kehanzuishuai/fpga/release/latest/README.md

# 当前完整发布：V21 / 2026-11-03

请使用 [release/v21_20261103](../v21_20261103/README.md) 的三端配套文件。

- [FPGA 烧录压缩包，解压后使用 FS](../v21_20261103/FPGA_expression.fs.zip)
- [ESP32-S3 合并固件，地址 0x0](../v21_20261103/ESP32_autoplay_0x0.bin)
- [特雷门琴 UNO 源码](../../firmware/theremin/Open_Theremin_FPGA/)
