kehanzuishuai/fpga/README_HANDOFF.md

# 当前工程入口：V21 / 2026-11-03

完整说明见 [README.md](README.md)。

- FPGA：[yinyue_fashengqi.gprj](yinyue_fashengqi.gprj)
- ESP32：[完整 Arduino 草图](firmware/remote_music_ble/esp32/ESP32_FPGA_Music_Controller/)
- 特雷门琴：[UNO 工程与校准说明](firmware/theremin/README.md)
- 烧录文件和验证报告：[release/v21_20261103/](release/v21_20261103/)
- 构建与烧录：[BUILD_AND_PROGRAM.md](docs/BUILD_AND_PROGRAM.md)

此前交接记录保存在 [历史副本](docs/README_HANDOFF_BEFORE_V21_20261103.md)。
