kehanzuishuai/fpga/docs/REMOTE_MUSIC_20261019.md

# ESP32手机音乐与五音色集成

当前工程：`D:\gaoyun\piano_v2_audio_fix\yinyue_fashengqi.gprj`。
原始提供资料保存在 `ref/lanya_20261019`，工作副本在 `firmware/remote_music`；未修改 E 盘原文件。

## 已实现的功能

- 实体32键固定使用原来的32 Voice钢琴，不叠加其他乐器。手机连接ESP32 Wi-Fi热点，可为MIDI/JSON曲谱选择钢琴、长笛、吉他、管风琴、钟琴，修改音量，导入曲谱或播放WAV。网页界面保持此前版本不变。
- WAV原始文件经手机HTTP分块上传、ESP32 SPI转发，在FPGA中解析RIFF、解码PCM并输出双声道；支持PCM格式码1、16/24位、单/双声道、44.1/48kHz。44.1kHz在FPGA中线性转换至48kHz。支持未知块和奇数字节填充；格式、边界、CRC或断流错误会反馈并静音。MP3、浮点WAV、WAVE_EXTENSIBLE不在此次支持范围。
- WAV按原速度播放，保留录音原声；手机五音色选择仅用于MIDI/JSON音符重合成，BPM只影响MIDI/JSON曲谱。更改手机音色不会使按住的实体键变音色、淡出或重新触发。
- MIDI保留原网页解析方式：格式0/1、PPQN计时，选择单旋律音轨及分段；不支持把复调和弦当作单旋律谱直接导入。JSON保留原音符事件兼容，单段最多32事件。MIDI/JSON解析位置仍为手机；FPGA负责事件计时和合成。此次新增的WAV文件解码在FPGA完成。
- 默认32个不同音高：第一块MIDI60～75，第二块76～91。屏幕继续保留原第一块16键对应。32 Voice、FFT、HDMI、PT8211与PCM5102均保留。
- 
- 音色协议ID为0钢琴、1管风琴、2长笛、3吉他、4钟琴。钢琴保留原音源；新增模型分别为加法管风琴、简化长笛、Karplus–Strong吉他及FM钟琴。每种音色支持32个逻辑Voice。曲谱启停会淡出并清理音源/效果后交接；停止或自然结束后恢复钢琴，再触发仍按住的实体键。曲谱播放中更改音色会停止当前曲谱，新选择用于下次播放。手机状态中的音色ID表示曲谱选择，实体键始终为钢琴。
- UART负责控制与原有曲谱事件，SPI负责WAV。CRC验证后才写入音频FIFO；序号及重复包缓存避免重传导致重复播放。FIFO反压与HTTP队列支持边传边播，无需把整首音乐存入FPGA。
- 曲谱开始需松开琴键且音源空闲；松键尾音尚未结束时请稍候。播放期间暂时由曲谱独占音符事件，停止后恢复实体键。WAV为独立立体声音源，可与琴键合成声混合；主音量同时作用于两者。多音/混音可能触发最终饱和保护，不代表恒定响度或无削波。

## 接线

使用Pro Dock排针编号，信号电平3.3V，两端共地。以下接口避开两块琴键及双DAC、HDMI现有占用。

| ESP32-S3 GPIO | 方向 | FPGA信号/管脚 | Dock位置 |
|---|---|---|---|
| 17 TX | ESP→FPGA | esp_uart_rx / B21 | J26第12脚 |
| 18 RX | FPGA→ESP | esp_uart_tx / A20 | J26第10脚 |
| 12 SCK | ESP→FPGA | esp_spi_sck / L17 | J24第7脚 |
| 11 MOSI | ESP→FPGA | esp_spi_mosi / E25 | J24第9脚 |
| 10 CS | ESP→FPGA | esp_spi_cs_n / H14 | J24第5脚 |
| 13 MISO | FPGA→ESP | esp_spi_miso / D25 | J24第10脚 |
| GND | 共地 | GND | J24/J26第3或4脚 |

原琴键接线保持：第一块SCL=C21/J26第11脚，SDO=B20/J26第9脚；第二块SCL=B19/J26第7脚，SDO=A17/J26第5脚。提供资料中原UART所用B19/A17已被第二块琴键占用，此次已避开。

Dock Bank4/5供电默认3.3V，来源为 `ref/hardware/Pro_Dock_4071f_official.pdf` 第16页PMOD引脚及第19页供电图。ESP32可由其USB供电，必须共地；不要将5V接入FPGA信号脚。SPI使用Mode0、4MHz，建议短线。

## 打开、编译与使用

1. Gowin Designer打开根目录 `yinyue_fashengqi.gprj`，新增RTL已列入有效FileList。顶层仍是`tang_mega_138k_pro_top`。
2. ESP32源文件为 `firmware/remote_music/esp32/ESP32_FPGA_Music_Controller/ESP32_FPGA_Music_Controller.ino`。本工程隔离安装的Arduino CLI与Espressif core在 `tools/toolchains/arduino`，使用官方core 3.3.10-cn。
3. `firmware/remote_music/esp32/compile.py`只编译，目标为通用`esp32:esp32:esp32s3`。本轮默认4MB分区构建，PSRAM选项未启用；手动烧录前按实际ESP32-S3板的Flash/PSRAM型号选择参数与串口。没有绑定原资料的COM9。
4. 手机连接热点`FPGA_MUSIC`，密码`fpga2026`，浏览器访问`http://192.168.4.1`。网页已嵌入固件，无需外部网页服务器。
5. “曲谱”页选择WAV后点击“传输并播放”，保持页面前台及Wi-Fi连接。完成状态来自FPGA已输出帧数，而非仅以HTTP上传完成判断。先用16位/48kHz文件做上板通路验收，再测试24位立体声和较长文件的持续传输。
6. 手机“键位”页可读取并原子提交32个唯一音高。物理触摸模块位序仍应按实际从左到右逐键确认；默认逻辑键顺序不等同于已经验证实体布局。

手动通路测试文件：`tests/remote_music_20261019/hardware_test/stereo_channel_check_16bit_48k.wav`。复制到手机后选择播放：第1秒仅左声道440Hz，第2秒仅右声道660Hz，第3秒两声道同时发声，第4秒静音；峰值约满量程20%。它是传输/接线测试音，不是五音色音质证明。

WAV本身不占用合成Voice，所以仅播放WAV时VOICE为0正常。音频Peak取左右声道较大的绝对值；FFT/李萨如的单声道音频源使用左右平均值，完全反相的立体声可能相消。

FPGA输出仍在 `impl/pnr/ao_0.fs`。最终可用版本必须以 `audit/remote_music_20261019/BUILD.json` 的PASS、当前源文件哈希和产物新鲜度为准；失败运行不会使旧FS自动变成新版本。

## 验证范围与资源处理

功能仿真包含真实SPI字节、CRC/序号重试、异常WAV/断流/停止、44.1kHz转换、实际固件C++发包重放、跨时钟立体声邮箱及双DAC数据核对。控制仿真覆盖真实UART、五种曲谱音色、全部手机选择下实体32键仅触发钢琴、曲谱最后NoteOff及交接、音量、效果、MIDI/JSON曲谱启停及重复键位拒绝。

WAV已逐样本覆盖16/24位、单/双声道、44.1/48kHz的全部八种组合，包括24位单声道的3字节帧整数校验及小文件结束处理。

ESP32上传端使用WebServer的定长RAW回调接收二进制，避免该core中`arg("plain")`按C字符串截断零字节。RAW路径不解析URL参数，因此会话/偏移使用`X-WAV-Session`与`X-WAV-Offset`请求头。对实际`WavService`代码的本机回归覆盖8KB含零字节/全部字节值的完整接收、队列反压重试、改变数据的重复请求、截断、取消、超长块和错误会话；HTTP回调及FreeRTOS队列边界在测试中模拟，真实射频/Wi-Fi仍需上板验证。

此前完成的32键整机回归覆盖12种场景、44个Note On/40个Note Off、最大32 Voice同时活动、9458个PCM5102帧、PT8211数据核对、4次FFT及12,338,132个HDMI像素。这些是此前完整运行的证据；本轮按用户要求停止重复整帧显示回归，不将中途停止的日志标记为新的整机通过。未改动显示部分按源码哈希复用此前结果，XY峰值流水改动单独核对10张位图和消隐预算。

新增四音色独立32 Voice回归已检查每个Voice的活动/释放和调度无超时。实际Gowin原语网表测试选取一个完整8路Voice共享运算通道，每种音色核对512帧，并逐周期比较控制、PCM和状态，覆盖DSP符号与吉他RAM行为；四通道组成的32 Voice整合由针对性RTL回归及主工程综合检查覆盖。最终通过状态以结果报告为准。已完成且依赖未变化的验证不再重复；SPI状态CRC流水改动仅补做相关传输验证。

为容纳吉他延迟RAM及WAV缓冲，GAO保留、采样深度由4096降为1024；没有删除FFT、HDMI、DAC或减少Voice。固定倍频改为精确移位加法，避免高云为常数倍频分配大量宽DSP后溢出到逻辑。

音符频率/吉他调谐/钟琴倍频参数显式在32个Voice之前计算一次，各Voice仅在Note On捕获。新增音色使用四个共享运算器，每个轮询8路独立Voice状态；32路相位、包络和吉他延迟RAM仍保留。每路最坏96个时钟完成一帧运算，低于256时钟采样周期，帧输出延迟不变。吉他样本在帧开始时锁存，保持原滤波/直流抑制的采样顺序。运算内部周期不再与原架构逐周期相同，已完成的帧级逐样本等价检查保留原始日志及哈希。

Icarus仿真会把共享总线上不重叠的切片改写为独立的等宽连线，避免超宽多驱动总线的解析开销；算术、寄存器、状态和时钟均不改动。`tests/remote_music_20261019/out/BANK_SIM_VIEW.json`记录原文件、仿真视图哈希及四处字面替换，最终归档前会重新逐项核对。GPRJ及Gowin使用原始生产RTL，门级测试使用真实Gowin综合原语。

新增音色的正弦ROM使用四分之一波表及精确符号/镜像还原，与原256个样本逐值相同，没有改变舍入或增加延迟。支持范围MIDI36～96的最大相位增量乘8仍低于Nyquist，因此移除该范围内永不触发的重复混叠判断；公共独立音色配置模块仍保留通用保护。Voice轮换选择采用静态优先扫描，保持原分配顺序。

32键映射在提交时扫描32个时钟并使用音高集合检查重复，替代496组并行比较；期间不接收下一请求，活动映射一次性更新。重复请求返回缓存结果；校验或演奏忙碌时保留原映射。

WAV块长度不再用单周期32位除法校验，改为32个50MHz周期的精确整数商/余数计算，期间对字节FIFO反压，音频采样运算不增加流水延迟。独立实际布局布线中，该修复将原Setup裕量−6.069ns改善为+4.038ns；这组数字仅属于独立解码模块，整机必须以最终报告为准。

SPI流模块亦做过独立50MHz布局布线检查，其状态CRC路径最差Setup为+4.230ns、Hold为+0.236ns，报告位于`tests/remote_music_20261019/resource/spi_timing/impl/pnr/probe.tr`。该探针自动分配IO，仅用于内部路径检查，不能作为整机镜像或板级SPI时序验收。

SDC保留原视频时钟、复位相位和0.150ns像素Hold要求；新增50MHz与音频时钟的异步分组，对应显式同步器和稳定数据请求/确认邮箱。像素与串行视频时钟仍按同步关系检查。最终综合资源、五类时序裕量、管脚比对与FS哈希见同目录最终验证结果文档及`audit/remote_music_20261019/FINAL_ACCEPTANCE.json`。

这些结果证明数字功能与工具实现的相应检查通过，不构成真实Wi-Fi连续性、实体接线和主观乐器音质验收。尚未连接设备做录音比较或实际烧录；新增模型也没有被宣称为高保真原声乐器。
