kehanzuishuai/fpga/scores/卡农_最新ESP32_20261103/使用说明.txt

《卡农》多音轨 ESP32 适配版（2026年11月3日）

直接导入的文件：卡农_多音轨_20261103.mid
适用固件：v21-autoplay-confirm-20261103，配套已有 V21 FPGA。

曲谱内容
7个有声部的音轨，另有1个速度/节拍信息轨。
包含低音、主副旋律、中音对位和分解和弦；保留全部3618个原始音符。
速度87 BPM，时长约5分14秒；音域MIDI 38～88。
最新页面合并后为4286个起音/松音事件，最多11个不同音高同时发声。
文件30,489字节，满足手机导入64KB及设备整曲事件数量限制。

手机操作
1. 连接ESP32，打开手机控制页面。
2. 选择“琴键”或“合奏”声源，选择“自动演奏”；建议先用“钢琴”音色。
3. 在“曲谱”页导入本文件夹的 .mid 文件。
4. 音轨选择“全部旋律音轨（不含打击乐）”，使用“整曲连续播放”。
5. 点击“传入设备”，看到“整曲已缓存，点击播放”后再点击“播放”。
6. 导入会设置87 BPM；可通过速度滑条调整。设备重启后需要重新导入并传入。

多音轨说明
这是用于传谱演奏的MIDI文件。ESP32缓存整曲，再持续向FPGA发送起音/松音事件。
各轨由FPGA用当前选择的同一种音色合成；当前系统不按MIDI通道分配不同乐器音色。
全曲播放请使用“自动演奏”；“指导模式”采用单旋律分段，不用于本版全曲复调演奏。
建议先将滑音、颤音归零，确认原曲后再调效果。

兼容性核验
最新手机页面：导入、全部音轨选择、整曲传输及播放/停止确认通过。
ESP32实际StreamScore.h：4286事件校验通过，2143次起音/2143次松音。
FPGA实际播放模块整曲仿真：FIFO供谱、回绕、下游等待通过，无断谱或遗留按音。
本次交付完成软件及RTL仿真检查，未进行实板试听。
无需因导入本曲重新修改或编译ESP32、FPGA工程。

来源
基于工程中已有的《卡农_多旋律_音域适配.mid》重新整理标准MIDI格式。
保留7个有声部的音轨、各音符时间和力度及统一速度；未使用预录音频。
原文件记录的下载地址：
https://www.pachelbelcanon.com/pachelbel-canon-files/category/1-pachelbel-canon.html?download=4%3Acanonstr.mid
