kehanzuishuai/fpga/ref/lanya_20261019/ziliao/RESEARCH.md

# 当前方案

ESP32热点提供离线控制页面，STA用于下载公开HTTPS MIDI/JSON直链。手机预览、选择单旋律音轨与32项分段后，再经16字节CRC串口事务提交FPGA。FPGA提供总音量平滑PCM缩放、BPM时基播放器、曲谱版本与实际状态读回；保持原音源和切换控制器。

软件闭环已经有自动回归，但主工程仍未合并，实物通信/声音/下载尚未验证。在线下载不是网站搜索引擎，不支持图片/PDF识谱、登录站点或多轨和弦整曲自动播放；音频仍由FPGA合成。
