kehanzuishuai/fpga/docs/DISPLAY_INTEGRATION_20261021.md

# 新屏幕与指导模式集成

> 本文件保留2026-10-21至10-22早间的集成和综合历史。10-22 13:28用户手动实现实际报420条未布通网络；最新存储实现修复、资源比较和下一次手动验证入口见 [ROUTING_REPAIR_20261022.md](ROUTING_REPAIR_20261022.md)。不能将本文早间候选网表作为后续修复版。

主工程仍为 `D:\gaoyun\piano_v2_audio_fix\yinyue_fashengqi.gprj`。来源为 `E:\xianshi(shengjiban)`。

## 当前状态

新版显示核心与512位真实状态接口已接入；指导模式经用户确认纳入本轮。生产RTL已通过实际高云原语接口展开、状态适配与CDC检查，真实UART指导专项通过。ESP32新后端已编译通过。

首次原样集成因逻辑215433超过138240而综合失败。经过无损存储和有界运算优化，已有一次完整综合通过（逻辑132986/138240，RAM325/340，收据 `audit/display_integration_20261021/SYN_OPTIMIZED_SUCCESS.json`），但其像素时钟综合预估仅6.312MHz，不能作为可用上板版本。

40级流水线第一次主工程综合资源通过（RAM331/340），整机像素预估36.998MHz；第二次完整综合 `SYN_PIPELINE_FINAL.json` 资源仍通过（RAM334/340），像素预估提高到51.706MHz，仍低于74.25MHz。这两次网表及报告分别保存在 `timing_repair/first_pipeline_synthesis/` 和 `second_pipeline_synthesis/`。独立渲染器79.108MHz未覆盖完整路径，不能用它宣告整机达标。

2026-10-22继续修复：限制TMDS字节表为组合逻辑，避免额外推断3块BSRAM；保留最终RGB寄存器。加入实际PLL、DCS和OSER10的显示核心预估72.271MHz，报告将瓶颈定位到文字抗锯齿混色。随后把加权和提前到现有底图寄存器，将精确除3留在输出拍；未增加像素延迟，0～766全部整数商及2048组完整RGB/DE/HS/VS对照通过。对应物理显示核心综合完成，像素预估提高到**80.988MHz**，收据为 `tests/display_integration_20261021/out/DISPLAY_CORE_TIMING_ESTIMATE.json`，其中记录报告、网表、快照源码及素材的哈希。上一轮 `SYN_RGB_BOUNDARY.json` 在推断阶段中断，未产生新网表，已明确标记。

**本轮主工程综合已于2026-10-22 08:21完成，耗时约15分23秒；资源通过，但整机像素预估55.340MHz，仍未达74.25MHz目标。** 构建收据为 `audit/display_integration_20261021/SYN_TEXT_SUM_FINAL.json`，当前状态 `CURRENT.json` 为 `SYNTHESIS_PASSED_TIMING_REPAIR_REQUIRED`。源码、ESP32编译产物及当前综合网表的哈希均已核对。没有源文件漂移或综合错误。完整网表、资源/时序预估报告、构建收据和本轮生成器另存 `timing_repair/text_sum_final_synthesis/`。

| 本轮整机项目 | 结果 |
| --- | --- |
| 逻辑 | 113711/138240（83%） |
| 寄存器 | 62585/139140（45%） |
| BSRAM | 331/340（98%），比第二版少3块 |
| 50MHz主时钟综合预估 | 52.257MHz |
| 74.25MHz像素时钟综合预估 | **55.340MHz，低于目标** |
| 12.288MHz音频时钟综合预估 | 23.789MHz |
| 27MHz视频参考综合预估 | 207.307MHz |
| 当前布局布线、最终STA、新FS | 未执行、未签核、未生成 |

显示核心80.988MHz不能覆盖整机结果。整机综合报告只列5条最差路径，本轮均为50MHz到音频域的跨域路径；综合没有应用实现阶段的完整SDC时钟关系，因此这些路径不能直接当作最终STA违例。继续判断整机像素路径需使用本轮网表的实现/STA报告，再针对实际端点修复；不通过放宽时钟约束宣告通过。按此前用户选择，自动布局布线尚未启动。

`audit/display_integration_20261021/CURRENT.json` 是最近一次完成的候选记录，须检查其构建收据与源码哈希；不能把历史记录的状态套用到正在构建的版本。`out/DISPLAY_CORE_TIMING_ESTIMATE.json` 只记录显示核心的综合估算，整机结果单独核对。综合预估不等于布线后STA：原已验证基线的像素预估也曾只有67.843MHz，最终布线后满足时序；本轮仍须新报告才能确认。

**现有 `release/latest` 与原FS属于2026-10-20基线，不能当作本次显示升级的产物。没有烧录。** 本次最终产物和检查结论完成后在本文更新。

两份集成前FS分别记录，不能混用哈希：已验证归档 `release/latest/ao_0.fs` 为 `e483552f…`；本轮开始时的工作文件 `impl/pnr/ao_0.fs` 为 `8fa45e67…`，与 `BEFORE.json` 及备份逐字节相同。本轮只综合，未改写任何FS。

按此前用户选择，未启动自动布线。原配置 `Convert_SDP32_36_to_SDP16_18=true` 会拆分宽RAM，原基线综合261块、布线后296块。新版增加背景与字库后需保留宽RAM以控制存储预算；准备的手动实现脚本 `tools/build_display_integration_pnr_manual.tcl` 显式关闭此转换，保留其余时序驱动配置。该选项不改变RTL行为或功能，但最终时序必须使用新网表重新检查。

## 后续手动实现入口

仍打开本目录 `yinyue_fashengqi.gprj`，不是另建工程。本轮最新构建收据为 `SYN_TEXT_SUM_FINAL.json`。综合成功且源码/网表哈希一致后，可从 `impl/gwsynthesis/yinyue_fashengqi.vg` 接手手动布局布线。`CURRENT.json` 同时检查主要时钟的综合预估；若标记 `SYNTHESIS_PASSED_TIMING_REPAIR_REQUIRED`，表示预估存在不足，只能进入实现诊断，不能按时序完成版本验收。标记 `SYNTHESIS_PASSED_PNR_PENDING` 也仅表示待实现，不代表STA已经通过。

用户手动进行布局布线时，可在Gowin中使用当前综合网表，保持宽RAM转换关闭、时序驱动与Hold修复开启；也可自行执行 `tools/build_display_integration_pnr_manual.tcl`，脚本只进行实现，不烧录。最终须检查新生成的实现/时序报告和引脚报告，再决定是否生成、下载配置。旧 `impl/pnr/ao_0.fs`、旧时序报告及 `release/latest` 在手动实现完成前一律仍按旧基线理解。

## 保持不变

- 手机HTML、CSS及其余网页资源保持不变；仅在 `APP_JS` 启用已有隐藏指导容器，沿用原 `segments` 按钮样式。该功能已由用户明确同意；只在FPGA能力查询成功后显示，旧FPGA不显示无效入口。ESP32后端与共用通信库同步接通。
- 队友显示包的场景、字体、颜色、布局、背景素材保持不变；本轮不重新设计画面。
- 保留当前PLL、视频时钟/复位修复、HDMI端口/CST/SDC、32钢琴Voice、FFT、双DAC。
- 物理32键固定钢琴；手机五种音色仍仅用于自动曲谱。

## 显示接口

`visual_audio_core`复用主工程音频与像素时钟，输出TMDS码给原物理输出。PCM来自最终DAC捕获边界。默认X/Y使用PCM的Hilbert解析相图，不声明为真实左右声道相图。

`display_status_adapter`在12.288MHz音频域组装512位快照，通过ready/update整包握手交给显示CDC，在视频帧边界发布。输入包括真实32键、已应用映射、真实活跃声部及音符、最终L/R电平和曲谱状态。显示握手不参与音频运行。

当前钢琴为多个分音各自衰减的模型，原`env_level`输出固定0，没有单一可直接使用的ADSR包络。包络有效位清0，显示中性；未用混音幅值冒充声部包络。其余音色包络本轮也未单独导出。没有删除队友包络显示模块。

## 指导模式

手机曲谱页原有隐藏容器在能力确认后显示自由/自动/指导三选入口，样式直接复用原CSS，不重新设计页面。后端新增UART能力查询0x06和设置0x16，仍由DeviceJob异步工作任务处理，ACK后查询真实模式，旧FPGA不支持时返回501，不假报成功。页面周期查询真实方式，自动播放切换、刷新页面和设置失败后均可恢复真实状态。

- 模式0自由：实体键正常钢琴。沿用原“播放”按钮兼容行为，点击播放会进入自动模式1。
- 模式1自动：原播放器、五音色及停止/返回钢琴流程保留。
- 模式2指导：先传曲谱、选择指导、按播放。FPGA启动前逐项检查所有非休止音符都能映射到当前32键；不满足时拒绝启动。只提示目标，不自动演奏目标音，实体按键仍发钢琴。
- 错键、多按不推进；按齐目标后计数一次，全部松开再取下一项；重复音需重按。休止随当前BPM计时，中途按键会重新计时。
- 自然完成后显示完成，可重新播放或停止；停止清除目标。指导进行中禁止提交键位或曲谱替换。
- 切换三种方式须先停止当前曲谱/指导并松键，在安全边界应用；忙时拒绝，原方式保持。

当前曲谱输入仍为单旋律、每段最多32事件；未新增复调MIDI解析、自动连续长曲、节奏评分或实体LED控制。指导模块能力不等于手机格式已经支持和弦。

## 备份与证据

`audit/display_integration_20261021/backup`保留修改前源码、GPRJ、综合网表、FS和实现报告；`BEFORE.json`与`IMPORT.json`记录哈希和来源。队友包原件不修改。

资源优化前显示原件另存 `audit/display_integration_20261021/optimization`。缩小有范围证明的文字坐标、数值显示和颜色运算；圆角使用精确整数圆边界查表，保留DSP给音频与FFT；背景无损打包到48个原生DPX9B；原始233个字形的106996个覆盖像素存入ROM。字体字模、色值、布局和功能保持原样。优化后的RTL以数值/像素等价检查代替逐字节一致证明。

时序修复资料位于 `audit/display_integration_20261021/timing_repair/`。场景最终采用40级流水线，并共享当前像素覆盖的琴键着色；文字采用21级流水线，二进制转十进制逐位精确转换。文字从原始像素进入，场景、叠加层和RGB/DE/HS/VS统一对齐。相对队友原始渲染器增加41个像素时钟延迟，约0.552us；每拍仍输出一个像素，没有降低分辨率或抽样率。光照缓动为原整数函数的精确ROM，在垂直消隐内提前稳定。

后续还拆分了波形插值、FFT显示地址/柱高/渐变及XY幅度统计的运算。背景最终改为6级精确采样，增加的4级由场景颜色首次使用前的空档吸收（生产实例 `BACKGROUND_LATENCY=4`），包含压缩ROM线性地址及精确除3的寄存器。面板圆角先算距离再查边界；声部指示、装饰和电平表先算互不重叠的覆盖掩码，再选择原有颜色，避免32层优先级链。网格在原有可见范围内改成相同坐标的比较。除7/55/108/586/587的有限输入域均逐值证明整数商一致，再使用精确倒数乘法，并未近似颜色或波形。

TMDS保留集成前6位有符号差分累积算法，字节变换用精确256项组合查表，符号输出节拍不变；已对照导入的32位整数版本检查全部9种可达累积状态×256数据及65536个连续数据/控制字，67840组符号和累积值完全一致。参考组合块用 `always_comb` 保证初始零字节也求值，编码公式未改。FFT柱高编码改为并行最高有效位项的OR树，并在原生RAM解码与峰值池化间加寄存器；最后一条延迟柱在SCAN原本未primed的首拍处理，发布/释放握手节拍不变。

独立综合预估：修复后的背景含寄存器驱动输入82.073MHz（`resource/background_address_candidate`）、XY引擎107.657MHz。旧的单独渲染器79.108MHz仅为中间参考；最终以包含光栅、真实原生帧缓存与FFT的显示核心及新一轮主工程结果核对。背景16000次采样和整条渲染器2048次RGB/同步对照通过，采用实际高云DPX9B模型。FFT显示扫描对照原始控制逻辑检查12帧、6144条柱数据，覆盖最后频点最大值、显著阈值±1、静音/DC、全部37种最高有效位及随机低位、37位大幅值和四帧缩小量程，确认准备寄存器和并行最高有效位编码保持统计一致。

验证已覆盖：真实UART指导流程；全部65536个16位显示数值的5位十进制；MIDI36～96文字；393216个XY坐标/增益组合及10000个随机移位；8个背景库的所有原始像素与跨块读取；16000个双线性背景采样。时序修改后的专项包括：65536种BCD输入、90个文字区域共2912次动态字符/像素比较、9570个缓动相位及整条渲染链RGB/同步信号对齐。最终有效源码哈希以同目录`out/*EQUIVALENCE.json`与构建收据一致为准，不把中间版本的通过结果挪给后续改动。

参考文字RTL的仿真过程只将字符选择块的`always @*`改为`always_comb`，以包含函数隐式读取的状态信号；这避免参考模型在键位映射有效位改变时漏更新，组合硬件表达式和原始字模均未改变。

手机入口经真实 `APP_JS` 的DOM专项检查：能力确认才显示、202需等待最终查询、失败不假报应用、旧设备/离线处理通过。新ESP32-S3固件编译通过：程序1223689字节（93%），静态RAM54956字节（16%）；仅编译未烧录。当前固件及编译源哈希在 `tests/display_integration_20261021/esp32/`。

专项入口：`tests/display_integration_20261021/check.py`、`guidance.py`；输出在同目录`out/`。本轮不重复运行无关的完整音频/HDMI回归。

用户后续要求优先加快键盘读取，暂不处理屏幕显示延迟。双模块读取参数及实际主工程至双DAC的专项结果见 [KEYBOARD_LATENCY_20261021.md](KEYBOARD_LATENCY_20261021.md)：本次单键数字链路低于5ms，32键同时起音的共享参数装载仍有约10.97ms的末声部延迟，不能宣布整机或全部32音都满足5ms。屏幕逻辑时序收敛属于可运行性检查，与屏幕帧刷新延迟分别记录。
