kehanzuishuai/fpga/docs/E_DRIVE_UPGRADE_REVIEW_20261021.md

# E盘资料与本地主工程升级检查（2026-10-21）

当前主工程仍为 `D:\gaoyun\piano_v2_audio_fix\yinyue_fashengqi.gprj`。

## 检查范围与证据

本次枚举E盘2113个可见文件路径，清单在 `audit/e_drive_inventory_20261021.txt`。系统回收站、系统卷信息和Office锁文件不属于工程资料；没有逐字阅读全部文件或重新运行各包测试。重点阅读所有工程包的入口/集成文档、已有验证报告、关键接口RTL，并对相关生产源码按文件名匹配和SHA256比较。PDF、图片、历史仿真二进制本轮只盘点，不声称已完成逐页审阅。E盘原件不修改。

## 目录结论

| 来源 | 与当前工程的关系 | 升级建议 |
|---|---|---|
| `E:\xianshi(shengjiban)`，305文件 | 新版1080p30显示，32键、512位遥测、动态频谱范围、可选指导判定 | 最高优先级；适配后替换显示逻辑 |
| `E:\lanya`，369文件 | 现有手机通信的来源包；UART、曲谱、键位控制已在本地集成；此包没有本地新增的SPI WAV路径 | 借鉴尚未接通的曲谱演奏方式接口，禁止整包回覆盖 |
| `E:\yinse`，818文件 | 五音色原始独立包，生产同名源码7份字节相同、10份不同，未发现缺失的同名生产模块 | 保留本地共享计算与集成改造，复用其算法说明和试听测试方法 |
| `E:\teleimenqin`，231文件 | 尚未接入主工程的独立特雷门子系统；本地src/firmware中未找到其23份生产代码的同名文件 | 后续独立扩展，不与当前屏幕升级同时强行合入 |
| `E:\特雷门资料`，27文件 | 原始Arduino固件、原理图、BOM、接线图片 | 特雷门硬件与原件对照资料，不能当已集成代码 |
| `E:\xiugai`，61文件 | 旧640×480显示迁移包；同名生产文件3同、9异 | 历史参考；不替换新版显示或本地时序修复 |
| `E:\xianshi`，10文件 | 历史vvp/FFT数据/报告，没有完整生产RTL | 不合入GPRJ |
| `E:\yinyuedianziqin`，280文件 | 旧钢琴基线和备份；其piano_v2/src同名生产文件36同、9异 | 作为音频差异对照，不覆盖当前32键/通信/衰减修复 |
| E盘根文档与scripts | 早期可视化记录；scripts未发现普通文件 | 按历史记录使用；旧“当前主工程”路径不作为本次入口 |

上述同名比较仅帮助定位差异，不表示不同者一定更新，也不表示功能等价。目录文件数量包含测试、输出和资料。

## 第一优先：新版屏幕与真实遥测

采用 `visual_audio_core` 适配现有板级视频封装，或按需要改造 `visual_display_status_top`；不要使用独立demo顶层替换整机顶层。现有主工程显示状态为58位，新包为512位并带ready/update整包握手，需增加真实遥测适配器。

接入内容：32键真实触摸、已提交224位音高映射、当前实际音色、有效音符、32位活跃声部、选定声部真实包络历史、最终左右声道相对电平、播放器模式/目标/进度。当前已有部分音源内部观测量，但尚未完整导出到新版状态接口。未取得的数据清除对应valid，不用按键数量冒充声部数量，也不用PCM幅值冒充ADSR。

保留当前视频PLL/时钟路由、serial_reset_clk及复位同步修复；新包对应封装接口较早，直接覆盖会丢失这些修复。PCM继续从实际DAC捕获边界观察；状态握手不能反压声音。

必须携带8份背景HEX并核对初始化路径。背景原始存储803712bit，约98.1KiB；当前已验证整机BSRAM296/340，仅余44块。原始位数不能直接当作Gowin映射块数，需把旧显示被替换释放的资源也计入后综合评估。资源不足时优先评估背景量化/尺寸及缓存布局，不削减32钢琴Voice、FFT或双DAC。

显示交付清单100项中98项哈希一致，`README.md`、`INTEGRATION.md`与MANIFEST不符；本次未定位修改者或原因，不能据此认定RTL损坏。应在本地导入时建立实际文件哈希，不能把原清单当作全部一致。

## 第二优先：曲谱自由/自动/指导方式

手机现有 `/api/performance` 为501占位，显示包提供 `visual_guide_controller`。两边缺少的是中间的整机连接：

1. 为方式设置、实际查询增加UART协议和能力检测；来源文档建议0x16/0x06，最终需核对现有指令后确定，不视为已实现。
2. 延用ESP32现有DeviceJob队列/异步任务与实际回读，保持网页布局、资源原样。
3. 模式切换停止旧播放器并处理NoteOff、待办和安全提交，避免悬挂音。
4. 从当前曲谱RAM提供指导事件，将MIDI按已应用映射转换为32位物理目标；找不到映射要明确拒绝或暂停。
5. 指导时真实琴键仍为钢琴，按对并全部松开才推进；当前指导模块不考核长音时值，不是严格节奏评分器。
6. 自动播放目标来自真实播放器状态，不能拿实体触摸或屏幕动画冒充播放状态。

现有曲谱仍是单旋律、每段32事件、手动分段。显示判定器支持和弦不代表当前手机解析器和FPGA曲谱存储已经支持复调；复调和自动连续长曲属于额外功能。

特别注意有两种不同的三态枚举：手机旧mode是琴键/特雷门/合奏，performance是自由/自动/指导。不得复用同一字段或混淆屏幕编码。当前主工程只接受琴键来源模式，特雷门尚未接入。

## 第三优先：特雷门独立扩展

现有包包含UNO固件、115200UART/CRC、失联保护、频率音量平滑、连续DDS、同帧混音和清理握手。报告只证明独立仿真和UNO编译；未做当前整机Gowin映射或硬件验证。

接入前必须确定实际UNO/天线板与电平转换、空闲FPGA管脚、真实clear请求/应答、最终PCM帧标签和DAC捕获预算。源码默认32clk帧截止不能未经测量套到当前音源。合奏时特雷门失联只能静音特雷门支路，不能清空32键钢琴。实体琴键固定钢琴的用户要求优先于旧包允许琴键切五音色的设计。

原始OpenTheremin代码含GPL版权声明；若以后复制发布应保留随附声明与对应许可证资料。

## 不建议回退覆盖的部分

- lanya旧UART分配B19/A17与当前第二块键盘冲突；当前使用B21/A20。
- lanya旧默认映射60..75与72..87重叠；本地32个不同音高默认60..91，不能回退。
- yinse原始辅助组不能覆盖本地32上下文/共享算术引擎的资源优化。
- yinyuedianziqin旧top、Loader、Voice、Event Bridge不能覆盖本地衰减、映射和通信修改。
- xiugai旧640×480的PLL/renderer不能与新版1080p30素材和扫描参数混用。
- ESP32 UI保持现状，本次未修改；E盘网页与本地web_page.h有差异，其中本地含WAV功能，不直接同步整个头文件。

## 实施顺序与本次变更

建议顺序：保存当前可回退版本 → 新显示+真实遥测 → 手机performance后端+指导事件 → 必要专项检查/综合资源 → 布局布线和时序 → 真实32键/手机/屏幕/双DAC联调。特雷门独立安排下一阶段。

本次仅新增本检查报告和E盘路径清单。没有修改生产RTL、GPRJ、ESP32 UI或E盘文件，没有重新综合/仿真、烧录或推送。
