kehanzuishuai/fpga/docs/KEYBOARD_LATENCY_20261021.md

# 32键读取加速与5ms延迟检查（2026-10-21）

用户决定本轮不处理屏幕显示延迟，优先缩短键盘读取等待。没有修改页面UI、删除确认/异常保护、启动布线或烧录。

## 实际改动

主工程已引用的 `src/keyboard/ttp229_keyboard_pair.sv` 默认参数由123/36864/246改为25/25805/123（HALF_TICKS/GAP_TICKS/IDLE_TICKS）。音频时钟12.288MHz不变，两块模块并行读取。

| 项目 | 原参数 | 新参数 |
| --- | --- | --- |
| SCL频率 | 49.95kHz | 245.76kHz |
| 帧间等待 | 3.000ms | 2.100ms |
| 帧前空闲检测 | 20.02us | 10.01us |
| 16bit读取时间 | 320.31us | 65.10us |
| 正常单帧周期 | 约3.340ms | 约2.175ms |

仍启用连续两帧逐bit一致确认、严格空闲检测、独立坏帧拒绝、32键映射检查。兼容用途的单独 `ttp229_reader.v` 默认值保持原样；生产顶层使用上述双模块封装的新参数。无需增加GPRJ文件条目。

依据本地原厂手册 `ref/ttp229/TTP229-BSF_spec_v1.1.txt` 第8页：F_SCL为1～512kHz，Tw最小10us，Tout典型2ms。2.10ms比典型超时多100us余量；手册未给Tout最大值，因此最终仍需两块实物模块检查，不能把数字模型当作器件容差认证。

## 必要专项仿真

`tests/display_integration_20261021/keyboard_latency.py` 连接真实主工程顶层，关闭显示运算，仅替代PLL为同频功能模型、ROM为相同内容数组、触摸模块为串行模型。保留实际键盘读取、手机控制仲裁、FIFO、32路钢琴、FX、主音量及双DAC发送器，从输出引脚独立解码非零完整字/帧。

起点为触摸模块已经形成新的数字键状态；包含93us DV模型和两帧确认，不包含触摸电容检测、真实PLL启动、DAC模拟滤波、功放/扬声器。测试等待音频复位完成，测量正常运行的按键响应。非零样本只用于起音延迟检查，不代表可闻响度、音色质量或整机听感验收。

| 输入/相位 | 接受键状态 | 首个最终PCM | PT8211完整非零字 | PCM5102完整非零帧 | 最后目标声部首次非零 |
| --- | --- | --- | --- | --- | --- |
| K1，空闲期变化 | 4.340ms | 4.660ms | 4.691ms | 4.681ms | 4.629ms |
| K32，刚错过帧锁存 | 4.414ms | 4.726ms | 4.736ms | 4.747ms | 4.695ms |
| K1+K32，刚错过帧锁存 | 4.414ms | 4.726ms | 4.757ms | 4.747ms | 4.903ms |
| 全32键，刚错过帧锁存 | 4.414ms | 4.726ms | 4.757ms | 4.747ms | **10.965ms** |

两种单键案例均通过双DAC数字输出5ms断言。两键及32键的“首个音”也低于5ms，但不等于全部声部都在5ms内起音。最后声部一列取实际声部样本端口，位于混音/FX/DAC之前，不能称为最后声部已从DAC发出。

32键同时起音瓶颈为共享 `piano_note_loader` 逐音装载（单音约0.2ms，32音累计约6.4ms），而非32 Voice数不足。未减少Voice、删去分音或关闭FX来制造低延迟。若要求所有32音同时在5ms内输出，仍需独立优化装载架构及验证其资源/时序，目前**未达成**。

另运行已有双模块串行专项（`tests/keyboard32_20261019/run.py serial`），更新SCL脉宽断言为实际新参数。所有物理bit、独立原始位排列、重复MIDI拒绝及一块SDO故障不阻塞另一块等检查通过；没有重复44音音质或完整视频回归。

结果：`tests/display_integration_20261021/out/KEYBOARD_LATENCY.json`、`keyboard_latency.log`，双模块串行结果在 `tests/keyboard32_20261019/SERIAL.json`。结果收据记录测试源哈希，后续改动不能自动继承本轮通过结论。

## 5ms结论及上板边界

原厂第8页还标注16键模式T_resp典型32ms，第5/10页列出休眠扫描和唤醒延迟。因此本轮优化的是“模块数字状态形成后→FPGA→DAC数字引脚”；不能承诺“手指触碰→可闻声音”小于5ms。用户已决定暂不处理屏幕刷新延迟，本轮没有为达到5ms而改变显示刷新策略。

当前没有本次升级已通过的布线后时序报告或新FS。10-22手动实现报420条网络未布通，后续显示存储修复见 [ROUTING_REPAIR_20261022.md](ROUTING_REPAIR_20261022.md)。`impl/pnr/ao_0.fs` 仍为2026-10-20基线，尚不包含本轮键盘加速及新显示；不得用旧时序报告认定本轮通过。实际模块高速串行兼容性、Tout余量及模拟声学延迟留待手动实现后上板测量。
