kehanzuishuai/fpga/docs/HIGH_NOTE_DECAY_ANALYSIS.md

# HIGH_NOTE_DECAY_ANALYSIS

工程：`D:\gaoyun\piano_v2_audio_fix`

入口：`D:\gaoyun\piano_v2_audio_fix\yinyue_fashengqi.gprj`

更新时间：2026-10-17T21:32:51.567579+08:00。数字验证：**PASS**；真实上板：**PENDING**。禁止自动烧录。

结论：MIDI60～75全部产生非零PCM；72～75在相同两秒按住期间没有提前归零。没有证实高音因位宽不足而整段静音，本轮不修改AMY参数、包络、增益或FX。

证据分层：本轮向真实32Voice synth_top直接注入每个MIDI，velocity100，每次复位清空其他Voice，512个held采样+512个release采样，观察FIFO/分配/Loader/active/非零PCM/松键；这是起音和事件链测试，不是完整长衰减测试。三秒音频为此前真实RTL流（相同velocity100、NoteOff=96000、144000个24位48k采样）；本轮重新核对算法及ROM哈希，逐音重新比较当前定点模型，并从RTL日志重建PCM数组、核对144000个FX样本。完整的长时间回归另行本轮重跑。长按自然归零扩展使用这些逐样本验证过的定点模型，明确不是板上测量。

| MIDI | 测得f0 Hz | 起音Peak整数（0～100ms） | 起音RMS dBFS | 按住最后100ms RMS | 干声归零ms（松键2000ms） |
|---|---|---|---|---|---|
| 72 | 524.161335 | 2326575 | -16.633 | 49040.502 | 2093.958 |
| 73 | 555.650969 | 2208628 | -16.884 | 50098.999 | 2093.625 |
| 74 | 589.032263 | 2075827 | -17.132 | 51164.725 | 2093.146 |
| 75 | 624.418706 | 2046729 | -17.329 | 52242.121 | 2092.646 |

FX前后32份WAV、精确首次非零样本和值、2秒松键后最终零点、基频、起音/持续/释放RMS、泛音相对功率均位于 `D:\gaoyun\piano_v2_audio_fix\tests\scale_decay_20261017\notes`、NOTE_METRICS.csv、HARMONIC_PEAKS.json、DECAY_CURVES.csv。自然长按模型的72/73/74/75零点分别11.510042、11.048229、10.717146、10.315896秒（自加载完成起）；60为9.255833秒、64为7.875896秒。支持正常频谱/包络差异，不支持高音一开始即归零。图：`D:\gaoyun\piano_v2_audio_fix\tests\scale_decay_20261017\decay_and_pitch.png`。

ROM检查：每4半音一组，vel40/80/120三层；Loader对相邻音高和力度进行两级有符号插值，缺失Partial保留FFF标记。16个键全部有15个非零有调性Partial，另有hammer槽。段长度192×2^n样本对所有音高相同；音高改变的是各槽21个电平断点和释放斜率。实际数据在LOADED_PARAMETERS.csv，覆盖60～64、64～68、68～72、72～75。MIDI64在0.1～0.5秒干声RMS约-36.373dBFS，68约-23.189dBFS，相差13.184dB；这一差异已存在于源AMY数据，不是插值突然越界，也没有证据应强行拉平。若实体位序等于raw序，旧表第四→第五键72→61可导致明显跳音；真实物理关系尚未确认，不能据此确定实物第五键的全部音色问题。

定点路径（AMY采用对数电平曲线，并没有独立普通ADSR幅度乘法）：

| 级 | 真实格式和运算 |
|---|---|
| ROM/插值 | level无符号12位Q4.8；音高差13位signed，乘积17位，算术右移2；力度差15位，乘积25位，算术右移8；末端限幅0～4094，FFF表示缺失 |
| 包络状态 | level无符号26位Q4.22，slope signed22位，更新signed28位饱和；边界差signed27×K3 signed18→signed45，算术右移24+n |
| 指数到幅度 | exp unsigned18位，拼6零得24位后按整数level右移；减1049在signed25位完成；结果≤1153门控为0，其他保留24位 |
| Partial乘法 | 幅度零扩展到signed27位×波形signed18位（Q17）→signed45位；16槽符号扩展累加到signed48位 |
| Voice | signed48累加算术右移18，随后饱和到signed24位 |
| Mixer/Gain | 32×signed24→signed29；正Q15增益32767扩展signed17，signed46乘积算术右移15；当前不按Voice数自动衰减 |
| FX | 输入signed29保留4小数位转signed32；各反馈乘法signed64并向零截断，状态饱和signed32；Limiter扩展signed36，增益×2、曲线、去4小数位，输出signed24 |
| DAC | PCM5102传signed24；PT8211取[23:8]，低8位量化与声音总线静音分开统计 |

真实RTL 32738条Partial记录逐条验证指数/门控/符号乘积，零不匹配；逐音Voice=Mixer，Gain公式精确，FX在实际DAC捕获相位具有明确1采样延迟，所有样本与模型相等。证据DIRECT_CHAIN_AUDIT.json、PARTIAL_FIXED_TRACE.csv、DIRECT_STAGES.csv、direct_midi.vcd。初始level=54525952，exp=262143，raw=2047，减1049得998，小于门限，因此起音最初为零是设计。MIDI64 tick55槽10 raw2203→1154，乘波形22175得25589950，证明门限刚上方未丢失；MIDI75 tick430槽8同样1154×90667=104629718。

量化确实存在：模型中MIDI75累加35887经过>>18得0；-237042经过算术>>18为-1，符号正确。这是个别零交叉/低幅采样，不等于整段静音。QUANTIZATION_COUNTS/EXAMPLES记录小于1LSB的乘积、正数归零、负数floor、最大乘积与累加；全部幅度/累加在位宽内，Voice无rail样本，最终自然门控关闭，未出现持续底噪。MIDI64某RTL样本Voice=-673265→Gain乘积-22060874255→>>15=-673245；相应样本索引FX=-1544793，见STAGE_EXAMPLES（FX按离线已验证流的样本索引对齐，实时延迟另列）。

新直接注入的首次DAC PCM时间也从VCD恢复的真实FIFO握手计算：MIDI72～75均为接受后3958个音频时钟，约0.322103ms，首次值依次309、326、343、362；详见ONSET_EVENT_TIMING.csv。不要与旧三秒流自仿真起始的第17采样混用时间原点。

特别区分显式门限与位宽丢失：amp_raw=2202时，减1049得到1153，按源代码门限直接置0；amp_raw=2203得到1154则保留。因此最终干声可能从数百PCM LSB变成0，例如MIDI64末尾574→0；这是原有AMY门控结束Voice，不能归咎于最终>>18只剩不足1LSB。NOTE_METRICS中的first_nonzero_ms是精确非零采样时间；旧特征字段onset_ms是10ms包络阈值所在窗口，不能混用。

全部24～104范围的1215个有调性频率在28位切片前检查，最高17694.0097Hz，小于24kHz；不把最大FFT峰当基音，基频估计同时使用Partial1频率、谐波支持与自相关。源表测量/插值造成的微小调音偏差和响度起伏保留；模拟输出及主观音色仍待板上试听。
