kehanzuishuai/fpga/docs/KEYBOARD32_20261019.md

# 双16键键盘扩展（2026-10-19）

工程入口：`D:\gaoyun\piano_v2_audio_fix\yinyue_fashengqi.gprj`。

本轮将同一个主工程扩展为两块TTP229式16键模块，共32个不同的MIDI音高。综合、仿真和时序最终结果在本页末尾与 `audit/keyboard32_20261019/FINAL_ACCEPTANCE.json` 中记录；未记录最终PASS前，不以历史FS或旧时序报告作为本轮通过证明。不自动烧录。

## 音域及显示

默认保留原模块音高：模块1逻辑键0～15 → MIDI60～75（C4～D♯5），模块2逻辑键0～15 → MIDI76～91（E5～G6）。全局键号0～31，不截断成四位，不重复音高。

`KEY_BASE_NOTE`、`KEY_NOTE_TABLE` 继续配置原模块；新增 `KEY2_BASE_NOTE` 默认等于 `KEY_BASE_NOTE+16`，也可单独用 `KEY2_NOTE_TABLE` 配置。两模块的原始位序可分别用 `KEY_RAW_*`、`KEY2_RAW_*` 调整。跨两块模块的重复MIDI表被拒绝。实体从左到右的位序必须用实际模块确认，不根据模块外观猜测排列。

此前音源测量相对推荐48～79，本次按“原来基础上增加”保留60～75；这不改变此前对80～91响度与音质的保留意见。若以后选择48～79，只需将 `KEY_BASE_NOTE` 设为48，再重新仿真/实现；当前构建具体默认值以最终验收记录为准。本轮是实体输入及复音功能验证，不宣称完成32个优质音色的听评。

按此前要求，屏幕的16个琴键位置及音名仍对应第一块模块，未把两个模块折叠到同一组灯位。Voice计数、波形、FFT和李萨如来自实际总音频，包含第二块模块。

## 新模块接线

基于项目内 `ref/hardware/Pro_Dock_4071f_official.pdf`，Pro Dock4071f rev1.2第16页。请按J26实际丝印/针脚编号接线，不按连接器观看方向猜左右。

| 模块 | 模块信号 | FPGA球位 | Dock接口 | 工程信号 |
|---|---|---|---|---|
| 原模块 | SCL | C21 / Bank5 | J26第11脚，PMOD2_IO0 | ttp229_scl |
| 原模块 | SDO | B20 / Bank5 | J26第9脚，PMOD2_IO1 | ttp229_sdo |
| 新模块 | SCL | B19 / Bank5 | J26第7脚，PMOD2_IO2 | ttp229_2_scl |
| 新模块 | SDO | A17 / Bank5 | J26第5脚，PMOD2_IO3 | ttp229_2_sdo |
| 两模块 | VCC | — | J26第1或2脚，3.3V | — |
| 两模块 | GND | — | J26第3或4脚 | — |

两模块共地，各自使用独立SCL/SDO；不连接两个SDO输出。新增SDO启用上拉，未插模块且输入保持高电平时报告全松开。原16键、DAC、HDMI、时钟与复位的外部引脚位置不变。

两模块均需硬件设置为16键、多键同时触发、低有效串行模式；具体跳线以模块型号说明为准。默认两个PROFILE均为1，关闭旧的8键镜像猜测屏蔽，避免第一次按住FFFF和弦时丢弃上8键。保留PROFILE0作为诊断选择；它不能证明实际模块具有16键多键能力。

## 实现及验证边界

- `src/keyboard/ttp229_keyboard_pair.sv`：两个独立Reader、两帧确认、各自完整帧接纳与位序映射；单模块错误不阻塞另一模块。
- `src/ttp229_event_bridge.v`：默认16键兼容，主工程显式选择32键、5位全局键号；共用原FIFO，保持Note Off优先、背压期间字段稳定。
- 板级顶层：拼接32位状态送入同一个事件桥与原32 Voice音源；实际FIFO接纳状态扩展到32位。GAO同步覆盖两模块。
- 当前GPRJ启用新增RTL，CST显式分配新增两根管脚，禁止工具自行选择新IO。
- 保留钢琴参数/Loader/Voice/增益/FX、FFT、HDMI、双DAC及已验证视频时钟/SDC。没有加入其他乐器音源。

仿真包括：32键逐位串行模型、首次全32键和弦、跨模块独立释放、16深度FIFO满背压、快速变化/复位、无效映射及模块故障隔离；真实32个钢琴Voice同时运行、逐路有非零样本、双DAC解码比对及真实FFT/TMDS/状态链路；原16键PCM及双DAC管脚与修改前RTL对照。

串行模型按TTP229-BSF式协议，功能仿真的PLL/物理视频串行器使用边界替身；实际器件映射与时序由Gowin实现验证。上述不等于实物协议/线序/模拟音质验证。旧8键/单键模块配置不会被软件扩展成32键复音。

修改前备份：`audit/keyboard32_20261019/backup`。
本轮测试与日志：`tests/keyboard32_20261019`。

## 最终结果

本轮仿真、Gowin综合、布局布线及五类时序全部通过。未自动烧录，上板接线/协议/真实32键演奏与音质仍待确认。

- FS：`impl/pnr/ao_0.fs`，同哈希归档 `tests/keyboard32_20261019/final_build/ao_0.fs`。
- SHA256：`18427350a26750067ee9cb54e1ea1e6ceff67adb1a347475a0f79c1b88ae6bfa`。
- 实际综合网表包含32个钢琴Voice；68个有效工程输入；没有把测试平台参与综合。
- 全部378行管脚表核对：仅原先空闲的B19、A17两行变为新增键盘接口；其余管脚字段全部不变。
- 71个受保护源文件哈希不变，包含钢琴/FX/FFT/HDMI/双DAC及完整SDC。

| 时序检查 | 最差裕量/ns |
|---|---:|
|setup|0.253|
|hold|0.005|
|recovery|0.848|
|removal|0.293|
|min_pulse_width|3.207|

Setup/Hold违规端点均为0；Recovery、Removal和最小脉宽的最差裕量均非负。

工具仍报告既有TA1132（GAO的tck_pad_i未显式建钟）及PR1014（clk_50m_d使用常规布线）警告，完整保留在日志中。本轮没有通过移除约束或放宽SDC消除警告，不能把“时序通过”理解为“没有任何工具警告”。

| 资源 | 使用/总量 |
|---|---:|
|Logic|48881/138240|
|Register|19218/139140|
|BSRAM|291/340|
|DSP|131/298|
|PLL|3/12|

- 实际本轮综合网表Loader与ROM的GW5A原语仿真：MIDI60～91共32音、12800个参数字，数学模型核对0处差异。只强制已捕获的请求音高/基准增量，不强制插值计算信号；该局部门级检查不覆盖键盘/Allocator，完整键盘通路由SYSTEM验证。
- 两块串行键盘经过真实FIFO、Loader后，对32个实际Voice RAM端口的12800次写入逐次读回，全部成功；每一路RAM参数与该路MIDI音符的数学模型一致，0处差异。
- PASS events32: 202 convergence cases, 2893 stalled cycles, all32 unique notes, 16-deep FIFO, rapid changes, reset
- PASS serial pair: 76 cases, production timing, 32 physical bits, independent frame admission/faults/raw permutations, duplicate table rejected
- PASS keyboard events: 106 convergence/map checks; 100 stalled cycles; 16-key permutation, chords 2/3/5/8/16, release, invalid frames, full FIFO, reset, 32-bit map
- PASS preserve16: 518527 clocks, 2025 PCM samples and both DAC pins bit-exact to backed-up old RTL; 4 Note events; unconnected bank2 silent
- PASS physical32 system: 12 scenarios, 44 On/40 Off, 44 allocations, max_active32, nonzero_voice_maskffffffff; PCM5102 9458 frames/PT8211 9458 words exact; FFT4, TMDS12338132 pixels, limiter-flag frames0

首次综合因GAO引用已移除的旧 `key_reader_frame_valid` 名称而停止，未产生新实现，日志/失败门禁保存在 `gowin_attempt1.log` 和 `BUILD_attempt1.json`。移除该单个旧探针后重新完整实现；两模块的完整帧接纳脉冲由 `key_bank_frame_valid[1:0]` 捕获。时序门禁没有采用首次失败时仍在磁盘上的旧报告。初次系统仿真因缺少中途进度输出被主动终止，加入仅观测用时间输出后完整重跑，最终SYSTEM.json源哈希与当前工程一致。

UNIT及原16键对照在GAO单个XML探针移除前完成，所有RTL及GPRJ哈希与最终构建一致；独立SERIAL及完整SYSTEM在最终配置下通过。此配置差异不参与Icarus编译，最终审计逐文件检查，未忽略任何RTL差异。
