kehanzuishuai/fpga/docs/images/project-poster.png

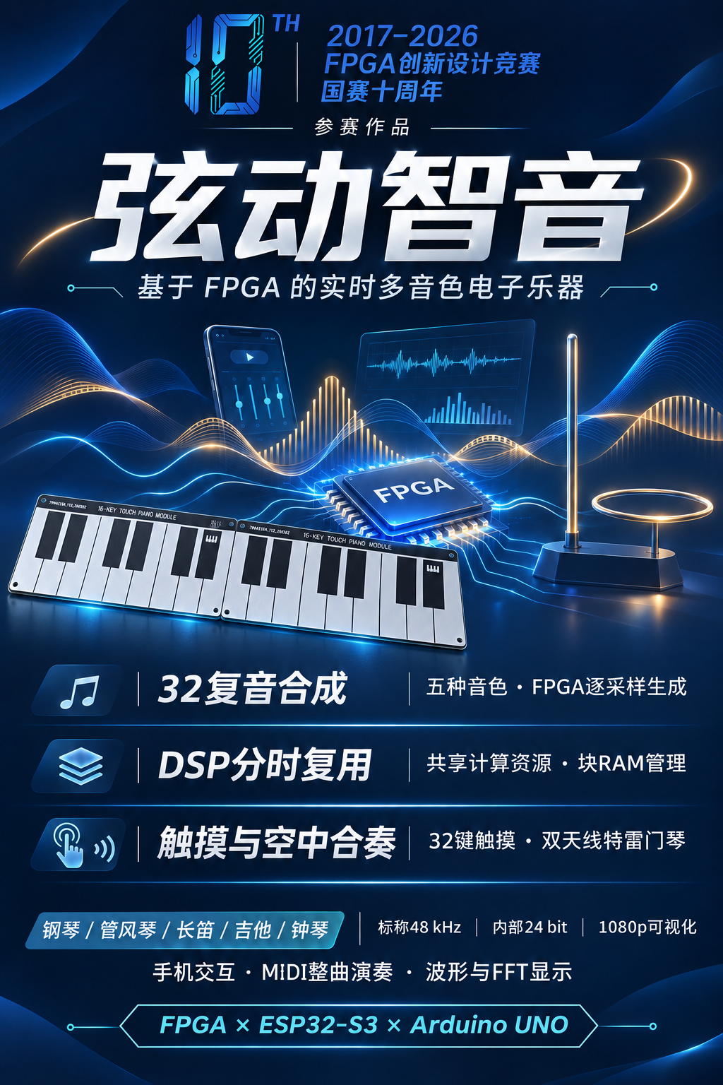
docs/images/project-poster.png
