kehanzuishuai/fpga/audit/labels_line_engine_20261024/RESULT_SUMMARY.md

2026-10-24 10:45: generator now emits spaces around ?: in ln_line_list; GowinSynthesis read "12'd73?" as a decimal literal with a z digit (EX3132). after/ regenerated; it equals the simulated text token for token (only the spaces differ), so the full-frame PASS above stands. New sha256 prefix 93eceb4a74dc3977.
