kehanzuishuai/fpga/docs/AUDIO_TEST_RESULTS.md

# AUDIO_TEST_RESULTS

工程：`D:\gaoyun\piano_v2_audio_fix`

入口：`D:\gaoyun\piano_v2_audio_fix\yinyue_fashengqi.gprj`

更新时间：2026-10-17T21:32:51.567579+08:00。数字验证：**PASS**；真实上板：**PENDING**。禁止自动烧录。

工作目录全部为 `D:\gaoyun\piano_v2_audio_fix`；当前汇总 `D:\gaoyun\piano_v2_audio_fix\audit\scale_decay_20261017\VALIDATION.json`。命令的真实参数、起止时间、返回码和输入SHA256在每个同名JSON中。下列状态来自实际运行，不把历史PASS替代本轮要求的回归。

| 测试 | 状态 | 实际日志 |
|---|---|---|
| mapping_default | PASS | D:\gaoyun\piano_v2_audio_fix\tests\scale_decay_20261017\mapping_default.log |
| mapping_permuted | PASS | D:\gaoyun\piano_v2_audio_fix\tests\scale_decay_20261017\mapping_permuted.log |
| mapping_transposed | PASS | D:\gaoyun\piano_v2_audio_fix\tests\scale_decay_20261017\mapping_transposed.log |
| direct_midi | PASS | D:\gaoyun\piano_v2_audio_fix\tests\scale_decay_20261017\direct_midi.log |
| voice_peak | PASS | D:\gaoyun\piano_v2_audio_fix\tests\scale_decay_20261017\voice_peak.log |
| keyboard_unit | PASS | D:\gaoyun\piano_v2_audio_fix\tests\scale_decay_20261017\keyboard_unit.log |
| keyboard_status | PASS | D:\gaoyun\piano_v2_audio_fix\tests\scale_decay_20261017\keyboard_status.log |
| display | PASS | D:\gaoyun\piano_v2_audio_fix\tests\scale_decay_20261017\display.log |
| stress | PASS | D:\gaoyun\piano_v2_audio_fix\tests\scale_decay_20261017\stress.log |
| hardware_syntax | PASS | D:\gaoyun\piano_v2_audio_fix\tests\scale_decay_20261017\hardware_syntax.log |
| full_regression | PASS | D:\gaoyun\piano_v2_audio_fix\tests\scale_decay_20261017\full_regression.log |
| loader | PASS | D:\gaoyun\piano_v2_audio_fix\tests\scale_decay_20261017\loader.log |
| audio_static_audit | PASS | D:\gaoyun\piano_v2_audio_fix\tests\scale_decay_20261017\audio_static_audit.log |
| audio_source_audit | PASS | D:\gaoyun\piano_v2_audio_fix\tests\scale_decay_20261017\audio_source_audit.log |
| nyquist_audit | PASS | D:\gaoyun\piano_v2_audio_fix\tests\scale_decay_20261017\nyquist_audit.log |
| direct_equivalence_60 | PASS | D:\gaoyun\piano_v2_audio_fix\tests\scale_decay_20261017\direct_equivalence_60.log |
| direct_equivalence_61 | PASS | D:\gaoyun\piano_v2_audio_fix\tests\scale_decay_20261017\direct_equivalence_61.log |
| direct_equivalence_62 | PASS | D:\gaoyun\piano_v2_audio_fix\tests\scale_decay_20261017\direct_equivalence_62.log |
| direct_equivalence_63 | PASS | D:\gaoyun\piano_v2_audio_fix\tests\scale_decay_20261017\direct_equivalence_63.log |
| direct_equivalence_64 | PASS | D:\gaoyun\piano_v2_audio_fix\tests\scale_decay_20261017\direct_equivalence_64.log |
| direct_equivalence_65 | PASS | D:\gaoyun\piano_v2_audio_fix\tests\scale_decay_20261017\direct_equivalence_65.log |
| direct_equivalence_66 | PASS | D:\gaoyun\piano_v2_audio_fix\tests\scale_decay_20261017\direct_equivalence_66.log |
| direct_equivalence_67 | PASS | D:\gaoyun\piano_v2_audio_fix\tests\scale_decay_20261017\direct_equivalence_67.log |
| direct_equivalence_68 | PASS | D:\gaoyun\piano_v2_audio_fix\tests\scale_decay_20261017\direct_equivalence_68.log |
| direct_equivalence_69 | PASS | D:\gaoyun\piano_v2_audio_fix\tests\scale_decay_20261017\direct_equivalence_69.log |
| direct_equivalence_70 | PASS | D:\gaoyun\piano_v2_audio_fix\tests\scale_decay_20261017\direct_equivalence_70.log |
| direct_equivalence_71 | PASS | D:\gaoyun\piano_v2_audio_fix\tests\scale_decay_20261017\direct_equivalence_71.log |
| direct_equivalence_72 | PASS | D:\gaoyun\piano_v2_audio_fix\tests\scale_decay_20261017\direct_equivalence_72.log |
| direct_equivalence_73 | PASS | D:\gaoyun\piano_v2_audio_fix\tests\scale_decay_20261017\direct_equivalence_73.log |
| direct_equivalence_74 | PASS | D:\gaoyun\piano_v2_audio_fix\tests\scale_decay_20261017\direct_equivalence_74.log |
| direct_equivalence_75 | PASS | D:\gaoyun\piano_v2_audio_fix\tests\scale_decay_20261017\direct_equivalence_75.log |
| recheck_voice_60 | PASS | D:\gaoyun\piano_v2_audio_fix\tests\scale_decay_20261017\recheck_voice_60.log |
| recheck_voice_61 | PASS | D:\gaoyun\piano_v2_audio_fix\tests\scale_decay_20261017\recheck_voice_61.log |
| recheck_voice_62 | PASS | D:\gaoyun\piano_v2_audio_fix\tests\scale_decay_20261017\recheck_voice_62.log |
| recheck_voice_63 | PASS | D:\gaoyun\piano_v2_audio_fix\tests\scale_decay_20261017\recheck_voice_63.log |
| recheck_voice_64 | PASS | D:\gaoyun\piano_v2_audio_fix\tests\scale_decay_20261017\recheck_voice_64.log |
| recheck_voice_65 | PASS | D:\gaoyun\piano_v2_audio_fix\tests\scale_decay_20261017\recheck_voice_65.log |
| recheck_voice_66 | PASS | D:\gaoyun\piano_v2_audio_fix\tests\scale_decay_20261017\recheck_voice_66.log |
| recheck_voice_67 | PASS | D:\gaoyun\piano_v2_audio_fix\tests\scale_decay_20261017\recheck_voice_67.log |
| recheck_voice_68 | PASS | D:\gaoyun\piano_v2_audio_fix\tests\scale_decay_20261017\recheck_voice_68.log |
| recheck_voice_69 | PASS | D:\gaoyun\piano_v2_audio_fix\tests\scale_decay_20261017\recheck_voice_69.log |
| recheck_voice_70 | PASS | D:\gaoyun\piano_v2_audio_fix\tests\scale_decay_20261017\recheck_voice_70.log |
| recheck_voice_71 | PASS | D:\gaoyun\piano_v2_audio_fix\tests\scale_decay_20261017\recheck_voice_71.log |
| recheck_voice_72 | PASS | D:\gaoyun\piano_v2_audio_fix\tests\scale_decay_20261017\recheck_voice_72.log |
| recheck_voice_73 | PASS | D:\gaoyun\piano_v2_audio_fix\tests\scale_decay_20261017\recheck_voice_73.log |
| recheck_voice_74 | PASS | D:\gaoyun\piano_v2_audio_fix\tests\scale_decay_20261017\recheck_voice_74.log |
| recheck_voice_75 | PASS | D:\gaoyun\piano_v2_audio_fix\tests\scale_decay_20261017\recheck_voice_75.log |

- `mapping_default`：`D:\gaoyun\piano_v2\codex_test\tools\iverilog\bin\vvp.exe D:\gaoyun\piano_v2_audio_fix\tests\scale_decay_20261017\mapping_default.vvp`；日志 `D:\gaoyun\piano_v2_audio_fix\tests\scale_decay_20261017\mapping_default.log`。
- `mapping_permuted`：`D:\gaoyun\piano_v2\codex_test\tools\iverilog\bin\vvp.exe D:\gaoyun\piano_v2_audio_fix\tests\scale_decay_20261017\mapping_permuted.vvp`；日志 `D:\gaoyun\piano_v2_audio_fix\tests\scale_decay_20261017\mapping_permuted.log`。
- `mapping_transposed`：`D:\gaoyun\piano_v2\codex_test\tools\iverilog\bin\vvp.exe D:\gaoyun\piano_v2_audio_fix\tests\scale_decay_20261017\mapping_transposed.vvp`；日志 `D:\gaoyun\piano_v2_audio_fix\tests\scale_decay_20261017\mapping_transposed.log`。
- `direct_midi`：`D:\gaoyun\piano_v2\codex_test\tools\iverilog\bin\vvp.exe D:\gaoyun\piano_v2_audio_fix\tests\scale_decay_20261017\direct_midi.vvp`；日志 `D:\gaoyun\piano_v2_audio_fix\tests\scale_decay_20261017\direct_midi.log`。
- `voice_peak`：`D:\gaoyun\piano_v2\codex_test\tools\iverilog\bin\vvp.exe D:\gaoyun\piano_v2_audio_fix\tests\scale_decay_20261017\voice_peak.vvp`；日志 `D:\gaoyun\piano_v2_audio_fix\tests\scale_decay_20261017\voice_peak.log`。
- `keyboard_unit`：`C:\Users\Yan Guyao\.cache\codex-runtimes\codex-primary-runtime\dependencies\python\python.exe -X utf8 -B -u tools/run_keyboard_unit.py`；日志 `D:\gaoyun\piano_v2_audio_fix\tests\scale_decay_20261017\keyboard_unit.log`。
- `keyboard_status`：`C:\Users\Yan Guyao\.cache\codex-runtimes\codex-primary-runtime\dependencies\python\python.exe -X utf8 -B -u tools/run_keyboard_status.py`；日志 `D:\gaoyun\piano_v2_audio_fix\tests\scale_decay_20261017\keyboard_status.log`。
- `display`：`C:\Users\Yan Guyao\.cache\codex-runtimes\codex-primary-runtime\dependencies\python\python.exe -X utf8 -B -u tests/display/scripts/verify_display.py`；日志 `D:\gaoyun\piano_v2_audio_fix\tests\scale_decay_20261017\display.log`。
- `stress`：`D:\gaoyun\piano_v2\codex_test\tools\iverilog\bin\vvp.exe D:\gaoyun\piano_v2_audio_fix\tests\scale_decay_20261017\stress.vvp`；日志 `D:\gaoyun\piano_v2_audio_fix\tests\scale_decay_20261017\stress.log`。
- `hardware_syntax`：`D:\gaoyun\piano_v2\codex_test\tools\iverilog\bin\iverilog.exe -g2012 -tnull -s tb_hardware_elaboration tests/integration/tb_hardware_elaboration.sv D:\gaoyun\piano_v2_audio_fix\src\adsr_env.v D:\gaoyun\piano_v2_audio_fix\src\audio_telemetry.v D:\gaoyun\piano_v2_audio_fix\src\gowin_pll\audio_pll.v D:\gaoyun\piano_v2_audio_fix\src\gowin_pll\audio_pll_mod.v D:\gaoyun\piano_v2_audio_fix\src\i2s_tx.v D:\gaoyun\piano_v2_audio_fix\src\latency_monit.v D:\gaoyun\piano_v2_audio_fix\src\led_guide.v D:\gaoyun\piano_v2_audio_fix\src\morph_control.v D:\gaoyun\piano_v2_audio_fix\src\note_event_fifo.v D:\gaoyun\piano_v2_audio_fix\src\note_freq_table.v D:\gaoyun\piano_v2_audio_fix\src\pcm5102_i2s_tx.v D:\gaoyun\piano_v2_audio_fix\src\performance_mode_controller.v D:\gaoyun\piano_v2_audio_fix\src\piano_exp_rom.v D:\gaoyun\piano_v2_audio_fix\src\piano_fx_compat.v D:\gaoyun\piano_v2_audio_fix\src\piano_level_rom.v D:\gaoyun\piano_v2_audio_fix\src\piano_note_loader.v D:\gaoyun\piano_v2_audio_fix\src\piano_note_rom.v D:\gaoyun\piano_v2_audio_fix\src\piano_partial_voice.v D:\gaoyun\piano_v2_audio_fix\src\piano_ratio_rom.v D:\gaoyun\piano_v2_audio_fix\src\piano_sine_rom.v D:\gaoyun\piano_v2_audio_fix\src\pll_init.v D:\gaoyun\piano_v2_audio_fix\src\polyphony_gain.v D:\gaoyun\piano_v2_audio_fix\src\saturator.v D:\gaoyun\piano_v2_audio_fix\src\score_rom.v D:\gaoyun\piano_v2_audio_fix\src\synth_core.v D:\gaoyun\piano_v2_audio_fix\src\synth_event_frontend.v D:\gaoyun\piano_v2_audio_fix\src\synth_pkg.v D:\gaoyun\piano_v2_audio_fix\src\synth_top.v D:\gaoyun\piano_v2_audio_fix\src\tang_mega_138k_pro_top.v.v D:\gaoyun\piano_v2_audio_fix\src\telemetry_uart.v D:\gaoyun\piano_v2_audio_fix\src\test_mode.v D:\gaoyun\piano_v2_audio_fix\src\tree_mixer.v D:\gaoyun\piano_v2_audio_fix\src\ttp229_event_bridge.v D:\gaoyun\piano_v2_audio_fix\src\ttp229_reader.v D:\gaoyun\piano_v2_audio_fix\src\uart_tx.v D:\gaoyun\piano_v2_audio_fix\src\voice_allocator.v D:\gaoyun\piano_v2_audio_fix\src\voice_bank.v D:\gaoyun\piano_v2_audio_fix\src\dds_phase_accum.v D:\gaoyun\piano_v2_audio_fix\src\piano_dual_wavetable.v D:\gaoyun\piano_v2_audio_fix\src\piano_envelope.v D:\gaoyun\piano_v2_audio_fix\src\piano_string_model.v D:\gaoyun\piano_v2_audio_fix\src\timbre_morph.v D:\gaoyun\piano_v2_audio_fix\src\voice.v D:\gaoyun\piano_v2_audio_fix\src\waveform_gen.v D:\gaoyun\piano_v2_audio_fix\src\waveform_set.v D:\gaoyun\piano_v2_audio_fix\src\display\audio_visualizer.sv D:\gaoyun\piano_v2_audio_fix\src\display\gowin_pll\visual_pll_mod.v D:\gaoyun\piano_v2_audio_fix\src\display\piano_status_cdc.v D:\gaoyun\piano_v2_audio_fix\src\display\piano_status_overlay.sv D:\gaoyun\piano_v2_audio_fix\src\display\visual_dvi_io.v D:\gaoyun\piano_v2_audio_fix\src\display\visual_fft.sv D:\gaoyun\piano_v2_audio_fix\src\display\visual_frame_store.v D:\gaoyun\piano_v2_audio_fix\src\display\visual_labels.sv D:\gaoyun\piano_v2_audio_fix\src\display\visual_raster.v D:\gaoyun\piano_v2_audio_fix\src\display\visual_renderer.sv D:\gaoyun\piano_v2_audio_fix\src\display\visual_tmds.sv D:\gaoyun\piano_v2_audio_fix\src\display\visual_twiddle_rom.v D:\gaoyun\piano_v2_audio_fix\src\display\visual_video_clock.v D:\gaoyun\piano_v2_audio_fix\src\display\yinse_display_info.sv D:\gaoyun\piano_v2_audio_fix\src\keyboard\keyboard_state_mapper.sv C:\Gowin2\Gowin_V1.9.12_x64\IDE\simlib\gw5a\prim_sim.v`；日志 `D:\gaoyun\piano_v2_audio_fix\tests\scale_decay_20261017\hardware_syntax.log`。
- `full_regression`：`C:\Users\Yan Guyao\.cache\codex-runtimes\codex-primary-runtime\dependencies\python\python.exe -X utf8 -B -u -c import os,runpy,sys;os.cpu_count=lambda:6;sys.argv=['sim/run_tests.py','all'];runpy.run_path('sim/run_tests.py',run_name='__main__')`；日志 `D:\gaoyun\piano_v2_audio_fix\tests\scale_decay_20261017\full_regression.log`。
- `loader`：`D:\gaoyun\piano_v2\codex_test\tools\iverilog\bin\vvp.exe D:\gaoyun\piano_v2_audio_fix\tests\scale_decay_20261017\loader.vvp`；日志 `D:\gaoyun\piano_v2_audio_fix\tests\scale_decay_20261017\loader.log`。
- `audio_static_audit`：`C:\Users\Yan Guyao\.cache\codex-runtimes\codex-primary-runtime\dependencies\python\python.exe -X utf8 -B -c from pathlib import Path;p=Path('tools/audio_static_audit.py');s=p.read_text().replace("O=R/'tests/audio_diagnosis'","O=R/'tests/scale_decay_20261017'");exec(compile(s,str(p),'exec'),{'__file__':str(p.resolve()),'__name__':'__main__'})`；日志 `D:\gaoyun\piano_v2_audio_fix\tests\scale_decay_20261017\audio_static_audit.log`。
- `audio_source_audit`：`C:\Users\Yan Guyao\.cache\codex-runtimes\codex-primary-runtime\dependencies\python\python.exe -X utf8 -B -c from pathlib import Path;p=Path('tools/audio_source_audit.py');s=p.read_text().replace("O=R/'tests/audio_diagnosis'","O=R/'tests/scale_decay_20261017'");exec(compile(s,str(p),'exec'),{'__file__':str(p.resolve()),'__name__':'__main__'})`；日志 `D:\gaoyun\piano_v2_audio_fix\tests\scale_decay_20261017\audio_source_audit.log`。
- `nyquist_audit`：`C:\Users\Yan Guyao\.cache\codex-runtimes\codex-primary-runtime\dependencies\python\python.exe -X utf8 -B -c import sys,runpy;sys.path.insert(0,'tools');import continue_audio_audit as m;from pathlib import Path;m.O=Path('tests/scale_decay_20261017').resolve();runpy.run_path('tools/continuation_nyquist_audit.py',run_name='__main__')`；日志 `D:\gaoyun\piano_v2_audio_fix\tests\scale_decay_20261017\nyquist_audit.log`。
- `direct_equivalence_60`：`C:\Users\Yan Guyao\.cache\codex-runtimes\codex-primary-runtime\dependencies\python\python.exe -X utf8 -B tools/compare_pcm.py D:\gaoyun\piano_v2_audio_fix\tests\scale_decay_20261017\direct_voice_60.txt --hammer 1`；日志 `D:\gaoyun\piano_v2_audio_fix\tests\scale_decay_20261017\direct_equivalence_60.log`。
- `direct_equivalence_61`：`C:\Users\Yan Guyao\.cache\codex-runtimes\codex-primary-runtime\dependencies\python\python.exe -X utf8 -B tools/compare_pcm.py D:\gaoyun\piano_v2_audio_fix\tests\scale_decay_20261017\direct_voice_61.txt --hammer 1`；日志 `D:\gaoyun\piano_v2_audio_fix\tests\scale_decay_20261017\direct_equivalence_61.log`。
- `direct_equivalence_62`：`C:\Users\Yan Guyao\.cache\codex-runtimes\codex-primary-runtime\dependencies\python\python.exe -X utf8 -B tools/compare_pcm.py D:\gaoyun\piano_v2_audio_fix\tests\scale_decay_20261017\direct_voice_62.txt --hammer 1`；日志 `D:\gaoyun\piano_v2_audio_fix\tests\scale_decay_20261017\direct_equivalence_62.log`。
- `direct_equivalence_63`：`C:\Users\Yan Guyao\.cache\codex-runtimes\codex-primary-runtime\dependencies\python\python.exe -X utf8 -B tools/compare_pcm.py D:\gaoyun\piano_v2_audio_fix\tests\scale_decay_20261017\direct_voice_63.txt --hammer 1`；日志 `D:\gaoyun\piano_v2_audio_fix\tests\scale_decay_20261017\direct_equivalence_63.log`。
- `direct_equivalence_64`：`C:\Users\Yan Guyao\.cache\codex-runtimes\codex-primary-runtime\dependencies\python\python.exe -X utf8 -B tools/compare_pcm.py D:\gaoyun\piano_v2_audio_fix\tests\scale_decay_20261017\direct_voice_64.txt --hammer 1`；日志 `D:\gaoyun\piano_v2_audio_fix\tests\scale_decay_20261017\direct_equivalence_64.log`。
- `direct_equivalence_65`：`C:\Users\Yan Guyao\.cache\codex-runtimes\codex-primary-runtime\dependencies\python\python.exe -X utf8 -B tools/compare_pcm.py D:\gaoyun\piano_v2_audio_fix\tests\scale_decay_20261017\direct_voice_65.txt --hammer 1`；日志 `D:\gaoyun\piano_v2_audio_fix\tests\scale_decay_20261017\direct_equivalence_65.log`。
- `direct_equivalence_66`：`C:\Users\Yan Guyao\.cache\codex-runtimes\codex-primary-runtime\dependencies\python\python.exe -X utf8 -B tools/compare_pcm.py D:\gaoyun\piano_v2_audio_fix\tests\scale_decay_20261017\direct_voice_66.txt --hammer 1`；日志 `D:\gaoyun\piano_v2_audio_fix\tests\scale_decay_20261017\direct_equivalence_66.log`。
- `direct_equivalence_67`：`C:\Users\Yan Guyao\.cache\codex-runtimes\codex-primary-runtime\dependencies\python\python.exe -X utf8 -B tools/compare_pcm.py D:\gaoyun\piano_v2_audio_fix\tests\scale_decay_20261017\direct_voice_67.txt --hammer 1`；日志 `D:\gaoyun\piano_v2_audio_fix\tests\scale_decay_20261017\direct_equivalence_67.log`。
- `direct_equivalence_68`：`C:\Users\Yan Guyao\.cache\codex-runtimes\codex-primary-runtime\dependencies\python\python.exe -X utf8 -B tools/compare_pcm.py D:\gaoyun\piano_v2_audio_fix\tests\scale_decay_20261017\direct_voice_68.txt --hammer 1`；日志 `D:\gaoyun\piano_v2_audio_fix\tests\scale_decay_20261017\direct_equivalence_68.log`。
- `direct_equivalence_69`：`C:\Users\Yan Guyao\.cache\codex-runtimes\codex-primary-runtime\dependencies\python\python.exe -X utf8 -B tools/compare_pcm.py D:\gaoyun\piano_v2_audio_fix\tests\scale_decay_20261017\direct_voice_69.txt --hammer 1`；日志 `D:\gaoyun\piano_v2_audio_fix\tests\scale_decay_20261017\direct_equivalence_69.log`。
- `direct_equivalence_70`：`C:\Users\Yan Guyao\.cache\codex-runtimes\codex-primary-runtime\dependencies\python\python.exe -X utf8 -B tools/compare_pcm.py D:\gaoyun\piano_v2_audio_fix\tests\scale_decay_20261017\direct_voice_70.txt --hammer 1`；日志 `D:\gaoyun\piano_v2_audio_fix\tests\scale_decay_20261017\direct_equivalence_70.log`。
- `direct_equivalence_71`：`C:\Users\Yan Guyao\.cache\codex-runtimes\codex-primary-runtime\dependencies\python\python.exe -X utf8 -B tools/compare_pcm.py D:\gaoyun\piano_v2_audio_fix\tests\scale_decay_20261017\direct_voice_71.txt --hammer 1`；日志 `D:\gaoyun\piano_v2_audio_fix\tests\scale_decay_20261017\direct_equivalence_71.log`。
- `direct_equivalence_72`：`C:\Users\Yan Guyao\.cache\codex-runtimes\codex-primary-runtime\dependencies\python\python.exe -X utf8 -B tools/compare_pcm.py D:\gaoyun\piano_v2_audio_fix\tests\scale_decay_20261017\direct_voice_72.txt --hammer 1`；日志 `D:\gaoyun\piano_v2_audio_fix\tests\scale_decay_20261017\direct_equivalence_72.log`。
- `direct_equivalence_73`：`C:\Users\Yan Guyao\.cache\codex-runtimes\codex-primary-runtime\dependencies\python\python.exe -X utf8 -B tools/compare_pcm.py D:\gaoyun\piano_v2_audio_fix\tests\scale_decay_20261017\direct_voice_73.txt --hammer 1`；日志 `D:\gaoyun\piano_v2_audio_fix\tests\scale_decay_20261017\direct_equivalence_73.log`。
- `direct_equivalence_74`：`C:\Users\Yan Guyao\.cache\codex-runtimes\codex-primary-runtime\dependencies\python\python.exe -X utf8 -B tools/compare_pcm.py D:\gaoyun\piano_v2_audio_fix\tests\scale_decay_20261017\direct_voice_74.txt --hammer 1`；日志 `D:\gaoyun\piano_v2_audio_fix\tests\scale_decay_20261017\direct_equivalence_74.log`。
- `direct_equivalence_75`：`C:\Users\Yan Guyao\.cache\codex-runtimes\codex-primary-runtime\dependencies\python\python.exe -X utf8 -B tools/compare_pcm.py D:\gaoyun\piano_v2_audio_fix\tests\scale_decay_20261017\direct_voice_75.txt --hammer 1`；日志 `D:\gaoyun\piano_v2_audio_fix\tests\scale_decay_20261017\direct_equivalence_75.log`。
- `recheck_voice_60`：`C:\Users\Yan Guyao\.cache\codex-runtimes\codex-primary-runtime\dependencies\python\python.exe -X utf8 -B tools/compare_pcm.py D:\gaoyun\piano_v2_audio_fix\tests\scale_decay_20261017\notes\midi_060\rtl_voice.txt --hammer 1`；日志 `D:\gaoyun\piano_v2_audio_fix\tests\scale_decay_20261017\recheck_voice_60.log`。
- `recheck_voice_61`：`C:\Users\Yan Guyao\.cache\codex-runtimes\codex-primary-runtime\dependencies\python\python.exe -X utf8 -B tools/compare_pcm.py D:\gaoyun\piano_v2_audio_fix\tests\scale_decay_20261017\notes\midi_061\rtl_voice.txt --hammer 1`；日志 `D:\gaoyun\piano_v2_audio_fix\tests\scale_decay_20261017\recheck_voice_61.log`。
- `recheck_voice_62`：`C:\Users\Yan Guyao\.cache\codex-runtimes\codex-primary-runtime\dependencies\python\python.exe -X utf8 -B tools/compare_pcm.py D:\gaoyun\piano_v2_audio_fix\tests\scale_decay_20261017\notes\midi_062\rtl_voice.txt --hammer 1`；日志 `D:\gaoyun\piano_v2_audio_fix\tests\scale_decay_20261017\recheck_voice_62.log`。
- `recheck_voice_63`：`C:\Users\Yan Guyao\.cache\codex-runtimes\codex-primary-runtime\dependencies\python\python.exe -X utf8 -B tools/compare_pcm.py D:\gaoyun\piano_v2_audio_fix\tests\scale_decay_20261017\notes\midi_063\rtl_voice.txt --hammer 1`；日志 `D:\gaoyun\piano_v2_audio_fix\tests\scale_decay_20261017\recheck_voice_63.log`。
- `recheck_voice_64`：`C:\Users\Yan Guyao\.cache\codex-runtimes\codex-primary-runtime\dependencies\python\python.exe -X utf8 -B tools/compare_pcm.py D:\gaoyun\piano_v2_audio_fix\tests\scale_decay_20261017\notes\midi_064\rtl_voice.txt --hammer 1`；日志 `D:\gaoyun\piano_v2_audio_fix\tests\scale_decay_20261017\recheck_voice_64.log`。
- `recheck_voice_65`：`C:\Users\Yan Guyao\.cache\codex-runtimes\codex-primary-runtime\dependencies\python\python.exe -X utf8 -B tools/compare_pcm.py D:\gaoyun\piano_v2_audio_fix\tests\scale_decay_20261017\notes\midi_065\rtl_voice.txt --hammer 1`；日志 `D:\gaoyun\piano_v2_audio_fix\tests\scale_decay_20261017\recheck_voice_65.log`。
- `recheck_voice_66`：`C:\Users\Yan Guyao\.cache\codex-runtimes\codex-primary-runtime\dependencies\python\python.exe -X utf8 -B tools/compare_pcm.py D:\gaoyun\piano_v2_audio_fix\tests\scale_decay_20261017\notes\midi_066\rtl_voice.txt --hammer 1`；日志 `D:\gaoyun\piano_v2_audio_fix\tests\scale_decay_20261017\recheck_voice_66.log`。
- `recheck_voice_67`：`C:\Users\Yan Guyao\.cache\codex-runtimes\codex-primary-runtime\dependencies\python\python.exe -X utf8 -B tools/compare_pcm.py D:\gaoyun\piano_v2_audio_fix\tests\scale_decay_20261017\notes\midi_067\rtl_voice.txt --hammer 1`；日志 `D:\gaoyun\piano_v2_audio_fix\tests\scale_decay_20261017\recheck_voice_67.log`。
- `recheck_voice_68`：`C:\Users\Yan Guyao\.cache\codex-runtimes\codex-primary-runtime\dependencies\python\python.exe -X utf8 -B tools/compare_pcm.py D:\gaoyun\piano_v2_audio_fix\tests\scale_decay_20261017\notes\midi_068\rtl_voice.txt --hammer 1`；日志 `D:\gaoyun\piano_v2_audio_fix\tests\scale_decay_20261017\recheck_voice_68.log`。
- `recheck_voice_69`：`C:\Users\Yan Guyao\.cache\codex-runtimes\codex-primary-runtime\dependencies\python\python.exe -X utf8 -B tools/compare_pcm.py D:\gaoyun\piano_v2_audio_fix\tests\scale_decay_20261017\notes\midi_069\rtl_voice.txt --hammer 1`；日志 `D:\gaoyun\piano_v2_audio_fix\tests\scale_decay_20261017\recheck_voice_69.log`。
- `recheck_voice_70`：`C:\Users\Yan Guyao\.cache\codex-runtimes\codex-primary-runtime\dependencies\python\python.exe -X utf8 -B tools/compare_pcm.py D:\gaoyun\piano_v2_audio_fix\tests\scale_decay_20261017\notes\midi_070\rtl_voice.txt --hammer 1`；日志 `D:\gaoyun\piano_v2_audio_fix\tests\scale_decay_20261017\recheck_voice_70.log`。
- `recheck_voice_71`：`C:\Users\Yan Guyao\.cache\codex-runtimes\codex-primary-runtime\dependencies\python\python.exe -X utf8 -B tools/compare_pcm.py D:\gaoyun\piano_v2_audio_fix\tests\scale_decay_20261017\notes\midi_071\rtl_voice.txt --hammer 1`；日志 `D:\gaoyun\piano_v2_audio_fix\tests\scale_decay_20261017\recheck_voice_71.log`。
- `recheck_voice_72`：`C:\Users\Yan Guyao\.cache\codex-runtimes\codex-primary-runtime\dependencies\python\python.exe -X utf8 -B tools/compare_pcm.py D:\gaoyun\piano_v2_audio_fix\tests\scale_decay_20261017\notes\midi_072\rtl_voice.txt --hammer 1`；日志 `D:\gaoyun\piano_v2_audio_fix\tests\scale_decay_20261017\recheck_voice_72.log`。
- `recheck_voice_73`：`C:\Users\Yan Guyao\.cache\codex-runtimes\codex-primary-runtime\dependencies\python\python.exe -X utf8 -B tools/compare_pcm.py D:\gaoyun\piano_v2_audio_fix\tests\scale_decay_20261017\notes\midi_073\rtl_voice.txt --hammer 1`；日志 `D:\gaoyun\piano_v2_audio_fix\tests\scale_decay_20261017\recheck_voice_73.log`。
- `recheck_voice_74`：`C:\Users\Yan Guyao\.cache\codex-runtimes\codex-primary-runtime\dependencies\python\python.exe -X utf8 -B tools/compare_pcm.py D:\gaoyun\piano_v2_audio_fix\tests\scale_decay_20261017\notes\midi_074\rtl_voice.txt --hammer 1`；日志 `D:\gaoyun\piano_v2_audio_fix\tests\scale_decay_20261017\recheck_voice_74.log`。
- `recheck_voice_75`：`C:\Users\Yan Guyao\.cache\codex-runtimes\codex-primary-runtime\dependencies\python\python.exe -X utf8 -B tools/compare_pcm.py D:\gaoyun\piano_v2_audio_fix\tests\scale_decay_20261017\notes\midi_075\rtl_voice.txt --hammer 1`；日志 `D:\gaoyun\piano_v2_audio_fix\tests\scale_decay_20261017\recheck_voice_75.log`。

新增分析入口：`C:\Users\Yan Guyao\.cache\codex-runtimes\codex-primary-runtime\dependencies\python\python.exe -X utf8 -B tools/scale_decay_analyze.py provenance|audio|long_decay|direct_chain|data_integrity|onset`（每次选择一个动作）。audio_analysis.log、long_decay.log、direct_chain_analysis.log保留分析输出；逐音模型复核命令在recheck_voice_*及direct_equivalence_*的JSON。调度入口 `C:\Users\Yan Guyao\.cache\codex-runtimes\codex-primary-runtime\dependencies\python\python.exe -X utf8 -B -u tools/scale_decay_run.py snapshot|mapping|direct|telemetry|keyboard|display|stress|parameters|syntax|regression|build`，每次选择一个动作，最终报告命令为 `C:\Users\Yan Guyao\.cache\codex-runtimes\codex-primary-runtime\dependencies\python\python.exe -X utf8 -B tools/scale_decay_report.py --require-complete`。新直接注入16音都是当前真实32Voice RTL；3秒逐音文件按源哈希复用此前真实RTL，并本轮重新比较模型、重建PCM和检查FX，不冒充本轮重新跑满3秒。

量化数值、逐音频率/Peak/RMS/首次非零/最终零点：NOTE_METRICS.csv、STAGE_EXAMPLES.csv、QUANTIZATION_COUNTS.csv、PARTIAL_FIXED_TRACE.csv。短直接注入PCM5102共16832帧，零错误；联合压力21场景69On/53Off、69次分配、用到全部32Voice，12618 PCM5102帧和12618 PT8211字精确，6帧FFT、4826162 TMDS像素和15次源发布对齐状态快照通过。独立显示验证N1024/2048/4096；原有68项全回归的实际最终总数以full_regression.log末尾为准。

并发范围：稳定按住的16键和独立释放在映射/键盘/联合测试中验证完整接收。原有13ms快速重复触发压力场景保留桥的状态合并策略：若按下又松开均发生在未发出的NoteOn等待期间，可以不生成该短按事件；其测试期望加载64～132次，不是保证所有128次手势都各产生NoteOn。本轮没有重写事件系统；不要把该压力PASS解释成任意短按/任意背压下无条件保存全部历史手势。

显示边界：便携联合/显示仿真使用硬件PLL和物理OSER输出边界的stub，验证到真实TMDS编码数据；不能把这些日志称为板上HDMI电气验证。本轮hardware_syntax另用真实Gowin原语展开整个工程，新的P&R/STA检查物理实现。DVI局部复位RTL未变，上一轮真实Gowin行为原语对照记录保留在audit/continuation_20261017和tests/continuation_20261017，本轮不冒称重新运行该旧对照测试。

失败与补测：首次版本追溯分析因为快照字典混用正/反斜杠键而断言失败，FS与源码内容并未变化；修正路径规范化后逐项匹配，记录provenance_attempt1.json。映射三用例补跑一次，使默认用例连未启用的raw索引表也与正式默认参数完全一致，早期PASS保留在mapping_before_exact_default_parameter；生产RTL输出未变。其余本轮失败若有在对应JSON如实列出；硬件、实物位序、BIT-TREE芯片协议、模拟音频未执行。长按至最终零点为已验证模型扩展，不伪称16音都跑满60秒RTL。原有长音TB的fork/join会等待较晚的NoteOff，实际日志长度可超过名义ticks；本轮未缩短/修改这个既有测试。

Gowin状态：PASS；FS `D:\gaoyun\piano_v2_audio_fix\impl\pnr\ao_0.fs`；SHA256 `d5558ec0ec34cd610896238ddf9f3d9283f8dbb3b5c497520071bb017e66b5db`。前后资源 `{'Logic': 44061.0, 'Register': 16877.0, 'BSRAM': 258.0, 'DSP': 98.5, 'PLL': 2.0}` → `{'Logic': 44061.0, 'Register': 16877.0, 'BSRAM': 258.0, 'DSP': 98.5, 'PLL': 2.0}`；Fmax MHz `{'clk_50m': 239.235, 'audio_clk': 33.235, 'video_pixel': 33.479, 'tck_pad_i': 87.296}`；时序 `{'3.1.1 Setup Paths Table': 10.131, '3.1.2 Hold Paths Table': 0.143, '3.1.3 Recovery Paths Table': 2.716, '3.1.4 Removal Paths Table': 0.023, '3.2 Minimum Pulse Width Table': 7.128}`；引脚/IO/Bank对照 PASS。video_serial没有常规内部Fmax路径，不能据此声称125MHz逻辑Fmax。关键既有Warning与完整日志保留在gowin.log，本轮没有修改SDC来隐藏违规。
