kehanzuishuai/fpga/docs/SOUND_SOURCE_44_NOTE_RESULTS.md

# 44 音音源验收与 32 键候选音域比较

完成时间：2026-10-18T10:09:58.227537+08:00。工程：`D:\gaoyun\piano_v2_audio_fix`。本轮新增测试与分析，不修改任何生产 RTL、约束、项目配置和 FS。

**功能验证 PASS；32 个优质音高的音质验收：NOT_ACCEPTED；真人听评与上板验收 PENDING。相对优先推荐方案 A，仍需处理响度低谷并进行听评，不能称为已经具备 32 个优质音色。**

方案 A（48～79）的早期 RMS 跨度为 13.18 dB；方案 B（60～91）为 23.71 dB。方案 B 新增 80～91 后出现明显偏弱的高音区，MIDI84/C6 是重要检查点。

试听入口：[LISTENING_ROOM.html](D:/gaoyun/piano_v2_audio_fix/tests/range44_20261018/LISTENING_ROOM.html)。完整表：[NOTE_METRICS_44.csv](D:/gaoyun/piano_v2_audio_fix/tests/range44_20261018/NOTE_METRICS_44.csv)；FX 比较：[FX_AMPLITUDE_COMPARISON.csv](D:/gaoyun/piano_v2_audio_fix/tests/range44_20261018/FX_AMPLITUDE_COMPARISON.csv)；相邻音：[ADJACENT_COMPARISON.csv](D:/gaoyun/piano_v2_audio_fix/tests/range44_20261018/ADJACENT_COMPARISON.csv)；四半音变化和局部低谷：[FOUR_SEMITONE_COMPARISON.csv](D:/gaoyun/piano_v2_audio_fix/tests/range44_20261018/FOUR_SEMITONE_COMPARISON.csv)、[LOCAL_LOUDNESS_VALLEYS.csv](D:/gaoyun/piano_v2_audio_fix/tests/range44_20261018/LOCAL_LOUDNESS_VALLEYS.csv)。

## 验证条件与证据边界

- 主验收力度 100，hammer 开启，48kHz/24bit；每音 2 秒 Note On 后释放，记录总计 3 秒。各音均独立复位，避免残留混响；Q15 主增益 32767，FX 参数与当前 Stage3 相同。FX 前指主增益后、FX 模块前。
- 44 音全部重新运行真实 Voice+Loader RTL，逐计算样本与整数模型比较；44 音 FX 各 144000 样本重新跑 RTL 并逐样本一致。可试听单音 WAV 的每个值都来自这些流，没有逐音归一化、均衡补偿或试听淡出。
- 另外，44 音均通过实际 32 Voice synth_top 的直接 FIFO 注入，检查 On/Off、分配、Loader、Voice、混音、增益、FX、释放及 PCM5102 数字帧。每音仅 512 held+512 release ticks，用于通路验证；长音质分析来自独立 3 秒流。
- 长按无 NoteOff 的自然衰减最多 30 秒、直到 Voice 自然退出，使用当前整数模型；时间从 Loader 完成算起。不是 44 次长时 RTL 或板上测量。模型另筛查力度40/80/100/120的起音和响度，见 VELOCITY_SCREEN_MODEL.csv。
- 44 个不同音高单独验证，不代表两块16键输入已接入，也不代表同时32音的硬件/复音验收完成。生产工程仍保留32 Voice、FFT、HDMI和双DAC；原实体最后四键零VOICE/PEAK根因仍待GAO。
- 未执行真人听评，不能把客观指标等同于“好听”。这里给出有证据的相对风险、推荐顺序和可复核 WAV。

## A/B 定量比较

|音域/链路|起音RMS跨度 dB|早期RMS跨度 dB|早期RMS标准差 dB|最大相邻早期RMS差 dB|最大调音误差 cent|自然归零范围 s（模型）|音质筛查|
|---|---:|---:|---:|---:|---:|---|---|
|A 48～79 / fx_off|13.94|13.18|3.55|3.65|10.01|5.869～11.620|不通过|
|B 60～91 / fx_off|20.20|23.71|7.01|3.65|14.47|2.523～11.510|不通过|
|A 48～79 / fx_on|14.41|12.35|3.47|3.64|10.04|5.869～11.620|不通过|
|B 60～91 / fx_on|21.58|24.23|7.16|3.64|14.33|2.523～11.510|不通过|

本轮使用的工程筛查阈值见分析脚本：相邻 RMS >6dB、四半音内早期 RMS >9dB、中心音相对±4半音平均值偏差>6dB、32音早期 RMS 跨度>12dB；基音/泛音比相邻差>10dB、归一化频谱重心比>1.5、自然衰减时长相邻比>2、调音偏差>15cent。这些是本轮排查建议，用户尚未指定产品音质合格线，不冒充通用听觉标准。任何单项通过都不意味着音色优秀；本轮未通过筛查及尚无听评，不能据此宣布产品音质验收完成。

## 关键问题与解释

- MIDI60/C4：基频 262.232Hz，起音RMS -22.67dBFS，早期RMS -27.45dBFS，FX后 -20.51dBFS，基音/泛音 4.02dB，自然归零 9.256s（模型）。
- MIDI64/E4：基频 331.539Hz，起音RMS -30.58dBFS，早期RMS -36.37dBFS，FX后 -28.65dBFS，基音/泛音 2.25dB，自然归零 7.876s（模型）。
- MIDI68/Gs4：基频 417.231Hz，起音RMS -18.14dBFS，早期RMS -23.19dBFS，FX后 -16.74dBFS，基音/泛音 16.19dB，自然归零 9.997s（模型）。
- MIDI79/G5：基频 787.508Hz，起音RMS -23.96dBFS，早期RMS -33.90dBFS，FX后 -27.35dBFS，基音/泛音 25.27dB，自然归零 5.869s（模型）。
- MIDI80/Gs5：基频 834.462Hz，起音RMS -26.08dBFS，早期RMS -35.27dBFS，FX后 -28.92dBFS，基音/泛音 28.55dB，自然归零 5.273s（模型）。
- MIDI84/C6：基频 1046.502Hz，起音RMS -36.84dBFS，早期RMS -46.90dBFS，FX后 -40.53dBFS，基音/泛音 21.47dB，自然归零 4.199s（模型）。
- MIDI88/E6：基频 1326.156Hz，起音RMS -25.00dBFS，早期RMS -36.25dBFS，FX后 -29.61dBFS，基音/泛音 28.26dB，自然归零 2.996s（模型）。
- MIDI91/G6：基频 1581.141Hz，起音RMS -30.13dBFS，早期RMS -41.89dBFS，FX后 -35.19dBFS，基音/泛音 31.33dB，自然归零 2.523s（模型）。

MIDI64→68 早期 RMS 相差 13.18dB；MIDI68→84 相差 23.71dB。这些差异在 FX 前已存在，不能归结为双 DAC 或 FX 的单独故障。FX 的增加/减小也已逐音列出，不能用统一加大总增益修复相对差异。

基频测量没有把最大谱峰当成基音：按 Loader 实际 partial1 DDS 在频谱中定位，以多个谐波/实际 partial 和自相关交叉检查。未可靠测定的项：[]。当前44音测得频率严格递增，分别为44个不同音高；保留AMY原始partial频率的小偏差，表中同时列十二平均律目标、DDS与实测值。

**A / fx_off**：无声音 []；未可靠验证基频 []；单键标志 {}；全音域标志 ['32_note_early_RMS_span_gt_12dB', 'four_semitone_RMS_change_gt_9dB', 'local_RMS_valley_or_peak_gt_6dB']。
相邻音色/响度筛查：没有超过单相邻键阈值的突变；较宽的响度低谷仍存在，不能据此判为均匀。
**B / fx_off**：无声音 []；未可靠验证基频 []；单键标志 {'87': ['early_idle_suppresses_later_very_weak_tail_diagnostic_model'], '88': ['early_idle_suppresses_later_very_weak_tail_diagnostic_model'], '89': ['early_idle_suppresses_later_very_weak_tail_diagnostic_model']}；全音域标志 ['32_note_early_RMS_span_gt_12dB', 'four_semitone_RMS_change_gt_9dB', 'local_RMS_valley_or_peak_gt_6dB']。
相邻音色/响度筛查：没有超过单相邻键阈值的突变；较宽的响度低谷仍存在，不能据此判为均匀。
**A / fx_on**：无声音 []；未可靠验证基频 []；单键标志 {}；全音域标志 ['32_note_early_RMS_span_gt_12dB', 'four_semitone_RMS_change_gt_9dB', 'local_RMS_valley_or_peak_gt_6dB']。
相邻音色/响度筛查：没有超过单相邻键阈值的突变；较宽的响度低谷仍存在，不能据此判为均匀。
**B / fx_on**：无声音 []；未可靠验证基频 []；单键标志 {'87': ['early_idle_suppresses_later_very_weak_tail_diagnostic_model'], '88': ['early_idle_suppresses_later_very_weak_tail_diagnostic_model'], '89': ['early_idle_suppresses_later_very_weak_tail_diagnostic_model']}；全音域标志 ['32_note_early_RMS_span_gt_12dB', 'four_semitone_RMS_change_gt_9dB', 'local_RMS_valley_or_peak_gt_6dB']。
相邻音色/响度筛查：没有超过单相邻键阈值的突变；较宽的响度低谷仍存在，不能据此判为均匀。

音色方面，两方案未触发相邻基音/泛音比或归一化频谱重心的突变阈值，但跨音区谱形差别很大：低音48/56的基音弱于所测泛音带总能量约16dB；方案B的84～91基音/泛音比约21～31dB、频谱重心/f0接近1，主要由基音主导，存在高音偏薄/偏纯的听感风险。这些指标不能代替真人音色评价，也不意味着基音强就是好听。该比例只统计实际partial频带，测量窗100～500ms，不包含全部非谐波噪声。

响度跨度是原幅度PCM能量指标，不是感知响度单位；没有用频率加权或逐音归一化掩盖差异。这里据其筛查明显不平衡风险，最终是否可接受仍须保持统一播放音量的实物/真人A/B听评。

## 衰减和定点归零

44音自然归零范围 2.523～11.620s（模型）。没有不能起音或2秒内整音突然归零的证据，但高音包络/门限的退出行为仍需区分正常衰减与尾段被舍弃。T20/T40为10ms RMS相对峰值最后越过阈值的时刻，QUANTIZATION.csv给出；NOTE_METRICS_44.csv同时给出从RMS峰值算起的衰减时长，不冒称室内声学混响时间。

实际算术为 unsigned18 exp → shift/offset1049 → gate≤1153 → unsigned24 amplitude × signed18 wave → signed45 product → signed48累加 >>>18 → 24bit饱和；Q15主增益32767 >>>15；FX保留其定点状态和限幅。所有44音新的Voice RTL与模型一致。选取48/64/79/84/91的实际内部操作数逐记录核对exp、门限、符号乘法；长按模型记录所有44音的亚LSB乘积、正小和归零、负小和算术右移到−1、最大乘积/累加值及门限样本。

QUANTIZATION.csv 的 sub-LSB 计数不是音符丢失数。单个零交叉、小于1LSB和自然包络结束都可能给零；未发现溢出或错误位宽造成整音立即消失。长期归零主要由现有partial门限和Voice退出条件决定。PT8211丢低8位与PCM5102保留24位的差别也单列；这种量化不解释C6在FX前已出现的20多dB响度落差。

**尾段风险（87～89）**：额外各6秒、NoteOff在6秒才到来的实际Voice RTL，确认这三个音在长按期间自然退出，并与未修改模型逐样本一致。另做诊断模型，只关闭“所有partial暂时门控为0即退出”的动作，其他算术保持相同；直到原退出点的全部输出完全一致，随后出现极弱的后续包络能量：

|MIDI|实际RTL自然归零s|诊断模型首次恢复s|恢复段最大10ms RMS dBFS|
|---:|---:|---:|---:|
|87|3.059167|3.133062|-79.80|
|88|2.995542|3.345458|-78.23|
|89|2.890938|3.929312|-84.94|

这是当前门限/退出策略舍弃后续极弱尾音的证据，不是溢出，也不是实际RTL重新发出了这些尾音。诊断模型不是修复版本，不能用其假想输出替代当前WAV；该风险增加方案B的尾段一致性疑问。恢复能量约−78～−85dBFS，是否听得到需实物/放大对照听评，不能仅凭模型认定明显可闻缺陷。生产RTL未改，见TAIL_REVIVAL_COUNTERFACTUAL.csv、NATURAL_TAIL_RTL.csv。

## 推荐与未完成的验收目标

在两个候选中优先选择 **方案A** 作为下一轮音源调整与实物试听的候选。方案A覆盖较低音区，避免方案B的80～91高音弱区及87～89尾段门限退出风险，当前统一力度响度离散较小。但所有48～91内部的连续32音窗口都包含MIDI64，因此简单平移音域不能绕过其响度低谷；ALL_32_NOTE_WINDOWS.csv也比较了全部13个窗口。

本轮对“当前音源已能生成32个优质不同音高”的结论是**尚未达到验收条件**，不是通过。下一步应针对声源层的跨音区响度/谱包络校准，并复核ROM端点及插值所得音色，保留当前原始WAV作对照，再进行A/B真人听评。此次没有盲目改ROM、按音自动归一化、总增益或包络来掩盖测量结果。硬件接入和同时32Voice触发仍是独立项目。

## 44 音逐音主表

起音为0～100ms、早期为100～500ms；FX后列同一早期窗口；自然归零为模型长按结果。完整88行、两链路的所有字段在CSV。

|MIDI|音名|基频Hz|调音cent|起音RMS dBFS|早期RMS dBFS|Peak dBFS|基音/泛音dB|FX后早期dBFS|自然归零s|
|---:|---|---:|---:|---:|---:|---:|---:|---:|---:|
|48|C3|130.889|1.01|-27.88|-28.87|-18.23|-15.85|-22.14|11.620|
|49|Cs3|138.811|2.74|-28.09|-29.58|-18.63|-12.92|-22.91|10.111|
|50|D3|147.213|4.48|-27.95|-30.13|-18.81|-10.10|-23.29|9.445|
|51|Ds3|156.124|6.22|-27.62|-30.40|-18.68|-7.38|-22.07|9.477|
|52|E3|165.578|8.01|-27.12|-30.35|-18.15|-4.90|-22.59|9.503|
|53|F3|175.195|5.75|-28.10|-31.40|-19.25|-7.51|-23.87|8.600|
|54|Fs3|185.370|3.48|-28.83|-32.14|-20.01|-10.28|-25.25|7.691|
|55|G3|196.135|1.21|-29.41|-32.68|-20.63|-13.16|-25.80|8.221|
|56|Gs3|207.532|-1.01|-29.89|-33.10|-21.19|-16.12|-26.59|10.244|
|57|A3|220.027|0.21|-29.76|-32.98|-20.58|-11.09|-26.34|9.995|
|58|As3|233.281|1.48|-29.06|-32.41|-19.55|-6.07|-25.71|9.747|
|59|B3|247.334|2.75|-26.91|-30.77|-18.09|-1.03|-23.74|9.509|
|60|C4|262.232|4.01|-22.67|-27.45|-15.96|4.02|-20.51|9.256|
|61|Cs4|278.062|5.49|-25.12|-30.04|-18.42|5.19|-23.36|8.835|
|62|D4|294.857|7.01|-27.31|-32.51|-20.85|5.61|-25.62|8.439|
|63|Ds4|312.656|8.48|-29.24|-34.65|-21.87|4.69|-26.18|8.033|
|64|E4|331.539|10.01|-30.58|-36.37|-21.91|2.25|-28.65|7.876|
|65|F4|351.147|9.48|-28.15|-33.65|-20.67|6.33|-26.10|8.212|
|66|Fs4|371.925|9.01|-25.11|-30.38|-19.04|10.09|-23.70|8.812|
|67|G4|393.921|8.48|-21.70|-26.84|-16.71|13.39|-20.06|9.411|
|68|Gs4|417.231|8.01|-18.14|-23.19|-13.01|16.19|-16.74|9.997|
|69|A4|441.719|6.75|-17.81|-23.56|-12.49|18.14|-16.92|10.378|
|70|As4|467.643|5.49|-17.45|-23.86|-12.10|19.80|-17.08|10.748|
|71|B4|495.089|4.22|-17.03|-24.13|-11.70|21.32|-16.46|11.119|
|72|C5|524.161|3.01|-16.63|-24.34|-11.14|22.76|-16.29|11.510|
|73|Cs5|555.651|4.01|-16.88|-25.20|-11.59|21.47|-18.25|11.048|
|74|D5|589.032|5.01|-17.13|-25.98|-12.13|19.97|-19.36|10.717|
|75|Ds5|624.419|6.01|-17.33|-26.72|-12.25|18.32|-20.06|10.316|
|76|E5|661.931|7.01|-17.51|-27.39|-12.19|16.59|-20.87|9.923|
|77|F5|701.377|7.22|-19.68|-29.94|-14.62|19.25|-23.53|7.954|
|78|Fs5|743.196|7.49|-21.84|-32.12|-16.97|22.18|-24.57|6.685|
|79|G5|787.508|7.75|-23.96|-33.90|-18.73|25.27|-27.35|5.869|
|80|Gs5|834.462|8.01|-26.08|-35.27|-20.19|28.55|-28.92|5.273|
|81|A5|883.061|6.01|-29.38|-38.24|-22.16|27.38|-31.27|5.118|
|82|As5|934.490|4.01|-32.28|-41.18|-24.19|25.85|-34.67|4.905|
|83|B5|988.912|2.01|-34.73|-44.06|-24.87|23.91|-37.21|4.621|
|84|C6|1046.502|-0.00|-36.84|-46.90|-25.50|21.47|-40.53|4.199|
|85|Cs6|1110.321|2.48|-34.51|-44.91|-24.10|23.95|-38.59|4.435|
|86|D6|1178.064|5.01|-31.78|-42.48|-22.72|25.81|-36.11|4.695|
|87|Ds6|1249.901|7.49|-28.61|-39.56|-21.33|27.15|-33.09|3.059|
|88|E6|1326.156|10.01|-25.00|-36.25|-19.85|28.26|-29.61|2.996|
|89|F6|1406.206|11.48|-26.79|-38.35|-21.14|28.96|-31.96|2.891|
|90|Fs6|1491.133|13.00|-28.52|-40.21|-22.49|30.03|-33.48|2.744|
|91|G6|1581.141|14.47|-30.13|-41.89|-23.81|31.33|-35.19|2.523|

## 文件与可复现性

- 当前验证：[VALIDATION.json](D:/gaoyun/piano_v2_audio_fix/audit/range44_20261018/VALIDATION.json)；备份：[BEFORE.json](D:/gaoyun/piano_v2_audio_fix/audit/range44_20261018/BEFORE.json)；44音运行结果：[AUDIO_RUN.json](D:/gaoyun/piano_v2_audio_fix/audit/range44_20261018/AUDIO_RUN.json)；实际32Voice直接通路：[DIRECT_CHAIN.json](D:/gaoyun/piano_v2_audio_fix/audit/range44_20261018/DIRECT_CHAIN.json)。
- 图表：[range44_quality.png](D:/gaoyun/piano_v2_audio_fix/tests/range44_20261018/range44_quality.png)、[range44_decay.png](D:/gaoyun/piano_v2_audio_fix/tests/range44_20261018/range44_decay.png)。
- 全部输出：[range44_20261018](D:/gaoyun/piano_v2_audio_fix/tests/range44_20261018)；便携试听包：[range44_listening_pack.zip](D:/gaoyun/piano_v2_audio_fix/tests/range44_20261018/range44_listening_pack.zip)，解压后打开LISTENING_ROOM.html。88个单音WAV，加A/B/全44音以及重点相邻音序列，全部24bit、48kHz、相同满刻度。
- 源码、FFT/HDMI、两路DAC及约束均未改；本轮未重新执行Gowin、原68项回归，不伪称新通过。当前FS哈希 `dfeac5b9684c1c48ac345856b4a2d52fec908b7fd0c751ea8941f35c11fc6392` 与本轮开始快照一致，但开始前就已不同于上一轮BUILD账本。当前process_config也已扩展，生产RTL/约束仍匹配上一轮；不可把上一轮BUILD的PASS转移到现有FS。详见BITSTREAM_PROVENANCE.json；本轮未重验FS或自动烧录。
- 首次沙箱Icarus编译0xC0000005失败及首次FX错误使用SystemVerilog模式的失败日志已保留；沙箱外执行、FX恢复现有Verilog2005模式后通过，无生产RTL修补。
- 复现：`python -X utf8 -B tools/range44_run.py audio`；独立执行`direct`；`range44_analyze.py model`后执行`range44_tail_probe.py`、`range44_tail_rtl.py`；再`range44_analyze.py analyze`，最后`range44_report.py chain`、`report`。历史run目录只用于记录，此次所有44音主WAV均新跑RTL。
