kehanzuishuai/fpga/boards/tang_mega_138k_pro/verification/hall_keys_20261009.md

# Hall校准/滤波与按键力度解释：本轮验证

状态：**PASS**。2026-10-09北京时间15:19:30～15:48:09，统一六suite实际退出码0，耗时1719.141秒；88个src/sim/scripts文件运行前后SHA256一致。完整数据、工作区与规范LF哈希见[机器报告](hall_keys_20261009.json)。旧五suite报告原样保留，不替代本轮结果。

## 已完成的代码

- `src/hall_position_filter.sv`：默认16键各自保存松开/到底校准值与Q4滤波历史，支持读数正向/反向；输出0～4095行程。共享一套24步恢复除法，乘4095用移位减法，无运行时通用除法或乘法器。未校准、span不足64或数据无效时标记无效；重校准释放旧按键状态。
- `src/hall_key_events.sv`：每键独立滞回、连续确认、按下/松开和9档按压速度力度。复位/无效/校准后先松开再允许触发；反压保持待发动作，32bit采集时间模减与慢速锁定避免回绕误判。
- `sim/tb_hall_keys.sv`：串接两模块、随机反压、数据保持断言、配置优先、运算中复位、阻塞待发事件时复位、换算时钟数直接计量。
- `scripts/verify_hall_keys.py`：独立整数黄金模型、边界/随机向量、逐记录行程与动作比对、严格lint、Yosys和非法参数自检。
- `scripts/run_checks.ps1`与`run_regression.py`：新增`-Suite keys`和完整回归第六suite；`.gitignore`排除`sim_out_keys/`，不上传生成向量/日志/仿真中间文件。
- README及[接口说明](../HALL_KEYS_README.md)：说明配置、时间、反压、未来桥接和实物边界。

未修改现有ADC采集、音频、视频RTL或GPRJ/PLL/约束；对上一轮84文件逐一核对，已有文件仅两个回归入口脚本改变。新两模块仍是独立层，尚未接采集存储器、音符FIFO或GPIO，不自动commit/push。

## 新增专项实测结果

| 配置：键数/滤波shift/确认次数 | 行程输出 | 动作事件 | 结果 |
|---|---:|---:|---|
| 1 / 0 / 1 | 8140 | 1780 | PASS |
| 3 / 0 / 2 | 8990 | 593 | PASS |
| 16 / 0 / 1 | 14200 | 1961 | PASS |
| 16 / 1 / 2 | 14242 | 339 | PASS |
| 16 / 2 / 2 | 14242 | 189 | PASS |
| 16 / 4 / 3 | 14284 | 85 | PASS |
| 32 / 2 / 2 | 20706 | 207 | PASS |

共94815条命令、94804条行程输出、5154个动作，与Python黄金模型逐条一致；最终按住位图一致。命令与输出差异来自7条复位和4条非法键号命令，并非丢样本。覆盖全键独立按下/松开、上电按住、快速反复、阈值抖动、velocity九档边界、最小span、正反方向、原始值0/4095、错误记录释放、重校准、时间回绕和随机数据。

输入接受到行程valid被观察到的无反压处理延迟直接测得1～25时钟，即名义50MHz下0.02～0.5µs。**仅是行程计算延迟**，不包含ADC扫描、滤波、确认、事件FIFO、合成或DAC模拟输出，不能证明端到端≤5ms。

14组严格Verilator `--Wall`检查零warning，未使用Wno-fatal或lint_off；Yosys两模块`check -assert`均零问题，无runtime div/mod/mul或锁存器。另4项非法滤波/跨度/阈值/确认参数在time0拒绝。默认通用优化统计分别168和193个cell，不是实际Gowin LUT/DSP数量；共享换算结构减少重复算术，但未做整板厂商资源/时序验收。

## 本次统一六suite结果

工具迁移、ADC、Hall解释、音频质量、完整显示/FFT/TMDS、双DAC均PASS。实际32 Voice仍检出32/32峰，2048个复数/功率bin逐位一致，5644个捕获PCM样本削顶率0%；53,888个音频专项样本零满幅削顶。独立1024/2048/4096点FFT共14,336个bin一致，两幅640×480 TMDS还原图各307,200像素一致，32Voice还原图已检查。双DAC逐bit/频率/对齐、指定模块严格lint和Yosys均通过。

## 下一步与实物事项

下一步才编写采集更新排队适配、键号到音符映射和事件FIFO桥接。ADC错误/过期需显式送入无效记录；不能只看updated脉冲或把stale当可靠断线检测。上游必须遵守ready/valid，模块没有无限缓存。复位将丢弃待发动作，未来需协调合成器复位或全部音符关闭。

硬件回来后配置真实端点，测噪声、滤波/触发位置、速度力度手感与更新率，再测传感器到DAC模拟输出延迟。当前力度是9档速度近似，不是压力测量，24bit格式不代表24bit有效音质。物理HDMI/OSER10、PLL、双DAC模拟输出、ADC供电电平和Gowin布局布线仍未验收；本轮完整指当前板级入口，不含旧根目录RTL全套基线重跑。
