kehanzuishuai/fpga/boards/tang_mega_138k_pro/verification/mcp3208_20261009.md

# 双MCP3208采集与16键数据管理验证

状态：**PASS，离线专项验证**。北京时间2026-10-09 13:03:17～13:05:35，实际执行`scripts/run_checks.ps1 -Suite adc`，exit0。8个新增RTL/测试/检查脚本文件运行前后SHA256一致，见[机器报告](mcp3208_20261009.json)。

## 本轮实现范围

- `src/mcp3208_dual_reader.sv`：双ADC共享SPI模式0时钟/指令/片选，两路DOUT独立接收；24时钟指令/读数帧，结果ready/valid握手、反压保持，两级输入同步和时序余量检查。
- `src/hall_scan_store.sv`：保存每键最新原始12bit值、读到过的标志、更新脉冲、时间戳及饱和年龄计数；数据过期提示；单路null位错误时该路不覆盖旧值。
- `src/hall_adc_scan.sv`：定时循环扫描、默认16键、暂停时完成当前读取、恢复继续、复位清空；完整一轮读取尝试计数。
- 新增模拟ADC和reader/scan/store三套自检TB、`scripts/verify_adc.py`，增加`run_checks.ps1 -Suite adc`和统一完整回归里的ADC suite，忽略生成的`sim_out_adc/`。

详细接口和数据排列见[MCP3208说明](../MCP3208_README.md)。没有校准、滤波、按键判断、力度或声音事件连接；没有修改板级top/GPRJ、PLL、管脚或既有音频/显示RTL。

## 测试结果

| 项目 | 结果 |
|---|---|
| 双ADC逐位读取 | 四配置各165帧，共660帧；两路不同值、12位逐位图案、0/4095及延迟200ns输出PASS |
| SPI时钟直接测量 | 半周期分别25/7/18/50个系统时钟，与向上取整分频一致PASS |
| 循环扫描与每键管理 | 16键两配置各128对、6键48对、2键17对，共321对PASS |
| 顺序/节拍/元数据 | 通道编号、值、更新mask、seen、时间戳、年龄逐拍核对PASS |
| 存储器专项 | stale阈值1/17/257，各10000周期，共30000周期；非法通道、连续更新、单路错误保留、计数饱和、复位PASS |
| 控制与异常 | 接收反压、忙期间请求、读取中途复位、暂停完成当前对/恢复、异常null PASS |
| 参数保护 | 超速扫描、SPI2MHz及不足同步余量三项在Time0明确报错PASS |
| Verilator | 四配置严格`--Wall`，0 warning，无屏蔽 |
| Yosys | 三模块通用check0问题，无运行时div/mod或锁存器 |
| 工具链自检 | 带空格目录迁移、显式工具选择、缺失工具报错PASS |

| 输入时钟 | 目标SPI | 测得SPI分频 | 通道/片 | 每键完整一轮周期 |
|---|---|---|---|---|
| 50MHz | 1MHz | 50周期/bit=1MHz | 8 | 500μs |
| 12.288MHz | 1MHz | 14周期/bit≈877.714kHz | 8 | 500μs |
| 27MHz | 750kHz | 36周期/bit=750kHz | 3 | ≈555.556μs |
| 50MHz | 500kHz | 100周期/bit=500kHz | 1 | 500μs |

默认16键由两块各8通道构成，同编号两个通道并行采集，但不同编号依次采集。500μs是一轮扫描周期，**不是传感器到DAC的总延迟**。如果实际clk是12.288MHz，必须配置CLK_HZ=12288000，不可沿用50MHz默认值。

## 证据边界与注意事项

模拟ADC仅在引脚边沿解析协议，下降沿延迟后输出数据，不取发送器内部状态；不模拟真实模拟电压精度、输入阻抗、磁场和参考电压。当前保守SPI配置仅允许10k～1MHz，并检查舍入后实际时钟下限、同步路径和片选间隔。参数拒绝测试以明确的Time0 FATAL内容验证：本机旧版vvp对`$fatal`也可能返回0，正常测试仍拒绝任何FATAL，不能只凭退出码判通过。

MCP3208没有应答引脚，stale表示数据多久没更新，不是可靠的断线判断。恒定0可能是合法输入，也可能是断线；0/4095不能直接当作错误。32bit时间戳自然回绕，过期判断使用独立饱和计数。

已有音视频RTL和原有仿真逐文件与上轮76文件归档哈希核对一致；仅旧`run_checks.ps1`和`run_regression.py`为增加入口而变更。本轮**未重新执行耗时的音视频完整回归**，也不将上轮四suite PASS当成新增ADC后的五suite PASS。统一入口已包含ADC，下次执行会同时运行所有五suite。

待实物：确认霍尔型号与供电、ADC参考和FPGA Bank电平；选GPIO、布线和去耦；检查磁轴范围/相邻干扰/模拟稳定时间；实际测量数字边沿及各键读数。本轮未commit或push。
