kehanzuishuai/fpga/boards/tang_mega_138k_pro/verification/pcm5102a.md

# PCM5102A focused verification

- tb_pcm5102a: PASS
- tb_dual_dac: PASS
- tb_pcm5102a_synth: PASS
- PT8211 sequential logic unchanged against backup: PASS
- New sender Verilator --Wall, no suppressed warnings: PASS
- New sender Yosys synth -noabc/check -assert (generic, not device mapping): PASS
- Approved three GPIO active constraints: PASS

Nominal input 12.288 MHz; measured BCLK period 4 input cycles (3.072 MHz), LRCLK period 256 input cycles (48 kHz).

Scope: new serial output plus integration with actual E: synth; not a new full-core freeze, PLL lock, Gowin P&R or physical DAC validation.
