kehanzuishuai/fpga/tests/calibration_20261018/LISTENING_ROOM.html

# 44音实测校准 · 48～91

力度100，48kHz/24bit；每音持键2秒、松键1秒。包含真实生产补偿，不再逐WAV归一化。FX前后保持统一数字满刻度。对照序列按每音「修改前→修改后」排列，请固定播放器和系统音量。

推荐优先试听方案A（48～79）。方案B仍有高音偏薄、弱力度偏弱与尾段间隙；客观筛查通过不代表已完成人工音质验收。无自动烧录。

主音频来自真实Voice RTL、补偿RTL和FX RTL的分段组合。实际32Voice连接另有直接MIDI逐样本验证；并非44次完整板级长时仿真或模拟DAC录音。

sequence_all44_fx_off.wav

sequence_A_48_79_fx_off.wav

sequence_B_60_91_fx_off.wav

sequence_all44_fx_on.wav

sequence_A_48_79_fx_on.wav

sequence_B_60_91_fx_on.wav

before_after_pairs_A_48_79_fx_on.wav

before_after_pairs_B_60_91_fx_on.wav

MIDI | 基频Hz | FX后RMS dBFS | FX前 | FX后
48 / C3 | 130.90 | -23.27
49 / Cs3 | 138.79 | -23.33
50 / D3 | 147.21 | -23.16
51 / Ds3 | 156.12 | -21.67
52 / E3 | 165.58 | -22.24
53 / F3 | 175.20 | -22.47
54 / Fs3 | 185.37 | -23.10
55 / G3 | 196.13 | -23.12
56 / Gs3 | 207.54 | -23.50
57 / A3 | 220.03 | -23.36
58 / As3 | 233.28 | -23.30
59 / B3 | 247.35 | -22.97
60 / C4 | 262.23 | -23.06
61 / Cs4 | 278.08 | -23.32
62 / D4 | 294.85 | -23.11
63 / Ds4 | 312.64 | -21.53
64 / E4 | 331.54 | -22.27
65 / F4 | 351.19 | -22.45
66 / Fs4 | 371.93 | -23.33
67 / G4 | 393.92 | -23.22
68 / Gs4 | 417.24 | -23.55
69 / A4 | 441.70 | -23.36
70 / As4 | 467.63 | -23.22
71 / B4 | 495.02 | -22.33
72 / C5 | 524.16 | -21.96
73 / Cs5 | 555.65 | -23.06
74 / D5 | 589.04 | -23.37
75 / Ds5 | 624.38 | -23.34
76 / E5 | 661.92 | -23.48
77 / F5 | 701.36 | -23.59
78 / Fs5 | 743.19 | -22.44
79 / G5 | 787.48 | -23.59
80 / Gs5 | 834.48 | -24.59
81 / A5 | 882.98 | -23.66
82 / As5 | 934.49 | -23.85
83 / B5 | 989.00 | -25.39
84 / C6 | 1046.52 | -28.49
85 / Cs6 | 1110.32 | -27.78
86 / D6 | 1178.05 | -27.33
87 / Ds6 | 1249.90 | -26.42
88 / E6 | 1326.17 | -25.05
89 / F6 | 1406.27 | -25.70
90 / Fs6 | 1491.13 | -25.60
91 / G6 | 1581.01 | -25.72
