kehanzuishuai/fpga/tests/audio_diagnosis/default_stress_events.csv

time | stage | on_or_voice | midi | fifo_level
6684187000 | FIFO | 1 | 60 | 0
6684268000 | ALLOC | 0
13364834000 | FIFO | 0 | 60 | 0
20045481000 | FIFO | 1 | 60 | 0
20045562000 | FIFO | 1 | 61 | 1
20045562000 | ALLOC | 1
20045644000 | FIFO | 1 | 62 | 1
20045725000 | FIFO | 1 | 63 | 2
20045806000 | FIFO | 1 | 64 | 3
20045888000 | FIFO | 1 | 65 | 4
20045969000 | FIFO | 1 | 66 | 5
20046051000 | FIFO | 1 | 67 | 6
20046132000 | FIFO | 1 | 68 | 7
20046213000 | FIFO | 1 | 69 | 8
20046295000 | FIFO | 1 | 70 | 9
20046376000 | FIFO | 1 | 71 | 10
20046457000 | FIFO | 1 | 72 | 11
20046539000 | FIFO | 1 | 73 | 12
20046620000 | FIFO | 1 | 74 | 13
20046702000 | FIFO | 1 | 75 | 14
20247710000 | ALLOC | 2
20449858000 | ALLOC | 3
20652006000 | ALLOC | 4
20854154000 | ALLOC | 5
21056302000 | ALLOC | 6
21258450000 | ALLOC | 7
21460598000 | ALLOC | 8
21662746000 | ALLOC | 9
21864894000 | ALLOC | 10
22067041000 | ALLOC | 11
22269189000 | ALLOC | 12
22471337000 | ALLOC | 13
22673485000 | ALLOC | 14
22875633000 | ALLOC | 15
23077781000 | ALLOC | 16
30066451000 | FIFO | 0 | 60 | 0
30066533000 | FIFO | 0 | 61 | 1
30066614000 | FIFO | 0 | 62 | 1
30066695000 | FIFO | 0 | 63 | 1
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
