kehanzuishuai/fpga/tests/audio_diagnosis/NOTE_METRICS.csv

note | chain | target_hz | dds_partial1_hz | estimated_f0_hz | cent_from_equal_temperament | spectral_minus_dds_cent | f0_reliable | harmonic_support | autocorrelation_hz_integer_lag | autocorrelation_confidence | rms_dbfs_0p1_0p5 | rms_dbfs_attack_0_0p1 | rms_dbfs_held_0p5_1p5 | rms_dbfs_release_2_2p5 | peak_dbfs | peak_integer | onset_ms | attack_10_90_ms | centroid_hz_0p1_0p5 | harmonic_to_fundamental_db | decay_db_per_s_0p2_1p8 | dc_fraction_full_scale | rail_samples | pt8211_nonzero_0p1_0p5 | pt8211_quantization_rms_delta_db
60 | fx_off | 261.6255653005986 | 262.23224401474 | 262.23228343924717 | 4.0101396666504545 | 0.0002602770848161644 | True | 10 | 262.2950819672131 | 0.9935862656762958 | -27.4481060950006 | -22.66533161303174 | -41.3455348400105 | -62.46483087698431 | -15.956882207120247 | 1336121 | 0.0 | 30.0 | 371.280646345655 | -4.020203947169277 | -12.098339293768067 | 4.364738033877479e-06 | 0 | 19189 | 8.03781725267072e-06
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
