kehanzuishuai/fpga/tests/keyboard32_20261019/system_events.csv

time | stage | on | midi | key_index
6684187000 | EVENT | 1 | 60 | 0
6684268000 | EVENT | 1 | 61 | 1
6684350000 | EVENT | 1 | 62 | 2
6684431000 | EVENT | 1 | 63 | 3
6684513000 | EVENT | 1 | 64 | 4
6684594000 | EVENT | 1 | 65 | 5
6684675000 | EVENT | 1 | 66 | 6
6684757000 | EVENT | 1 | 67 | 7
6684838000 | EVENT | 1 | 68 | 8
6684919000 | EVENT | 1 | 69 | 9
6685001000 | EVENT | 1 | 70 | 10
6685082000 | EVENT | 1 | 71 | 11
6685164000 | EVENT | 1 | 72 | 12
6685245000 | EVENT | 1 | 73 | 13
6685326000 | EVENT | 1 | 74 | 14
6685408000 | EVENT | 1 | 75 | 15
6685489000 | EVENT | 1 | 76 | 16
6886498000 | EVENT | 1 | 77 | 17
7088646000 | EVENT | 1 | 78 | 18
7290794000 | EVENT | 1 | 79 | 19
7492941000 | EVENT | 1 | 80 | 20
7695089000 | EVENT | 1 | 81 | 21
7897237000 | EVENT | 1 | 82 | 22
8099385000 | EVENT | 1 | 83 | 23
8301533000 | EVENT | 1 | 84 | 24
8503681000 | EVENT | 1 | 85 | 25
8705829000 | EVENT | 1 | 86 | 26
8907977000 | EVENT | 1 | 87 | 27
9110125000 | EVENT | 1 | 88 | 28
9312273000 | EVENT | 1 | 89 | 29
9514421000 | EVENT | 1 | 90 | 30
9716569000 | EVENT | 1 | 91 | 31
40087422000 | EVENT | 0 | 75 | 15
40087503000 | EVENT | 0 | 76 | 16
40087585000 | EVENT | 0 | 91 | 31
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
