kehanzuishuai/fpga/tests/lissajous_video_20261018/response_44.csv

MIDI | Hz | Y_over_X | Y_gain_dB | phase_deg
48 | 130.8127826502993 | 1.001709214046528 | 0.014833371480643995 | -90.00000000000001
49 | 138.59131548843604 | 1.0019217374336644 | 0.016675980960931324 | -89.99999999999996
50 | 146.8323839587038 | 1.0017578182229157 | 0.015254811419844435 | -89.99999999999993
51 | 155.56349186104046 | 1.0009633099828363 | 0.008363176678788695 | -90.00000000000006
52 | 164.81377845643496 | 0.9995906204791662 | -0.0035565533777856028 | -90.0000000000001
53 | 174.61411571650194 | 0.9980854137844152 | -0.01664582459396181 | -89.99999999999999
54 | 184.9972113558172 | 0.9971660133399969 | -0.024650641681227162 | -90.0
55 | 195.99771799087463 | 0.9974607986425466 | -0.022083271576573978 | -90.00000000000006
56 | 207.65234878997256 | 0.9990284735202636 | -0.008442673588307628 | -90.00000000000006
57 | 220.0 | 1.0010746670223218 | 0.009329427037173106 | -89.99999999999994
58 | 233.08188075904496 | 1.0022341634858636 | 0.01938405195500465 | -90.00000000000009
59 | 246.94165062806206 | 1.0015104984649654 | 0.013110124044830652 | -89.99999999999991
60 | 261.6255653005986 | 0.9993319037036468 | -0.0058049500465308206 | -89.99999999999999
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
