kehanzuishuai/fpga/tests/continuation_20261017/mapping_final/key_chain.csv

raw_bit | midi | scan_frames | mapper_frames | fifo_on | fifo_off | allocations | loader_done | play_edges | active_cycles | pcm_frames | pcm_nonzero | pt_words | hdmi_voices | hdmi_peak | diag_alloc | diag_load | diag_play
0 | 60 | 27 | 27 | 1 | 1 | 1 | 1 | 1 | 1111240 | 4660 | 4325 | 9320 | 1 | 2675935 | 1 | 1 | 1
1 | 61 | 27 | 27 | 1 | 1 | 1 | 1 | 1 | 1111240 | 4660 | 4325 | 9320 | 1 | 1949303 | 1 | 1 | 1
2 | 62 | 27 | 27 | 1 | 1 | 1 | 1 | 1 | 1111240 | 4660 | 4325 | 9320 | 1 | 1567155 | 1 | 1 | 1
3 | 63 | 27 | 27 | 1 | 1 | 1 | 1 | 1 | 1111240 | 4660 | 4325 | 9320 | 1 | 1541202 | 1 | 1 | 1
4 | 64 | 27 | 27 | 1 | 1 | 1 | 1 | 1 | 1111240 | 4660 | 4325 | 9320 | 1 | 1542347 | 1 | 1 | 1
5 | 65 | 27 | 27 | 1 | 1 | 1 | 1 | 1 | 1111240 | 4660 | 4325 | 9320 | 1 | 1811301 | 1 | 1 | 1
6 | 66 | 27 | 27 | 1 | 1 | 1 | 1 | 1 | 1111240 | 4660 | 4325 | 9320 | 1 | 2132346 | 1 | 1 | 1
7 | 67 | 27 | 27 | 1 | 1 | 1 | 1 | 1 | 1111240 | 4660 | 4325 | 9320 | 1 | 2729793 | 1 | 1 | 1
8 | 68 | 27 | 27 | 1 | 1 | 1 | 1 | 1 | 1111240 | 4660 | 4325 | 9320 | 1 | 3965721 | 1 | 1 | 1
9 | 69 | 27 | 27 | 1 | 1 | 1 | 1 | 1 | 1111240 | 4660 | 4325 | 9320 | 1 | 3945580 | 1 | 1 | 1
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
