kehanzuishuai/fpga/tests/calibration_20261018/velocity_raw/midi_048/scan.csv

midi | velocity | raw_peak | raw_peak_time_s | raw_attack_rms_dbfs | raw_early_rms_dbfs | raw_nonzero_samples_1s | raw_rail_samples
48 | 1 | 4214 | 0.022145833333333333 | -72.12497562113656 | -73.20920247125143 | 47951 | 0
48 | 2 | 4643 | 0.022145833333333333 | -71.40107290304017 | -72.46001067639017 | 47955 | 0
48 | 3 | 5104 | 0.022145833333333333 | -70.49314445677338 | -71.72691226066047 | 47964 | 0
48 | 4 | 5597 | 0.022145833333333333 | -69.81162116221856 | -70.98902575165083 | 47968 | 0
48 | 5 | 6150 | 0.016041666666666666 | -69.0709269583289 | -70.27104280261105 | 47976 | 0
48 | 6 | 6713 | 0.016041666666666666 | -68.30000498297096 | -69.54046680957146 | 47977 | 0
48 | 7 | 7317 | 0.016020833333333335 | -67.58901122108982 | -68.80672850921228 | 47977 | 0
48 | 8 | 7967 | 0.016020833333333335 | -66.88146750376629 | -68.1028019063392 | 47980 | 0
48 | 9 | 8697 | 0.016020833333333335 | -66.17372976353255 | -67.37510597696988 | 47981 | 0
48 | 10 | 9449 | 0.016020833333333335 | -65.47252356466575 | -66.68214222218387 | 47981 | 0
48 | 11 | 10259 | 0.022145833333333333 | -64.78514500636923 | -65.99122768717245 | 47983 | 0
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
