kehanzuishuai/fpga/tests/calibration_20261018/velocity_raw/midi_049/scan.csv

midi | velocity | raw_peak | raw_peak_time_s | raw_attack_rms_dbfs | raw_early_rms_dbfs | raw_nonzero_samples_1s | raw_rail_samples
49 | 1 | 4779 | 0.09445833333333334 | -71.29607284898823 | -73.25912866908017 | 38149 | 0
49 | 2 | 5225 | 0.09445833333333334 | -70.5719559898215 | -72.49282569726803 | 41945 | 0
49 | 3 | 5703 | 0.09445833333333334 | -69.80513506164614 | -71.7013260744232 | 45731 | 0
49 | 4 | 6216 | 0.09445833333333334 | -69.07126159865885 | -70.92207451411956 | 47953 | 0
49 | 5 | 6766 | 0.09445833333333334 | -68.35262567289432 | -70.16076258915726 | 47958 | 0
49 | 6 | 7357 | 0.09445833333333334 | -67.63316626774562 | -69.41756665804702 | 47964 | 0
49 | 7 | 7991 | 0.09445833333333334 | -66.91669072157084 | -68.68888484262315 | 47968 | 0
49 | 8 | 8670 | 0.09445833333333334 | -66.22247742575622 | -67.97547040396809 | 47968 | 0
49 | 9 | 9400 | 0.09445833333333334 | -65.52765481819863 | -67.27487197435087 | 47968 | 0
49 | 10 | 10182 | 0.09445833333333334 | -64.84235050966976 | -66.5820383247827 | 47976 | 0
49 | 11 | 11133 | 0.09283333333333334 | -64.15696917934356 | -65.88912910751904 | 47977 | 0
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
