kehanzuishuai/fpga/tests/calibration_20261018/velocity_raw/midi_050/scan.csv

midi | velocity | raw_peak | raw_peak_time_s | raw_attack_rms_dbfs | raw_early_rms_dbfs | raw_nonzero_samples_1s | raw_rail_samples
50 | 1 | 5556 | 0.095875 | -70.37164404547744 | -72.8969300128662 | 29611 | 0
50 | 2 | 6060 | 0.095875 | -69.64130032022182 | -72.09549517886329 | 30636 | 0
50 | 3 | 6600 | 0.095875 | -68.92223467359824 | -71.31575641971043 | 31660 | 0
50 | 4 | 7179 | 0.09585416666666667 | -68.19823604665251 | -70.56132415902623 | 32757 | 0
50 | 5 | 7801 | 0.09585416666666667 | -67.49052775918881 | -69.81541575041301 | 33795 | 0
50 | 6 | 8468 | 0.09585416666666667 | -66.76238744281792 | -69.08357300001495 | 34824 | 0
50 | 7 | 9184 | 0.09585416666666667 | -66.06506483626922 | -68.36817760307088 | 35838 | 0
50 | 8 | 9952 | 0.09585416666666667 | -65.37597884443649 | -67.65806904539326 | 37000 | 0
50 | 9 | 10776 | 0.09585416666666667 | -64.69604679190815 | -66.95653607294317 | 44477 | 0
50 | 10 | 11661 | 0.09585416666666667 | -64.00793124656064 | -66.26333065792626 | 47962 | 0
50 | 11 | 12609 | 0.09585416666666667 | -63.3300804997566 | -65.56735966352782 | 47968 | 0
50 | 12 | 13555 | 0.0958125 | -62.66145480783378 | -64.8757516866292 | 47971 | 0
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
