kehanzuishuai/fpga/tests/calibration_20261018/velocity_raw/midi_051/scan.csv

midi | velocity | raw_peak | raw_peak_time_s | raw_attack_rms_dbfs | raw_early_rms_dbfs | raw_nonzero_samples_1s | raw_rail_samples
51 | 1 | 6491 | 0.1224375 | -69.25879680066943 | -72.2214174005806 | 28052 | 0
51 | 2 | 7065 | 0.1224375 | -68.52246085543936 | -71.4431490780093 | 29949 | 0
51 | 3 | 7681 | 0.1224375 | -67.81456986305784 | -70.68152575567308 | 31850 | 0
51 | 4 | 8341 | 0.1224375 | -67.11035742466402 | -69.92969573288165 | 33762 | 0
51 | 5 | 9050 | 0.1224375 | -66.41022122630773 | -69.19900434195097 | 35733 | 0
51 | 6 | 9810 | 0.1224375 | -65.72072359929982 | -68.47732558877588 | 37598 | 0
51 | 7 | 10626 | 0.1224375 | -65.02613746477108 | -67.76270215051257 | 39389 | 0
51 | 8 | 11500 | 0.1224375 | -64.3486939140534 | -67.05822049376638 | 41171 | 0
51 | 9 | 12439 | 0.1224375 | -63.666184440471596 | -66.35939124313174 | 42952 | 0
51 | 10 | 13447 | 0.1224375 | -62.99691172193076 | -65.66589066444593 | 44730 | 0
51 | 11 | 14459 | 0.109625 | -62.32024904138309 | -64.97201941217948 | 46508 | 0
51 | 12 | 15575 | 0.12239583333333333 | -61.658089086902244 | -64.28632370988184 | 47972 | 0
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
