kehanzuishuai/fpga/tests/calibration_20261018/velocity_raw/midi_052/scan.csv

midi | velocity | raw_peak | raw_peak_time_s | raw_attack_rms_dbfs | raw_early_rms_dbfs | raw_nonzero_samples_1s | raw_rail_samples
52 | 1 | 7816 | 0.1275625 | -68.05627354982535 | -71.20461377543545 | 35766 | 0
52 | 2 | 8488 | 0.1275625 | -67.34851057797611 | -70.441918280392 | 37460 | 0
52 | 3 | 9209 | 0.1275625 | -66.64524720754676 | -69.69315584762148 | 38974 | 0
52 | 4 | 9982 | 0.1275625 | -65.93536955673544 | -68.96299459774869 | 40568 | 0
52 | 5 | 10406 | 0.1275 | -65.24952826928973 | -68.22227530896006 | 42110 | 0
52 | 6 | 11245 | 0.1275 | -64.55183957888006 | -67.50139001671312 | 43637 | 0
52 | 7 | 12143 | 0.1275 | -63.8652993473326 | -66.78463313742446 | 45150 | 0
52 | 8 | 13108 | 0.1275 | -63.17592447705848 | -66.07447036204212 | 46666 | 0
52 | 9 | 14143 | 0.1275 | -62.495533569843815 | -65.37580359483303 | 47963 | 0
52 | 10 | 14765 | 0.12745833333333334 | -61.817282386265475 | -64.66728954032257 | 47965 | 0
52 | 11 | 15941 | 0.12627083333333333 | -61.14936814087642 | -63.97495345875954 | 47963 | 0
52 | 12 | 17263 | 0.12627083333333333 | -60.48996132081647 | -63.2836045080369 | 47961 | 0
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
