kehanzuishuai/fpga/tests/calibration_20261018/velocity_raw/midi_053/scan.csv

midi | velocity | raw_peak | raw_peak_time_s | raw_attack_rms_dbfs | raw_early_rms_dbfs | raw_nonzero_samples_1s | raw_rail_samples
53 | 1 | 5145 | 0.0975625 | -70.71984087151986 | -74.40241643038243 | 29360 | 0
53 | 2 | 5616 | 0.0975625 | -69.96382034278878 | -73.60043899283704 | 31974 | 0
53 | 3 | 6121 | 0.0975625 | -69.23520687554895 | -72.81423172328887 | 34535 | 0
53 | 4 | 6663 | 0.0975625 | -68.51782792473168 | -72.02832350131953 | 37005 | 0
53 | 5 | 7244 | 0.091875 | -67.80853186663887 | -71.26992316642234 | 38892 | 0
53 | 6 | 7869 | 0.0975625 | -67.10832135502474 | -70.52301649159702 | 40777 | 0
53 | 7 | 8538 | 0.0975625 | -66.40181152956464 | -69.7894998741114 | 42657 | 0
53 | 8 | 9257 | 0.0975625 | -65.70297611149483 | -69.06661864369593 | 44534 | 0
53 | 9 | 10027 | 0.0975625 | -65.01896404291696 | -68.34846807544015 | 46412 | 0
53 | 10 | 10854 | 0.0975625 | -64.3396129181765 | -67.6386348151762 | 47971 | 0
53 | 11 | 11742 | 0.0975625 | -63.664077889458994 | -66.93473334100717 | 47973 | 0
53 | 12 | 12693 | 0.0975625 | -62.99595962443868 | -66.23286474138968 | 47974 | 0
53 | 13 | 13715 | 0.0975625 | -62.33218767514981 | -65.53903957968305 | 47976 | 0
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
