kehanzuishuai/fpga/tests/calibration_20261018/velocity_raw/midi_054/scan.csv

midi | velocity | raw_peak | raw_peak_time_s | raw_attack_rms_dbfs | raw_early_rms_dbfs | raw_nonzero_samples_1s | raw_rail_samples
54 | 1 | 3609 | 0.06383333333333334 | -73.28206358309843 | -77.75953255354192 | 19340 | 0
54 | 2 | 3943 | 0.06383333333333334 | -72.53859256668899 | -76.79388794370195 | 20433 | 0
54 | 3 | 4582 | 0.06929166666666667 | -71.73248563515854 | -75.87915212138597 | 24183 | 0
54 | 4 | 5062 | 0.06391666666666666 | -70.93085919859993 | -75.04597632718155 | 27955 | 0
54 | 5 | 5526 | 0.06391666666666666 | -70.20357698486669 | -74.23482219921483 | 31725 | 0
54 | 6 | 6024 | 0.06391666666666666 | -69.46109904182399 | -73.43675819176416 | 35499 | 0
54 | 7 | 6559 | 0.06391666666666666 | -68.74239377591937 | -72.65688581533541 | 38454 | 0
54 | 8 | 7132 | 0.06391666666666666 | -68.03748616650923 | -71.89766456223634 | 40957 | 0
54 | 9 | 7748 | 0.0639375 | -67.33897590917044 | -71.14970290362182 | 43469 | 0
54 | 10 | 8410 | 0.0639375 | -66.63366579930381 | -70.41637436281702 | 45974 | 0
54 | 11 | 9119 | 0.0639375 | -65.93788531423141 | -69.68249753833094 | 47974 | 0
54 | 12 | 9880 | 0.0639375 | -65.2562711567233 | -68.96159857370674 | 47979 | 0
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
