kehanzuishuai/fpga/tests/calibration_20261018/velocity_raw/midi_055/scan.csv

midi | velocity | raw_peak | raw_peak_time_s | raw_attack_rms_dbfs | raw_early_rms_dbfs | raw_nonzero_samples_1s | raw_rail_samples
55 | 1 | 2309 | 0.06410416666666667 | -75.58534076070829 | -81.18732519005692 | 16417 | 0
55 | 2 | 2512 | 0.06283333333333334 | -74.82064143381447 | -80.29660337663222 | 17364 | 0
55 | 3 | 3320 | 0.06535416666666667 | -74.0024406950255 | -79.43266040824176 | 18308 | 0
55 | 4 | 3635 | 0.06535416666666667 | -73.27211173251209 | -78.59276754212114 | 19204 | 0
55 | 5 | 3973 | 0.06535416666666667 | -72.46250432767822 | -77.6719256323391 | 20094 | 0
55 | 6 | 4336 | 0.06535416666666667 | -71.72662116728097 | -76.50832832632292 | 20985 | 0
55 | 7 | 4726 | 0.06535416666666667 | -70.96919650109028 | -75.59934463585653 | 23877 | 0
55 | 8 | 5143 | 0.06535416666666667 | -70.21120059969104 | -74.79439488026001 | 30659 | 0
55 | 9 | 5971 | 0.06539583333333333 | -69.47987407513894 | -73.98298391711096 | 37498 | 0
55 | 10 | 6506 | 0.06541666666666666 | -68.74779946128845 | -73.19941792002332 | 41302 | 0
55 | 11 | 7081 | 0.06541666666666666 | -68.04897936589511 | -72.44677585497645 | 45107 | 0
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
