kehanzuishuai/fpga/tests/calibration_20261018/velocity_raw/midi_056/scan.csv

midi | velocity | raw_peak | raw_peak_time_s | raw_attack_rms_dbfs | raw_early_rms_dbfs | raw_nonzero_samples_1s | raw_rail_samples
56 | 1 | 1860 | 0.049729166666666665 | -77.70297319293834 | -84.46826887571333 | 13355 | 0
56 | 2 | 2034 | 0.049729166666666665 | -76.909815495999 | -83.45170261847039 | 14295 | 0
56 | 3 | 2221 | 0.049729166666666665 | -76.12043976333213 | -82.47880924401274 | 15238 | 0
56 | 4 | 2421 | 0.049729166666666665 | -75.32388545151845 | -81.54325782746476 | 16184 | 0
56 | 5 | 2636 | 0.049729166666666665 | -74.57724967253846 | -80.64126214077308 | 17121 | 0
56 | 6 | 2867 | 0.049729166666666665 | -73.82815607894786 | -79.76519803016465 | 18065 | 0
56 | 7 | 3647 | 0.0665 | -73.05654446673947 | -78.91396324819067 | 19007 | 0
56 | 8 | 3985 | 0.0665 | -72.29718884968149 | -78.08442802519261 | 19946 | 0
56 | 9 | 4350 | 0.0665 | -71.58205408034402 | -77.27199479142291 | 20888 | 0
56 | 10 | 4745 | 0.0665 | -70.83431207237355 | -76.26375089129414 | 21827 | 0
56 | 11 | 5162 | 0.0665 | -70.11477572602436 | -75.35250750300219 | 23465 | 0
56 | 12 | 5613 | 0.0665 | -69.40205294676599 | -74.46464683714701 | 42194 | 0
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
