kehanzuishuai/fpga/tests/calibration_20261018/velocity_raw/midi_057/scan.csv

midi | velocity | raw_peak | raw_peak_time_s | raw_attack_rms_dbfs | raw_early_rms_dbfs | raw_nonzero_samples_1s | raw_rail_samples
57 | 1 | 2032 | 0.06729166666666667 | -79.68598624234156 | -86.99377010746028 | 11240 | 0
57 | 2 | 2254 | 0.06729166666666667 | -78.68236934324257 | -85.81889262462246 | 12221 | 0
57 | 3 | 2493 | 0.06729166666666667 | -77.73691156482138 | -84.34153066745702 | 13318 | 0
57 | 4 | 2749 | 0.06729166666666667 | -76.86461734873303 | -82.47619759567817 | 14460 | 0
57 | 5 | 3022 | 0.06729166666666667 | -75.92864442363462 | -81.13437149006721 | 17910 | 0
57 | 6 | 3318 | 0.06729166666666667 | -75.06603170269668 | -79.98061566007864 | 20567 | 0
57 | 7 | 3633 | 0.06729166666666667 | -74.2709585772032 | -78.90963710959247 | 23061 | 0
57 | 8 | 3972 | 0.06729166666666667 | -73.495735594226 | -77.94843204548162 | 26297 | 0
57 | 9 | 4336 | 0.06729166666666667 | -72.72876446928282 | -77.03797480921872 | 30640 | 0
57 | 10 | 4726 | 0.06729166666666667 | -71.97614190487312 | -76.16238061269364 | 34987 | 0
57 | 11 | 5145 | 0.06729166666666667 | -71.23889445393058 | -75.31094074366212 | 38562 | 0
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
