kehanzuishuai/fpga/tests/calibration_20261018/velocity_raw/midi_058/scan.csv

midi | velocity | raw_peak | raw_peak_time_s | raw_attack_rms_dbfs | raw_early_rms_dbfs | raw_nonzero_samples_1s | raw_rail_samples
58 | 1 | 2570 | 0.06345833333333334 | -76.96620569876575 | -82.5067487715427 | 19101 | 0
58 | 2 | 2829 | 0.06347916666666667 | -76.10765124377221 | -81.31206024811382 | 20975 | 0
58 | 3 | 3108 | 0.06345833333333334 | -75.26075719331392 | -80.2176746653776 | 22853 | 0
58 | 4 | 3407 | 0.06347916666666667 | -74.481462780032 | -79.20748620289498 | 24759 | 0
58 | 5 | 3727 | 0.06347916666666667 | -73.68632045154187 | -78.27996399912973 | 26909 | 0
58 | 6 | 4072 | 0.06347916666666667 | -72.91525141814985 | -77.37801481064126 | 29063 | 0
58 | 7 | 4441 | 0.06347916666666667 | -72.14100033244208 | -76.50382115261878 | 31219 | 0
58 | 8 | 4836 | 0.06347916666666667 | -71.40614816879078 | -75.65784784690025 | 33364 | 0
58 | 9 | 5263 | 0.06347916666666667 | -70.67281480767207 | -74.82437867319223 | 35514 | 0
58 | 10 | 5719 | 0.06347916666666667 | -69.95681733594955 | -73.99992604239306 | 37565 | 0
58 | 11 | 6206 | 0.06347916666666667 | -69.23962084618978 | -73.19082522762534 | 39436 | 0
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
