kehanzuishuai/fpga/tests/calibration_20261018/velocity_raw/midi_059/scan.csv

midi | velocity | raw_peak | raw_peak_time_s | raw_attack_rms_dbfs | raw_early_rms_dbfs | raw_nonzero_samples_1s | raw_rail_samples
59 | 1 | 3987 | 0.0171875 | -71.50118261229923 | -76.94212736526187 | 25670 | 0
59 | 2 | 4382 | 0.06383333333333334 | -70.76063074757394 | -76.10938843611365 | 27101 | 0
59 | 3 | 4767 | 0.06383333333333334 | -70.05598867649206 | -75.31167839647924 | 28531 | 0
59 | 4 | 5180 | 0.06383333333333334 | -69.35357982102452 | -74.53175952701162 | 29963 | 0
59 | 5 | 5625 | 0.06385416666666667 | -68.65023178796963 | -73.77131958198787 | 31393 | 0
59 | 6 | 6098 | 0.06383333333333334 | -67.96166844915463 | -73.01715042798709 | 32820 | 0
59 | 7 | 6612 | 0.06385416666666667 | -67.27851223930533 | -72.26813896306305 | 34253 | 0
59 | 8 | 7161 | 0.06385416666666667 | -66.59364594688567 | -71.52606096866083 | 35684 | 0
59 | 9 | 7745 | 0.06385416666666667 | -65.91509941264466 | -70.79797177657187 | 37100 | 0
59 | 10 | 8382 | 0.06385416666666667 | -65.25813744280092 | -70.07995358309242 | 38473 | 0
59 | 11 | 9060 | 0.06385416666666667 | -64.58417793041284 | -69.34270979861407 | 42646 | 0
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
