kehanzuishuai/fpga/tests/calibration_20261018/velocity_raw/midi_060/scan.csv

midi | velocity | raw_peak | raw_peak_time_s | raw_attack_rms_dbfs | raw_early_rms_dbfs | raw_nonzero_samples_1s | raw_rail_samples
60 | 1 | 7006 | 0.0161875 | -65.6663093668684 | -71.72215719478567 | 29320 | 0
60 | 2 | 7556 | 0.0161875 | -65.00624611401003 | -71.02158696588754 | 30394 | 0
60 | 3 | 8146 | 0.0161875 | -64.34973492733613 | -70.32733593971113 | 31469 | 0
60 | 4 | 8779 | 0.0161875 | -63.682626106039095 | -69.63133760657063 | 32542 | 0
60 | 5 | 9600 | 0.0639375 | -63.02812037176831 | -68.9378818596958 | 33614 | 0
60 | 6 | 10352 | 0.06395833333333334 | -62.376977015078396 | -68.25557460051142 | 34690 | 0
60 | 7 | 11160 | 0.06395833333333334 | -61.72815706036738 | -67.57571365868797 | 41629 | 0
60 | 8 | 12026 | 0.06395833333333334 | -61.08334141990919 | -66.90203818147367 | 47977 | 0
60 | 9 | 12956 | 0.06395833333333334 | -60.44413145964582 | -66.22954654213025 | 47980 | 0
60 | 10 | 13953 | 0.06395833333333334 | -59.804023307618124 | -65.56248948226103 | 47982 | 0
60 | 11 | 15024 | 0.06395833333333334 | -59.16355845896185 | -64.89113431678211 | 47985 | 0
60 | 12 | 16172 | 0.06395833333333334 | -58.527589056695824 | -64.2298665843385 | 47983 | 0
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
