kehanzuishuai/fpga/tests/calibration_20261018/velocity_raw/midi_061/scan.csv

midi | velocity | raw_peak | raw_peak_time_s | raw_attack_rms_dbfs | raw_early_rms_dbfs | raw_nonzero_samples_1s | raw_rail_samples
61 | 1 | 6151 | 0.0170625 | -67.12991795973285 | -73.45367752505706 | 26884 | 0
61 | 2 | 6638 | 0.0170625 | -66.46083934292994 | -72.73414006376969 | 28037 | 0
61 | 3 | 7161 | 0.0170625 | -65.79637555423629 | -72.02314890381179 | 29192 | 0
61 | 4 | 7722 | 0.0170625 | -65.13515203497771 | -71.31938080332435 | 30349 | 0
61 | 5 | 8324 | 0.017125 | -64.4780925673152 | -70.62251872942463 | 31504 | 0
61 | 6 | 8970 | 0.017125 | -63.82457724183003 | -69.93229658983735 | 32659 | 0
61 | 7 | 9664 | 0.017125 | -63.17386104500961 | -69.24763443151951 | 33815 | 0
61 | 8 | 10408 | 0.017125 | -62.52374694622417 | -68.56599435131051 | 34970 | 0
61 | 9 | 11206 | 0.017125 | -61.87378611230163 | -67.88391232624893 | 36126 | 0
61 | 10 | 12063 | 0.017125 | -61.23025438232911 | -67.20081293323284 | 41544 | 0
61 | 11 | 12981 | 0.017125 | -60.588192479854925 | -66.53064125338935 | 47459 | 0
61 | 12 | 13967 | 0.017125 | -59.948791357115795 | -65.85497838106876 | 47986 | 0
61 | 13 | 15138 | 0.017166666666666667 | -59.31539929378444 | -65.17883154859643 | 47979 | 0
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
