kehanzuishuai/fpga/tests/calibration_20261018/velocity_raw/midi_062/scan.csv

midi | velocity | raw_peak | raw_peak_time_s | raw_attack_rms_dbfs | raw_early_rms_dbfs | raw_nonzero_samples_1s | raw_rail_samples
62 | 1 | 5476 | 0.022895833333333334 | -68.58336431359066 | -75.2267631925052 | 24079 | 0
62 | 2 | 5913 | 0.022895833333333334 | -67.9041877385656 | -74.4838096102284 | 25248 | 0
62 | 3 | 6383 | 0.022895833333333334 | -67.23033873069616 | -73.75171791121846 | 26498 | 0
62 | 4 | 6893 | 0.021166666666666667 | -66.56120793291518 | -73.02828230547023 | 27747 | 0
62 | 5 | 7435 | 0.021166666666666667 | -65.89667850195798 | -72.31315147590213 | 28996 | 0
62 | 6 | 8017 | 0.021166666666666667 | -65.23609177732261 | -71.60661189900976 | 30244 | 0
62 | 7 | 8641 | 0.021166666666666667 | -64.57858727402237 | -70.90683658463212 | 31496 | 0
62 | 8 | 9311 | 0.021166666666666667 | -63.92449690942884 | -70.2134175121349 | 32743 | 0
62 | 9 | 10030 | 0.021166666666666667 | -63.27480816653839 | -69.52675120769796 | 33992 | 0
62 | 10 | 10801 | 0.021166666666666667 | -62.6264039828779 | -68.84522726338919 | 35242 | 0
62 | 11 | 11628 | 0.021166666666666667 | -61.982160520146856 | -68.16863963056628 | 36493 | 0
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
