kehanzuishuai/fpga/tests/calibration_20261018/velocity_raw/midi_063/scan.csv

midi | velocity | raw_peak | raw_peak_time_s | raw_attack_rms_dbfs | raw_early_rms_dbfs | raw_nonzero_samples_1s | raw_rail_samples
63 | 1 | 5112 | 0.0231875 | -69.98066682206768 | -77.1026017577963 | 21657 | 0
63 | 2 | 5524 | 0.0231875 | -69.29124634361601 | -76.31022420485144 | 22654 | 0
63 | 3 | 5965 | 0.0231875 | -68.6074339082445 | -75.53197720661925 | 23654 | 0
63 | 4 | 6438 | 0.0231875 | -67.92913909515758 | -74.77812938941457 | 24682 | 0
63 | 5 | 6946 | 0.0231875 | -67.25792319469765 | -74.04161620175041 | 26048 | 0
63 | 6 | 7491 | 0.0231875 | -66.59217723202713 | -73.3144934985989 | 27414 | 0
63 | 7 | 8077 | 0.023208333333333334 | -65.9179870367844 | -72.59620876430156 | 28780 | 0
63 | 8 | 8705 | 0.023208333333333334 | -65.25175109921922 | -71.88630938761554 | 30145 | 0
63 | 9 | 9379 | 0.023208333333333334 | -64.59803415491542 | -71.1836112182304 | 31510 | 0
63 | 10 | 10101 | 0.023208333333333334 | -63.944329934172515 | -70.48771607286203 | 32875 | 0
63 | 11 | 10877 | 0.023208333333333334 | -63.29331915895107 | -69.7983960825699 | 34240 | 0
63 | 12 | 11709 | 0.023208333333333334 | -62.64673373504567 | -69.11460125547785 | 35606 | 0
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
