kehanzuishuai/fpga/tests/calibration_20261018/velocity_raw/midi_064/scan.csv

midi | velocity | raw_peak | raw_peak_time_s | raw_attack_rms_dbfs | raw_early_rms_dbfs | raw_nonzero_samples_1s | raw_rail_samples
64 | 1 | 4769 | 0.023375 | -71.32934642931012 | -79.062460127331 | 19512 | 0
64 | 2 | 5156 | 0.023375 | -70.63627756611314 | -78.22992946848869 | 20453 | 0
64 | 3 | 5570 | 0.023375 | -69.94055676940248 | -77.41544445239255 | 21395 | 0
64 | 4 | 6014 | 0.023375 | -69.23924897887433 | -76.61740556115532 | 22338 | 0
64 | 5 | 6491 | 0.023375 | -68.55503490891866 | -75.8354126526845 | 23277 | 0
64 | 6 | 7003 | 0.023375 | -67.87588514833655 | -75.07052098504774 | 24218 | 0
64 | 7 | 7377 | 0.021875 | -67.1947310414044 | -74.32917679953064 | 25511 | 0
64 | 8 | 7622 | 0.01885416666666667 | -66.52969231646638 | -73.5989023477652 | 27006 | 0
64 | 9 | 8166 | 0.01575 | -65.8552326055057 | -72.87709019924267 | 28508 | 0
64 | 10 | 8612 | 0.024791666666666667 | -65.17206378396848 | -72.16337106812172 | 30010 | 0
64 | 11 | 9250 | 0.024791666666666667 | -64.51099666352735 | -71.45400398085908 | 31509 | 0
64 | 12 | 9935 | 0.024791666666666667 | -63.85136244322283 | -70.75460595999563 | 33009 | 0
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
