kehanzuishuai/fpga/tests/calibration_20261018/velocity_raw/midi_065/scan.csv

midi | velocity | raw_peak | raw_peak_time_s | raw_attack_rms_dbfs | raw_early_rms_dbfs | raw_nonzero_samples_1s | raw_rail_samples
65 | 1 | 5620 | 0.024916666666666667 | -68.8904265243724 | -75.63474668734574 | 23380 | 0
65 | 2 | 6072 | 0.024916666666666667 | -68.21602082520606 | -74.87619097234743 | 24330 | 0
65 | 3 | 6553 | 0.024916666666666667 | -67.54015262210478 | -74.13600229418248 | 25455 | 0
65 | 4 | 7064 | 0.024916666666666667 | -66.86974421712465 | -73.40714430260124 | 26657 | 0
65 | 5 | 7623 | 0.024916666666666667 | -66.2096636416627 | -72.68903761265221 | 27865 | 0
65 | 6 | 8248 | 0.0235 | -65.54351691677198 | -71.97605338591795 | 29063 | 0
65 | 7 | 8891 | 0.0235 | -64.87998909370317 | -71.27204915146126 | 30268 | 0
65 | 8 | 9581 | 0.0235 | -64.22378877070871 | -70.57665644300278 | 31464 | 0
65 | 9 | 10321 | 0.0235 | -63.56589760724444 | -69.88462118189686 | 32674 | 0
65 | 10 | 11115 | 0.0235 | -62.91321174342062 | -69.1998283041611 | 33878 | 0
65 | 11 | 11967 | 0.0235 | -62.269883825366 | -68.52203619866211 | 35066 | 0
65 | 12 | 12881 | 0.0235 | -61.627803603158256 | -67.84631911067974 | 36286 | 0
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
