kehanzuishuai/fpga/tests/calibration_20261018/velocity_raw/midi_066/scan.csv

midi | velocity | raw_peak | raw_peak_time_s | raw_attack_rms_dbfs | raw_early_rms_dbfs | raw_nonzero_samples_1s | raw_rail_samples
66 | 1 | 6986 | 0.03158333333333333 | -66.42331792802108 | -72.51067193405335 | 27388 | 0
66 | 2 | 7534 | 0.03158333333333333 | -65.75575799014648 | -71.80085255759118 | 28390 | 0
66 | 3 | 8122 | 0.03158333333333333 | -65.09910114072011 | -71.09754693822649 | 29392 | 0
66 | 4 | 8752 | 0.03158333333333333 | -64.43895176220856 | -70.40312675859423 | 30395 | 0
66 | 5 | 9429 | 0.03158333333333333 | -63.78695243495747 | -69.71381244344285 | 31396 | 0
66 | 6 | 10155 | 0.03158333333333333 | -63.13642159181248 | -69.0292975069095 | 32398 | 0
66 | 7 | 10920 | 0.03160416666666667 | -62.48504935794308 | -68.35225265440643 | 33400 | 0
66 | 8 | 11755 | 0.03160416666666667 | -61.841511494926905 | -67.67889182761144 | 34404 | 0
66 | 9 | 12650 | 0.03160416666666667 | -61.19920740906652 | -67.00911729974175 | 35407 | 0
66 | 10 | 13610 | 0.03160416666666667 | -60.55987309805594 | -66.3456156498109 | 36411 | 0
66 | 11 | 14640 | 0.03160416666666667 | -59.92053179167214 | -65.68477870220124 | 37072 | 0
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
