kehanzuishuai/fpga/tests/calibration_20261018/velocity_raw/midi_067/scan.csv

midi | velocity | raw_peak | raw_peak_time_s | raw_attack_rms_dbfs | raw_early_rms_dbfs | raw_nonzero_samples_1s | raw_rail_samples
67 | 1 | 8924 | 0.032375 | -63.89198707757824 | -69.52784046158587 | 30491 | 0
67 | 2 | 9612 | 0.032375 | -63.2401722565729 | -68.84573155663648 | 31350 | 0
67 | 3 | 10352 | 0.032375 | -62.593272993619294 | -68.16878813711875 | 32211 | 0
67 | 4 | 11145 | 0.032375 | -61.94518231264145 | -67.4969466890232 | 33070 | 0
67 | 5 | 12007 | 0.032375 | -61.303003927412476 | -66.82921779961396 | 33928 | 0
67 | 6 | 12921 | 0.032375 | -60.66156444767238 | -66.1655752247241 | 34788 | 0
67 | 7 | 13902 | 0.032375 | -60.02521970252708 | -65.50598952642537 | 35646 | 0
67 | 8 | 14955 | 0.032375 | -59.387724477967694 | -64.84958289094601 | 36505 | 0
67 | 9 | 16085 | 0.032375 | -58.750979758553505 | -64.19639390454903 | 37089 | 0
67 | 10 | 17297 | 0.032375 | -58.1149043381949 | -63.54645759915599 | 37466 | 0
67 | 11 | 18597 | 0.032375 | -57.48566134771724 | -62.899001674675304 | 37820 | 0
67 | 12 | 19992 | 0.032375 | -56.856711467358174 | -62.25408049708794 | 38152 | 0
67 | 13 | 21489 | 0.032375 | -56.2260862852809 | -61.61181222332736 | 38465 | 0
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
