kehanzuishuai/fpga/tests/calibration_20261018/velocity_raw/midi_068/scan.csv

midi | velocity | raw_peak | raw_peak_time_s | raw_attack_rms_dbfs | raw_early_rms_dbfs | raw_nonzero_samples_1s | raw_rail_samples
68 | 1 | 11419 | 0.03295833333333333 | -61.360807561109695 | -66.63064074295102 | 32812 | 0
68 | 2 | 12290 | 0.035354166666666666 | -60.71959450156939 | -65.96811744102196 | 33563 | 0
68 | 3 | 13256 | 0.034145833333333334 | -60.080589264844775 | -65.30927731738745 | 34315 | 0
68 | 4 | 14263 | 0.034145833333333334 | -59.44593198694037 | -64.65413328957973 | 35066 | 0
68 | 5 | 15344 | 0.034145833333333334 | -58.807064795575606 | -64.00182925905955 | 35818 | 0
68 | 6 | 16503 | 0.034145833333333334 | -58.175679118284485 | -63.352431887700824 | 36570 | 0
68 | 7 | 17747 | 0.034145833333333334 | -57.54391894471746 | -62.70603213115558 | 37099 | 0
68 | 8 | 19082 | 0.034145833333333334 | -56.91148303900577 | -62.061821192570015 | 37474 | 0
68 | 9 | 20514 | 0.034145833333333334 | -56.28375034093114 | -61.419909182618646 | 37826 | 0
68 | 10 | 22051 | 0.034145833333333334 | -55.6549243513314 | -60.780443893434864 | 38160 | 0
68 | 11 | 23699 | 0.034145833333333334 | -55.027948358661064 | -60.142668594179284 | 38474 | 0
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
