kehanzuishuai/fpga/tests/calibration_20261018/velocity_raw/midi_069/scan.csv

midi | velocity | raw_peak | raw_peak_time_s | raw_attack_rms_dbfs | raw_early_rms_dbfs | raw_nonzero_samples_1s | raw_rail_samples
69 | 1 | 12500 | 0.0515 | -60.70949082316644 | -66.50430224507326 | 33376 | 0
69 | 2 | 13450 | 0.0515 | -60.070471820228946 | -65.84319663375393 | 34316 | 0
69 | 3 | 14469 | 0.0515 | -59.43396433789062 | -65.18407663897233 | 35247 | 0
69 | 4 | 15562 | 0.0515 | -58.79881132014968 | -64.53157119036318 | 36198 | 0
69 | 5 | 16735 | 0.0515 | -58.165333816718345 | -63.880372312806024 | 36988 | 0
69 | 6 | 17994 | 0.0515 | -57.533819631293156 | -63.23046408098993 | 37426 | 0
69 | 7 | 19398 | 0.05489583333333333 | -56.90313801648101 | -62.58641330609223 | 37873 | 0
69 | 8 | 20855 | 0.05489583333333333 | -56.274058890358475 | -61.943071646628304 | 38315 | 0
69 | 9 | 22417 | 0.05489583333333333 | -55.64649050046059 | -61.30045896974848 | 38752 | 0
69 | 10 | 24094 | 0.05489583333333333 | -55.01935313661094 | -60.663137327193695 | 39200 | 0
69 | 11 | 25894 | 0.05489583333333333 | -54.39469356733789 | -60.02605662480412 | 39642 | 0
69 | 12 | 27824 | 0.05489583333333333 | -53.76790008815068 | -59.38925385829837 | 40079 | 0
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
