kehanzuishuai/fpga/tests/calibration_20261018/velocity_raw/midi_070/scan.csv

midi | velocity | raw_peak | raw_peak_time_s | raw_attack_rms_dbfs | raw_early_rms_dbfs | raw_nonzero_samples_1s | raw_rail_samples
70 | 1 | 13679 | 0.0550625 | -60.05365604321473 | -66.37890130499676 | 34219 | 0
70 | 2 | 14715 | 0.0550625 | -59.41714923132635 | -65.71943319666273 | 35469 | 0
70 | 3 | 15826 | 0.04864583333333333 | -58.782207581276246 | -65.06311313194166 | 36725 | 0
70 | 4 | 17019 | 0.0550625 | -58.14867214823928 | -64.40999953797557 | 37526 | 0
70 | 5 | 18341 | 0.04864583333333333 | -57.517079554284074 | -63.76012782075706 | 38281 | 0
70 | 6 | 19720 | 0.04864583333333333 | -56.88683847464165 | -63.112697973625124 | 39035 | 0
70 | 7 | 21200 | 0.04864583333333333 | -56.25792252171617 | -62.46780450064807 | 39787 | 0
70 | 8 | 22787 | 0.04864583333333333 | -55.630155195041795 | -61.82555648302711 | 40541 | 0
70 | 9 | 24490 | 0.04864583333333333 | -55.003402817031635 | -61.18519571467638 | 41294 | 0
70 | 10 | 26318 | 0.04864583333333333 | -54.37769191596246 | -60.54686398219174 | 42049 | 0
70 | 11 | 28278 | 0.04864583333333333 | -53.75311895852954 | -59.91069166647054 | 42802 | 0
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
