kehanzuishuai/fpga/tests/calibration_20261018/velocity_raw/midi_071/scan.csv

midi | velocity | raw_peak | raw_peak_time_s | raw_attack_rms_dbfs | raw_early_rms_dbfs | raw_nonzero_samples_1s | raw_rail_samples
71 | 1 | 14963 | 0.048979166666666664 | -59.39327654476689 | -66.23082550964445 | 36046 | 0
71 | 2 | 16093 | 0.048979166666666664 | -58.75905114339099 | -65.57343801217573 | 38224 | 0
71 | 3 | 17305 | 0.048979166666666664 | -58.1258837924743 | -64.9181227257115 | 40768 | 0
71 | 4 | 18606 | 0.048979166666666664 | -57.49388923126159 | -64.2659367044959 | 43260 | 0
71 | 5 | 20030 | 0.051 | -56.86389600610976 | -63.617796260051485 | 45740 | 0
71 | 6 | 21533 | 0.052 | -56.23456325705612 | -62.9711099537309 | 47984 | 0
71 | 7 | 23143 | 0.052 | -55.60676533356534 | -62.32688349268567 | 47985 | 0
71 | 8 | 24887 | 0.063125 | -54.98068630955456 | -61.68611063887184 | 47985 | 0
71 | 9 | 26744 | 0.063125 | -54.35496726102868 | -61.04628413524665 | 47985 | 0
71 | 10 | 28736 | 0.063125 | -53.73026516652743 | -60.40841188561807 | 47987 | 0
71 | 11 | 30874 | 0.063125 | -53.106970463817184 | -59.77350819638793 | 47987 | 0
71 | 12 | 33168 | 0.063125 | -52.48397259241769 | -59.139169018073005 | 47987 | 0
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
