kehanzuishuai/fpga/tests/calibration_20261018/velocity_raw/midi_072/scan.csv

midi | velocity | raw_peak | raw_peak_time_s | raw_attack_rms_dbfs | raw_early_rms_dbfs | raw_nonzero_samples_1s | raw_rail_samples
72 | 1 | 16366 | 0.049125 | -58.72748656749995 | -66.09950860783823 | 47977 | 0
72 | 2 | 17598 | 0.049125 | -58.09449308766926 | -65.44249237335882 | 47978 | 0
72 | 3 | 18920 | 0.049125 | -57.46365361114027 | -64.78903787005076 | 47980 | 0
72 | 4 | 20351 | 0.049125 | -56.83318477874057 | -64.13825214226058 | 47981 | 0
72 | 5 | 21875 | 0.049125 | -56.20441311760001 | -63.49023579846981 | 47982 | 0
72 | 6 | 23509 | 0.049125 | -55.5777258403038 | -62.84511110623755 | 47984 | 0
72 | 7 | 25263 | 0.049125 | -54.95057410195173 | -62.202042466356914 | 47984 | 0
72 | 8 | 27144 | 0.049125 | -54.325332667436285 | -61.56119088990525 | 47985 | 0
72 | 9 | 29163 | 0.049125 | -53.701311515154764 | -60.92271082831638 | 47985 | 0
72 | 10 | 31330 | 0.049125 | -53.07715224463513 | -60.28581763088126 | 47987 | 0
72 | 11 | 33653 | 0.049125 | -52.45441003557859 | -59.650683561715674 | 47987 | 0
72 | 12 | 36147 | 0.049125 | -51.83310315243066 | -59.01751073596016 | 47987 | 0
72 | 13 | 38822 | 0.049125 | -51.21130656746682 | -58.38555152354967 | 47987 | 0
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
