kehanzuishuai/fpga/tests/calibration_20261018/velocity_raw/midi_073/scan.csv

midi | velocity | raw_peak | raw_peak_time_s | raw_attack_rms_dbfs | raw_early_rms_dbfs | raw_nonzero_samples_1s | raw_rail_samples
73 | 1 | 15420 | 0.04814583333333333 | -59.149262324390165 | -67.13352015315503 | 37825 | 0
73 | 2 | 16583 | 0.04814583333333333 | -58.51472741363973 | -66.47144160910987 | 43892 | 0
73 | 3 | 17831 | 0.04814583333333333 | -57.88186612271947 | -65.81267645224722 | 47980 | 0
73 | 4 | 19183 | 0.04814583333333333 | -57.25089359595951 | -65.15724094725716 | 47981 | 0
73 | 5 | 20621 | 0.04814583333333333 | -56.62076595113466 | -64.50523920039413 | 47982 | 0
73 | 6 | 22164 | 0.04814583333333333 | -55.99237739611047 | -63.85584421085625 | 47982 | 0
73 | 7 | 23820 | 0.04814583333333333 | -55.365379701139325 | -63.209066561824734 | 47984 | 0
73 | 8 | 25596 | 0.04814583333333333 | -54.739113669629596 | -62.56508745890558 | 47986 | 0
73 | 9 | 27502 | 0.04814583333333333 | -54.113868701340095 | -61.92314112852094 | 47987 | 0
73 | 10 | 29547 | 0.04814583333333333 | -53.489830253835564 | -61.28327417237155 | 47987 | 0
73 | 11 | 31741 | 0.04814583333333333 | -52.86641729378666 | -60.64570224194766 | 47987 | 0
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
