kehanzuishuai/fpga/tests/calibration_20261018/velocity_raw/midi_074/scan.csv

midi | velocity | raw_peak | raw_peak_time_s | raw_attack_rms_dbfs | raw_early_rms_dbfs | raw_nonzero_samples_1s | raw_rail_samples
74 | 1 | 14550 | 0.034375 | -59.534699469396976 | -68.14376330667179 | 31590 | 0
74 | 2 | 15652 | 0.034375 | -58.899314862376364 | -67.47569818491763 | 32745 | 0
74 | 3 | 16837 | 0.041166666666666664 | -58.26639878301036 | -66.81185166346293 | 33913 | 0
74 | 4 | 18106 | 0.041166666666666664 | -57.63392125550191 | -66.15174029076019 | 35054 | 0
74 | 5 | 19479 | 0.04795833333333333 | -57.003184347216916 | -65.4949422162524 | 36209 | 0
74 | 6 | 20939 | 0.04795833333333333 | -56.37464998490695 | -64.84149638088448 | 43770 | 0
74 | 7 | 22507 | 0.04795833333333333 | -55.745942077846124 | -64.19103591708955 | 47983 | 0
74 | 8 | 24188 | 0.04795833333333333 | -55.11912788754497 | -63.54317475427501 | 47983 | 0
74 | 9 | 25992 | 0.04795833333333333 | -54.49397971175215 | -62.89801222951078 | 47984 | 0
74 | 10 | 27928 | 0.04795833333333333 | -53.8686016414654 | -62.25523307391903 | 47985 | 0
74 | 11 | 30005 | 0.04795833333333333 | -53.244730771459174 | -61.614503045139784 | 47986 | 0
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
