kehanzuishuai/fpga/tests/calibration_20261018/velocity_raw/midi_075/scan.csv

midi | velocity | raw_peak | raw_peak_time_s | raw_attack_rms_dbfs | raw_early_rms_dbfs | raw_nonzero_samples_1s | raw_rail_samples
75 | 1 | 14558 | 0.030833333333333334 | -59.88063532177271 | -69.07956405927271 | 30490 | 0
75 | 2 | 15661 | 0.030833333333333334 | -59.24458043055901 | -68.40632212332858 | 31350 | 0
75 | 3 | 16844 | 0.030833333333333334 | -58.610267540913334 | -67.7372328163655 | 32208 | 0
75 | 4 | 18114 | 0.030833333333333334 | -57.977460902260844 | -67.07224046830957 | 33067 | 0
75 | 5 | 19477 | 0.030833333333333334 | -57.34601540604751 | -66.41136309898839 | 33926 | 0
75 | 6 | 20939 | 0.030833333333333334 | -56.71625399619635 | -65.75371251438588 | 34786 | 0
75 | 7 | 22507 | 0.030833333333333334 | -56.0875430522603 | -65.09932365845036 | 35646 | 0
75 | 8 | 24190 | 0.030833333333333334 | -55.46035453777226 | -64.44826217642564 | 36504 | 0
75 | 9 | 25996 | 0.030833333333333334 | -54.83408856349985 | -63.79971063033054 | 38475 | 0
75 | 10 | 27933 | 0.030833333333333334 | -54.20898388384346 | -63.15375232425585 | 41205 | 0
75 | 11 | 30012 | 0.030833333333333334 | -53.58479797145143 | -62.51051906806856 | 43937 | 0
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
