kehanzuishuai/fpga/tests/calibration_20261018/velocity_raw/midi_076/scan.csv

midi | velocity | raw_peak | raw_peak_time_s | raw_attack_rms_dbfs | raw_early_rms_dbfs | raw_nonzero_samples_1s | raw_rail_samples
76 | 1 | 14585 | 0.020770833333333332 | -60.21422225783637 | -69.9648515393737 | 29825 | 0
76 | 2 | 15690 | 0.020770833333333332 | -59.57711125728438 | -69.28589660415837 | 30508 | 0
76 | 3 | 16864 | 0.020770833333333332 | -58.94335373269079 | -68.61210097568512 | 31189 | 0
76 | 4 | 18147 | 0.020770833333333332 | -58.30833657624496 | -67.94248837015982 | 31873 | 0
76 | 5 | 19512 | 0.020770833333333332 | -57.67635642282244 | -67.27696566729136 | 32556 | 0
76 | 6 | 20962 | 0.020770833333333332 | -57.04718892970739 | -66.61558058846478 | 33239 | 0
76 | 7 | 22548 | 0.020770833333333332 | -56.416927988514054 | -65.9575095659652 | 33922 | 0
76 | 8 | 24234 | 0.020770833333333332 | -55.789022684947874 | -65.30266345169137 | 34605 | 0
76 | 9 | 26024 | 0.020770833333333332 | -55.16363436984178 | -64.65117083185548 | 35288 | 0
76 | 10 | 27983 | 0.020770833333333332 | -54.5365664945668 | -64.00226370530896 | 35971 | 0
76 | 11 | 30065 | 0.020770833333333332 | -53.911618103724976 | -63.35592009265537 | 36654 | 0
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
