kehanzuishuai/fpga/tests/calibration_20261018/velocity_raw/midi_077/scan.csv

midi | velocity | raw_peak | raw_peak_time_s | raw_attack_rms_dbfs | raw_early_rms_dbfs | raw_nonzero_samples_1s | raw_rail_samples
77 | 1 | 12158 | 0.023875 | -61.796386132431245 | -72.33560875949159 | 29453 | 0
77 | 2 | 13084 | 0.023875 | -61.15451388512522 | -71.63220138424536 | 30054 | 0
77 | 3 | 14078 | 0.023875 | -60.51430590630196 | -70.93532900996809 | 30654 | 0
77 | 4 | 15145 | 0.023875 | -59.87604049710352 | -70.24474040772984 | 31257 | 0
77 | 5 | 16290 | 0.023875 | -59.239887897782715 | -69.56026969226878 | 31858 | 0
77 | 6 | 17518 | 0.023875 | -58.60540529473255 | -68.88083724545308 | 32459 | 0
77 | 7 | 18835 | 0.023875 | -57.972680484621115 | -68.20632964215682 | 33061 | 0
77 | 8 | 20249 | 0.023875 | -57.34173742156806 | -67.53667246750281 | 33662 | 0
77 | 9 | 21766 | 0.023875 | -56.71197838261543 | -66.87096881548096 | 34262 | 0
77 | 10 | 23393 | 0.023875 | -56.08362775235857 | -66.20909958376186 | 34863 | 0
77 | 11 | 25140 | 0.023875 | -55.456526347862656 | -65.55115016944978 | 35463 | 0
77 | 12 | 27013 | 0.023875 | -54.8301590195897 | -64.89624384140144 | 36065 | 0
77 | 13 | 29023 | 0.023875 | -54.2050034589957 | -64.24441238288479 | 36666 | 0
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
