kehanzuishuai/fpga/tests/calibration_20261018/velocity_raw/midi_078/scan.csv

midi | velocity | raw_peak | raw_peak_time_s | raw_attack_rms_dbfs | raw_early_rms_dbfs | raw_nonzero_samples_1s | raw_rail_samples
78 | 1 | 10106 | 0.023875 | -63.371112309557695 | -74.52610747344211 | 29151 | 0
78 | 2 | 10882 | 0.023875 | -62.72258761924814 | -73.79212029087319 | 29687 | 0
78 | 3 | 11713 | 0.023875 | -62.07689724960174 | -73.06757151338397 | 30223 | 0
78 | 4 | 12635 | 0.023875 | -61.43400889564542 | -72.3519897433143 | 30758 | 0
78 | 5 | 13597 | 0.023875 | -60.79264971249428 | -71.64402647736398 | 31294 | 0
78 | 6 | 14628 | 0.023875 | -60.15357078165025 | -70.94334012813496 | 31830 | 0
78 | 7 | 15735 | 0.023875 | -59.51746486204864 | -70.2496360370003 | 32365 | 0
78 | 8 | 16923 | 0.023875 | -58.88209282203584 | -69.56175157028203 | 32902 | 0
78 | 9 | 18197 | 0.023875 | -58.24870776701917 | -68.8795628491001 | 33438 | 0
78 | 10 | 19564 | 0.023875 | -57.61730960887563 | -68.20284309025783 | 33976 | 0
78 | 11 | 21031 | 0.023875 | -56.98681923737898 | -67.53061943378253 | 34511 | 0
78 | 12 | 22605 | 0.023875 | -56.357975116079444 | -66.8628273894408 | 35047 | 0
78 | 13 | 24293 | 0.023875 | -55.7307673173197 | -66.19941212632455 | 37852 | 0
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
