kehanzuishuai/fpga/tests/calibration_20261018/velocity_raw/midi_079/scan.csv

midi | velocity | raw_peak | raw_peak_time_s | raw_attack_rms_dbfs | raw_early_rms_dbfs | raw_nonzero_samples_1s | raw_rail_samples
79 | 1 | 8402 | 0.0238125 | -64.91989017012692 | -76.39844091060445 | 28912 | 0
79 | 2 | 9053 | 0.0238125 | -64.26492721978752 | -75.63274986130797 | 29398 | 0
79 | 3 | 9752 | 0.0238125 | -63.61294792186207 | -74.88139979615745 | 29880 | 0
79 | 4 | 10501 | 0.0238125 | -62.963372951208484 | -74.13757940511492 | 30365 | 0
79 | 5 | 11305 | 0.0238125 | -62.31705331769006 | -73.40580318217619 | 30850 | 0
79 | 6 | 12180 | 0.0238125 | -61.67324670872408 | -72.68520980732855 | 31332 | 0
79 | 7 | 13108 | 0.0238125 | -61.03158036361496 | -71.96966824645915 | 31819 | 0
79 | 8 | 14103 | 0.0238125 | -60.39206924867567 | -71.26359038194424 | 32302 | 0
79 | 9 | 15170 | 0.0238125 | -59.755257681548215 | -70.56653001258523 | 32785 | 0
79 | 10 | 16316 | 0.0238125 | -59.11952286784897 | -69.87259089428113 | 34302 | 0
79 | 11 | 17545 | 0.0238125 | -58.48564304032326 | -69.18633138743766 | 36151 | 0
79 | 12 | 18864 | 0.0238125 | -57.85369681330043 | -68.50740608528763 | 37993 | 0
79 | 13 | 20279 | 0.0238125 | -57.22289300840929 | -67.83021374147586 | 39848 | 0
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
