kehanzuishuai/fpga/tests/calibration_20261018/velocity_raw/midi_080/scan.csv

midi | velocity | raw_peak | raw_peak_time_s | raw_attack_rms_dbfs | raw_early_rms_dbfs | raw_nonzero_samples_1s | raw_rail_samples
80 | 1 | 7877 | 0.008083333333333333 | -66.4369281528919 | -77.98932811148278 | 25648 | 0
80 | 2 | 8474 | 0.008083333333333333 | -65.77334426238599 | -77.17725036243695 | 26903 | 0
80 | 3 | 9129 | 0.008083333333333333 | -65.11411235990681 | -76.38186123509662 | 28157 | 0
80 | 4 | 9832 | 0.008083333333333333 | -64.45800408391845 | -75.60157988948679 | 29409 | 0
80 | 5 | 10586 | 0.008083333333333333 | -63.80549837552547 | -74.83826813690592 | 30467 | 0
80 | 6 | 11395 | 0.008083333333333333 | -63.15592876904469 | -74.096716469555 | 30910 | 0
80 | 7 | 12263 | 0.008083333333333333 | -62.50911180382764 | -73.36537275601538 | 32091 | 0
80 | 8 | 13195 | 0.008083333333333333 | -61.86537870049961 | -72.64359745815153 | 33368 | 0
80 | 9 | 14195 | 0.008083333333333333 | -61.22333460056099 | -71.93012567614706 | 34645 | 0
80 | 10 | 15267 | 0.008083333333333333 | -60.58367502108019 | -71.22439153582852 | 35924 | 0
80 | 11 | 16418 | 0.008083333333333333 | -59.94606657291235 | -70.52610445002105 | 37200 | 0
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
