kehanzuishuai/fpga/tests/calibration_20261018/velocity_raw/midi_081/scan.csv

midi | velocity | raw_peak | raw_peak_time_s | raw_attack_rms_dbfs | raw_early_rms_dbfs | raw_nonzero_samples_1s | raw_rail_samples
81 | 1 | 5611 | 0.0076458333333333335 | -70.05142742647858 | -80.7418325212106 | 23574 | 0
81 | 2 | 6059 | 0.0076458333333333335 | -69.36195502884888 | -79.825488101346 | 25291 | 0
81 | 3 | 6539 | 0.0076458333333333335 | -68.67870236733908 | -78.93452717616536 | 27109 | 0
81 | 4 | 7054 | 0.0076458333333333335 | -68.00090773937146 | -78.06867025349098 | 28929 | 0
81 | 5 | 7606 | 0.0076458333333333335 | -67.32788574331016 | -77.252357625677 | 29889 | 0
81 | 6 | 8199 | 0.0076458333333333335 | -66.65969045895434 | -76.46687637330547 | 30416 | 0
81 | 7 | 8827 | 0.0076458333333333335 | -65.9961466924038 | -75.69491497071289 | 30942 | 0
81 | 8 | 9508 | 0.0076458333333333335 | -65.33589636573637 | -74.9363196357111 | 31471 | 0
81 | 9 | 10240 | 0.0076458333333333335 | -64.67952610320269 | -74.19029158277165 | 32471 | 0
81 | 10 | 11024 | 0.0076458333333333335 | -64.02656829946217 | -73.454075807113 | 34158 | 0
81 | 11 | 11866 | 0.0076458333333333335 | -63.37604178333213 | -72.72798423329404 | 35842 | 0
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
