kehanzuishuai/fpga/tests/calibration_20261018/velocity_raw/midi_082/scan.csv

midi | velocity | raw_peak | raw_peak_time_s | raw_attack_rms_dbfs | raw_early_rms_dbfs | raw_nonzero_samples_1s | raw_rail_samples
82 | 1 | 3966 | 0.005083333333333333 | -73.61770393905685 | -83.85771839240009 | 19875 | 0
82 | 2 | 4297 | 0.005083333333333333 | -72.89081167168924 | -82.75662904198028 | 22063 | 0
82 | 3 | 4649 | 0.005083333333333333 | -72.17361858903695 | -81.71491756676926 | 24251 | 0
82 | 4 | 5023 | 0.005083333333333333 | -71.46534482488494 | -80.58462237241487 | 28367 | 0
82 | 5 | 5431 | 0.005083333333333333 | -70.76356557605105 | -79.7153393175542 | 29023 | 0
82 | 6 | 5866 | 0.005083333333333333 | -70.06917254836787 | -78.86905343353831 | 29678 | 0
82 | 7 | 6327 | 0.005083333333333333 | -69.38185214584358 | -78.0437553557754 | 30331 | 0
82 | 8 | 6832 | 0.005083333333333333 | -68.6992253275671 | -77.2371724194561 | 30985 | 0
82 | 9 | 7368 | 0.005083333333333333 | -68.02239186514038 | -76.44716866630601 | 31639 | 0
82 | 10 | 7938 | 0.005083333333333333 | -67.35104186027701 | -75.67194324604536 | 32292 | 0
82 | 11 | 8561 | 0.005083333333333333 | -66.68256805467234 | -74.91089589182359 | 32946 | 0
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
