kehanzuishuai/fpga/tests/calibration_20261018/velocity_raw/midi_083/scan.csv

midi | velocity | raw_peak | raw_peak_time_s | raw_attack_rms_dbfs | raw_early_rms_dbfs | raw_nonzero_samples_1s | raw_rail_samples
83 | 1 | 2931 | 0.004291666666666667 | -77.20723047002369 | -89.20412803258883 | 7974 | 0
83 | 2 | 3183 | 0.004291666666666667 | -76.42273603194303 | -86.94346947199519 | 13197 | 0
83 | 3 | 3454 | 0.004291666666666667 | -75.6510700217496 | -85.05995087278978 | 18309 | 0
83 | 4 | 3744 | 0.004291666666666667 | -74.89659427289277 | -83.53694483585417 | 23177 | 0
83 | 5 | 4055 | 0.004291666666666667 | -74.15771345671759 | -82.20126813511203 | 27616 | 0
83 | 6 | 4389 | 0.004291666666666667 | -73.42752724657215 | -81.2773188731181 | 28475 | 0
83 | 7 | 4748 | 0.004291666666666667 | -72.70731358804491 | -80.38239385971417 | 29332 | 0
83 | 8 | 5132 | 0.004291666666666667 | -71.99634596760202 | -79.51374050248718 | 30192 | 0
83 | 9 | 5545 | 0.004291666666666667 | -71.29193043282947 | -78.66963894178535 | 31052 | 0
83 | 10 | 5987 | 0.004291666666666667 | -70.5950694481676 | -77.84580820450356 | 31912 | 0
83 | 11 | 6462 | 0.004291666666666667 | -69.90556427764587 | -77.04009852769504 | 32771 | 0
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
