kehanzuishuai/fpga/tests/calibration_20261018/velocity_raw/midi_084/scan.csv

midi | velocity | raw_peak | raw_peak_time_s | raw_attack_rms_dbfs | raw_early_rms_dbfs | raw_nonzero_samples_1s | raw_rail_samples
84 | 1 | 2154 | 0.0121875 | -80.90016282889017 | -91.91260668253655 | 7004 | 0
84 | 2 | 2348 | 0.0121875 | -80.04784888154902 | -90.44753819990672 | 7706 | 0
84 | 3 | 2560 | 0.0121875 | -79.21363295148291 | -89.13852253951916 | 8409 | 0
84 | 4 | 2784 | 0.0121875 | -78.40079873903848 | -87.83180866482796 | 9395 | 0
84 | 5 | 3023 | 0.0121875 | -77.60705362888604 | -86.53700129187911 | 11657 | 0
84 | 6 | 3284 | 0.0121875 | -76.8255546066984 | -84.67107650003128 | 17725 | 0
84 | 7 | 3562 | 0.0121875 | -76.05899303666371 | -82.6870890484928 | 26939 | 0
84 | 8 | 3857 | 0.0121875 | -75.30592578865615 | -81.74533968122886 | 28264 | 0
84 | 9 | 4180 | 0.0121875 | -74.56186171905843 | -80.8355455661882 | 29589 | 0
84 | 10 | 4523 | 0.0121875 | -73.82927564443094 | -79.95439075854591 | 30915 | 0
84 | 11 | 4888 | 0.0121875 | -73.10676633410307 | -79.09720770318758 | 32245 | 0
84 | 12 | 5286 | 0.0121875 | -72.3915131635702 | -78.26328019928474 | 33572 | 0
84 | 13 | 5710 | 0.0121875 | -71.68487876554974 | -77.44845125682335 | 34892 | 0
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
