kehanzuishuai/fpga/tests/calibration_20261018/velocity_raw/midi_085/scan.csv

midi | velocity | raw_peak | raw_peak_time_s | raw_attack_rms_dbfs | raw_early_rms_dbfs | raw_nonzero_samples_1s | raw_rail_samples
85 | 1 | 2392 | 0.015979166666666666 | -80.21374546030047 | -92.3332906763004 | 7077 | 0
85 | 2 | 2605 | 0.015979166666666666 | -79.35641727562928 | -90.8257296897618 | 7802 | 0
85 | 3 | 2833 | 0.015979166666666666 | -78.51848552950068 | -89.4839787494955 | 8525 | 0
85 | 4 | 3079 | 0.015979166666666666 | -77.70255728963987 | -88.24810970559804 | 9275 | 0
85 | 5 | 3341 | 0.015979166666666666 | -76.90363254579248 | -87.09441139560587 | 10050 | 0
85 | 6 | 3623 | 0.015979166666666666 | -76.11955039563891 | -85.42386253518328 | 15107 | 0
85 | 7 | 3925 | 0.015979166666666666 | -75.3534125885856 | -83.74585966297859 | 21209 | 0
85 | 8 | 4250 | 0.015979166666666666 | -74.60417728352488 | -82.21647149341689 | 27951 | 0
85 | 9 | 4598 | 0.015979166666666666 | -73.86544905807193 | -81.29411413018474 | 29155 | 0
85 | 10 | 4972 | 0.015979166666666666 | -73.13788389172524 | -80.39880183518675 | 30361 | 0
85 | 11 | 5372 | 0.015979166666666666 | -72.4192322578329 | -79.53523910671805 | 31569 | 0
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
