kehanzuishuai/fpga/tests/calibration_20261018/velocity_raw/midi_086/scan.csv

midi | velocity | raw_peak | raw_peak_time_s | raw_attack_rms_dbfs | raw_early_rms_dbfs | raw_nonzero_samples_1s | raw_rail_samples
86 | 1 | 2649 | 0.015916666666666666 | -78.89935041012939 | -92.80731140789315 | 7340 | 0
86 | 2 | 2880 | 0.015916666666666666 | -78.0770503095726 | -91.24543007883179 | 7979 | 0
86 | 3 | 3129 | 0.015916666666666666 | -77.27198548467196 | -89.8678681661008 | 8613 | 0
86 | 4 | 3395 | 0.015916666666666666 | -76.48422784745294 | -88.6169979302958 | 9237 | 0
86 | 5 | 3681 | 0.015916666666666666 | -75.71214233126648 | -87.49270082436081 | 9776 | 0
86 | 6 | 3988 | 0.015916666666666666 | -74.95298999917574 | -86.172776843869 | 12494 | 0
86 | 7 | 4317 | 0.015916666666666666 | -74.20614234736959 | -84.45555331371382 | 17991 | 0
86 | 8 | 4670 | 0.015916666666666666 | -73.47059086043035 | -83.10835559438722 | 22408 | 0
86 | 9 | 5049 | 0.015916666666666666 | -72.7443388755725 | -81.90473165838368 | 26589 | 0
86 | 10 | 5455 | 0.015916666666666666 | -72.02741513641541 | -80.85527835232486 | 29691 | 0
86 | 11 | 5892 | 0.015916666666666666 | -71.31905025407977 | -79.97874453513869 | 30850 | 0
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
