kehanzuishuai/fpga/tests/calibration_20261018/velocity_raw/midi_087/scan.csv

midi | velocity | raw_peak | raw_peak_time_s | raw_attack_rms_dbfs | raw_early_rms_dbfs | raw_nonzero_samples_1s | raw_rail_samples
87 | 1 | 2928 | 0.016208333333333335 | -77.27651351927341 | -93.23044152124189 | 6891 | 0
87 | 2 | 3181 | 0.016208333333333335 | -76.48233183807073 | -91.62624096164778 | 7585 | 0
87 | 3 | 3451 | 0.016208333333333335 | -75.7019994872961 | -90.21414509630117 | 8287 | 0
87 | 4 | 3741 | 0.016208333333333335 | -74.94001384648067 | -88.94157129068526 | 8940 | 0
87 | 5 | 4052 | 0.016208333333333335 | -74.1927513478094 | -87.80930343660118 | 9461 | 0
87 | 6 | 4385 | 0.016208333333333335 | -73.4556749803872 | -86.76333198504534 | 10149 | 0
87 | 7 | 4744 | 0.016208333333333335 | -72.72936884918585 | -85.06615223515283 | 15448 | 0
87 | 8 | 5128 | 0.016208333333333335 | -72.01247794204355 | -83.6489111328975 | 19905 | 0
87 | 9 | 5540 | 0.016208333333333335 | -71.30307104304285 | -82.50588523011983 | 23148 | 0
87 | 10 | 5982 | 0.016208333333333335 | -70.60171138745876 | -81.43345417393377 | 26391 | 0
87 | 11 | 6456 | 0.016208333333333335 | -69.90788751810362 | -80.41580180563896 | 29642 | 0
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
