kehanzuishuai/fpga/tests/calibration_20261018/velocity_raw/midi_088/scan.csv

midi | velocity | raw_peak | raw_peak_time_s | raw_attack_rms_dbfs | raw_early_rms_dbfs | raw_nonzero_samples_1s | raw_rail_samples
88 | 1 | 3255 | 0.019416666666666665 | -75.38553428459774 | -93.69554180473352 | 6479 | 0
88 | 2 | 3530 | 0.019416666666666665 | -74.63282999570269 | -92.03180270642919 | 7130 | 0
88 | 3 | 3823 | 0.019416666666666665 | -73.89244232656081 | -90.58123940366676 | 7792 | 0
88 | 4 | 4143 | 0.019416666666666665 | -73.1601790016665 | -89.28212574393245 | 8455 | 0
88 | 5 | 4484 | 0.019416666666666665 | -72.43796470170201 | -88.10934985871597 | 9057 | 0
88 | 6 | 4845 | 0.019416666666666665 | -71.72586644091407 | -87.07122364211381 | 9474 | 0
88 | 7 | 5241 | 0.019416666666666665 | -71.017534953993 | -85.69339402365955 | 12946 | 0
88 | 8 | 5661 | 0.019416666666666665 | -70.31902599751083 | -84.09814861503031 | 18176 | 0
88 | 9 | 6108 | 0.019416666666666665 | -69.62908806481106 | -82.98561549682391 | 20948 | 0
88 | 10 | 6596 | 0.019416666666666665 | -68.94290106664555 | -81.94033671443583 | 23664 | 0
88 | 11 | 7116 | 0.019416666666666665 | -68.26325703756875 | -80.94369208733158 | 26379 | 0
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
