kehanzuishuai/fpga/tests/calibration_20261018/velocity_raw/midi_089/scan.csv

midi | velocity | raw_peak | raw_peak_time_s | raw_attack_rms_dbfs | raw_early_rms_dbfs | raw_nonzero_samples_1s | raw_rail_samples
89 | 1 | 2384 | 0.0161875 | -79.26700598380569 | -438.4737980054314 | 3955 | 0
89 | 2 | 2596 | 0.0161875 | -78.4182587623943 | -438.4737980054314 | 4154 | 0
89 | 3 | 2823 | 0.0161875 | -77.58074562068325 | -438.4737980054314 | 4419 | 0
89 | 4 | 3067 | 0.0161875 | -76.78131330212184 | -103.76066952988816 | 4823 | 0
89 | 5 | 3329 | 0.0161875 | -76.00564968071848 | -99.69580883593692 | 5227 | 0
89 | 6 | 3610 | 0.0161875 | -75.24254183028555 | -97.20219920426517 | 5632 | 0
89 | 7 | 3911 | 0.0161875 | -74.49234346655095 | -94.90923880573276 | 6248 | 0
89 | 8 | 4235 | 0.0161875 | -73.74959727534636 | -92.33457884389716 | 7587 | 0
89 | 9 | 4582 | 0.0161875 | -73.01951961191978 | -90.39238079779821 | 8874 | 0
89 | 10 | 4954 | 0.0161875 | -72.30045628567812 | -89.11879245835492 | 9407 | 0
89 | 11 | 5353 | 0.0161875 | -71.58988493512358 | -88.02865617275465 | 9731 | 0
89 | 12 | 5782 | 0.0161875 | -70.8868124986812 | -86.99876258317202 | 10053 | 0
89 | 13 | 6242 | 0.0161875 | -70.19128364711082 | -85.63576819424267 | 12014 | 0
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
