kehanzuishuai/fpga/tests/calibration_20261018/velocity_raw/midi_090/scan.csv

midi | velocity | raw_peak | raw_peak_time_s | raw_attack_rms_dbfs | raw_early_rms_dbfs | raw_nonzero_samples_1s | raw_rail_samples
90 | 1 | 1709 | 0.016270833333333335 | -83.582442764287 | -438.4737980054314 | 3044 | 0
90 | 2 | 1872 | 0.016270833333333335 | -82.59766945817202 | -438.4737980054314 | 3221 | 0
90 | 3 | 2047 | 0.016270833333333335 | -81.6502655048214 | -438.4737980054314 | 3399 | 0
90 | 4 | 2235 | 0.016270833333333335 | -80.73731135831895 | -438.4737980054314 | 3576 | 0
90 | 5 | 2436 | 0.016270833333333335 | -79.85486653782601 | -438.4737980054314 | 3753 | 0
90 | 6 | 2651 | 0.016270833333333335 | -78.9953147290416 | -438.4737980054314 | 3931 | 0
90 | 7 | 2883 | 0.016270833333333335 | -78.15913358060938 | -438.4737980054314 | 4108 | 0
90 | 8 | 3132 | 0.016270833333333335 | -77.34331771921015 | -438.4737980054314 | 4287 | 0
90 | 9 | 3398 | 0.016270833333333335 | -76.53273264460724 | -438.4737980054314 | 4564 | 0
90 | 10 | 3684 | 0.016270833333333335 | -75.74917221547447 | -106.30599989379766 | 4909 | 0
90 | 11 | 3991 | 0.016270833333333335 | -74.99229454327117 | -101.24898025107368 | 5241 | 0
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
