kehanzuishuai/fpga/tests/calibration_20261018/velocity_raw/midi_091/scan.csv

midi | velocity | raw_peak | raw_peak_time_s | raw_attack_rms_dbfs | raw_early_rms_dbfs | raw_nonzero_samples_1s | raw_rail_samples
91 | 1 | 1202 | 0.015979166666666666 | -89.40777911501652 | -438.4737980054314 | 1053 | 0
91 | 2 | 1328 | 0.015979166666666666 | -88.09044177120613 | -438.4737980054314 | 1265 | 0
91 | 3 | 1463 | 0.015979166666666666 | -86.74853894967404 | -438.4737980054314 | 1598 | 0
91 | 4 | 1608 | 0.015979166666666666 | -85.52572022396402 | -438.4737980054314 | 1933 | 0
91 | 5 | 1763 | 0.015979166666666666 | -83.94986005910039 | -438.4737980054314 | 2913 | 0
91 | 6 | 1930 | 0.015979166666666666 | -82.96177061427544 | -438.4737980054314 | 3076 | 0
91 | 7 | 2108 | 0.015979166666666666 | -82.01438586796307 | -438.4737980054314 | 3238 | 0
91 | 8 | 2300 | 0.015979166666666666 | -81.09828052773693 | -438.4737980054314 | 3400 | 0
91 | 9 | 2506 | 0.015979166666666666 | -80.20706262217443 | -438.4737980054314 | 3590 | 0
91 | 10 | 2727 | 0.015979166666666666 | -79.3352954331732 | -438.4737980054314 | 3806 | 0
91 | 11 | 2964 | 0.015979166666666666 | -78.49649885501445 | -438.4737980054314 | 3977 | 0
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
