kehanzuishuai/fpga/tests/calibration_20261018/AB_BEFORE_AFTER.csv

scheme | low | high | chain | before_early_rms_span_db | after_early_rms_span_db | before_early_rms_std_db | after_early_rms_std_db | max_adjacent_early_rms_db | silent_notes | unreliable_f0 | rail_samples | max_abs_tuning_cents
A | 48 | 79 | fx_off | 13.183681029821141 | 0.13990756879122657 | 3.5454514618018727 | 0.02424594285883584 | 0.13990756879122657 | 0 | 0 | 0 | 10.009162444823604
A | 48 | 79 | fx_on | 12.35233291473899 | 2.0621305633875373 | 3.4674495868513717 | 0.5615405056016493 | 1.5757929787125349 | 0 | 0 | 0 | 10.040454085596247
B | 60 | 91 | fx_off | 23.708315037677824 | 4.856498881308806 | 7.010384173027323 | 1.393230755454467 | 2.627532627193929 | 0 | 0 | 0 | 14.46843241789042
B | 60 | 91 | fx_on | 24.23454706043365 | 6.957616296210386 | 7.155315982653797 | 1.6847343368265586 | 3.101607727765458 | 0 | 0 | 0 | 14.330042516003237
