kehanzuishuai/fpga/tests/calibration_20261018/ADJACENT_COMPARISON.csv

chain | from_midi | to_midi | delta_attack_rms_dbfs_0_100ms | delta_early_rms_dbfs_100_500ms | delta_held_rms_dbfs_500_1500ms | delta_fundamental_to_overtones_db | delta_centroid_over_f0 | measured_frequency_ratio | centroid_normalized_ratio | natural_decay_ratio_model | flags
fx_off | 48 | 49 | 0.4975631608009934 | -2.7327341669547422e-06 | -2.362592221294854 | 2.9261067970131336 | -0.07037718995346731 | 1.0605272128494145 | 0.9725666162666914 | 0.8701705946159156
fx_off | 49 | 50 | 0.6942107232630939 | -0.00022278549105791967 | -1.990247589475338 | 2.8268556624383443 | -0.06262215568991758 | 1.0605293897342576 | 0.9749010177391172 | 0.9340691718417116
fx_off | 50 | 51 | 0.6051427073214732 | 0.00029153778838875155 | -1.3559922075880664 | 2.7187212703490307 | -0.04958010051881079 | 1.0605269713282879 | 0.9796166774363264 | 1.003374928034623
fx_off | 51 | 52 | 0.4434920912877054 | -0.0007841378887150086 | -0.5025795949361012 | 2.4820575526851174 | 0.002108706624863732 | 1.0605580478074579 | 1.0008849679989114 | 1.0027941865092014
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
