kehanzuishuai/fpga/tests/calibration_20261018/ALL_32_NOTE_WINDOWS.csv

low | high | fx_off_early_rms_std_db | fx_off_early_rms_span_db | fx_off_flagged_seams | fx_off_max_adjacent_early_rms_db | fx_on_early_rms_std_db | fx_on_early_rms_span_db | fx_on_flagged_seams | fx_on_max_adjacent_early_rms_db
48 | 79 | 0.02424594285883584 | 0.13990756879122657 | 0 | 0.13990756879122657 | 0.5615405056016493 | 2.0621305633875373 | 0 | 1.5757929787125349
49 | 80 | 0.16599700642674314 | 0.9489320383600486 | 0 | 0.809024469568822 | 0.6268631663809857 | 3.062508062729819 | 0 | 1.5757929787125349
50 | 81 | 0.1950887158091344 | 0.9489320383600486 | 0 | 0.809024469568822 | 0.6345710638131538 | 3.062508062729819 | 0 | 1.5757929787125349
51 | 82 | 0.2021971703793455 | 0.9489320383600486 | 0 | 0.809024469568822 | 0.650543315503984 | 3.062508062729819 | 0 | 1.5757929787125349
52 | 83 | 0.42679416928001224 | 2.2289662541148765 | 0 | 1.8626297202252076 | 0.7223032673659074 | 3.8560085684449277 | 0 | 1.5757929787125349
53 | 84 | 0.9247336067940416 | 4.856498881308806 | 0 | 2.627532627193929 | 1.1593295541010247 | 6.957616296210386 | 0 | 3.101607727765458
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
