kehanzuishuai/fpga/tests/calibration_20261018/BEFORE_AFTER_88.csv

midi | chain | before_early_rms_dbfs_100_500ms | before_attack_rms_dbfs_0_100ms | before_peak_dbfs | before_fundamental_to_overtones_db | after_early_rms_dbfs_100_500ms | after_attack_rms_dbfs_0_100ms | after_peak_dbfs | after_fundamental_to_overtones_db | early_rms_change_db | partial_balance_change_db | rail_samples
48 | fx_off | -28.866884871706926 | -27.87646334776316 | -18.22944184257579 | -15.848755785807633 | -30.000105910382786 | -29.009684132235453 | -19.36265974099547 | -15.84875548356597 | -1.1332210386758597 | 3.0224166280845566e-07 | 0
48 | fx_on | -22.141345752992 | -21.038675918740715 | -11.159400831492343 | -15.489526466141225 | -23.274602814077344 | -22.17189297816204 | -12.292600243324944 | -15.489644833283462 | -1.1332570610853452 | -0.00011836714223711908 | 0
49 | fx_off | -29.57531512013212 | -28.08732742200714 | -18.626253969759365 | -12.922648089004811 | -30.000108643116953 | -28.51212097143446 | -19.05104685037133 | -12.922648686552836 | -0.42479352298483164 | -5.975480252828902e-07 | 0
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
