kehanzuishuai/fpga/tests/calibration_20261018/ENVELOPES_10MS.csv

midi | chain | start_s | rms_dbfs
48 | fx_off | 0.0 | -38.2999501200077
48 | fx_off | 0.01 | -31.203506238592343
48 | fx_off | 0.02 | -29.03474130276631
48 | fx_off | 0.03 | -27.367592206166375
48 | fx_off | 0.04 | -29.328573300381304
48 | fx_off | 0.05 | -29.210143070547282
48 | fx_off | 0.06 | -27.435880387764648
48 | fx_off | 0.07 | -28.84317189829753
48 | fx_off | 0.08 | -28.95908541722686
48 | fx_off | 0.09 | -27.38577895181185
48 | fx_off | 0.1 | -27.9875878401695
48 | fx_off | 0.11 | -28.82153779311995
48 | fx_off | 0.12 | -27.740279053768443
48 | fx_off | 0.13 | -28.38559454313717
48 | fx_off | 0.14 | -29.09720299615381
48 | fx_off | 0.15 | -28.531043669965904
48 | fx_off | 0.16 | -28.49424308829951
48 | fx_off | 0.17 | -29.63921494989509
48 | fx_off | 0.18 | -29.969529283241588
48 | fx_off | 0.19 | -28.204261125322407
48 | fx_off | 0.2 | -29.8055506823694
48 | fx_off | 0.21 | -30.204718942927666
48 | fx_off | 0.22 | -28.839248724676153
48 | fx_off | 0.23 | -29.443606391651382
48 | fx_off | 0.24 | -30.20967328656271
48 | fx_off | 0.25 | -29.28033698589128
48 | fx_off | 0.26 | -29.538365238610062
48 | fx_off | 0.27 | -30.328380959677936
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
