kehanzuishuai/fpga/tests/calibration_20261018/FOUR_SEMITONE_COMPARISON.csv

scheme | chain | from_midi | to_midi | early_rms_change_db | fundamental_overtones_change_db | normalized_centroid_ratio | flag
A | fx_off | 48 | 52 | -0.0007181183255511314 | 10.953741282485627 | 0.9296515951598078 | False
A | fx_off | 49 | 53 | -0.00051073197471041 | 5.415472947430569 | 0.9377014246340896 | False
A | fx_off | 50 | 54 | -0.00012194466247095193 | -0.17933559881726424 | 0.9512798567366599 | False
A | fx_off | 51 | 55 | -0.0006288104699017083 | -5.784265647897213 | 0.9647974156777859 | False
A | fx_off | 52 | 56 | 0.00017372887298705564 | -11.22761785084807 | 0.9612440074170622 | False
A | fx_off | 53 | 57 | 0.0002785765532458129 | -3.5806206729765666 | 0.9571439860024807 | False
A | fx_off | 54 | 58 | 0.000334722222582684 | 4.208497161086392 | 0.9034280878180553 | False
A | fx_off | 55 | 59 | 0.0003421420386970908 | 12.126869969408702 | 0.776201441730182 | False
A | fx_off | 56 | 60 | -0.00011865314915127101 | 20.142835776894724 | 0.6176035195194809 | False
A | fx_off | 57 | 61 | -7.229094538985237e-05 | 16.274328647030526 | 0.6119120368441471 | False
A | fx_off | 58 | 62 | -0.0005484836435911689 | 11.677839093233445 | 0.6619300901139791 | False
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
