kehanzuishuai/fpga/docs/ROUTING_FIX_20261023.md

# 2026-10-23布线修复

结论：**NOT_TIMING_CLOSED_NOT_PROGRAMMED**。主工程仍为`D:\gaoyun\piano_v2_audio_fix\yinyue_fashengqi.gprj`，未烧录、未推送。源码、网表和本候选实现产物均已核对哈希并放回主目录。候选`followup_hybrid_axis_clear_p3_r0`；旧实现备份`audit/routing_followup_20261022/root_before_followup_hybrid_axis_clear_p3_r0_20261023_154039`。

## 修改和验收

- 显示琴键光效原长路径的减法前移到已有前一级，比较使用有效范围内8位数。画面、颜色和40拍流水不变，512组场景像素及14,880组有效距离算术一致。
- 依照第一版315块RAM整机综合指出的长路径，再将波形绝对值/符号恢复改为保留分组边界的前缀逻辑，面板/13与/5拆到已有两拍。全部2048和1024个除法输入、131072个16位符号恢复和131126个27位取负案例通过；场景512像素一致；renderer除两条表达式及组合助手外的顺序结构按字节核对，总延迟不变。
- 辅助音色吉他延迟线的低18位各自存储，两声部高6位使用一块2048x9真双口RAM的独立半区。不减24位精度、不加周期、不减少32个逻辑声部。独立综合每对由4块变3块；逐拍KS对照19,083周期通过；32声部四音色整库24,672周期PCM/控制/显示音符一致；实际三BSRAM网表6,826次读对照通过。
- 字形查找将233项宽比较表改为4096x8同步索引和256x41描述符，保留完整24位键比对以拒绝散列冲突。原覆盖图不变，655,360个键和90区域2,912个像素/字符一致；标签仍为21拍。新增两个HEX文件在assets内；单模块综合105.848MHz仅作诊断，不代表整机时序。
- HDMI复位前两级寄存器补齐PTR3附近位置约束；没有改管脚、时钟频率、相位或增加时序豁免。该约束的小型诊断通过，但V1整机网表的对照仍420条未布通，不能单凭它宣称已解决布线。
- 固定圆角的几何和查表判定拆到已有13/14级；600,084组边界/圆角和512个像素一致，场景仍40拍。数字位选择限定0～4位，替代宽整数位移；655,360组数字/去零比较及90区域2,912个像素一致，标签仍21拍。
- 按真实布线STA改写背景地址的行/列商余数合成，保留背景6拍及原始ROM纹素；8分区全部纹素和16,000次插值采样一致。
- V6按真实STA将固定文字查找前移到已有属性寄存器拍；32键标签提前选择一个7位音高。11,560拍、90区域、全部32键索引与V5像素/字符/音高一致，标签仍21拍。
- V6将频谱峰值比较与Hz换算分到已有COPY末拍和SCAN准备拍，并提前计算两个范围候选。12次FFT快照、6,144根频谱柱及发布握手一致；未增加扫描周期，Hz在发布前的准备拍更新。
- V7采用混合延迟存储：renderer保留寄存器保护，场景和标签其他长链恢复紧凑存储，场景声部状态位50～81单独使用寄存器。40级全部状态字段及512个像素与V6一致，仍40拍。V6全显示寄存器版曾因CLS达65,222/69,120和353条未布通被放弃，不能把它当成已通过版本。
- V7坐标轴BCD提前到已有属性拍；11,560拍标签对照通过，仍21拍。XY清屏终止提前一拍预测，131,222拍控制/地址对照和两次65,536地址完整清屏、复位重启通过，清屏和COPY周期不变。
- SDC恢复原基线，保留0.150ns Hold不确定度；没有降低时钟频率或豁免新增数据路径。键名小表与原电路映射相同、并行字符选择树映射更差，两项候选均未采用。
- 物理钢琴源、音符事件、音源ROM参数、FFT、HDMI串行输出和时钟RTL、双DAC、GAO配置与手机UI文件保持本轮开始时的哈希；声部数不变。没有仅凭非零PCM判断音质。
- 两组原网表控制与被停止的中间综合均保留收据；人工停止不计为工具实现失败。内存达到93%时停止过渡综合，之后最多两组大构建。

## 实际结果

综合资源原始数据：`{"name": "tang_mega_138k_pro_top", "Register": "80", "Alu": "14", "Lut": "268", "T_Register": "52808(80)", "T_Alu": "24368(14)", "T_Lut": "90041(268)", "T_MULTALU27X18": "152(0)", "T_MULT12X12": "60(0)", "T_MULT27X36": "35(0)", "T_Bsram": "317(0)", "T_Ssram": "286(0)"}`。

实际布局资源与剩余：`{"Logic": {"used": 116839, "total": 138240, "remaining": 21401}, "Register": {"used": 52808, "total": 139140, "remaining": 86332}, "CLS": {"used": 64176, "total": 69120, "remaining": 4944}, "BSRAM": {"used": 317, "total": 340, "remaining": 23}, "DSP": {"used": 252, "total": 298, "remaining": 46}}`。

实现状态：`IMPLEMENTATION_FAILED`；错误：`['ERROR  (PR0004) : There are total 818 unrouted nets']`。

五类STA最差裕量(ns)：`{}`；Setup/Hold违例端点：`{}`。空表表示没有新报告，不是0违例。PR0004即使计数0仍视为失败。

实际完整输入、网表、FS和报告SHA256及运行选项见`audit/routing_followup_20261022/FINAL.json`，原始日志见`audit/autonomous_timing_20261022_154006/runs/followup_hybrid_axis_clear_p3_r0/`。`release/latest`没有更新，不能把旧基线当作新版本。

小型P16真实管脚时钟诊断和加入相同GAO配置的计数器诊断只用于定位，不替代整机。第一份小型诊断漏提取额外空格管脚行的问题已纠正；见`DIAGNOSTIC_CORRECTION.json`。00:07至08:00的系统待机中断不算持续计算时间，见PROGRESS.md。
