kehanzuishuai/fpga/docs/LISSAJOUS_VIDEO_FIX_20261018.md

# 李萨如图检查与修复（2026-10-18）

输入视频：`67d390becf9b1005fe8610f6b62cd805.mp4`。视频中的钢琴泛音会形成多圈、不对称以及随衰减变化的轨迹，不能把“必须是圆”当作钢琴PCM的验收标准。不过原63抽头Hilbert滤波器确有低频幅值错误：C4的正交Y幅值只有匹配延迟X的0.3556倍（−8.98dB），会明显压扁轨迹；C3仅0.1819倍。

生产修复在 `src/display/visual_xy_source.sv`：改为1023抽头、4路并行MAC，实部延迟511个采样匹配虚部；每个采样130个音频时钟完成，低于48kHz采样间隔的256个时钟。预热1024采样约21.3ms，群延迟约10.65ms，仅作用于显示。保留同一PCM来源、同一增益、两轴共同缩放，没有独立拉伸成圆，也没有改音源、音高表或双DAC。

已有验证：

- 9217个实际RTL输出对与独立整数卷积逐样本完全一致；覆盖纯音、直通模式、复位及强制过载检测。
- C4实际RTL拟合Y/X=0.99933，相位差−90.000°；C3、A4、G6同样通过幅相检查。
- MIDI48～91共44个音的显示滤波频响逐音测量，Y/X范围0.997166～1.002234，幅值误差−0.02465～+0.01938dB（均小于0.03dB），详见 `tests/lissajous_video_20261018/response_44.csv`。这些是显示链路指标，不代表44音音源的音质评级。
- 显示升级9组回归通过；16键指示保持当前MIDI60～75，与32 Voice复音数分开。
- 实际RTL合成输入画面：`tests/display_upgrade_20261018/preview_1080p30_16keys.png`，不是板上截图。
- 修复前后同尺度曲线对比：`tests/lissajous_video_20261018/hilbert_before_after.png`，由实际整数系数计算，上行为C4纯音，下行为既有C4钢琴PCM，属于工程模型图。真实钢琴的多圈轮廓在修复后仍然保留。

最终综合、布局布线、五类时序、120ms声音保持性及实际综合网表Hilbert比较均通过。FS SHA256：`fe3a994356854fe3d51d541a655b411d7adc426eb3d703a4e0d67ab94a16edd2`。完整结果见 `docs/DISPLAY_UPGRADE_16KEY_20261018.md`。未自动烧录。上板后应以纯正弦接近圆/椭圆、真实钢琴保留泛音轮廓为判据，并逐键检查16个指示；不能用麦克风录音直接推定每个内部X/Y采样值。
