kehanzuishuai/fpga/docs/NATURAL_TAIL_FIX_20261018.md

# 临时静音提前退出：已修复

尾音定向/44音/6秒RTL证据在audit/tail_fix_20261018和tests/tail_fix_20261018。最终交付已合并44音响度补偿，完整结果、68项及新Gowin产物请看docs/NOTE_GAIN_CALIBRATION_20261018.md。禁止自动烧录。
