kehanzuishuai/fpga/docs/RECORDING_SYNTHESIS_FIX_20261018.md

# 逐键录音：后综合插值故障定位及修复

更新时间：2026-10-18T15:44:22.357894+08:00。工程：`D:\gaoyun\piano_v2_audio_fix`。**实际根因已确认、生产RTL已修复、新综合/布局布线/时序通过；没有自动烧录。修复后实物演奏验收仍待进行。**

用户已确认：录音使用上一份SHA256为9689bf3b…的FS，从实体左到右独立逐键按下。录音原件已按原始字节保存于`tests/recording_20261018_150135/original.m4a`，只在工程内解码、测量；原微信文件未改。

## 根因与录音证据

**piano_note_loader中的音高插值在Gowin 1.9.12综合后发生错误。** RTL正确地对无符号ROM字先补0、再相减，随后乘音高位置ap；综合器把减法和乘法折叠到DSP预加器时，将D端高位错误地接成VCC。

- level差值应补0，实际高位补1，相当于多出4096；乘ap并右移2后，衰减码每一个ap多1024，即约24.08dB。
- partial ratio差值实际多出2^20，右移2后每一个ap多2^18；除Q15比例，相当于每个partial多出8×基准音高。
- ap=0（MIDI60/64/68/72）不受此错误影响；ap=1发出强烈高频音，ap=2/3衰减进一步增大并可能完全门控为0。这解释了交替出现的钢琴声、铃声、无声。

在实际旧完整综合网表中原样提取的DSP实例上，用高云GW5A原语仿真复现：ratio差−16、ap=1，应得到−4，实际262140；level差−100应得到−25，实际999。不是凭录音主观猜测，也不是只在Python中造一个故障模型。

|录音时间s|对应音符的证据|正确第一partial Hz|旧网表第一partial Hz|录音测得Hz|
|---|---|---:|---:|---:|
|1.02～1.47|MIDI60频谱匹配|262.232|262.232|262.221|
|3.98～4.40|MIDI61频谱匹配|278.062|2495.523|2495.566|
|10.12～10.55|MIDI64频谱匹配|331.539|331.539|331.586|
|13.05～13.47|MIDI65频谱匹配|351.147|3144.972|3144.956|
|19.42～19.85|MIDI68频谱匹配|417.231|417.231|417.244|
|22.61～23.03|MIDI69频谱匹配|441.719|3961.719|3961.728|
|28.55～28.96|MIDI72频谱匹配|524.161|524.161|524.212|
|31.02～31.44|MIDI73频谱匹配|555.651|4990.573|4990.672|

上述8次清晰发声的窄带谱线，与旧综合网表预测最大相差仅0.099Hz。MIDI61/65/69/73应有的低频第一partial在录音中比错误高频线弱约43～62dB。不能把2495Hz直接当作“误映射到了某个高MIDI音符”：旧网表把整个partial组的频率关系算错了。

旧综合网表参数送入已逐样本核对的整数Voice模型后，MIDI63,67,71,75全段精确静音，其余若干音明显衰弱。该重建是模型，不冒充板上采样。录音中的静音段本身无法证明某次按键的原始bit编号或精准按下时刻，最后四键和实体位序仍应在新FS板上逐键确认。约34秒还有一次E4类发声，未把它强行解释成连续音阶中的指定末键。

这也给之前VOICE/PEAK为0提供了可复现的解释：这些错误参数即使已收到NoteOn并装载成功，仍会使PCM全零。SILENT_VOICE_EXIT_MODEL.json逐采样重放确认上述4音都在装载后的385个采样（8.021ms）退出；这是实际旧后综合参数驱动整数Voice模型的结果，不冒充板上计数采集。因此界面看到0不能单独证明按键事件没有进入音源。新FS是否每个实体键都收到事件，仍需板上逐键核对。

## 实际修改与验证

唯一生产改动：`src/piano_note_loader.v`。使用ap=0/1/2/3/4的明确移位/加法替代三处乘法，避开错误的DSP预加器合并；保留原插值数值、ROM、音阶参数、包络和时序状态机。没有用调大音量或改成铃声音色掩盖问题。该文件原本就在`yinyue_fashengqi.gprj`中enable=1，本轮实际重新编译了它；不需要重复新增工程条目。启用文件仍64项。

- 旧**实际完整工程**后综合网表Loader+ROM，16音6400字，与原正确模型比较3690字错误，网格音保持正确。
- 新**实际完整工程**同样提取Loader+ROM并使用GW5A原语，16音6400字，0字错误。此夹具绕过键盘/分配器，只强制已捕获的请求音符/基准增量并提供真实含义的Ready/状态译码，没有强制插值结果；具体边界见verify_loader.py。不是全芯片后仿真。
- 独立小工程保留全部pitch/velocity输入位，真实Gowin综合后不作force，MIDI48～91×力度1/40/80/100/127，共88000字，0错误。这是独立Loader综合，不冒充当前只可由键盘触发60～75的优化顶层覆盖全部44音。
- 新RTL的原21项短Voice回归全部通过：力度、边界音、释放、加载期NoteOff、重触发/偷音、逐样本整数模型一致，每采样最多210clk/256，无overrun。**没有把上一轮68项结果冒充本轮重新跑过68项。**
- 当前真实32 Voice synth_top直接注入全部44音，各512持键+512释放采样；原始Voice、补偿后Mixer、主增益、FX逐样本核对，PCM5102数字帧检查通过。此项是RTL仿真，不是整机综合网表音频后仿真。

之前68项RTL测试和直接MIDI WAV是正确的RTL行为，却漏掉了编译器把算术错误映射到DSP的差异；综合和时序PASS也不证明算术等价。现已将后综合Loader逐字等价加入此次交付证据。之前的32音优质验收没有完成，不能据旧数字PASS接受这段实物音频。

## 构建与时序

最新FS：`impl/pnr/ao_0.fs`。

SHA256：`eaf783cae4f4b608e96c03ba66b8cf10bba9b556e5643f29651b3a456ccd20d9`。

|检查|最差Slack ns|
|---|---:|
|setup|13.619|
|hold|0.138|
|recovery|2.775|
|removal|0.025|
|min_pulse_width|7.128|

Setup/Hold违反端点均0，所有403行Pin Details字段与构建前相同。32个Voice索引0～31、FFT、HDMI、PT8211和PCM5102A、GAO保留。CST/SDC、电压、PLL与启用源码集合未变。

Logic 47307/138240、Register 17741/139140、BSRAM258/340、DSP127.5/298（比原来减少3个DSP）。警告旧77条、新79条，新增/增多2条；继承的TA1132与PR1014仍在。时序结论只针对当前约束下所报告检查。

新增两条EX3791来自统一25bit函数返回值赋给原17bit level乘积。输入为两个12bit无符号ROM字之差，范围−4095～4095；ap最大4，结果范围−16380～16380，完全装得进17bit signed。截去的高位仅为符号扩展；已用实际后综合参数等价检查核对。未把这两条警告隐藏或算作旧警告。

## 试听与后续验收

`tests/recording_20261018_150135/LISTENING.html`提供原录音、旧错误参数重建和修复后参数重建。后两者均为**实际后综合Loader参数+整数Voice/增益/FX模型**，并非DAC实录，也不是整芯片门级音频仿真；统一增益，不逐音归一化。修复后参数重新等于此前正确RTL，因此此前44音WAV/测量仍是目标音源的参照，不能当成已完成新FS板上试听。

当前“铃铛/断档”的算术根因已经复现并修复；**新FS仍须人工烧录后检查16键是否连续半音、无铃声/异常无声，再评价钢琴音色和未来32键音域**。音源原有高音偏薄、极弱力度门控、A/B音域的音色差异仍按上一份44音报告保留，不宣布32音音质优秀。

证据：`tests/recording_20261018_150135`和`audit/recording_20261018_150135`。旧FS、旧完整综合网表和报告完整保存在该audit下backup目录。历史calibration/range44记录和WAV没有覆盖；新FS另存final_build。
