kehanzuishuai/fpga/src/synth_top.v

module synth_top #(
    parameter REMOTE_ENABLE=0,
    parameter CLK_HZ         = 12288000,
    parameter SAMPLE_RATE    = 48000,

    parameter VOICES         = 32,
    parameter SAMPLE_W       = 24,

    parameter FIFO_DEPTH     = 16,
    parameter FIFO_ADDR_W    = 4,

    parameter IDX_W          = 5,
    parameter LOG2_VOICES    = 5,
    parameter COUNT_W        = 6,

    /* 1: AMY style partial piano, 0: previous wavetable piano */
    parameter PIANO_ENGINE   = 1,

    /* 1: mix gain 1/N of the active voices (previous), 0: constant */
    parameter POLY_NORMALIZE = 0,

    /* 1: soundboard / reverb / EQ / limiter after the mix */
    parameter FX_ENABLE      = 1,

    /* effects output gain: 0 = x1, 1 = x2 */
    parameter FX_GAIN_SHIFT  = 1
)(
 input wire [6:0] expression_glide,expression_vibrato,
    /* ========================================================
     * System clock / reset
     *
     * clk要求：
     * 当前设计默认使用12.288 MHz音频主时钟
     * ======================================================== */
    input                           clk,
    input                           rst_n,


    /* ========================================================
     * Note Event 输入
     *SSS
     * 后面按键 / MIDI / 演奏控制器都可以接到这里
     * ======================================================== */

    input                           event_valid,

    input                           event_note_on,

    input      [6:0]                event_note,

    input      [7:0]                event_velocity,

    input      [1:0]                event_waveform,

    output                          event_ready,


    /* ========================================================
     * Continuous Control
     *
     * morph不进入Note FIFO
     * ======================================================== */

    input                           morph_enable,

    input      [9:0]                morph_control,


    /* ========================================================
     * Internal 32-voice test mode
     * ======================================================== */

    input                           test_enable,
    input [2:0] instrument_id,
    input engine_clear,
    input [15:0] remote_volume,
    input [15:0] synth_gain,
    input signed [23:0] wav_left,wav_right,
    output wire remote_sample_tick,engine_idle,engine_clear_done,
    input wire [1:0] source_mode,input wire [15:0] mode_gain,
    input wire signed [23:0] theremin_pcm,

    /* 0: piano hammer noise muted */
    input                           hammer_enable,

    /*
     * Effects after the mix (piano_fx.v):
     *   bit 0    soundboard resonance on
     *   bit 1    reverb on
     *   bit 3:2  EQ preset, 0 natural, 1 warm, 2 bright
     *   bit 4    1 soft limiter, 0 plain clipping
     */
    input      [4:0]                fx_ctrl,


    /* ========================================================
     * On-board PT8211 (16 bit, i2s_tx.v)
     * ======================================================== */

    output                          i2s_bclk,

    output                          i2s_lrck,

    output                          i2s_data,


    /* ========================================================
     * External PCM5102A (standard I2S, 24 bit,
     * pcm5102_i2s_tx.v).  Same audio_out as the PT8211.
     * ======================================================== */

    output                          pcm5102_bclk,

    output                          pcm5102_lrck,

    output                          pcm5102_data,


    /* ========================================================
     * Telemetry UART
     * ======================================================== */

    output                          uart_tx,

    output                          uart_busy,


    /* ========================================================
     * Debug outputs
     * ======================================================== */

    output     [VOICES-1:0]         active_debug,

    output     [COUNT_W-1:0]        active_voice_count,

    output     [FIFO_ADDR_W:0]      fifo_level,

    output     [SAMPLE_W-1:0]       audio_peak,

    output                          dbg_note_event,

    output                          dbg_audio_onset,

    output                          dbg_clip,

    output                          latency_valid,

    output     [23:0]               latency_samples,

    output     [5:0]                mix_gain_shift,


    /* ========================================================
     * Visualization
     * ======================================================== */

    output                          visual_sample_strobe,

    output signed [SAMPLE_W-1:0]    lissajous_x,

    output wire signed [SAMPLE_W-1:0] visual_pcm,
    output wire                    visual_pcm_valid,
    output signed [SAMPLE_W-1:0]    lissajous_y,
    output wire [127:0]            diagnostic_chain,
    output wire [VOICES*7-1:0] display_voice_notes,
    output wire signed [23:0] display_left,display_right,
    output wire [VOICES*16-1:0] display_env_levels,
    output wire [VOICES*3-1:0] display_env_phases,
    output wire [VOICES-1:0] display_env_valid,display_env_done,display_env_starts
);


/* ============================================================
 * Internal Audio Signals
 * ============================================================ */


/*
 * 48kHz sample enable
 *
 * 由I2S模块统一产生。
 *
 * DDS / ADSR / Morph / Mixer
 * 全部使用同一个sample_tick。
 */
wire sample_tick;


/*
 * Synth最终24bit PCM
 */
wire signed [SAMPLE_W-1:0] audio_out;
wire pcm_strobe;
wire signed [SAMPLE_W-1:0] pcm_sample;
wire signed [23:0] final_left,final_right;
assign display_left=final_left;assign display_right=final_right;
wire master_clipped,engine_clipped;
wire [23:0] engine_peak;wire engine_pcm_strobe;wire signed [23:0] engine_pcm;
assign dbg_clip=engine_clipped || (REMOTE_ENABLE!=0 && master_clipped);

assign remote_sample_tick=sample_tick;
wire engine_rst_n=rst_n && !(REMOTE_ENABLE!=0 && engine_clear);
wire engine_initialized;
assign engine_clear_done=engine_rst_n && engine_initialized && engine_idle && !(|active_debug);
generate if(REMOTE_ENABLE!=0)begin:G_MASTER
 // DDS tick K-1 matches the old FX result observed by DAC tick K.
 reg signed [23:0] theremin_frame;
 always @(posedge clk or negedge rst_n)
 if(!rst_n)theremin_frame<=0;else if(sample_tick)theremin_frame<=theremin_pcm;
 live_instrument_master master(remote_volume,synth_gain,mode_gain,source_mode,audio_out,theremin_frame,visual_pcm,master_clipped);
 assign final_left=visual_pcm;assign final_right=visual_pcm;
 wire [23:0] abs_left=final_left[23]?-final_left:final_left;
 wire [23:0] abs_right=final_right[23]?-final_right:final_right;
 wire signed [23:0] meter_pcm=abs_left>=abs_right?final_left:final_right;
 wire [COUNT_W-1:0] unused_count;
 audio_telemetry #(.VOICES(VOICES),.SAMPLE_W(SAMPLE_W),.COUNT_W(COUNT_W)) meter(
 .clk(clk),.rst_n(rst_n),.sample_tick(sample_tick),.active_voices(active_debug),
 .audio(meter_pcm),.active_voice_count(unused_count),.audio_peak(audio_peak),
 .pcm_strobe(pcm_strobe),.pcm_sample(pcm_sample));
end else begin:G_ORIGINAL
 assign final_left=audio_out;assign final_right=audio_out;assign visual_pcm=audio_out;
 assign master_clipped=0;assign audio_peak=engine_peak;assign pcm_strobe=engine_pcm_strobe;assign pcm_sample=engine_pcm;
end endgenerate


/*
 * Telemetry输出
 */
/* ============================================================
 * I2S Transmitter
 *
 * 它不仅负责PCM5102A，
 * 同时负责产生整个音频系统的sample_tick。
 * ============================================================ */

i2s_tx #(
    .CLK_HZ      (CLK_HZ),
    .SAMPLE_RATE (SAMPLE_RATE),
    .SAMPLE_W    (SAMPLE_W),
    .SLOT_W      (32)
) u_i2s_tx (
    .clk          (clk),
    .rst_n        (rst_n),

    /*
     * 当前先做Mono：
     *
     * 左右声道发送同一个audio_out
     */
    .left_sample  (final_left),

    .right_sample (final_right),

    .i2s_bclk     (i2s_bclk),

    .i2s_lrck     (i2s_lrck),

    .i2s_data     (i2s_data),

    .frame_capture(visual_pcm_valid),
    .sample_tick  (sample_tick)
);


/* ============================================================
 * Second output: external PCM5102A
 *
 * Reads the same audio_out and takes it on the same clk edge as
 * u_i2s_tx (8 clk after sample_tick is set), so both DACs carry
 * the same sample in the same frame.  It only listens: nothing
 * of the synthesizer depends on it.
 * ============================================================ */

pcm5102_i2s_tx #(
    .SAMPLE_W      (SAMPLE_W),
    .CAPTURE_DELAY (5'd7)
) u_pcm5102_tx (
    .clk          (clk),
    .rst_n        (rst_n),

    .sample_valid (sample_tick),

    .left_sample  (final_left),

    .right_sample (final_right),

    .pcm5102_bclk (pcm5102_bclk),

    .pcm5102_lrck (pcm5102_lrck),

    .pcm5102_data (pcm5102_data)
);


/* ============================================================
 * Main Synthesizer
 * ============================================================ */

synth_event_frontend #(
    .REMOTE_ENABLE(REMOTE_ENABLE),    .VOICES      (VOICES),

    .SAMPLE_W    (SAMPLE_W),

    .SAMPLE_RATE (SAMPLE_RATE),

    .FIFO_DEPTH  (FIFO_DEPTH),

    .FIFO_ADDR_W (FIFO_ADDR_W),

    .IDX_W       (IDX_W),

    .LOG2_VOICES (LOG2_VOICES),

    .COUNT_W     (COUNT_W),

    .PIANO_ENGINE   (PIANO_ENGINE),

    .POLY_NORMALIZE (POLY_NORMALIZE),

    .FX_ENABLE      (FX_ENABLE),

    .FX_GAIN_SHIFT  (FX_GAIN_SHIFT)
) u_synth (
 .expression_glide(expression_glide),.expression_vibrato(expression_vibrato),
    .clk                 (clk),

    .rst_n               (engine_rst_n),

    .sample_tick         (sample_tick),
    .instrument_id(instrument_id),.engine_idle(engine_idle),.engine_initialized(engine_initialized),


    /* --------------------------------------------------------
     * Note Event
     * -------------------------------------------------------- */

    .event_valid         (event_valid),

    .event_note_on       (event_note_on),

    .event_note          (event_note),

    .event_velocity      (event_velocity),

    .event_waveform      (event_waveform),

    .event_ready         (event_ready),


    /* --------------------------------------------------------
     * Continuous Control
     * -------------------------------------------------------- */

    .morph_enable        (morph_enable),

    .event_morph         (morph_control),


    /* --------------------------------------------------------
     * Test
     * -------------------------------------------------------- */

    .test_enable         (test_enable),

    .hammer_enable       (hammer_enable),

    .fx_ctrl             (fx_ctrl),


    /* --------------------------------------------------------
     * Audio
     * -------------------------------------------------------- */

    .audio_out           (audio_out),


    /* --------------------------------------------------------
     * Debug / Telemetry
     * -------------------------------------------------------- */

    .active_debug        (active_debug),

    .fifo_level          (fifo_level),

    .active_voice_count  (active_voice_count),

    .audio_peak          (engine_peak),

    .pcm_strobe          (engine_pcm_strobe),

    .pcm_sample          (engine_pcm),

    .dbg_note_event      (dbg_note_event),

    .dbg_audio_onset     (dbg_audio_onset),

    .dbg_clip            (engine_clipped),

    .latency_valid       (latency_valid),

    .latency_samples     (latency_samples),

    .mix_gain_shift      (mix_gain_shift),


    /* --------------------------------------------------------
     * Visualization
     * -------------------------------------------------------- */

    .visual_sample_strobe(visual_sample_strobe),

    .lissajous_x         (lissajous_x),

    .lissajous_y         (lissajous_y),
    .diagnostic_chain    (diagnostic_chain),
    .display_voice_notes(display_voice_notes),.display_env_levels(display_env_levels),.display_env_phases(display_env_phases),
    .display_env_valid(display_env_valid),.display_env_done(display_env_done),.display_env_starts(display_env_starts)
);


/* ============================================================
 * Telemetry UART
 *
 * audio_telemetry产生pcm_strobe，
 * 每次strobe就发一包监控数据。
 * ============================================================ */

telemetry_uart #(
    .CLK_HZ        (CLK_HZ),

    .BAUD          (115200),

    .VOICE_COUNT_W (COUNT_W),

    .SAMPLE_W      (SAMPLE_W)
) u_telemetry_uart (
    .clk                (clk),

    .rst_n              (rst_n),

    .report_strobe      (pcm_strobe),

    .active_voice_count (active_voice_count),

    .audio_peak         (audio_peak),

    .pcm_sample         (pcm_sample),

    .tx                 (uart_tx),

    .busy               (uart_busy)
);


endmodule
