kehanzuishuai/fpga/ref/amy_excerpt/src/delay.c

#include "amy.h"


#include "delay.h"

int is_power_of_two(int val) {
    // Returns log_2(val) if val == 2**n, else -1.
    int log_2_val = 0;
    while(val) {
        if (val == 1) return log_2_val;
        if (val & 1) return -1;
        val >>= 1;
        ++log_2_val;
    }
    return -1;  // zero is not a power of 2.
}

#ifdef AMY_DAISY
// Put delay lines in QSPI on Daisy

#define QSPI_HEAP_SIZE 1048576

uint8_t __attribute__((section((".sdram_bss")))) qspi_heap[QSPI_HEAP_SIZE];
uint32_t qspi_used = 0;

void *qspi_malloc(size_t num_bytes) {
    //fprintf(stderr, "qspi_malloc: %d bytes, used = %d\n", num_bytes, qspi_used);
    if ((qspi_used + num_bytes) >= QSPI_HEAP_SIZE) {
	fprintf(stderr, "qspi_malloc: out of heap\n");
	abort();
    }
    // Save the size of this block.
    *(uint32_t *)(qspi_heap + qspi_used) = num_bytes;
    qspi_used += sizeof(uint32_t);
    void *result = (void *)(qspi_heap + qspi_used);
    qspi_used += num_bytes;
    return result;
}

void qspi_free(void *ptr) {
    uint32_t last_alloc = *(uint32_t *)((uint8_t*)ptr - sizeof(uint32_t));
    if (ptr == (void *)(qspi_heap + (qspi_used - last_alloc))) {
	// We're just freeing the last alloc, yay.
	qspi_used -= last_alloc + sizeof(uint32_t);
	//fprintf(stderr, "qspi_free: %ld bytes, used = %d\n", last_alloc, qspi_used);
    } else {
	fprintf(stderr, "qspi_free: punt (ptr = qspi_heap + %d)\n", (uint8_t*)ptr - (uint8_t *)qspi_heap);
	// Don't actually recover the memory.
    }
}

#define malloc_caps(a, b) qspi_malloc(a)
#define free(a) qspi_free(a)

#endif

delay_line_t *new_delay_line(int len, int fixed_delay, int ram_type) {
    // Check that len is a power of 2.
    //printf("new_delay_line: len %d fixed_del %d\n", len, fixed_delay);
    int log_2_len = is_power_of_two(len);
    if (log_2_len < 0) {
        fprintf(stderr, "delay line len must be power of 2, not %d\n", len);
        abort();
    }
    delay_line_t *delay_line = (delay_line_t*)malloc_caps(sizeof(delay_line_t) + len * sizeof(SAMPLE), ram_type);
    if (delay_line == NULL) {
	fprintf(stderr, "unable to alloc delay line of %d samples\n", len);
	return NULL;
    }
    delay_line->samples = (SAMPLE*)(((uint8_t*)delay_line) + sizeof(delay_line_t));
    delay_line->len = len;
    delay_line->log_2_len = log_2_len;
    delay_line->fixed_delay = fixed_delay;
    delay_line->next_in = 0;
    for (int i = 0; i < len; ++i) {
        delay_line->samples[i] = 0;
    }
    //fprintf(stderr, "new_delay_line: len %d fixed_del %d ->0x%x\n", len, fixed_delay, (uint32_t)delay_line);
    return delay_line;
}

void free_delay_line(delay_line_t *delay_line) {
    //printf("free_delay_line: 0x%x\n", (uint32_t)delay_line);
    free(delay_line);  // the samples are part of the same malloc.
}

static SAMPLE FRACTIONAL_SAMPLE(PHASOR phase, const SAMPLE *delay, int index_mask, int index_bits) {
    // Interpolated sample copied from oscillators.c:render_lut
    uint32_t base_index = INT_OF_P(phase, index_bits);
    SAMPLE frac = S_FRAC_OF_P(phase, index_bits);
    SAMPLE b = delay[base_index];
    SAMPLE c = delay[(base_index + 1) & index_mask];
    // linear interpolation.
    SAMPLE sample = b + MUL8_SS((c - b), frac);
    return sample;
}

void delay_line_in_out(SAMPLE *in, SAMPLE *out, int n_samples, SAMPLE* mod_in, SAMPLE mod_scale, delay_line_t *delay_line, SAMPLE mix_level, SAMPLE feedback_level) {
    // Read and write the next n_samples from/to the delay line.
    // mod_in is a per-sample modulation of the read tap around fixed_delay:
    // 0 gives fixed_delay, 1 gives 2 * fixed_delay, -1 gives no delay.
    // mod_scale is a constant scale factor applied to each value in mod_in, 
    // used e.g. to flip the sign of the delay.
    // Also supports input feedback from a non-modulated feedback delay output.
    int delay_len = delay_line->len;
    int index_mask = delay_len - 1; // will be all 1s because len is guaranteed 2**n.
    int index_bits = delay_line->log_2_len;

    int index_in = delay_line->next_in;
    int index_feedback = (index_in - delay_line->fixed_delay) & index_mask;

    SAMPLE *delay = delay_line->samples;
    // Tap center and modulation span as fractions of the line length.
    SAMPLE center = AMY_I2S(delay_line->fixed_delay, index_bits);
    SAMPLE span = MUL8_SS(center, mod_scale);
    while(n_samples-- > 0) {
        SAMPLE next_in = *in++ + MUL8_SS(feedback_level,
                                         delay[index_feedback++]);
        index_feedback &= index_mask;

        PHASOR phase_out = I2P(index_in, index_bits)
            - S2P(center + MUL8_SS(span, *mod_in++));
        //if(index_out >= delay_len) index_out -= delay_len;
        //if(index_out < 0) index_out += delay_len;
        SAMPLE sample = FRACTIONAL_SAMPLE(phase_out, delay, index_mask, index_bits);
        *out++ += MUL8_SS(mix_level, sample);  // mix delayed + original.
        delay[index_in++] = next_in;
        index_in &= index_mask;
    }
    delay_line->next_in = index_in;
}

static inline SAMPLE DEL_OUT(delay_line_t *delay_line, int extra_delay) {
    int out_index =
        (delay_line->next_in - (delay_line->fixed_delay + extra_delay)) & (delay_line->len - 1);
    return delay_line->samples[out_index];
}

static inline void DEL_IN(delay_line_t *delay_line, SAMPLE val) {
    delay_line->samples[delay_line->next_in++] = val;
    delay_line->next_in &= (delay_line->len - 1);
}

static inline SAMPLE LPF(SAMPLE samp, SAMPLE *state, SAMPLE lpcoef, SAMPLE lpgain, SAMPLE gain) {
    // 1-pole lowpass filter (exponential smoothing).
    // Smoothing. lpcoef=1 => no smoothing; lpcoef=0.001 => much smoothing.
    *state += SMULR6(lpcoef, samp - *state);
    // Cross-fade between smoothed and original.  lpgain=0 => all smoothed, 1 => all dry.
    return SMULR6(SHIFTR(gain, 1), *state + SMULR6(lpgain, samp - *state));
}

void delay_line_in_out_fixed_delay(SAMPLE *in, SAMPLE *out, int n_samples, int delay_samples, delay_line_t *delay_line, SAMPLE mix_level, SAMPLE feedback_level, SAMPLE filter_coef) {
    // Read and write the next n_samples from/to the delay line.
    // Simplified version of delay_line_in_out() that uses a fixed integer delay
    // for the whole block.
    if (filter_coef == 0) {
        while(n_samples-- > 0) {
            SAMPLE delay_out = DEL_OUT(delay_line, 0);
            SAMPLE next_in = *in++ + SMULR6(feedback_level, delay_out);
            DEL_IN(delay_line, next_in);
            *out++ += MUL8_SS(mix_level, delay_out);
        }
    } else if (filter_coef > 0) {
        // Positive filter coef is a pole on the positive real line, to get low-pass effect.
        // We apply the filter on the way *in* to the delay line.
        while(n_samples-- > 0) {
            SAMPLE delay_out = DEL_OUT(delay_line, 0);
            SAMPLE next_in = *in++ + SMULR6(feedback_level, delay_out);
            // Peek at the last value we wrote to the delay line to get the most recent filter output.
            SAMPLE last_filter_result = delay_line->samples[(delay_line->next_in - 1) & (delay_line->len - 1)];
            SAMPLE filter_result = next_in + SMULR6(filter_coef, last_filter_result - next_in);
            DEL_IN(delay_line, filter_result);
            *out++ += MUL8_SS(mix_level, delay_out);
        }
    } else {
        // Negative filter coef is a zero on the positive real axis to get high-pass.
        // We apply the FIR zero on the way *out* of the delay line.
        while(n_samples-- > 0) {
            SAMPLE delay_out = DEL_OUT(delay_line, 0);
            SAMPLE prev_delay_out = DEL_OUT(delay_line, 1);
            SAMPLE output = delay_out + SMULR6(filter_coef, prev_delay_out);
            SAMPLE next_in = *in++ + SMULR6(feedback_level, output);
            DEL_IN(delay_line, next_in);
            *out++ += MUL8_SS(mix_level, output);
        }
    }
}


void apply_variable_delay(SAMPLE *block, delay_line_t *delay_line, SAMPLE *delay_mod, SAMPLE delay_scale, SAMPLE mix_level, SAMPLE feedback_level) {
    delay_line_in_out(block, block, AMY_BLOCK_SIZE, delay_mod, delay_scale, delay_line, mix_level, feedback_level);
}

void apply_fixed_delay(SAMPLE *block, delay_line_t *delay_line, uint32_t delay_samples, SAMPLE mix_level, SAMPLE feedback, SAMPLE filter_coef) {
    delay_line_in_out_fixed_delay(block, block, AMY_BLOCK_SIZE, delay_samples, delay_line, mix_level, feedback, filter_coef);
}

#define INITIAL_XOVER_HZ 3000.0
#define INITIAL_LIVENESS 0.85
#define INITIAL_DAMPING 0.5

reverb_params_t *new_reverb() {
    reverb_params_t *rev = malloc_caps(sizeof(reverb_params_t), amy_global.config.ram_caps_synth);
    bzero(rev, sizeof(reverb_params_t));
    return rev;
}

void delete_reverb(reverb_params_t *rev) {
    if(rev) free(rev);
}

void config_stereo_reverb(reverb_params_t *rev, float a_liveness, float crossover_hz, float damping) {
    //printf("config_stereo_reverb: liveness %f xover %f damping %f\n",
    //       a_liveness, crossover_hz, damping);
    // liveness (0..1) controls how much energy is preserved (larger = longer reverb).
    rev->liveness = F2S(a_liveness);
    // crossover_hz is 3dB point of 1-pole lowpass freq.
    rev->lpfcoef = F2S(6.2832f * crossover_hz / AMY_SAMPLE_RATE);
    if (rev->lpfcoef > F2S(1.f))  rev->lpfcoef = F2S(1.f);
    if (rev->lpfcoef < 0)  rev->lpfcoef = 0;
    rev->lpfgain = F2S(1.f - damping);
}

// Delay 1 is 58.6435 ms
#define DELAY1SAMPS 2586
// Delay 2 is 69.4325 ms
#define DELAY2SAMPS 3062
// Delay 3 is 74.5234 ms
#define DELAY3SAMPS 3286
// Delay 4 is 86.1244 ms
#define DELAY4SAMPS 3798

// Power of 2 that encloses all the delays.
#define DELAY_POW2 4096

// Early reflections delays
#define REF1SAMPS 3319  // 75.2546 ms
#define REF2SAMPS 1920  // 43.5337 ms
#define REF3SAMPS 1138  // 25.796 ms
#define REF4SAMPS 855   // 19.392 ms
#define REF5SAMPS 722   // 16.364 ms
#define REF6SAMPS 602   // 13.645 ms


bool init_stereo_reverb(reverb_params_t *rev) {
    if (rev->delay_1 != NULL)
        return true;  // already initialised

    rev->delay_1 = new_delay_line(DELAY_POW2, DELAY1SAMPS, amy_global.config.ram_caps_delay);
    rev->delay_2 = new_delay_line(DELAY_POW2, DELAY2SAMPS, amy_global.config.ram_caps_delay);
    rev->delay_3 = new_delay_line(DELAY_POW2, DELAY3SAMPS, amy_global.config.ram_caps_delay);
    rev->delay_4 = new_delay_line(DELAY_POW2, DELAY4SAMPS, amy_global.config.ram_caps_delay);

    rev->ref_1 = new_delay_line(4096, REF1SAMPS, amy_global.config.ram_caps_delay);
    rev->ref_2 = new_delay_line(2048, REF2SAMPS, amy_global.config.ram_caps_delay);
    rev->ref_3 = new_delay_line(2048, REF3SAMPS, amy_global.config.ram_caps_delay);
    rev->ref_4 = new_delay_line(1024, REF4SAMPS, amy_global.config.ram_caps_delay);
    rev->ref_5 = new_delay_line(1024, REF5SAMPS, amy_global.config.ram_caps_delay);
    rev->ref_6 = new_delay_line(1024, REF6SAMPS, amy_global.config.ram_caps_delay);

    if (rev->delay_1 == NULL || rev->delay_2 == NULL || rev->delay_3 == NULL || rev->delay_4 == NULL ||
        rev->ref_1 == NULL || rev->ref_2 == NULL || rev->ref_3 == NULL ||
        rev->ref_4 == NULL || rev->ref_5 == NULL || rev->ref_6 == NULL) {
        fprintf(stderr, "init_stereo_reverb: allocation failed, reverb disabled\n");
        deinit_stereo_reverb(rev);  // rolls back all partial allocations, NULLs all pointers
        return false;
    }

    config_stereo_reverb(rev, INITIAL_LIVENESS, INITIAL_XOVER_HZ, INITIAL_DAMPING);
    return true;
}

void deinit_stereo_reverb(reverb_params_t *rev) {
    if (rev->delay_1 != NULL) {
        free(rev->delay_1); rev->delay_1 = NULL;
        free(rev->delay_2); rev->delay_2 = NULL;
        free(rev->delay_3); rev->delay_3 = NULL;
        free(rev->delay_4); rev->delay_4 = NULL;
        free(rev->ref_1); rev->ref_1 = NULL;
        free(rev->ref_2); rev->ref_2 = NULL;
        free(rev->ref_3); rev->ref_3 = NULL;
        free(rev->ref_4); rev->ref_4 = NULL;
        free(rev->ref_5); rev->ref_5 = NULL;
        free(rev->ref_6); rev->ref_6 = NULL;
    }
}

// Cache one delay line's state in locals for the reverb loop, the same way
// delay_line_in_out() hoists its line's state.  DEL_IN/DEL_OUT re-read
// samples/next_in/fixed_delay/len through the struct pointer on every call;
// with ten delay lines interleaved per sample that redundant traffic is a
// measurable fraction of the loop, and on platforms that place delay lines
// in external RAM the struct headers are slow to touch.
//
// `##` is the standard (C89) preprocessor token-pasting operator: it joins
// the macro argument P with the suffix into one identifier at compile time.
// So DL_LOAD(e1, rev->ref_1) declares four ordinary locals named e1_s
// (samples pointer), e1_m (index mask = len-1), e1_n (next_in write index),
// e1_f (fixed_delay read offset), and DL_WRITE(e1, x)/DL_READ(e1) refer to
// those same locals.  This gives each of the ten lines its own distinct
// scalars (which the compiler can keep in registers) without hand-writing
// forty declarations.  The names are generated at compile time, so a wrong
// prefix is an "undeclared identifier" error, never a silent wrong-line bug.
// Only next_in changes inside the loop; it is written back after the loop.
#define DL_LOAD(P, LINE)                        \
    SAMPLE *P##_s = (LINE)->samples;            \
    int P##_m = (LINE)->len - 1;                \
    int P##_n = (LINE)->next_in;                \
    int P##_f = (LINE)->fixed_delay
#define DL_WRITE(P, val) do { P##_s[P##_n] = (val); P##_n = (P##_n + 1) & P##_m; } while (0)
#define DL_READ(P)       (P##_s[(P##_n - P##_f) & P##_m])

void stereo_reverb(reverb_params_t *rev, SAMPLE *r_in, SAMPLE *l_in, SAMPLE *r_out, SAMPLE *l_out, int n_samples, SAMPLE level) {
    // Stereo reverb.  *{r,l}_in each point to n_samples input samples.
    // n_samples are written to {r,l}_out.
    // Recreate
    // https://github.com/duvtedudug/Pure-Data/blob/master/extra/rev2%7E.pd
    // an instance of the Stautner-Puckette multichannel reverberator from
    // https://www.ee.columbia.edu/~dpwe/e4896/papers/StautP82-reverb.pdf


    // Early-reflection lines e1..e6, reverb delay lines dl1..dl4.
    DL_LOAD(e1, rev->ref_1);
    DL_LOAD(e2, rev->ref_2);
    DL_LOAD(e3, rev->ref_3);
    DL_LOAD(e4, rev->ref_4);
    DL_LOAD(e5, rev->ref_5);
    DL_LOAD(e6, rev->ref_6);
    DL_LOAD(dl1, rev->delay_1);
    DL_LOAD(dl2, rev->delay_2);
    DL_LOAD(dl3, rev->delay_3);
    DL_LOAD(dl4, rev->delay_4);

    SAMPLE lpfcoef = rev->lpfcoef, lpfgain = rev->lpfgain, liveness = rev->liveness;
    SAMPLE f1state = rev->f1state, f2state = rev->f2state;
    SAMPLE f3state = rev->f3state, f4state = rev->f4state;

    while(n_samples--) {
        // Early echo reflections.
        SAMPLE in_r = *r_in++;
        SAMPLE in_l;
        if (l_in)   in_l = *l_in++;
        else   in_l = in_r;
        SAMPLE r_acc, l_acc;
        r_acc = MUL0_SS(F2S(0.0625f), in_r);
        l_acc = MUL0_SS(F2S(0.0625f), in_l);

        DL_WRITE(e1, l_acc);
        SAMPLE d_out = DL_READ(e1);
        l_acc = r_acc - d_out;
        r_acc += d_out;

        DL_WRITE(e2, l_acc);
        d_out = DL_READ(e2);
        l_acc = r_acc - d_out;
        r_acc += d_out;

        DL_WRITE(e3, l_acc);
        d_out = DL_READ(e3);
        l_acc = r_acc - d_out;
        r_acc += d_out;

        DL_WRITE(e4, l_acc);
        d_out = DL_READ(e4);
        l_acc = r_acc - d_out;
        r_acc += d_out;

        DL_WRITE(e5, l_acc);
        d_out = DL_READ(e5);
        l_acc = r_acc - d_out;
        r_acc += d_out;

        DL_WRITE(e6, l_acc);
        l_acc = DL_READ(e6);


        // Reverb delays & matrix.
        SAMPLE d1 = DL_READ(dl1);
        d1 = LPF(d1, &f1state, lpfcoef, lpfgain, liveness);
        d1 += r_acc;
        *r_out++ = in_r + MUL8_SS(level, d1);

        SAMPLE d2 = DL_READ(dl2);
        d2 = LPF(d2, &f2state, lpfcoef, lpfgain, liveness);
        d2 += l_acc;
        if (l_out != NULL)  *l_out++ = in_l + MUL8_SS(level, d2);

        SAMPLE d3 = DL_READ(dl3);
        d3 = LPF(d3, &f3state, lpfcoef, lpfgain, liveness);

        SAMPLE d4 = DL_READ(dl4);
        d4 = LPF(d4, &f4state, lpfcoef, lpfgain, liveness);

        // Mixing and feedback.
        DL_WRITE(dl1, d1 + d2 + d3 + d4);
        DL_WRITE(dl2, d1 - d2 + d3 - d4);
        DL_WRITE(dl3, d1 + d2 - d3 - d4);
        DL_WRITE(dl4, d1 - d2 - d3 + d4);
    }

    // Write back the advanced write indices and the filter state.
    rev->ref_1->next_in = e1_n;
    rev->ref_2->next_in = e2_n;
    rev->ref_3->next_in = e3_n;
    rev->ref_4->next_in = e4_n;
    rev->ref_5->next_in = e5_n;
    rev->ref_6->next_in = e6_n;
    rev->delay_1->next_in = dl1_n;
    rev->delay_2->next_in = dl2_n;
    rev->delay_3->next_in = dl3_n;
    rev->delay_4->next_in = dl4_n;
    rev->f1state = f1state;
    rev->f2state = f2state;
    rev->f3state = f3state;
    rev->f4state = f4state;
}
