kehanzuishuai/fpga/boards/tang_mega_138k_pro/src/visual_twiddle_rom.v

`default_nettype none
// Generated Q1.15 exp(-j*2*pi*k/4096), rounded, amplitude32767.
// Synchronous initialized ROM: block-RAM friendly, no giant combinational case.
module visual_twiddle_rom(input wire clk,input wire [11:0] addr,output reg signed [15:0] c,s);
reg [31:0] rom[0:4095];
initial begin
 rom[0]=32'h7fff0000;
 rom[1]=32'h7fffffce;
 rom[2]=32'h7fffff9b;
 rom[3]=32'h7fffff69;
 rom[4]=32'h7ffeff37;
 rom[5]=32'h7ffeff05;
 rom[6]=32'h7ffefed2;
 rom[7]=32'h7ffdfea0;
 rom[8]=32'h7ffdfe6e;
 rom[9]=32'h7ffcfe3c;
 rom[10]=32'h7ffbfe09;
 rom[11]=32'h7ffafdd7;
 rom[12]=32'h7ff9fda5;
 rom[13]=32'h7ff8fd73;
 rom[14]=32'h7ff7fd40;
 rom[15]=32'h7ff6fd0e;
 rom[16]=32'h7ff5fcdc;
 rom[17]=32'h7ff4fcaa;
 rom[18]=32'h7ff3fc77;
 rom[19]=32'h7ff1fc45;
 rom[20]=32'h7ff0fc13;
 rom[21]=32'h7feefbe1;
 rom[22]=32'h7fecfbae;
 rom[23]=32'h7febfb7c;
 rom[24]=32'h7fe9fb4a;
 rom[25]=32'h7fe7fb18;
 rom[26]=32'h7fe5fae5;
 rom[27]=32'h7fe3fab3;
 rom[28]=32'h7fe1fa81;
 rom[29]=32'h7fdffa4f;
 rom[30]=32'h7fdcfa1d;
 rom[31]=32'h7fdaf9ea;
 rom[32]=32'h7fd8f9b8;
 rom[33]=32'h7fd5f986;
 rom[34]=32'h7fd2f954;
 rom[35]=32'h7fd0f922;
 rom[36]=32'h7fcdf8ef;
 rom[37]=32'h7fcaf8bd;
 rom[38]=32'h7fc7f88b;
 rom[39]=32'h7fc4f859;
 rom[40]=32'h7fc1f827;
 rom[41]=32'h7fbef7f5;
 rom[42]=32'h7fbbf7c2;
 rom[43]=32'h7fb8f790;
 rom[44]=32'h7fb4f75e;
 rom[45]=32'h7fb1f72c;
 rom[46]=32'h7fadf6fa;
 rom[47]=32'h7faaf6c8;
 rom[48]=32'h7fa6f696;
 rom[49]=32'h7fa2f663;
 rom[50]=32'h7f9ff631;
 rom[51]=32'h7f9bf5ff;
 rom[52]=32'h7f97f5cd;
 rom[53]=32'h7f93f59b;
 rom[54]=32'h7f8ff569;
 rom[55]=32'h7f8af537;
 rom[56]=32'h7f86f505;
 rom[57]=32'h7f82f4d3;
 rom[58]=32'h7f7df4a1;
 rom[59]=32'h7f79f46e;
 rom[60]=32'h7f74f43c;
 rom[61]=32'h7f70f40a;
 rom[62]=32'h7f6bf3d8;
 rom[63]=32'h7f66f3a6;
 rom[64]=32'h7f61f374;
 rom[65]=32'h7f5cf342;
 rom[66]=32'h7f57f310;
 rom[67]=32'h7f52f2de;
 rom[68]=32'h7f4df2ac;
 rom[69]=32'h7f48f27a;
 rom[70]=32'h7f42f248;
 rom[71]=32'h7f3df216;
 rom[72]=32'h7f37f1e4;
 rom[73]=32'h7f32f1b2;
 rom[74]=32'h7f2cf180;
 rom[75]=32'h7f26f14f;
 rom[76]=32'h7f21f11d;
 rom[77]=32'h7f1bf0eb;
 rom[78]=32'h7f15f0b9;
 rom[79]=32'h7f0ff087;
 rom[80]=32'h7f09f055;
 rom[81]=32'h7f02f023;
 rom[82]=32'h7efceff1;
 rom[83]=32'h7ef6efbf;
 rom[84]=32'h7eefef8e;
 rom[85]=32'h7ee9ef5c;
 rom[86]=32'h7ee2ef2a;
 rom[87]=32'h7edceef8;
 rom[88]=32'h7ed5eec6;
 rom[89]=32'h7eceee94;
 rom[90]=32'h7ec7ee63;
 rom[91]=32'h7ec0ee31;
 rom[92]=32'h7eb9edff;
 rom[93]=32'h7eb2edcd;
 rom[94]=32'h7eabed9c;
 rom[95]=32'h7ea4ed6a;
 rom[96]=32'h7e9ced38;
 rom[97]=32'h7e95ed06;
 rom[98]=32'h7e8decd5;
 rom[99]=32'h7e86eca3;
 rom[100]=32'h7e7eec71;
 rom[101]=32'h7e77ec40;
 rom[102]=32'h7e6fec0e;
 rom[103]=32'h7e67ebdc;
 rom[104]=32'h7e5febab;
 rom[105]=32'h7e57eb79;
 rom[106]=32'h7e4feb47;
 rom[107]=32'h7e47eb16;
 rom[108]=32'h7e3eeae4;
 rom[109]=32'h7e36eab3;
 rom[110]=32'h7e2eea81;
 rom[111]=32'h7e25ea50;
 rom[112]=32'h7e1dea1e;
 rom[113]=32'h7e14e9ed;
 rom[114]=32'h7e0be9bb;
 rom[115]=32'h7e02e98a;
 rom[116]=32'h7dfae958;
 rom[117]=32'h7df1e927;
 rom[118]=32'h7de8e8f5;
 rom[119]=32'h7ddfe8c4;
 rom[120]=32'h7dd5e892;
 rom[121]=32'h7dcce861;
 rom[122]=32'h7dc3e830;
 rom[123]=32'h7db9e7fe;
 rom[124]=32'h7db0e7cd;
 rom[125]=32'h7da6e79b;
 rom[126]=32'h7d9de76a;
 rom[127]=32'h7d93e739;
 rom[128]=32'h7d89e707;
 rom[129]=32'h7d80e6d6;
 rom[130]=32'h7d76e6a5;
 rom[131]=32'h7d6ce674;
 rom[132]=32'h7d62e642;
 rom[133]=32'h7d57e611;
 rom[134]=32'h7d4de5e0;
 rom[135]=32'h7d43e5af;
 rom[136]=32'h7d39e57e;
 rom[137]=32'h7d2ee54c;
 rom[138]=32'h7d24e51b;
 rom[139]=32'h7d19e4ea;
 rom[140]=32'h7d0ee4b9;
 rom[141]=32'h7d04e488;
 rom[142]=32'h7cf9e457;
 rom[143]=32'h7ceee426;
 rom[144]=32'h7ce3e3f5;
 rom[145]=32'h7cd8e3c4;
 rom[146]=32'h7ccde393;
 rom[147]=32'h7cc1e362;
 rom[148]=32'h7cb6e331;
 rom[149]=32'h7cabe300;
 rom[150]=32'h7c9fe2cf;
 rom[151]=32'h7c94e29e;
 rom[152]=32'h7c88e26d;
 rom[153]=32'h7c7de23c;
 rom[154]=32'h7c71e20b;
 rom[155]=32'h7c65e1da;
 rom[156]=32'h7c59e1a9;
 rom[157]=32'h7c4de179;
 rom[158]=32'h7c41e148;
 rom[159]=32'h7c35e117;
 rom[160]=32'h7c29e0e6;
 rom[161]=32'h7c1de0b6;
 rom[162]=32'h7c10e085;
 rom[163]=32'h7c04e054;
 rom[164]=32'h7bf8e023;
 rom[165]=32'h7bebdff3;
 rom[166]=32'h7bdedfc2;
 rom[167]=32'h7bd2df91;
 rom[168]=32'h7bc5df61;
 rom[169]=32'h7bb8df30;
 rom[170]=32'h7babdf00;
 rom[171]=32'h7b9edecf;
 rom[172]=32'h7b91de9f;
 rom[173]=32'h7b84de6e;
 rom[174]=32'h7b77de3e;
 rom[175]=32'h7b69de0d;
 rom[176]=32'h7b5cdddd;
 rom[177]=32'h7b4fddac;
 rom[178]=32'h7b41dd7c;
 rom[179]=32'h7b33dd4b;
 rom[180]=32'h7b26dd1b;
 rom[181]=32'h7b18dceb;
 rom[182]=32'h7b0adcba;
 rom[183]=32'h7afcdc8a;
 rom[184]=32'h7aeedc5a;
 rom[185]=32'h7ae0dc29;
 rom[186]=32'h7ad2dbf9;
 rom[187]=32'h7ac4dbc9;
 rom[188]=32'h7ab6db99;
 rom[189]=32'h7aa8db69;
 rom[190]=32'h7a99db38;
 rom[191]=32'h7a8bdb08;
 rom[192]=32'h7a7cdad8;
 rom[193]=32'h7a6ddaa8;
 rom[194]=32'h7a5fda78;
 rom[195]=32'h7a50da48;
 rom[196]=32'h7a41da18;
 rom[197]=32'h7a32d9e8;
 rom[198]=32'h7a23d9b8;
 rom[199]=32'h7a14d988;
 rom[200]=32'h7a05d958;
 rom[201]=32'h79f6d928;
 rom[202]=32'h79e6d8f8;
 rom[203]=32'h79d7d8c9;
 rom[204]=32'h79c8d899;
 rom[205]=32'h79b8d869;
 rom[206]=32'h79a9d839;
 rom[207]=32'h7999d809;
 rom[208]=32'h7989d7da;
 rom[209]=32'h7979d7aa;
 rom[210]=32'h796ad77a;
 rom[211]=32'h795ad74b;
 rom[212]=32'h794ad71b;
 rom[213]=32'h7939d6eb;
 rom[214]=32'h7929d6bc;
 rom[215]=32'h7919d68c;
 rom[216]=32'h7909d65d;
 rom[217]=32'h78f8d62d;
 rom[218]=32'h78e8d5fe;
 rom[219]=32'h78d7d5ce;
 rom[220]=32'h78c7d59f;
 rom[221]=32'h78b6d56f;
 rom[222]=32'h78a5d540;
 rom[223]=32'h7894d510;
 rom[224]=32'h7884d4e1;
 rom[225]=32'h7873d4b2;
 rom[226]=32'h7862d483;
 rom[227]=32'h7850d453;
 rom[228]=32'h783fd424;
 rom[229]=32'h782ed3f5;
 rom[230]=32'h781dd3c6;
 rom[231]=32'h780bd396;
 rom[232]=32'h77fad367;
 rom[233]=32'h77e8d338;
 rom[234]=32'h77d7d309;
 rom[235]=32'h77c5d2da;
 rom[236]=32'h77b3d2ab;
 rom[237]=32'h77a1d27c;
 rom[238]=32'h778fd24d;
 rom[239]=32'h777dd21e;
 rom[240]=32'h776bd1ef;
 rom[241]=32'h7759d1c0;
 rom[242]=32'h7747d192;
 rom[243]=32'h7735d163;
 rom[244]=32'h7722d134;
 rom[245]=32'h7710d105;
 rom[246]=32'h76fed0d6;
 rom[247]=32'h76ebd0a8;
 rom[248]=32'h76d8d079;
 rom[249]=32'h76c6d04a;
 rom[250]=32'h76b3d01c;
 rom[251]=32'h76a0cfed;
 rom[252]=32'h768dcfbf;
 rom[253]=32'h767acf90;
 rom[254]=32'h7667cf62;
 rom[255]=32'h7654cf33;
 rom[256]=32'h7641cf05;
 rom[257]=32'h762dced6;
 rom[258]=32'h761acea8;
 rom[259]=32'h7607ce79;
 rom[260]=32'h75f3ce4b;
 rom[261]=32'h75e0ce1d;
 rom[262]=32'h75cccdef;
 rom[263]=32'h75b8cdc0;
 rom[264]=32'h75a5cd92;
 rom[265]=32'h7591cd64;
 rom[266]=32'h757dcd36;
 rom[267]=32'h7569cd08;
 rom[268]=32'h7555ccda;
 rom[269]=32'h7541ccab;
 rom[270]=32'h752dcc7d;
 rom[271]=32'h7518cc4f;
 rom[272]=32'h7504cc21;
 rom[273]=32'h74f0cbf4;
 rom[274]=32'h74dbcbc6;
 rom[275]=32'h74c6cb98;
 rom[276]=32'h74b2cb6a;
 rom[277]=32'h749dcb3c;
 rom[278]=32'h7488cb0e;
 rom[279]=32'h7474cae1;
 rom[280]=32'h745fcab3;
 rom[281]=32'h744aca85;
 rom[282]=32'h7435ca58;
 rom[283]=32'h7420ca2a;
 rom[284]=32'h740ac9fc;
 rom[285]=32'h73f5c9cf;
 rom[286]=32'h73e0c9a1;
 rom[287]=32'h73cac974;
 rom[288]=32'h73b5c946;
 rom[289]=32'h739fc919;
 rom[290]=32'h738ac8eb;
 rom[291]=32'h7374c8be;
 rom[292]=32'h735ec891;
 rom[293]=32'h7349c864;
 rom[294]=32'h7333c836;
 rom[295]=32'h731dc809;
 rom[296]=32'h7307c7dc;
 rom[297]=32'h72f1c7af;
 rom[298]=32'h72dbc782;
 rom[299]=32'h72c4c755;
 rom[300]=32'h72aec727;
 rom[301]=32'h7298c6fa;
 rom[302]=32'h7281c6cd;
 rom[303]=32'h726bc6a0;
 rom[304]=32'h7254c674;
 rom[305]=32'h723ec647;
 rom[306]=32'h7227c61a;
 rom[307]=32'h7210c5ed;
 rom[308]=32'h71f9c5c0;
 rom[309]=32'h71e2c594;
 rom[310]=32'h71cbc567;
 rom[311]=32'h71b4c53a;
 rom[312]=32'h719dc50e;
 rom[313]=32'h7186c4e1;
 rom[314]=32'h716fc4b4;
 rom[315]=32'h7158c488;
 rom[316]=32'h7140c45b;
 rom[317]=32'h7129c42f;
 rom[318]=32'h7111c402;
 rom[319]=32'h70fac3d6;
 rom[320]=32'h70e2c3aa;
 rom[321]=32'h70cac37d;
 rom[322]=32'h70b2c351;
 rom[323]=32'h709bc325;
 rom[324]=32'h7083c2f9;
 rom[325]=32'h706bc2cd;
 rom[326]=32'h7053c2a0;
 rom[327]=32'h703ac274;
 rom[328]=32'h7022c248;
 rom[329]=32'h700ac21c;
 rom[330]=32'h6ff2c1f0;
 rom[331]=32'h6fd9c1c4;
 rom[332]=32'h6fc1c198;
 rom[333]=32'h6fa8c16d;
 rom[334]=32'h6f90c141;
 rom[335]=32'h6f77c115;
 rom[336]=32'h6f5ec0e9;
 rom[337]=32'h6f45c0bd;
 rom[338]=32'h6f2cc092;
 rom[339]=32'h6f14c066;
 rom[340]=32'h6efbc03b;
 rom[341]=32'h6ee1c00f;
 rom[342]=32'h6ec8bfe3;
 rom[343]=32'h6eafbfb8;
 rom[344]=32'h6e96bf8d;
 rom[345]=32'h6e7cbf61;
 rom[346]=32'h6e63bf36;
 rom[347]=32'h6e4abf0a;
 rom[348]=32'h6e30bedf;
 rom[349]=32'h6e16beb4;
 rom[350]=32'h6dfdbe89;
 rom[351]=32'h6de3be5e;
 rom[352]=32'h6dc9be32;
 rom[353]=32'h6dafbe07;
 rom[354]=32'h6d95bddc;
 rom[355]=32'h6d7bbdb1;
 rom[356]=32'h6d61bd86;
 rom[357]=32'h6d47bd5b;
 rom[358]=32'h6d2dbd30;
 rom[359]=32'h6d13bd06;
 rom[360]=32'h6cf8bcdb;
 rom[361]=32'h6cdebcb0;
 rom[362]=32'h6cc3bc85;
 rom[363]=32'h6ca9bc5b;
 rom[364]=32'h6c8ebc30;
 rom[365]=32'h6c74bc05;
 rom[366]=32'h6c59bbdb;
 rom[367]=32'h6c3ebbb0;
 rom[368]=32'h6c23bb86;
 rom[369]=32'h6c08bb5b;
 rom[370]=32'h6bedbb31;
 rom[371]=32'h6bd2bb07;
 rom[372]=32'h6bb7badc;
 rom[373]=32'h6b9cbab2;
 rom[374]=32'h6b81ba88;
 rom[375]=32'h6b65ba5d;
 rom[376]=32'h6b4aba33;
 rom[377]=32'h6b2fba09;
 rom[378]=32'h6b13b9df;
 rom[379]=32'h6af8b9b5;
 rom[380]=32'h6adcb98b;
 rom[381]=32'h6ac0b961;
 rom[382]=32'h6aa4b937;
 rom[383]=32'h6a89b90d;
 rom[384]=32'h6a6db8e4;
 rom[385]=32'h6a51b8ba;
 rom[386]=32'h6a35b890;
 rom[387]=32'h6a19b866;
 rom[388]=32'h69fdb83d;
 rom[389]=32'h69e0b813;
 rom[390]=32'h69c4b7ea;
 rom[391]=32'h69a8b7c0;
 rom[392]=32'h698bb797;
 rom[393]=32'h696fb76d;
 rom[394]=32'h6952b744;
 rom[395]=32'h6936b71b;
 rom[396]=32'h6919b6f1;
 rom[397]=32'h68fcb6c8;
 rom[398]=32'h68e0b69f;
 rom[399]=32'h68c3b676;
 rom[400]=32'h68a6b64c;
 rom[401]=32'h6889b623;
 rom[402]=32'h686cb5fa;
 rom[403]=32'h684fb5d1;
 rom[404]=32'h6832b5a8;
 rom[405]=32'h6814b580;
 rom[406]=32'h67f7b557;
 rom[407]=32'h67dab52e;
 rom[408]=32'h67bcb505;
 rom[409]=32'h679fb4dc;
 rom[410]=32'h6781b4b4;
 rom[411]=32'h6764b48b;
 rom[412]=32'h6746b463;
 rom[413]=32'h6728b43a;
 rom[414]=32'h670ab412;
 rom[415]=32'h66edb3e9;
 rom[416]=32'h66cfb3c1;
 rom[417]=32'h66b1b398;
 rom[418]=32'h6693b370;
 rom[419]=32'h6675b348;
 rom[420]=32'h6656b320;
 rom[421]=32'h6638b2f7;
 rom[422]=32'h661ab2cf;
 rom[423]=32'h65fcb2a7;
 rom[424]=32'h65ddb27f;
 rom[425]=32'h65bfb257;
 rom[426]=32'h65a0b22f;
 rom[427]=32'h6582b207;
 rom[428]=32'h6563b1e0;
 rom[429]=32'h6544b1b8;
 rom[430]=32'h6525b190;
 rom[431]=32'h6507b168;
 rom[432]=32'h64e8b141;
 rom[433]=32'h64c9b119;
 rom[434]=32'h64aab0f2;
 rom[435]=32'h648bb0ca;
 rom[436]=32'h646cb0a3;
 rom[437]=32'h644cb07b;
 rom[438]=32'h642db054;
 rom[439]=32'h640eb02c;
 rom[440]=32'h63eeb005;
 rom[441]=32'h63cfafde;
 rom[442]=32'h63afafb7;
 rom[443]=32'h6390af90;
 rom[444]=32'h6370af69;
 rom[445]=32'h6351af42;
 rom[446]=32'h6331af1b;
 rom[447]=32'h6311aef4;
 rom[448]=32'h62f1aecd;
 rom[449]=32'h62d1aea6;
 rom[450]=32'h62b1ae7f;
 rom[451]=32'h6291ae58;
 rom[452]=32'h6271ae32;
 rom[453]=32'h6251ae0b;
 rom[454]=32'h6231ade5;
 rom[455]=32'h6211adbe;
 rom[456]=32'h61f0ad98;
 rom[457]=32'h61d0ad71;
 rom[458]=32'h61afad4b;
 rom[459]=32'h618fad24;
 rom[460]=32'h616eacfe;
 rom[461]=32'h614eacd8;
 rom[462]=32'h612dacb2;
 rom[463]=32'h610cac8c;
 rom[464]=32'h60ebac65;
 rom[465]=32'h60cbac3f;
 rom[466]=32'h60aaac19;
 rom[467]=32'h6089abf4;
 rom[468]=32'h6068abce;
 rom[469]=32'h6047aba8;
 rom[470]=32'h6025ab82;
 rom[471]=32'h6004ab5c;
 rom[472]=32'h5fe3ab37;
 rom[473]=32'h5fc2ab11;
 rom[474]=32'h5fa0aaeb;
 rom[475]=32'h5f7faac6;
 rom[476]=32'h5f5daaa0;
 rom[477]=32'h5f3caa7b;
 rom[478]=32'h5f1aaa56;
 rom[479]=32'h5ef8aa30;
 rom[480]=32'h5ed7aa0b;
 rom[481]=32'h5eb5a9e6;
 rom[482]=32'h5e93a9c1;
 rom[483]=32'h5e71a99c;
 rom[484]=32'h5e4fa976;
 rom[485]=32'h5e2da951;
 rom[486]=32'h5e0ba92d;
 rom[487]=32'h5de9a908;
 rom[488]=32'h5dc7a8e3;
 rom[489]=32'h5da5a8be;
 rom[490]=32'h5d82a899;
 rom[491]=32'h5d60a875;
 rom[492]=32'h5d3ea850;
 rom[493]=32'h5d1ba82b;
 rom[494]=32'h5cf9a807;
 rom[495]=32'h5cd6a7e2;
 rom[496]=32'h5cb3a7be;
 rom[497]=32'h5c91a799;
 rom[498]=32'h5c6ea775;
 rom[499]=32'h5c4ba751;
 rom[500]=32'h5c28a72d;
 rom[501]=32'h5c05a708;
 rom[502]=32'h5be2a6e4;
 rom[503]=32'h5bbfa6c0;
 rom[504]=32'h5b9ca69c;
 rom[505]=32'h5b79a678;
 rom[506]=32'h5b56a654;
 rom[507]=32'h5b33a631;
 rom[508]=32'h5b0fa60d;
 rom[509]=32'h5aeca5e9;
 rom[510]=32'h5ac9a5c5;
 rom[511]=32'h5aa5a5a2;
 rom[512]=32'h5a82a57e;
 rom[513]=32'h5a5ea55b;
 rom[514]=32'h5a3ba537;
 rom[515]=32'h5a17a514;
 rom[516]=32'h59f3a4f1;
 rom[517]=32'h59cfa4cd;
 rom[518]=32'h59aca4aa;
 rom[519]=32'h5988a487;
 rom[520]=32'h5964a464;
 rom[521]=32'h5940a441;
 rom[522]=32'h591ca41e;
 rom[523]=32'h58f8a3fb;
 rom[524]=32'h58d3a3d8;
 rom[525]=32'h58afa3b5;
 rom[526]=32'h588ba392;
 rom[527]=32'h5867a36f;
 rom[528]=32'h5842a34d;
 rom[529]=32'h581ea32a;
 rom[530]=32'h57f9a307;
 rom[531]=32'h57d5a2e5;
 rom[532]=32'h57b0a2c2;
 rom[533]=32'h578ba2a0;
 rom[534]=32'h5767a27e;
 rom[535]=32'h5742a25b;
 rom[536]=32'h571da239;
 rom[537]=32'h56f8a217;
 rom[538]=32'h56d3a1f5;
 rom[539]=32'h56afa1d3;
 rom[540]=32'h568aa1b1;
 rom[541]=32'h5664a18f;
 rom[542]=32'h563fa16d;
 rom[543]=32'h561aa14b;
 rom[544]=32'h55f5a129;
 rom[545]=32'h55d0a108;
 rom[546]=32'h55aaa0e6;
 rom[547]=32'h5585a0c4;
 rom[548]=32'h5560a0a3;
 rom[549]=32'h553aa081;
 rom[550]=32'h5515a060;
 rom[551]=32'h54efa03e;
 rom[552]=32'h54c9a01d;
 rom[553]=32'h54a49ffc;
 rom[554]=32'h547e9fdb;
 rom[555]=32'h54589fb9;
 rom[556]=32'h54329f98;
 rom[557]=32'h540c9f77;
 rom[558]=32'h53e79f56;
 rom[559]=32'h53c19f35;
 rom[560]=32'h539b9f15;
 rom[561]=32'h53749ef4;
 rom[562]=32'h534e9ed3;
 rom[563]=32'h53289eb2;
 rom[564]=32'h53029e92;
 rom[565]=32'h52dc9e71;
 rom[566]=32'h52b59e51;
 rom[567]=32'h528f9e30;
 rom[568]=32'h52689e10;
 rom[569]=32'h52429def;
 rom[570]=32'h521b9dcf;
 rom[571]=32'h51f59daf;
 rom[572]=32'h51ce9d8f;
 rom[573]=32'h51a89d6f;
 rom[574]=32'h51819d4f;
 rom[575]=32'h515a9d2f;
 rom[576]=32'h51339d0f;
 rom[577]=32'h510c9cef;
 rom[578]=32'h50e59ccf;
 rom[579]=32'h50be9caf;
 rom[580]=32'h50979c90;
 rom[581]=32'h50709c70;
 rom[582]=32'h50499c51;
 rom[583]=32'h50229c31;
 rom[584]=32'h4ffb9c12;
 rom[585]=32'h4fd49bf2;
 rom[586]=32'h4fac9bd3;
 rom[587]=32'h4f859bb4;
 rom[588]=32'h4f5d9b94;
 rom[589]=32'h4f369b75;
 rom[590]=32'h4f0e9b56;
 rom[591]=32'h4ee79b37;
 rom[592]=32'h4ebf9b18;
 rom[593]=32'h4e989af9;
 rom[594]=32'h4e709adb;
 rom[595]=32'h4e489abc;
 rom[596]=32'h4e209a9d;
 rom[597]=32'h4df99a7e;
 rom[598]=32'h4dd19a60;
 rom[599]=32'h4da99a41;
 rom[600]=32'h4d819a23;
 rom[601]=32'h4d599a04;
 rom[602]=32'h4d3199e6;
 rom[603]=32'h4d0999c8;
 rom[604]=32'h4ce099aa;
 rom[605]=32'h4cb8998b;
 rom[606]=32'h4c90996d;
 rom[607]=32'h4c68994f;
 rom[608]=32'h4c3f9931;
 rom[609]=32'h4c179913;
 rom[610]=32'h4bee98f6;
 rom[611]=32'h4bc698d8;
 rom[612]=32'h4b9d98ba;
 rom[613]=32'h4b75989c;
 rom[614]=32'h4b4c987f;
 rom[615]=32'h4b249861;
 rom[616]=32'h4afb9844;
 rom[617]=32'h4ad29826;
 rom[618]=32'h4aa99809;
 rom[619]=32'h4a8097ec;
 rom[620]=32'h4a5897ce;
 rom[621]=32'h4a2f97b1;
 rom[622]=32'h4a069794;
 rom[623]=32'h49dd9777;
 rom[624]=32'h49b4975a;
 rom[625]=32'h498a973d;
 rom[626]=32'h49619720;
 rom[627]=32'h49389704;
 rom[628]=32'h490f96e7;
 rom[629]=32'h48e596ca;
 rom[630]=32'h48bc96ae;
 rom[631]=32'h48939691;
 rom[632]=32'h48699675;
 rom[633]=32'h48409658;
 rom[634]=32'h4816963c;
 rom[635]=32'h47ed9620;
 rom[636]=32'h47c39603;
 rom[637]=32'h479a95e7;
 rom[638]=32'h477095cb;
 rom[639]=32'h474695af;
 rom[640]=32'h471c9593;
 rom[641]=32'h46f39577;
 rom[642]=32'h46c9955c;
 rom[643]=32'h469f9540;
 rom[644]=32'h46759524;
 rom[645]=32'h464b9508;
 rom[646]=32'h462194ed;
 rom[647]=32'h45f794d1;
 rom[648]=32'h45cd94b6;
 rom[649]=32'h45a3949b;
 rom[650]=32'h4578947f;
 rom[651]=32'h454e9464;
 rom[652]=32'h45249449;
 rom[653]=32'h44f9942e;
 rom[654]=32'h44cf9413;
 rom[655]=32'h44a593f8;
 rom[656]=32'h447a93dd;
 rom[657]=32'h445093c2;
 rom[658]=32'h442593a7;
 rom[659]=32'h43fb938c;
 rom[660]=32'h43d09372;
 rom[661]=32'h43a59357;
 rom[662]=32'h437b933d;
 rom[663]=32'h43509322;
 rom[664]=32'h43259308;
 rom[665]=32'h42fa92ed;
 rom[666]=32'h42d092d3;
 rom[667]=32'h42a592b9;
 rom[668]=32'h427a929f;
 rom[669]=32'h424f9285;
 rom[670]=32'h4224926b;
 rom[671]=32'h41f99251;
 rom[672]=32'h41ce9237;
 rom[673]=32'h41a2921d;
 rom[674]=32'h41779203;
 rom[675]=32'h414c91ea;
 rom[676]=32'h412191d0;
 rom[677]=32'h40f691b6;
 rom[678]=32'h40ca919d;
 rom[679]=32'h409f9184;
 rom[680]=32'h4073916a;
 rom[681]=32'h40489151;
 rom[682]=32'h401d9138;
 rom[683]=32'h3ff1911f;
 rom[684]=32'h3fc59105;
 rom[685]=32'h3f9a90ec;
 rom[686]=32'h3f6e90d4;
 rom[687]=32'h3f4390bb;
 rom[688]=32'h3f1790a2;
 rom[689]=32'h3eeb9089;
 rom[690]=32'h3ebf9070;
 rom[691]=32'h3e939058;
 rom[692]=32'h3e68903f;
 rom[693]=32'h3e3c9027;
 rom[694]=32'h3e10900e;
 rom[695]=32'h3de48ff6;
 rom[696]=32'h3db88fde;
 rom[697]=32'h3d8c8fc6;
 rom[698]=32'h3d608fad;
 rom[699]=32'h3d338f95;
 rom[700]=32'h3d078f7d;
 rom[701]=32'h3cdb8f65;
 rom[702]=32'h3caf8f4e;
 rom[703]=32'h3c838f36;
 rom[704]=32'h3c568f1e;
 rom[705]=32'h3c2a8f06;
 rom[706]=32'h3bfe8eef;
 rom[707]=32'h3bd18ed7;
 rom[708]=32'h3ba58ec0;
 rom[709]=32'h3b788ea8;
 rom[710]=32'h3b4c8e91;
 rom[711]=32'h3b1f8e7a;
 rom[712]=32'h3af28e63;
 rom[713]=32'h3ac68e4c;
 rom[714]=32'h3a998e35;
 rom[715]=32'h3a6c8e1e;
 rom[716]=32'h3a408e07;
 rom[717]=32'h3a138df0;
 rom[718]=32'h39e68dd9;
 rom[719]=32'h39b98dc2;
 rom[720]=32'h398c8dac;
 rom[721]=32'h39608d95;
 rom[722]=32'h39338d7f;
 rom[723]=32'h39068d68;
 rom[724]=32'h38d98d52;
 rom[725]=32'h38ab8d3c;
 rom[726]=32'h387e8d25;
 rom[727]=32'h38518d0f;
 rom[728]=32'h38248cf9;
 rom[729]=32'h37f78ce3;
 rom[730]=32'h37ca8ccd;
 rom[731]=32'h379c8cb7;
 rom[732]=32'h376f8ca2;
 rom[733]=32'h37428c8c;
 rom[734]=32'h37158c76;
 rom[735]=32'h36e78c61;
 rom[736]=32'h36ba8c4b;
 rom[737]=32'h368c8c36;
 rom[738]=32'h365f8c20;
 rom[739]=32'h36318c0b;
 rom[740]=32'h36048bf6;
 rom[741]=32'h35d68be0;
 rom[742]=32'h35a88bcb;
 rom[743]=32'h357b8bb6;
 rom[744]=32'h354d8ba1;
 rom[745]=32'h351f8b8c;
 rom[746]=32'h34f28b78;
 rom[747]=32'h34c48b63;
 rom[748]=32'h34968b4e;
 rom[749]=32'h34688b3a;
 rom[750]=32'h343a8b25;
 rom[751]=32'h340c8b10;
 rom[752]=32'h33df8afc;
 rom[753]=32'h33b18ae8;
 rom[754]=32'h33838ad3;
 rom[755]=32'h33558abf;
 rom[756]=32'h33268aab;
 rom[757]=32'h32f88a97;
 rom[758]=32'h32ca8a83;
 rom[759]=32'h329c8a6f;
 rom[760]=32'h326e8a5b;
 rom[761]=32'h32408a48;
 rom[762]=32'h32118a34;
 rom[763]=32'h31e38a20;
 rom[764]=32'h31b58a0d;
 rom[765]=32'h318789f9;
 rom[766]=32'h315889e6;
 rom[767]=32'h312a89d3;
 rom[768]=32'h30fb89bf;
 rom[769]=32'h30cd89ac;
 rom[770]=32'h309e8999;
 rom[771]=32'h30708986;
 rom[772]=32'h30418973;
 rom[773]=32'h30138960;
 rom[774]=32'h2fe4894d;
 rom[775]=32'h2fb6893a;
 rom[776]=32'h2f878928;
 rom[777]=32'h2f588915;
 rom[778]=32'h2f2a8902;
 rom[779]=32'h2efb88f0;
 rom[780]=32'h2ecc88de;
 rom[781]=32'h2e9d88cb;
 rom[782]=32'h2e6e88b9;
 rom[783]=32'h2e4088a7;
 rom[784]=32'h2e118895;
 rom[785]=32'h2de28883;
 rom[786]=32'h2db38871;
 rom[787]=32'h2d84885f;
 rom[788]=32'h2d55884d;
 rom[789]=32'h2d26883b;
 rom[790]=32'h2cf78829;
 rom[791]=32'h2cc88818;
 rom[792]=32'h2c998806;
 rom[793]=32'h2c6a87f5;
 rom[794]=32'h2c3a87e3;
 rom[795]=32'h2c0b87d2;
 rom[796]=32'h2bdc87c1;
 rom[797]=32'h2bad87b0;
 rom[798]=32'h2b7d879e;
 rom[799]=32'h2b4e878d;
 rom[800]=32'h2b1f877c;
 rom[801]=32'h2af0876c;
 rom[802]=32'h2ac0875b;
 rom[803]=32'h2a91874a;
 rom[804]=32'h2a618739;
 rom[805]=32'h2a328729;
 rom[806]=32'h2a028718;
 rom[807]=32'h29d38708;
 rom[808]=32'h29a386f7;
 rom[809]=32'h297486e7;
 rom[810]=32'h294486d7;
 rom[811]=32'h291586c7;
 rom[812]=32'h28e586b6;
 rom[813]=32'h28b586a6;
 rom[814]=32'h28868696;
 rom[815]=32'h28568687;
 rom[816]=32'h28268677;
 rom[817]=32'h27f78667;
 rom[818]=32'h27c78657;
 rom[819]=32'h27978648;
 rom[820]=32'h27678638;
 rom[821]=32'h27378629;
 rom[822]=32'h2708861a;
 rom[823]=32'h26d8860a;
 rom[824]=32'h26a885fb;
 rom[825]=32'h267885ec;
 rom[826]=32'h264885dd;
 rom[827]=32'h261885ce;
 rom[828]=32'h25e885bf;
 rom[829]=32'h25b885b0;
 rom[830]=32'h258885a1;
 rom[831]=32'h25588593;
 rom[832]=32'h25288584;
 rom[833]=32'h24f88575;
 rom[834]=32'h24c88567;
 rom[835]=32'h24978558;
 rom[836]=32'h2467854a;
 rom[837]=32'h2437853c;
 rom[838]=32'h2407852e;
 rom[839]=32'h23d78520;
 rom[840]=32'h23a68512;
 rom[841]=32'h23768504;
 rom[842]=32'h234684f6;
 rom[843]=32'h231584e8;
 rom[844]=32'h22e584da;
 rom[845]=32'h22b584cd;
 rom[846]=32'h228484bf;
 rom[847]=32'h225484b1;
 rom[848]=32'h222384a4;
 rom[849]=32'h21f38497;
 rom[850]=32'h21c28489;
 rom[851]=32'h2192847c;
 rom[852]=32'h2161846f;
 rom[853]=32'h21318462;
 rom[854]=32'h21008455;
 rom[855]=32'h20d08448;
 rom[856]=32'h209f843b;
 rom[857]=32'h206f842e;
 rom[858]=32'h203e8422;
 rom[859]=32'h200d8415;
 rom[860]=32'h1fdd8408;
 rom[861]=32'h1fac83fc;
 rom[862]=32'h1f7b83f0;
 rom[863]=32'h1f4a83e3;
 rom[864]=32'h1f1a83d7;
 rom[865]=32'h1ee983cb;
 rom[866]=32'h1eb883bf;
 rom[867]=32'h1e8783b3;
 rom[868]=32'h1e5783a7;
 rom[869]=32'h1e26839b;
 rom[870]=32'h1df5838f;
 rom[871]=32'h1dc48383;
 rom[872]=32'h1d938378;
 rom[873]=32'h1d62836c;
 rom[874]=32'h1d318361;
 rom[875]=32'h1d008355;
 rom[876]=32'h1ccf834a;
 rom[877]=32'h1c9e833f;
 rom[878]=32'h1c6d8333;
 rom[879]=32'h1c3c8328;
 rom[880]=32'h1c0b831d;
 rom[881]=32'h1bda8312;
 rom[882]=32'h1ba98307;
 rom[883]=32'h1b7882fc;
 rom[884]=32'h1b4782f2;
 rom[885]=32'h1b1682e7;
 rom[886]=32'h1ae582dc;
 rom[887]=32'h1ab482d2;
 rom[888]=32'h1a8282c7;
 rom[889]=32'h1a5182bd;
 rom[890]=32'h1a2082b3;
 rom[891]=32'h19ef82a9;
 rom[892]=32'h19be829e;
 rom[893]=32'h198c8294;
 rom[894]=32'h195b828a;
 rom[895]=32'h192a8280;
 rom[896]=32'h18f98277;
 rom[897]=32'h18c7826d;
 rom[898]=32'h18968263;
 rom[899]=32'h1865825a;
 rom[900]=32'h18338250;
 rom[901]=32'h18028247;
 rom[902]=32'h17d0823d;
 rom[903]=32'h179f8234;
 rom[904]=32'h176e822b;
 rom[905]=32'h173c8221;
 rom[906]=32'h170b8218;
 rom[907]=32'h16d9820f;
 rom[908]=32'h16a88206;
 rom[909]=32'h167681fe;
 rom[910]=32'h164581f5;
 rom[911]=32'h161381ec;
 rom[912]=32'h15e281e3;
 rom[913]=32'h15b081db;
 rom[914]=32'h157f81d2;
 rom[915]=32'h154d81ca;
 rom[916]=32'h151c81c2;
 rom[917]=32'h14ea81b9;
 rom[918]=32'h14b981b1;
 rom[919]=32'h148781a9;
 rom[920]=32'h145581a1;
 rom[921]=32'h14248199;
 rom[922]=32'h13f28191;
 rom[923]=32'h13c08189;
 rom[924]=32'h138f8182;
 rom[925]=32'h135d817a;
 rom[926]=32'h132b8173;
 rom[927]=32'h12fa816b;
 rom[928]=32'h12c88164;
 rom[929]=32'h1296815c;
 rom[930]=32'h12648155;
 rom[931]=32'h1233814e;
 rom[932]=32'h12018147;
 rom[933]=32'h11cf8140;
 rom[934]=32'h119d8139;
 rom[935]=32'h116c8132;
 rom[936]=32'h113a812b;
 rom[937]=32'h11088124;
 rom[938]=32'h10d6811e;
 rom[939]=32'h10a48117;
 rom[940]=32'h10728111;
 rom[941]=32'h1041810a;
 rom[942]=32'h100f8104;
 rom[943]=32'h0fdd80fe;
 rom[944]=32'h0fab80f7;
 rom[945]=32'h0f7980f1;
 rom[946]=32'h0f4780eb;
 rom[947]=32'h0f1580e5;
 rom[948]=32'h0ee380df;
 rom[949]=32'h0eb180da;
 rom[950]=32'h0e8080d4;
 rom[951]=32'h0e4e80ce;
 rom[952]=32'h0e1c80c9;
 rom[953]=32'h0dea80c3;
 rom[954]=32'h0db880be;
 rom[955]=32'h0d8680b8;
 rom[956]=32'h0d5480b3;
 rom[957]=32'h0d2280ae;
 rom[958]=32'h0cf080a9;
 rom[959]=32'h0cbe80a4;
 rom[960]=32'h0c8c809f;
 rom[961]=32'h0c5a809a;
 rom[962]=32'h0c288095;
 rom[963]=32'h0bf68090;
 rom[964]=32'h0bc4808c;
 rom[965]=32'h0b928087;
 rom[966]=32'h0b5f8083;
 rom[967]=32'h0b2d807e;
 rom[968]=32'h0afb807a;
 rom[969]=32'h0ac98076;
 rom[970]=32'h0a978071;
 rom[971]=32'h0a65806d;
 rom[972]=32'h0a338069;
 rom[973]=32'h0a018065;
 rom[974]=32'h09cf8061;
 rom[975]=32'h099d805e;
 rom[976]=32'h096a805a;
 rom[977]=32'h09388056;
 rom[978]=32'h09068053;
 rom[979]=32'h08d4804f;
 rom[980]=32'h08a2804c;
 rom[981]=32'h08708048;
 rom[982]=32'h083e8045;
 rom[983]=32'h080b8042;
 rom[984]=32'h07d9803f;
 rom[985]=32'h07a7803c;
 rom[986]=32'h07758039;
 rom[987]=32'h07438036;
 rom[988]=32'h07118033;
 rom[989]=32'h06de8030;
 rom[990]=32'h06ac802e;
 rom[991]=32'h067a802b;
 rom[992]=32'h06488028;
 rom[993]=32'h06168026;
 rom[994]=32'h05e38024;
 rom[995]=32'h05b18021;
 rom[996]=32'h057f801f;
 rom[997]=32'h054d801d;
 rom[998]=32'h051b801b;
 rom[999]=32'h04e88019;
 rom[1000]=32'h04b68017;
 rom[1001]=32'h04848015;
 rom[1002]=32'h04528014;
 rom[1003]=32'h041f8012;
 rom[1004]=32'h03ed8010;
 rom[1005]=32'h03bb800f;
 rom[1006]=32'h0389800d;
 rom[1007]=32'h0356800c;
 rom[1008]=32'h0324800b;
 rom[1009]=32'h02f2800a;
 rom[1010]=32'h02c08009;
 rom[1011]=32'h028d8008;
 rom[1012]=32'h025b8007;
 rom[1013]=32'h02298006;
 rom[1014]=32'h01f78005;
 rom[1015]=32'h01c48004;
 rom[1016]=32'h01928003;
 rom[1017]=32'h01608003;
 rom[1018]=32'h012e8002;
 rom[1019]=32'h00fb8002;
 rom[1020]=32'h00c98002;
 rom[1021]=32'h00978001;
 rom[1022]=32'h00658001;
 rom[1023]=32'h00328001;
 rom[1024]=32'h00008001;
 rom[1025]=32'hffce8001;
 rom[1026]=32'hff9b8001;
 rom[1027]=32'hff698001;
 rom[1028]=32'hff378002;
 rom[1029]=32'hff058002;
 rom[1030]=32'hfed28002;
 rom[1031]=32'hfea08003;
 rom[1032]=32'hfe6e8003;
 rom[1033]=32'hfe3c8004;
 rom[1034]=32'hfe098005;
 rom[1035]=32'hfdd78006;
 rom[1036]=32'hfda58007;
 rom[1037]=32'hfd738008;
 rom[1038]=32'hfd408009;
 rom[1039]=32'hfd0e800a;
 rom[1040]=32'hfcdc800b;
 rom[1041]=32'hfcaa800c;
 rom[1042]=32'hfc77800d;
 rom[1043]=32'hfc45800f;
 rom[1044]=32'hfc138010;
 rom[1045]=32'hfbe18012;
 rom[1046]=32'hfbae8014;
 rom[1047]=32'hfb7c8015;
 rom[1048]=32'hfb4a8017;
 rom[1049]=32'hfb188019;
 rom[1050]=32'hfae5801b;
 rom[1051]=32'hfab3801d;
 rom[1052]=32'hfa81801f;
 rom[1053]=32'hfa4f8021;
 rom[1054]=32'hfa1d8024;
 rom[1055]=32'hf9ea8026;
 rom[1056]=32'hf9b88028;
 rom[1057]=32'hf986802b;
 rom[1058]=32'hf954802e;
 rom[1059]=32'hf9228030;
 rom[1060]=32'hf8ef8033;
 rom[1061]=32'hf8bd8036;
 rom[1062]=32'hf88b8039;
 rom[1063]=32'hf859803c;
 rom[1064]=32'hf827803f;
 rom[1065]=32'hf7f58042;
 rom[1066]=32'hf7c28045;
 rom[1067]=32'hf7908048;
 rom[1068]=32'hf75e804c;
 rom[1069]=32'hf72c804f;
 rom[1070]=32'hf6fa8053;
 rom[1071]=32'hf6c88056;
 rom[1072]=32'hf696805a;
 rom[1073]=32'hf663805e;
 rom[1074]=32'hf6318061;
 rom[1075]=32'hf5ff8065;
 rom[1076]=32'hf5cd8069;
 rom[1077]=32'hf59b806d;
 rom[1078]=32'hf5698071;
 rom[1079]=32'hf5378076;
 rom[1080]=32'hf505807a;
 rom[1081]=32'hf4d3807e;
 rom[1082]=32'hf4a18083;
 rom[1083]=32'hf46e8087;
 rom[1084]=32'hf43c808c;
 rom[1085]=32'hf40a8090;
 rom[1086]=32'hf3d88095;
 rom[1087]=32'hf3a6809a;
 rom[1088]=32'hf374809f;
 rom[1089]=32'hf34280a4;
 rom[1090]=32'hf31080a9;
 rom[1091]=32'hf2de80ae;
 rom[1092]=32'hf2ac80b3;
 rom[1093]=32'hf27a80b8;
 rom[1094]=32'hf24880be;
 rom[1095]=32'hf21680c3;
 rom[1096]=32'hf1e480c9;
 rom[1097]=32'hf1b280ce;
 rom[1098]=32'hf18080d4;
 rom[1099]=32'hf14f80da;
 rom[1100]=32'hf11d80df;
 rom[1101]=32'hf0eb80e5;
 rom[1102]=32'hf0b980eb;
 rom[1103]=32'hf08780f1;
 rom[1104]=32'hf05580f7;
 rom[1105]=32'hf02380fe;
 rom[1106]=32'heff18104;
 rom[1107]=32'hefbf810a;
 rom[1108]=32'hef8e8111;
 rom[1109]=32'hef5c8117;
 rom[1110]=32'hef2a811e;
 rom[1111]=32'heef88124;
 rom[1112]=32'heec6812b;
 rom[1113]=32'hee948132;
 rom[1114]=32'hee638139;
 rom[1115]=32'hee318140;
 rom[1116]=32'hedff8147;
 rom[1117]=32'hedcd814e;
 rom[1118]=32'hed9c8155;
 rom[1119]=32'hed6a815c;
 rom[1120]=32'hed388164;
 rom[1121]=32'hed06816b;
 rom[1122]=32'hecd58173;
 rom[1123]=32'heca3817a;
 rom[1124]=32'hec718182;
 rom[1125]=32'hec408189;
 rom[1126]=32'hec0e8191;
 rom[1127]=32'hebdc8199;
 rom[1128]=32'hebab81a1;
 rom[1129]=32'heb7981a9;
 rom[1130]=32'heb4781b1;
 rom[1131]=32'heb1681b9;
 rom[1132]=32'heae481c2;
 rom[1133]=32'heab381ca;
 rom[1134]=32'hea8181d2;
 rom[1135]=32'hea5081db;
 rom[1136]=32'hea1e81e3;
 rom[1137]=32'he9ed81ec;
 rom[1138]=32'he9bb81f5;
 rom[1139]=32'he98a81fe;
 rom[1140]=32'he9588206;
 rom[1141]=32'he927820f;
 rom[1142]=32'he8f58218;
 rom[1143]=32'he8c48221;
 rom[1144]=32'he892822b;
 rom[1145]=32'he8618234;
 rom[1146]=32'he830823d;
 rom[1147]=32'he7fe8247;
 rom[1148]=32'he7cd8250;
 rom[1149]=32'he79b825a;
 rom[1150]=32'he76a8263;
 rom[1151]=32'he739826d;
 rom[1152]=32'he7078277;
 rom[1153]=32'he6d68280;
 rom[1154]=32'he6a5828a;
 rom[1155]=32'he6748294;
 rom[1156]=32'he642829e;
 rom[1157]=32'he61182a9;
 rom[1158]=32'he5e082b3;
 rom[1159]=32'he5af82bd;
 rom[1160]=32'he57e82c7;
 rom[1161]=32'he54c82d2;
 rom[1162]=32'he51b82dc;
 rom[1163]=32'he4ea82e7;
 rom[1164]=32'he4b982f2;
 rom[1165]=32'he48882fc;
 rom[1166]=32'he4578307;
 rom[1167]=32'he4268312;
 rom[1168]=32'he3f5831d;
 rom[1169]=32'he3c48328;
 rom[1170]=32'he3938333;
 rom[1171]=32'he362833f;
 rom[1172]=32'he331834a;
 rom[1173]=32'he3008355;
 rom[1174]=32'he2cf8361;
 rom[1175]=32'he29e836c;
 rom[1176]=32'he26d8378;
 rom[1177]=32'he23c8383;
 rom[1178]=32'he20b838f;
 rom[1179]=32'he1da839b;
 rom[1180]=32'he1a983a7;
 rom[1181]=32'he17983b3;
 rom[1182]=32'he14883bf;
 rom[1183]=32'he11783cb;
 rom[1184]=32'he0e683d7;
 rom[1185]=32'he0b683e3;
 rom[1186]=32'he08583f0;
 rom[1187]=32'he05483fc;
 rom[1188]=32'he0238408;
 rom[1189]=32'hdff38415;
 rom[1190]=32'hdfc28422;
 rom[1191]=32'hdf91842e;
 rom[1192]=32'hdf61843b;
 rom[1193]=32'hdf308448;
 rom[1194]=32'hdf008455;
 rom[1195]=32'hdecf8462;
 rom[1196]=32'hde9f846f;
 rom[1197]=32'hde6e847c;
 rom[1198]=32'hde3e8489;
 rom[1199]=32'hde0d8497;
 rom[1200]=32'hdddd84a4;
 rom[1201]=32'hddac84b1;
 rom[1202]=32'hdd7c84bf;
 rom[1203]=32'hdd4b84cd;
 rom[1204]=32'hdd1b84da;
 rom[1205]=32'hdceb84e8;
 rom[1206]=32'hdcba84f6;
 rom[1207]=32'hdc8a8504;
 rom[1208]=32'hdc5a8512;
 rom[1209]=32'hdc298520;
 rom[1210]=32'hdbf9852e;
 rom[1211]=32'hdbc9853c;
 rom[1212]=32'hdb99854a;
 rom[1213]=32'hdb698558;
 rom[1214]=32'hdb388567;
 rom[1215]=32'hdb088575;
 rom[1216]=32'hdad88584;
 rom[1217]=32'hdaa88593;
 rom[1218]=32'hda7885a1;
 rom[1219]=32'hda4885b0;
 rom[1220]=32'hda1885bf;
 rom[1221]=32'hd9e885ce;
 rom[1222]=32'hd9b885dd;
 rom[1223]=32'hd98885ec;
 rom[1224]=32'hd95885fb;
 rom[1225]=32'hd928860a;
 rom[1226]=32'hd8f8861a;
 rom[1227]=32'hd8c98629;
 rom[1228]=32'hd8998638;
 rom[1229]=32'hd8698648;
 rom[1230]=32'hd8398657;
 rom[1231]=32'hd8098667;
 rom[1232]=32'hd7da8677;
 rom[1233]=32'hd7aa8687;
 rom[1234]=32'hd77a8696;
 rom[1235]=32'hd74b86a6;
 rom[1236]=32'hd71b86b6;
 rom[1237]=32'hd6eb86c7;
 rom[1238]=32'hd6bc86d7;
 rom[1239]=32'hd68c86e7;
 rom[1240]=32'hd65d86f7;
 rom[1241]=32'hd62d8708;
 rom[1242]=32'hd5fe8718;
 rom[1243]=32'hd5ce8729;
 rom[1244]=32'hd59f8739;
 rom[1245]=32'hd56f874a;
 rom[1246]=32'hd540875b;
 rom[1247]=32'hd510876c;
 rom[1248]=32'hd4e1877c;
 rom[1249]=32'hd4b2878d;
 rom[1250]=32'hd483879e;
 rom[1251]=32'hd45387b0;
 rom[1252]=32'hd42487c1;
 rom[1253]=32'hd3f587d2;
 rom[1254]=32'hd3c687e3;
 rom[1255]=32'hd39687f5;
 rom[1256]=32'hd3678806;
 rom[1257]=32'hd3388818;
 rom[1258]=32'hd3098829;
 rom[1259]=32'hd2da883b;
 rom[1260]=32'hd2ab884d;
 rom[1261]=32'hd27c885f;
 rom[1262]=32'hd24d8871;
 rom[1263]=32'hd21e8883;
 rom[1264]=32'hd1ef8895;
 rom[1265]=32'hd1c088a7;
 rom[1266]=32'hd19288b9;
 rom[1267]=32'hd16388cb;
 rom[1268]=32'hd13488de;
 rom[1269]=32'hd10588f0;
 rom[1270]=32'hd0d68902;
 rom[1271]=32'hd0a88915;
 rom[1272]=32'hd0798928;
 rom[1273]=32'hd04a893a;
 rom[1274]=32'hd01c894d;
 rom[1275]=32'hcfed8960;
 rom[1276]=32'hcfbf8973;
 rom[1277]=32'hcf908986;
 rom[1278]=32'hcf628999;
 rom[1279]=32'hcf3389ac;
 rom[1280]=32'hcf0589bf;
 rom[1281]=32'hced689d3;
 rom[1282]=32'hcea889e6;
 rom[1283]=32'hce7989f9;
 rom[1284]=32'hce4b8a0d;
 rom[1285]=32'hce1d8a20;
 rom[1286]=32'hcdef8a34;
 rom[1287]=32'hcdc08a48;
 rom[1288]=32'hcd928a5b;
 rom[1289]=32'hcd648a6f;
 rom[1290]=32'hcd368a83;
 rom[1291]=32'hcd088a97;
 rom[1292]=32'hccda8aab;
 rom[1293]=32'hccab8abf;
 rom[1294]=32'hcc7d8ad3;
 rom[1295]=32'hcc4f8ae8;
 rom[1296]=32'hcc218afc;
 rom[1297]=32'hcbf48b10;
 rom[1298]=32'hcbc68b25;
 rom[1299]=32'hcb988b3a;
 rom[1300]=32'hcb6a8b4e;
 rom[1301]=32'hcb3c8b63;
 rom[1302]=32'hcb0e8b78;
 rom[1303]=32'hcae18b8c;
 rom[1304]=32'hcab38ba1;
 rom[1305]=32'hca858bb6;
 rom[1306]=32'hca588bcb;
 rom[1307]=32'hca2a8be0;
 rom[1308]=32'hc9fc8bf6;
 rom[1309]=32'hc9cf8c0b;
 rom[1310]=32'hc9a18c20;
 rom[1311]=32'hc9748c36;
 rom[1312]=32'hc9468c4b;
 rom[1313]=32'hc9198c61;
 rom[1314]=32'hc8eb8c76;
 rom[1315]=32'hc8be8c8c;
 rom[1316]=32'hc8918ca2;
 rom[1317]=32'hc8648cb7;
 rom[1318]=32'hc8368ccd;
 rom[1319]=32'hc8098ce3;
 rom[1320]=32'hc7dc8cf9;
 rom[1321]=32'hc7af8d0f;
 rom[1322]=32'hc7828d25;
 rom[1323]=32'hc7558d3c;
 rom[1324]=32'hc7278d52;
 rom[1325]=32'hc6fa8d68;
 rom[1326]=32'hc6cd8d7f;
 rom[1327]=32'hc6a08d95;
 rom[1328]=32'hc6748dac;
 rom[1329]=32'hc6478dc2;
 rom[1330]=32'hc61a8dd9;
 rom[1331]=32'hc5ed8df0;
 rom[1332]=32'hc5c08e07;
 rom[1333]=32'hc5948e1e;
 rom[1334]=32'hc5678e35;
 rom[1335]=32'hc53a8e4c;
 rom[1336]=32'hc50e8e63;
 rom[1337]=32'hc4e18e7a;
 rom[1338]=32'hc4b48e91;
 rom[1339]=32'hc4888ea8;
 rom[1340]=32'hc45b8ec0;
 rom[1341]=32'hc42f8ed7;
 rom[1342]=32'hc4028eef;
 rom[1343]=32'hc3d68f06;
 rom[1344]=32'hc3aa8f1e;
 rom[1345]=32'hc37d8f36;
 rom[1346]=32'hc3518f4e;
 rom[1347]=32'hc3258f65;
 rom[1348]=32'hc2f98f7d;
 rom[1349]=32'hc2cd8f95;
 rom[1350]=32'hc2a08fad;
 rom[1351]=32'hc2748fc6;
 rom[1352]=32'hc2488fde;
 rom[1353]=32'hc21c8ff6;
 rom[1354]=32'hc1f0900e;
 rom[1355]=32'hc1c49027;
 rom[1356]=32'hc198903f;
 rom[1357]=32'hc16d9058;
 rom[1358]=32'hc1419070;
 rom[1359]=32'hc1159089;
 rom[1360]=32'hc0e990a2;
 rom[1361]=32'hc0bd90bb;
 rom[1362]=32'hc09290d4;
 rom[1363]=32'hc06690ec;
 rom[1364]=32'hc03b9105;
 rom[1365]=32'hc00f911f;
 rom[1366]=32'hbfe39138;
 rom[1367]=32'hbfb89151;
 rom[1368]=32'hbf8d916a;
 rom[1369]=32'hbf619184;
 rom[1370]=32'hbf36919d;
 rom[1371]=32'hbf0a91b6;
 rom[1372]=32'hbedf91d0;
 rom[1373]=32'hbeb491ea;
 rom[1374]=32'hbe899203;
 rom[1375]=32'hbe5e921d;
 rom[1376]=32'hbe329237;
 rom[1377]=32'hbe079251;
 rom[1378]=32'hbddc926b;
 rom[1379]=32'hbdb19285;
 rom[1380]=32'hbd86929f;
 rom[1381]=32'hbd5b92b9;
 rom[1382]=32'hbd3092d3;
 rom[1383]=32'hbd0692ed;
 rom[1384]=32'hbcdb9308;
 rom[1385]=32'hbcb09322;
 rom[1386]=32'hbc85933d;
 rom[1387]=32'hbc5b9357;
 rom[1388]=32'hbc309372;
 rom[1389]=32'hbc05938c;
 rom[1390]=32'hbbdb93a7;
 rom[1391]=32'hbbb093c2;
 rom[1392]=32'hbb8693dd;
 rom[1393]=32'hbb5b93f8;
 rom[1394]=32'hbb319413;
 rom[1395]=32'hbb07942e;
 rom[1396]=32'hbadc9449;
 rom[1397]=32'hbab29464;
 rom[1398]=32'hba88947f;
 rom[1399]=32'hba5d949b;
 rom[1400]=32'hba3394b6;
 rom[1401]=32'hba0994d1;
 rom[1402]=32'hb9df94ed;
 rom[1403]=32'hb9b59508;
 rom[1404]=32'hb98b9524;
 rom[1405]=32'hb9619540;
 rom[1406]=32'hb937955c;
 rom[1407]=32'hb90d9577;
 rom[1408]=32'hb8e49593;
 rom[1409]=32'hb8ba95af;
 rom[1410]=32'hb89095cb;
 rom[1411]=32'hb86695e7;
 rom[1412]=32'hb83d9603;
 rom[1413]=32'hb8139620;
 rom[1414]=32'hb7ea963c;
 rom[1415]=32'hb7c09658;
 rom[1416]=32'hb7979675;
 rom[1417]=32'hb76d9691;
 rom[1418]=32'hb74496ae;
 rom[1419]=32'hb71b96ca;
 rom[1420]=32'hb6f196e7;
 rom[1421]=32'hb6c89704;
 rom[1422]=32'hb69f9720;
 rom[1423]=32'hb676973d;
 rom[1424]=32'hb64c975a;
 rom[1425]=32'hb6239777;
 rom[1426]=32'hb5fa9794;
 rom[1427]=32'hb5d197b1;
 rom[1428]=32'hb5a897ce;
 rom[1429]=32'hb58097ec;
 rom[1430]=32'hb5579809;
 rom[1431]=32'hb52e9826;
 rom[1432]=32'hb5059844;
 rom[1433]=32'hb4dc9861;
 rom[1434]=32'hb4b4987f;
 rom[1435]=32'hb48b989c;
 rom[1436]=32'hb46398ba;
 rom[1437]=32'hb43a98d8;
 rom[1438]=32'hb41298f6;
 rom[1439]=32'hb3e99913;
 rom[1440]=32'hb3c19931;
 rom[1441]=32'hb398994f;
 rom[1442]=32'hb370996d;
 rom[1443]=32'hb348998b;
 rom[1444]=32'hb32099aa;
 rom[1445]=32'hb2f799c8;
 rom[1446]=32'hb2cf99e6;
 rom[1447]=32'hb2a79a04;
 rom[1448]=32'hb27f9a23;
 rom[1449]=32'hb2579a41;
 rom[1450]=32'hb22f9a60;
 rom[1451]=32'hb2079a7e;
 rom[1452]=32'hb1e09a9d;
 rom[1453]=32'hb1b89abc;
 rom[1454]=32'hb1909adb;
 rom[1455]=32'hb1689af9;
 rom[1456]=32'hb1419b18;
 rom[1457]=32'hb1199b37;
 rom[1458]=32'hb0f29b56;
 rom[1459]=32'hb0ca9b75;
 rom[1460]=32'hb0a39b94;
 rom[1461]=32'hb07b9bb4;
 rom[1462]=32'hb0549bd3;
 rom[1463]=32'hb02c9bf2;
 rom[1464]=32'hb0059c12;
 rom[1465]=32'hafde9c31;
 rom[1466]=32'hafb79c51;
 rom[1467]=32'haf909c70;
 rom[1468]=32'haf699c90;
 rom[1469]=32'haf429caf;
 rom[1470]=32'haf1b9ccf;
 rom[1471]=32'haef49cef;
 rom[1472]=32'haecd9d0f;
 rom[1473]=32'haea69d2f;
 rom[1474]=32'hae7f9d4f;
 rom[1475]=32'hae589d6f;
 rom[1476]=32'hae329d8f;
 rom[1477]=32'hae0b9daf;
 rom[1478]=32'hade59dcf;
 rom[1479]=32'hadbe9def;
 rom[1480]=32'had989e10;
 rom[1481]=32'had719e30;
 rom[1482]=32'had4b9e51;
 rom[1483]=32'had249e71;
 rom[1484]=32'hacfe9e92;
 rom[1485]=32'hacd89eb2;
 rom[1486]=32'hacb29ed3;
 rom[1487]=32'hac8c9ef4;
 rom[1488]=32'hac659f15;
 rom[1489]=32'hac3f9f35;
 rom[1490]=32'hac199f56;
 rom[1491]=32'habf49f77;
 rom[1492]=32'habce9f98;
 rom[1493]=32'haba89fb9;
 rom[1494]=32'hab829fdb;
 rom[1495]=32'hab5c9ffc;
 rom[1496]=32'hab37a01d;
 rom[1497]=32'hab11a03e;
 rom[1498]=32'haaeba060;
 rom[1499]=32'haac6a081;
 rom[1500]=32'haaa0a0a3;
 rom[1501]=32'haa7ba0c4;
 rom[1502]=32'haa56a0e6;
 rom[1503]=32'haa30a108;
 rom[1504]=32'haa0ba129;
 rom[1505]=32'ha9e6a14b;
 rom[1506]=32'ha9c1a16d;
 rom[1507]=32'ha99ca18f;
 rom[1508]=32'ha976a1b1;
 rom[1509]=32'ha951a1d3;
 rom[1510]=32'ha92da1f5;
 rom[1511]=32'ha908a217;
 rom[1512]=32'ha8e3a239;
 rom[1513]=32'ha8bea25b;
 rom[1514]=32'ha899a27e;
 rom[1515]=32'ha875a2a0;
 rom[1516]=32'ha850a2c2;
 rom[1517]=32'ha82ba2e5;
 rom[1518]=32'ha807a307;
 rom[1519]=32'ha7e2a32a;
 rom[1520]=32'ha7bea34d;
 rom[1521]=32'ha799a36f;
 rom[1522]=32'ha775a392;
 rom[1523]=32'ha751a3b5;
 rom[1524]=32'ha72da3d8;
 rom[1525]=32'ha708a3fb;
 rom[1526]=32'ha6e4a41e;
 rom[1527]=32'ha6c0a441;
 rom[1528]=32'ha69ca464;
 rom[1529]=32'ha678a487;
 rom[1530]=32'ha654a4aa;
 rom[1531]=32'ha631a4cd;
 rom[1532]=32'ha60da4f1;
 rom[1533]=32'ha5e9a514;
 rom[1534]=32'ha5c5a537;
 rom[1535]=32'ha5a2a55b;
 rom[1536]=32'ha57ea57e;
 rom[1537]=32'ha55ba5a2;
 rom[1538]=32'ha537a5c5;
 rom[1539]=32'ha514a5e9;
 rom[1540]=32'ha4f1a60d;
 rom[1541]=32'ha4cda631;
 rom[1542]=32'ha4aaa654;
 rom[1543]=32'ha487a678;
 rom[1544]=32'ha464a69c;
 rom[1545]=32'ha441a6c0;
 rom[1546]=32'ha41ea6e4;
 rom[1547]=32'ha3fba708;
 rom[1548]=32'ha3d8a72d;
 rom[1549]=32'ha3b5a751;
 rom[1550]=32'ha392a775;
 rom[1551]=32'ha36fa799;
 rom[1552]=32'ha34da7be;
 rom[1553]=32'ha32aa7e2;
 rom[1554]=32'ha307a807;
 rom[1555]=32'ha2e5a82b;
 rom[1556]=32'ha2c2a850;
 rom[1557]=32'ha2a0a875;
 rom[1558]=32'ha27ea899;
 rom[1559]=32'ha25ba8be;
 rom[1560]=32'ha239a8e3;
 rom[1561]=32'ha217a908;
 rom[1562]=32'ha1f5a92d;
 rom[1563]=32'ha1d3a951;
 rom[1564]=32'ha1b1a976;
 rom[1565]=32'ha18fa99c;
 rom[1566]=32'ha16da9c1;
 rom[1567]=32'ha14ba9e6;
 rom[1568]=32'ha129aa0b;
 rom[1569]=32'ha108aa30;
 rom[1570]=32'ha0e6aa56;
 rom[1571]=32'ha0c4aa7b;
 rom[1572]=32'ha0a3aaa0;
 rom[1573]=32'ha081aac6;
 rom[1574]=32'ha060aaeb;
 rom[1575]=32'ha03eab11;
 rom[1576]=32'ha01dab37;
 rom[1577]=32'h9ffcab5c;
 rom[1578]=32'h9fdbab82;
 rom[1579]=32'h9fb9aba8;
 rom[1580]=32'h9f98abce;
 rom[1581]=32'h9f77abf4;
 rom[1582]=32'h9f56ac19;
 rom[1583]=32'h9f35ac3f;
 rom[1584]=32'h9f15ac65;
 rom[1585]=32'h9ef4ac8c;
 rom[1586]=32'h9ed3acb2;
 rom[1587]=32'h9eb2acd8;
 rom[1588]=32'h9e92acfe;
 rom[1589]=32'h9e71ad24;
 rom[1590]=32'h9e51ad4b;
 rom[1591]=32'h9e30ad71;
 rom[1592]=32'h9e10ad98;
 rom[1593]=32'h9defadbe;
 rom[1594]=32'h9dcfade5;
 rom[1595]=32'h9dafae0b;
 rom[1596]=32'h9d8fae32;
 rom[1597]=32'h9d6fae58;
 rom[1598]=32'h9d4fae7f;
 rom[1599]=32'h9d2faea6;
 rom[1600]=32'h9d0faecd;
 rom[1601]=32'h9cefaef4;
 rom[1602]=32'h9ccfaf1b;
 rom[1603]=32'h9cafaf42;
 rom[1604]=32'h9c90af69;
 rom[1605]=32'h9c70af90;
 rom[1606]=32'h9c51afb7;
 rom[1607]=32'h9c31afde;
 rom[1608]=32'h9c12b005;
 rom[1609]=32'h9bf2b02c;
 rom[1610]=32'h9bd3b054;
 rom[1611]=32'h9bb4b07b;
 rom[1612]=32'h9b94b0a3;
 rom[1613]=32'h9b75b0ca;
 rom[1614]=32'h9b56b0f2;
 rom[1615]=32'h9b37b119;
 rom[1616]=32'h9b18b141;
 rom[1617]=32'h9af9b168;
 rom[1618]=32'h9adbb190;
 rom[1619]=32'h9abcb1b8;
 rom[1620]=32'h9a9db1e0;
 rom[1621]=32'h9a7eb207;
 rom[1622]=32'h9a60b22f;
 rom[1623]=32'h9a41b257;
 rom[1624]=32'h9a23b27f;
 rom[1625]=32'h9a04b2a7;
 rom[1626]=32'h99e6b2cf;
 rom[1627]=32'h99c8b2f7;
 rom[1628]=32'h99aab320;
 rom[1629]=32'h998bb348;
 rom[1630]=32'h996db370;
 rom[1631]=32'h994fb398;
 rom[1632]=32'h9931b3c1;
 rom[1633]=32'h9913b3e9;
 rom[1634]=32'h98f6b412;
 rom[1635]=32'h98d8b43a;
 rom[1636]=32'h98bab463;
 rom[1637]=32'h989cb48b;
 rom[1638]=32'h987fb4b4;
 rom[1639]=32'h9861b4dc;
 rom[1640]=32'h9844b505;
 rom[1641]=32'h9826b52e;
 rom[1642]=32'h9809b557;
 rom[1643]=32'h97ecb580;
 rom[1644]=32'h97ceb5a8;
 rom[1645]=32'h97b1b5d1;
 rom[1646]=32'h9794b5fa;
 rom[1647]=32'h9777b623;
 rom[1648]=32'h975ab64c;
 rom[1649]=32'h973db676;
 rom[1650]=32'h9720b69f;
 rom[1651]=32'h9704b6c8;
 rom[1652]=32'h96e7b6f1;
 rom[1653]=32'h96cab71b;
 rom[1654]=32'h96aeb744;
 rom[1655]=32'h9691b76d;
 rom[1656]=32'h9675b797;
 rom[1657]=32'h9658b7c0;
 rom[1658]=32'h963cb7ea;
 rom[1659]=32'h9620b813;
 rom[1660]=32'h9603b83d;
 rom[1661]=32'h95e7b866;
 rom[1662]=32'h95cbb890;
 rom[1663]=32'h95afb8ba;
 rom[1664]=32'h9593b8e4;
 rom[1665]=32'h9577b90d;
 rom[1666]=32'h955cb937;
 rom[1667]=32'h9540b961;
 rom[1668]=32'h9524b98b;
 rom[1669]=32'h9508b9b5;
 rom[1670]=32'h94edb9df;
 rom[1671]=32'h94d1ba09;
 rom[1672]=32'h94b6ba33;
 rom[1673]=32'h949bba5d;
 rom[1674]=32'h947fba88;
 rom[1675]=32'h9464bab2;
 rom[1676]=32'h9449badc;
 rom[1677]=32'h942ebb07;
 rom[1678]=32'h9413bb31;
 rom[1679]=32'h93f8bb5b;
 rom[1680]=32'h93ddbb86;
 rom[1681]=32'h93c2bbb0;
 rom[1682]=32'h93a7bbdb;
 rom[1683]=32'h938cbc05;
 rom[1684]=32'h9372bc30;
 rom[1685]=32'h9357bc5b;
 rom[1686]=32'h933dbc85;
 rom[1687]=32'h9322bcb0;
 rom[1688]=32'h9308bcdb;
 rom[1689]=32'h92edbd06;
 rom[1690]=32'h92d3bd30;
 rom[1691]=32'h92b9bd5b;
 rom[1692]=32'h929fbd86;
 rom[1693]=32'h9285bdb1;
 rom[1694]=32'h926bbddc;
 rom[1695]=32'h9251be07;
 rom[1696]=32'h9237be32;
 rom[1697]=32'h921dbe5e;
 rom[1698]=32'h9203be89;
 rom[1699]=32'h91eabeb4;
 rom[1700]=32'h91d0bedf;
 rom[1701]=32'h91b6bf0a;
 rom[1702]=32'h919dbf36;
 rom[1703]=32'h9184bf61;
 rom[1704]=32'h916abf8d;
 rom[1705]=32'h9151bfb8;
 rom[1706]=32'h9138bfe3;
 rom[1707]=32'h911fc00f;
 rom[1708]=32'h9105c03b;
 rom[1709]=32'h90ecc066;
 rom[1710]=32'h90d4c092;
 rom[1711]=32'h90bbc0bd;
 rom[1712]=32'h90a2c0e9;
 rom[1713]=32'h9089c115;
 rom[1714]=32'h9070c141;
 rom[1715]=32'h9058c16d;
 rom[1716]=32'h903fc198;
 rom[1717]=32'h9027c1c4;
 rom[1718]=32'h900ec1f0;
 rom[1719]=32'h8ff6c21c;
 rom[1720]=32'h8fdec248;
 rom[1721]=32'h8fc6c274;
 rom[1722]=32'h8fadc2a0;
 rom[1723]=32'h8f95c2cd;
 rom[1724]=32'h8f7dc2f9;
 rom[1725]=32'h8f65c325;
 rom[1726]=32'h8f4ec351;
 rom[1727]=32'h8f36c37d;
 rom[1728]=32'h8f1ec3aa;
 rom[1729]=32'h8f06c3d6;
 rom[1730]=32'h8eefc402;
 rom[1731]=32'h8ed7c42f;
 rom[1732]=32'h8ec0c45b;
 rom[1733]=32'h8ea8c488;
 rom[1734]=32'h8e91c4b4;
 rom[1735]=32'h8e7ac4e1;
 rom[1736]=32'h8e63c50e;
 rom[1737]=32'h8e4cc53a;
 rom[1738]=32'h8e35c567;
 rom[1739]=32'h8e1ec594;
 rom[1740]=32'h8e07c5c0;
 rom[1741]=32'h8df0c5ed;
 rom[1742]=32'h8dd9c61a;
 rom[1743]=32'h8dc2c647;
 rom[1744]=32'h8dacc674;
 rom[1745]=32'h8d95c6a0;
 rom[1746]=32'h8d7fc6cd;
 rom[1747]=32'h8d68c6fa;
 rom[1748]=32'h8d52c727;
 rom[1749]=32'h8d3cc755;
 rom[1750]=32'h8d25c782;
 rom[1751]=32'h8d0fc7af;
 rom[1752]=32'h8cf9c7dc;
 rom[1753]=32'h8ce3c809;
 rom[1754]=32'h8ccdc836;
 rom[1755]=32'h8cb7c864;
 rom[1756]=32'h8ca2c891;
 rom[1757]=32'h8c8cc8be;
 rom[1758]=32'h8c76c8eb;
 rom[1759]=32'h8c61c919;
 rom[1760]=32'h8c4bc946;
 rom[1761]=32'h8c36c974;
 rom[1762]=32'h8c20c9a1;
 rom[1763]=32'h8c0bc9cf;
 rom[1764]=32'h8bf6c9fc;
 rom[1765]=32'h8be0ca2a;
 rom[1766]=32'h8bcbca58;
 rom[1767]=32'h8bb6ca85;
 rom[1768]=32'h8ba1cab3;
 rom[1769]=32'h8b8ccae1;
 rom[1770]=32'h8b78cb0e;
 rom[1771]=32'h8b63cb3c;
 rom[1772]=32'h8b4ecb6a;
 rom[1773]=32'h8b3acb98;
 rom[1774]=32'h8b25cbc6;
 rom[1775]=32'h8b10cbf4;
 rom[1776]=32'h8afccc21;
 rom[1777]=32'h8ae8cc4f;
 rom[1778]=32'h8ad3cc7d;
 rom[1779]=32'h8abfccab;
 rom[1780]=32'h8aabccda;
 rom[1781]=32'h8a97cd08;
 rom[1782]=32'h8a83cd36;
 rom[1783]=32'h8a6fcd64;
 rom[1784]=32'h8a5bcd92;
 rom[1785]=32'h8a48cdc0;
 rom[1786]=32'h8a34cdef;
 rom[1787]=32'h8a20ce1d;
 rom[1788]=32'h8a0dce4b;
 rom[1789]=32'h89f9ce79;
 rom[1790]=32'h89e6cea8;
 rom[1791]=32'h89d3ced6;
 rom[1792]=32'h89bfcf05;
 rom[1793]=32'h89accf33;
 rom[1794]=32'h8999cf62;
 rom[1795]=32'h8986cf90;
 rom[1796]=32'h8973cfbf;
 rom[1797]=32'h8960cfed;
 rom[1798]=32'h894dd01c;
 rom[1799]=32'h893ad04a;
 rom[1800]=32'h8928d079;
 rom[1801]=32'h8915d0a8;
 rom[1802]=32'h8902d0d6;
 rom[1803]=32'h88f0d105;
 rom[1804]=32'h88ded134;
 rom[1805]=32'h88cbd163;
 rom[1806]=32'h88b9d192;
 rom[1807]=32'h88a7d1c0;
 rom[1808]=32'h8895d1ef;
 rom[1809]=32'h8883d21e;
 rom[1810]=32'h8871d24d;
 rom[1811]=32'h885fd27c;
 rom[1812]=32'h884dd2ab;
 rom[1813]=32'h883bd2da;
 rom[1814]=32'h8829d309;
 rom[1815]=32'h8818d338;
 rom[1816]=32'h8806d367;
 rom[1817]=32'h87f5d396;
 rom[1818]=32'h87e3d3c6;
 rom[1819]=32'h87d2d3f5;
 rom[1820]=32'h87c1d424;
 rom[1821]=32'h87b0d453;
 rom[1822]=32'h879ed483;
 rom[1823]=32'h878dd4b2;
 rom[1824]=32'h877cd4e1;
 rom[1825]=32'h876cd510;
 rom[1826]=32'h875bd540;
 rom[1827]=32'h874ad56f;
 rom[1828]=32'h8739d59f;
 rom[1829]=32'h8729d5ce;
 rom[1830]=32'h8718d5fe;
 rom[1831]=32'h8708d62d;
 rom[1832]=32'h86f7d65d;
 rom[1833]=32'h86e7d68c;
 rom[1834]=32'h86d7d6bc;
 rom[1835]=32'h86c7d6eb;
 rom[1836]=32'h86b6d71b;
 rom[1837]=32'h86a6d74b;
 rom[1838]=32'h8696d77a;
 rom[1839]=32'h8687d7aa;
 rom[1840]=32'h8677d7da;
 rom[1841]=32'h8667d809;
 rom[1842]=32'h8657d839;
 rom[1843]=32'h8648d869;
 rom[1844]=32'h8638d899;
 rom[1845]=32'h8629d8c9;
 rom[1846]=32'h861ad8f8;
 rom[1847]=32'h860ad928;
 rom[1848]=32'h85fbd958;
 rom[1849]=32'h85ecd988;
 rom[1850]=32'h85ddd9b8;
 rom[1851]=32'h85ced9e8;
 rom[1852]=32'h85bfda18;
 rom[1853]=32'h85b0da48;
 rom[1854]=32'h85a1da78;
 rom[1855]=32'h8593daa8;
 rom[1856]=32'h8584dad8;
 rom[1857]=32'h8575db08;
 rom[1858]=32'h8567db38;
 rom[1859]=32'h8558db69;
 rom[1860]=32'h854adb99;
 rom[1861]=32'h853cdbc9;
 rom[1862]=32'h852edbf9;
 rom[1863]=32'h8520dc29;
 rom[1864]=32'h8512dc5a;
 rom[1865]=32'h8504dc8a;
 rom[1866]=32'h84f6dcba;
 rom[1867]=32'h84e8dceb;
 rom[1868]=32'h84dadd1b;
 rom[1869]=32'h84cddd4b;
 rom[1870]=32'h84bfdd7c;
 rom[1871]=32'h84b1ddac;
 rom[1872]=32'h84a4dddd;
 rom[1873]=32'h8497de0d;
 rom[1874]=32'h8489de3e;
 rom[1875]=32'h847cde6e;
 rom[1876]=32'h846fde9f;
 rom[1877]=32'h8462decf;
 rom[1878]=32'h8455df00;
 rom[1879]=32'h8448df30;
 rom[1880]=32'h843bdf61;
 rom[1881]=32'h842edf91;
 rom[1882]=32'h8422dfc2;
 rom[1883]=32'h8415dff3;
 rom[1884]=32'h8408e023;
 rom[1885]=32'h83fce054;
 rom[1886]=32'h83f0e085;
 rom[1887]=32'h83e3e0b6;
 rom[1888]=32'h83d7e0e6;
 rom[1889]=32'h83cbe117;
 rom[1890]=32'h83bfe148;
 rom[1891]=32'h83b3e179;
 rom[1892]=32'h83a7e1a9;
 rom[1893]=32'h839be1da;
 rom[1894]=32'h838fe20b;
 rom[1895]=32'h8383e23c;
 rom[1896]=32'h8378e26d;
 rom[1897]=32'h836ce29e;
 rom[1898]=32'h8361e2cf;
 rom[1899]=32'h8355e300;
 rom[1900]=32'h834ae331;
 rom[1901]=32'h833fe362;
 rom[1902]=32'h8333e393;
 rom[1903]=32'h8328e3c4;
 rom[1904]=32'h831de3f5;
 rom[1905]=32'h8312e426;
 rom[1906]=32'h8307e457;
 rom[1907]=32'h82fce488;
 rom[1908]=32'h82f2e4b9;
 rom[1909]=32'h82e7e4ea;
 rom[1910]=32'h82dce51b;
 rom[1911]=32'h82d2e54c;
 rom[1912]=32'h82c7e57e;
 rom[1913]=32'h82bde5af;
 rom[1914]=32'h82b3e5e0;
 rom[1915]=32'h82a9e611;
 rom[1916]=32'h829ee642;
 rom[1917]=32'h8294e674;
 rom[1918]=32'h828ae6a5;
 rom[1919]=32'h8280e6d6;
 rom[1920]=32'h8277e707;
 rom[1921]=32'h826de739;
 rom[1922]=32'h8263e76a;
 rom[1923]=32'h825ae79b;
 rom[1924]=32'h8250e7cd;
 rom[1925]=32'h8247e7fe;
 rom[1926]=32'h823de830;
 rom[1927]=32'h8234e861;
 rom[1928]=32'h822be892;
 rom[1929]=32'h8221e8c4;
 rom[1930]=32'h8218e8f5;
 rom[1931]=32'h820fe927;
 rom[1932]=32'h8206e958;
 rom[1933]=32'h81fee98a;
 rom[1934]=32'h81f5e9bb;
 rom[1935]=32'h81ece9ed;
 rom[1936]=32'h81e3ea1e;
 rom[1937]=32'h81dbea50;
 rom[1938]=32'h81d2ea81;
 rom[1939]=32'h81caeab3;
 rom[1940]=32'h81c2eae4;
 rom[1941]=32'h81b9eb16;
 rom[1942]=32'h81b1eb47;
 rom[1943]=32'h81a9eb79;
 rom[1944]=32'h81a1ebab;
 rom[1945]=32'h8199ebdc;
 rom[1946]=32'h8191ec0e;
 rom[1947]=32'h8189ec40;
 rom[1948]=32'h8182ec71;
 rom[1949]=32'h817aeca3;
 rom[1950]=32'h8173ecd5;
 rom[1951]=32'h816bed06;
 rom[1952]=32'h8164ed38;
 rom[1953]=32'h815ced6a;
 rom[1954]=32'h8155ed9c;
 rom[1955]=32'h814eedcd;
 rom[1956]=32'h8147edff;
 rom[1957]=32'h8140ee31;
 rom[1958]=32'h8139ee63;
 rom[1959]=32'h8132ee94;
 rom[1960]=32'h812beec6;
 rom[1961]=32'h8124eef8;
 rom[1962]=32'h811eef2a;
 rom[1963]=32'h8117ef5c;
 rom[1964]=32'h8111ef8e;
 rom[1965]=32'h810aefbf;
 rom[1966]=32'h8104eff1;
 rom[1967]=32'h80fef023;
 rom[1968]=32'h80f7f055;
 rom[1969]=32'h80f1f087;
 rom[1970]=32'h80ebf0b9;
 rom[1971]=32'h80e5f0eb;
 rom[1972]=32'h80dff11d;
 rom[1973]=32'h80daf14f;
 rom[1974]=32'h80d4f180;
 rom[1975]=32'h80cef1b2;
 rom[1976]=32'h80c9f1e4;
 rom[1977]=32'h80c3f216;
 rom[1978]=32'h80bef248;
 rom[1979]=32'h80b8f27a;
 rom[1980]=32'h80b3f2ac;
 rom[1981]=32'h80aef2de;
 rom[1982]=32'h80a9f310;
 rom[1983]=32'h80a4f342;
 rom[1984]=32'h809ff374;
 rom[1985]=32'h809af3a6;
 rom[1986]=32'h8095f3d8;
 rom[1987]=32'h8090f40a;
 rom[1988]=32'h808cf43c;
 rom[1989]=32'h8087f46e;
 rom[1990]=32'h8083f4a1;
 rom[1991]=32'h807ef4d3;
 rom[1992]=32'h807af505;
 rom[1993]=32'h8076f537;
 rom[1994]=32'h8071f569;
 rom[1995]=32'h806df59b;
 rom[1996]=32'h8069f5cd;
 rom[1997]=32'h8065f5ff;
 rom[1998]=32'h8061f631;
 rom[1999]=32'h805ef663;
 rom[2000]=32'h805af696;
 rom[2001]=32'h8056f6c8;
 rom[2002]=32'h8053f6fa;
 rom[2003]=32'h804ff72c;
 rom[2004]=32'h804cf75e;
 rom[2005]=32'h8048f790;
 rom[2006]=32'h8045f7c2;
 rom[2007]=32'h8042f7f5;
 rom[2008]=32'h803ff827;
 rom[2009]=32'h803cf859;
 rom[2010]=32'h8039f88b;
 rom[2011]=32'h8036f8bd;
 rom[2012]=32'h8033f8ef;
 rom[2013]=32'h8030f922;
 rom[2014]=32'h802ef954;
 rom[2015]=32'h802bf986;
 rom[2016]=32'h8028f9b8;
 rom[2017]=32'h8026f9ea;
 rom[2018]=32'h8024fa1d;
 rom[2019]=32'h8021fa4f;
 rom[2020]=32'h801ffa81;
 rom[2021]=32'h801dfab3;
 rom[2022]=32'h801bfae5;
 rom[2023]=32'h8019fb18;
 rom[2024]=32'h8017fb4a;
 rom[2025]=32'h8015fb7c;
 rom[2026]=32'h8014fbae;
 rom[2027]=32'h8012fbe1;
 rom[2028]=32'h8010fc13;
 rom[2029]=32'h800ffc45;
 rom[2030]=32'h800dfc77;
 rom[2031]=32'h800cfcaa;
 rom[2032]=32'h800bfcdc;
 rom[2033]=32'h800afd0e;
 rom[2034]=32'h8009fd40;
 rom[2035]=32'h8008fd73;
 rom[2036]=32'h8007fda5;
 rom[2037]=32'h8006fdd7;
 rom[2038]=32'h8005fe09;
 rom[2039]=32'h8004fe3c;
 rom[2040]=32'h8003fe6e;
 rom[2041]=32'h8003fea0;
 rom[2042]=32'h8002fed2;
 rom[2043]=32'h8002ff05;
 rom[2044]=32'h8002ff37;
 rom[2045]=32'h8001ff69;
 rom[2046]=32'h8001ff9b;
 rom[2047]=32'h8001ffce;
 rom[2048]=32'h80010000;
 rom[2049]=32'h80010032;
 rom[2050]=32'h80010065;
 rom[2051]=32'h80010097;
 rom[2052]=32'h800200c9;
 rom[2053]=32'h800200fb;
 rom[2054]=32'h8002012e;
 rom[2055]=32'h80030160;
 rom[2056]=32'h80030192;
 rom[2057]=32'h800401c4;
 rom[2058]=32'h800501f7;
 rom[2059]=32'h80060229;
 rom[2060]=32'h8007025b;
 rom[2061]=32'h8008028d;
 rom[2062]=32'h800902c0;
 rom[2063]=32'h800a02f2;
 rom[2064]=32'h800b0324;
 rom[2065]=32'h800c0356;
 rom[2066]=32'h800d0389;
 rom[2067]=32'h800f03bb;
 rom[2068]=32'h801003ed;
 rom[2069]=32'h8012041f;
 rom[2070]=32'h80140452;
 rom[2071]=32'h80150484;
 rom[2072]=32'h801704b6;
 rom[2073]=32'h801904e8;
 rom[2074]=32'h801b051b;
 rom[2075]=32'h801d054d;
 rom[2076]=32'h801f057f;
 rom[2077]=32'h802105b1;
 rom[2078]=32'h802405e3;
 rom[2079]=32'h80260616;
 rom[2080]=32'h80280648;
 rom[2081]=32'h802b067a;
 rom[2082]=32'h802e06ac;
 rom[2083]=32'h803006de;
 rom[2084]=32'h80330711;
 rom[2085]=32'h80360743;
 rom[2086]=32'h80390775;
 rom[2087]=32'h803c07a7;
 rom[2088]=32'h803f07d9;
 rom[2089]=32'h8042080b;
 rom[2090]=32'h8045083e;
 rom[2091]=32'h80480870;
 rom[2092]=32'h804c08a2;
 rom[2093]=32'h804f08d4;
 rom[2094]=32'h80530906;
 rom[2095]=32'h80560938;
 rom[2096]=32'h805a096a;
 rom[2097]=32'h805e099d;
 rom[2098]=32'h806109cf;
 rom[2099]=32'h80650a01;
 rom[2100]=32'h80690a33;
 rom[2101]=32'h806d0a65;
 rom[2102]=32'h80710a97;
 rom[2103]=32'h80760ac9;
 rom[2104]=32'h807a0afb;
 rom[2105]=32'h807e0b2d;
 rom[2106]=32'h80830b5f;
 rom[2107]=32'h80870b92;
 rom[2108]=32'h808c0bc4;
 rom[2109]=32'h80900bf6;
 rom[2110]=32'h80950c28;
 rom[2111]=32'h809a0c5a;
 rom[2112]=32'h809f0c8c;
 rom[2113]=32'h80a40cbe;
 rom[2114]=32'h80a90cf0;
 rom[2115]=32'h80ae0d22;
 rom[2116]=32'h80b30d54;
 rom[2117]=32'h80b80d86;
 rom[2118]=32'h80be0db8;
 rom[2119]=32'h80c30dea;
 rom[2120]=32'h80c90e1c;
 rom[2121]=32'h80ce0e4e;
 rom[2122]=32'h80d40e80;
 rom[2123]=32'h80da0eb1;
 rom[2124]=32'h80df0ee3;
 rom[2125]=32'h80e50f15;
 rom[2126]=32'h80eb0f47;
 rom[2127]=32'h80f10f79;
 rom[2128]=32'h80f70fab;
 rom[2129]=32'h80fe0fdd;
 rom[2130]=32'h8104100f;
 rom[2131]=32'h810a1041;
 rom[2132]=32'h81111072;
 rom[2133]=32'h811710a4;
 rom[2134]=32'h811e10d6;
 rom[2135]=32'h81241108;
 rom[2136]=32'h812b113a;
 rom[2137]=32'h8132116c;
 rom[2138]=32'h8139119d;
 rom[2139]=32'h814011cf;
 rom[2140]=32'h81471201;
 rom[2141]=32'h814e1233;
 rom[2142]=32'h81551264;
 rom[2143]=32'h815c1296;
 rom[2144]=32'h816412c8;
 rom[2145]=32'h816b12fa;
 rom[2146]=32'h8173132b;
 rom[2147]=32'h817a135d;
 rom[2148]=32'h8182138f;
 rom[2149]=32'h818913c0;
 rom[2150]=32'h819113f2;
 rom[2151]=32'h81991424;
 rom[2152]=32'h81a11455;
 rom[2153]=32'h81a91487;
 rom[2154]=32'h81b114b9;
 rom[2155]=32'h81b914ea;
 rom[2156]=32'h81c2151c;
 rom[2157]=32'h81ca154d;
 rom[2158]=32'h81d2157f;
 rom[2159]=32'h81db15b0;
 rom[2160]=32'h81e315e2;
 rom[2161]=32'h81ec1613;
 rom[2162]=32'h81f51645;
 rom[2163]=32'h81fe1676;
 rom[2164]=32'h820616a8;
 rom[2165]=32'h820f16d9;
 rom[2166]=32'h8218170b;
 rom[2167]=32'h8221173c;
 rom[2168]=32'h822b176e;
 rom[2169]=32'h8234179f;
 rom[2170]=32'h823d17d0;
 rom[2171]=32'h82471802;
 rom[2172]=32'h82501833;
 rom[2173]=32'h825a1865;
 rom[2174]=32'h82631896;
 rom[2175]=32'h826d18c7;
 rom[2176]=32'h827718f9;
 rom[2177]=32'h8280192a;
 rom[2178]=32'h828a195b;
 rom[2179]=32'h8294198c;
 rom[2180]=32'h829e19be;
 rom[2181]=32'h82a919ef;
 rom[2182]=32'h82b31a20;
 rom[2183]=32'h82bd1a51;
 rom[2184]=32'h82c71a82;
 rom[2185]=32'h82d21ab4;
 rom[2186]=32'h82dc1ae5;
 rom[2187]=32'h82e71b16;
 rom[2188]=32'h82f21b47;
 rom[2189]=32'h82fc1b78;
 rom[2190]=32'h83071ba9;
 rom[2191]=32'h83121bda;
 rom[2192]=32'h831d1c0b;
 rom[2193]=32'h83281c3c;
 rom[2194]=32'h83331c6d;
 rom[2195]=32'h833f1c9e;
 rom[2196]=32'h834a1ccf;
 rom[2197]=32'h83551d00;
 rom[2198]=32'h83611d31;
 rom[2199]=32'h836c1d62;
 rom[2200]=32'h83781d93;
 rom[2201]=32'h83831dc4;
 rom[2202]=32'h838f1df5;
 rom[2203]=32'h839b1e26;
 rom[2204]=32'h83a71e57;
 rom[2205]=32'h83b31e87;
 rom[2206]=32'h83bf1eb8;
 rom[2207]=32'h83cb1ee9;
 rom[2208]=32'h83d71f1a;
 rom[2209]=32'h83e31f4a;
 rom[2210]=32'h83f01f7b;
 rom[2211]=32'h83fc1fac;
 rom[2212]=32'h84081fdd;
 rom[2213]=32'h8415200d;
 rom[2214]=32'h8422203e;
 rom[2215]=32'h842e206f;
 rom[2216]=32'h843b209f;
 rom[2217]=32'h844820d0;
 rom[2218]=32'h84552100;
 rom[2219]=32'h84622131;
 rom[2220]=32'h846f2161;
 rom[2221]=32'h847c2192;
 rom[2222]=32'h848921c2;
 rom[2223]=32'h849721f3;
 rom[2224]=32'h84a42223;
 rom[2225]=32'h84b12254;
 rom[2226]=32'h84bf2284;
 rom[2227]=32'h84cd22b5;
 rom[2228]=32'h84da22e5;
 rom[2229]=32'h84e82315;
 rom[2230]=32'h84f62346;
 rom[2231]=32'h85042376;
 rom[2232]=32'h851223a6;
 rom[2233]=32'h852023d7;
 rom[2234]=32'h852e2407;
 rom[2235]=32'h853c2437;
 rom[2236]=32'h854a2467;
 rom[2237]=32'h85582497;
 rom[2238]=32'h856724c8;
 rom[2239]=32'h857524f8;
 rom[2240]=32'h85842528;
 rom[2241]=32'h85932558;
 rom[2242]=32'h85a12588;
 rom[2243]=32'h85b025b8;
 rom[2244]=32'h85bf25e8;
 rom[2245]=32'h85ce2618;
 rom[2246]=32'h85dd2648;
 rom[2247]=32'h85ec2678;
 rom[2248]=32'h85fb26a8;
 rom[2249]=32'h860a26d8;
 rom[2250]=32'h861a2708;
 rom[2251]=32'h86292737;
 rom[2252]=32'h86382767;
 rom[2253]=32'h86482797;
 rom[2254]=32'h865727c7;
 rom[2255]=32'h866727f7;
 rom[2256]=32'h86772826;
 rom[2257]=32'h86872856;
 rom[2258]=32'h86962886;
 rom[2259]=32'h86a628b5;
 rom[2260]=32'h86b628e5;
 rom[2261]=32'h86c72915;
 rom[2262]=32'h86d72944;
 rom[2263]=32'h86e72974;
 rom[2264]=32'h86f729a3;
 rom[2265]=32'h870829d3;
 rom[2266]=32'h87182a02;
 rom[2267]=32'h87292a32;
 rom[2268]=32'h87392a61;
 rom[2269]=32'h874a2a91;
 rom[2270]=32'h875b2ac0;
 rom[2271]=32'h876c2af0;
 rom[2272]=32'h877c2b1f;
 rom[2273]=32'h878d2b4e;
 rom[2274]=32'h879e2b7d;
 rom[2275]=32'h87b02bad;
 rom[2276]=32'h87c12bdc;
 rom[2277]=32'h87d22c0b;
 rom[2278]=32'h87e32c3a;
 rom[2279]=32'h87f52c6a;
 rom[2280]=32'h88062c99;
 rom[2281]=32'h88182cc8;
 rom[2282]=32'h88292cf7;
 rom[2283]=32'h883b2d26;
 rom[2284]=32'h884d2d55;
 rom[2285]=32'h885f2d84;
 rom[2286]=32'h88712db3;
 rom[2287]=32'h88832de2;
 rom[2288]=32'h88952e11;
 rom[2289]=32'h88a72e40;
 rom[2290]=32'h88b92e6e;
 rom[2291]=32'h88cb2e9d;
 rom[2292]=32'h88de2ecc;
 rom[2293]=32'h88f02efb;
 rom[2294]=32'h89022f2a;
 rom[2295]=32'h89152f58;
 rom[2296]=32'h89282f87;
 rom[2297]=32'h893a2fb6;
 rom[2298]=32'h894d2fe4;
 rom[2299]=32'h89603013;
 rom[2300]=32'h89733041;
 rom[2301]=32'h89863070;
 rom[2302]=32'h8999309e;
 rom[2303]=32'h89ac30cd;
 rom[2304]=32'h89bf30fb;
 rom[2305]=32'h89d3312a;
 rom[2306]=32'h89e63158;
 rom[2307]=32'h89f93187;
 rom[2308]=32'h8a0d31b5;
 rom[2309]=32'h8a2031e3;
 rom[2310]=32'h8a343211;
 rom[2311]=32'h8a483240;
 rom[2312]=32'h8a5b326e;
 rom[2313]=32'h8a6f329c;
 rom[2314]=32'h8a8332ca;
 rom[2315]=32'h8a9732f8;
 rom[2316]=32'h8aab3326;
 rom[2317]=32'h8abf3355;
 rom[2318]=32'h8ad33383;
 rom[2319]=32'h8ae833b1;
 rom[2320]=32'h8afc33df;
 rom[2321]=32'h8b10340c;
 rom[2322]=32'h8b25343a;
 rom[2323]=32'h8b3a3468;
 rom[2324]=32'h8b4e3496;
 rom[2325]=32'h8b6334c4;
 rom[2326]=32'h8b7834f2;
 rom[2327]=32'h8b8c351f;
 rom[2328]=32'h8ba1354d;
 rom[2329]=32'h8bb6357b;
 rom[2330]=32'h8bcb35a8;
 rom[2331]=32'h8be035d6;
 rom[2332]=32'h8bf63604;
 rom[2333]=32'h8c0b3631;
 rom[2334]=32'h8c20365f;
 rom[2335]=32'h8c36368c;
 rom[2336]=32'h8c4b36ba;
 rom[2337]=32'h8c6136e7;
 rom[2338]=32'h8c763715;
 rom[2339]=32'h8c8c3742;
 rom[2340]=32'h8ca2376f;
 rom[2341]=32'h8cb7379c;
 rom[2342]=32'h8ccd37ca;
 rom[2343]=32'h8ce337f7;
 rom[2344]=32'h8cf93824;
 rom[2345]=32'h8d0f3851;
 rom[2346]=32'h8d25387e;
 rom[2347]=32'h8d3c38ab;
 rom[2348]=32'h8d5238d9;
 rom[2349]=32'h8d683906;
 rom[2350]=32'h8d7f3933;
 rom[2351]=32'h8d953960;
 rom[2352]=32'h8dac398c;
 rom[2353]=32'h8dc239b9;
 rom[2354]=32'h8dd939e6;
 rom[2355]=32'h8df03a13;
 rom[2356]=32'h8e073a40;
 rom[2357]=32'h8e1e3a6c;
 rom[2358]=32'h8e353a99;
 rom[2359]=32'h8e4c3ac6;
 rom[2360]=32'h8e633af2;
 rom[2361]=32'h8e7a3b1f;
 rom[2362]=32'h8e913b4c;
 rom[2363]=32'h8ea83b78;
 rom[2364]=32'h8ec03ba5;
 rom[2365]=32'h8ed73bd1;
 rom[2366]=32'h8eef3bfe;
 rom[2367]=32'h8f063c2a;
 rom[2368]=32'h8f1e3c56;
 rom[2369]=32'h8f363c83;
 rom[2370]=32'h8f4e3caf;
 rom[2371]=32'h8f653cdb;
 rom[2372]=32'h8f7d3d07;
 rom[2373]=32'h8f953d33;
 rom[2374]=32'h8fad3d60;
 rom[2375]=32'h8fc63d8c;
 rom[2376]=32'h8fde3db8;
 rom[2377]=32'h8ff63de4;
 rom[2378]=32'h900e3e10;
 rom[2379]=32'h90273e3c;
 rom[2380]=32'h903f3e68;
 rom[2381]=32'h90583e93;
 rom[2382]=32'h90703ebf;
 rom[2383]=32'h90893eeb;
 rom[2384]=32'h90a23f17;
 rom[2385]=32'h90bb3f43;
 rom[2386]=32'h90d43f6e;
 rom[2387]=32'h90ec3f9a;
 rom[2388]=32'h91053fc5;
 rom[2389]=32'h911f3ff1;
 rom[2390]=32'h9138401d;
 rom[2391]=32'h91514048;
 rom[2392]=32'h916a4073;
 rom[2393]=32'h9184409f;
 rom[2394]=32'h919d40ca;
 rom[2395]=32'h91b640f6;
 rom[2396]=32'h91d04121;
 rom[2397]=32'h91ea414c;
 rom[2398]=32'h92034177;
 rom[2399]=32'h921d41a2;
 rom[2400]=32'h923741ce;
 rom[2401]=32'h925141f9;
 rom[2402]=32'h926b4224;
 rom[2403]=32'h9285424f;
 rom[2404]=32'h929f427a;
 rom[2405]=32'h92b942a5;
 rom[2406]=32'h92d342d0;
 rom[2407]=32'h92ed42fa;
 rom[2408]=32'h93084325;
 rom[2409]=32'h93224350;
 rom[2410]=32'h933d437b;
 rom[2411]=32'h935743a5;
 rom[2412]=32'h937243d0;
 rom[2413]=32'h938c43fb;
 rom[2414]=32'h93a74425;
 rom[2415]=32'h93c24450;
 rom[2416]=32'h93dd447a;
 rom[2417]=32'h93f844a5;
 rom[2418]=32'h941344cf;
 rom[2419]=32'h942e44f9;
 rom[2420]=32'h94494524;
 rom[2421]=32'h9464454e;
 rom[2422]=32'h947f4578;
 rom[2423]=32'h949b45a3;
 rom[2424]=32'h94b645cd;
 rom[2425]=32'h94d145f7;
 rom[2426]=32'h94ed4621;
 rom[2427]=32'h9508464b;
 rom[2428]=32'h95244675;
 rom[2429]=32'h9540469f;
 rom[2430]=32'h955c46c9;
 rom[2431]=32'h957746f3;
 rom[2432]=32'h9593471c;
 rom[2433]=32'h95af4746;
 rom[2434]=32'h95cb4770;
 rom[2435]=32'h95e7479a;
 rom[2436]=32'h960347c3;
 rom[2437]=32'h962047ed;
 rom[2438]=32'h963c4816;
 rom[2439]=32'h96584840;
 rom[2440]=32'h96754869;
 rom[2441]=32'h96914893;
 rom[2442]=32'h96ae48bc;
 rom[2443]=32'h96ca48e5;
 rom[2444]=32'h96e7490f;
 rom[2445]=32'h97044938;
 rom[2446]=32'h97204961;
 rom[2447]=32'h973d498a;
 rom[2448]=32'h975a49b4;
 rom[2449]=32'h977749dd;
 rom[2450]=32'h97944a06;
 rom[2451]=32'h97b14a2f;
 rom[2452]=32'h97ce4a58;
 rom[2453]=32'h97ec4a80;
 rom[2454]=32'h98094aa9;
 rom[2455]=32'h98264ad2;
 rom[2456]=32'h98444afb;
 rom[2457]=32'h98614b24;
 rom[2458]=32'h987f4b4c;
 rom[2459]=32'h989c4b75;
 rom[2460]=32'h98ba4b9d;
 rom[2461]=32'h98d84bc6;
 rom[2462]=32'h98f64bee;
 rom[2463]=32'h99134c17;
 rom[2464]=32'h99314c3f;
 rom[2465]=32'h994f4c68;
 rom[2466]=32'h996d4c90;
 rom[2467]=32'h998b4cb8;
 rom[2468]=32'h99aa4ce0;
 rom[2469]=32'h99c84d09;
 rom[2470]=32'h99e64d31;
 rom[2471]=32'h9a044d59;
 rom[2472]=32'h9a234d81;
 rom[2473]=32'h9a414da9;
 rom[2474]=32'h9a604dd1;
 rom[2475]=32'h9a7e4df9;
 rom[2476]=32'h9a9d4e20;
 rom[2477]=32'h9abc4e48;
 rom[2478]=32'h9adb4e70;
 rom[2479]=32'h9af94e98;
 rom[2480]=32'h9b184ebf;
 rom[2481]=32'h9b374ee7;
 rom[2482]=32'h9b564f0e;
 rom[2483]=32'h9b754f36;
 rom[2484]=32'h9b944f5d;
 rom[2485]=32'h9bb44f85;
 rom[2486]=32'h9bd34fac;
 rom[2487]=32'h9bf24fd4;
 rom[2488]=32'h9c124ffb;
 rom[2489]=32'h9c315022;
 rom[2490]=32'h9c515049;
 rom[2491]=32'h9c705070;
 rom[2492]=32'h9c905097;
 rom[2493]=32'h9caf50be;
 rom[2494]=32'h9ccf50e5;
 rom[2495]=32'h9cef510c;
 rom[2496]=32'h9d0f5133;
 rom[2497]=32'h9d2f515a;
 rom[2498]=32'h9d4f5181;
 rom[2499]=32'h9d6f51a8;
 rom[2500]=32'h9d8f51ce;
 rom[2501]=32'h9daf51f5;
 rom[2502]=32'h9dcf521b;
 rom[2503]=32'h9def5242;
 rom[2504]=32'h9e105268;
 rom[2505]=32'h9e30528f;
 rom[2506]=32'h9e5152b5;
 rom[2507]=32'h9e7152dc;
 rom[2508]=32'h9e925302;
 rom[2509]=32'h9eb25328;
 rom[2510]=32'h9ed3534e;
 rom[2511]=32'h9ef45374;
 rom[2512]=32'h9f15539b;
 rom[2513]=32'h9f3553c1;
 rom[2514]=32'h9f5653e7;
 rom[2515]=32'h9f77540c;
 rom[2516]=32'h9f985432;
 rom[2517]=32'h9fb95458;
 rom[2518]=32'h9fdb547e;
 rom[2519]=32'h9ffc54a4;
 rom[2520]=32'ha01d54c9;
 rom[2521]=32'ha03e54ef;
 rom[2522]=32'ha0605515;
 rom[2523]=32'ha081553a;
 rom[2524]=32'ha0a35560;
 rom[2525]=32'ha0c45585;
 rom[2526]=32'ha0e655aa;
 rom[2527]=32'ha10855d0;
 rom[2528]=32'ha12955f5;
 rom[2529]=32'ha14b561a;
 rom[2530]=32'ha16d563f;
 rom[2531]=32'ha18f5664;
 rom[2532]=32'ha1b1568a;
 rom[2533]=32'ha1d356af;
 rom[2534]=32'ha1f556d3;
 rom[2535]=32'ha21756f8;
 rom[2536]=32'ha239571d;
 rom[2537]=32'ha25b5742;
 rom[2538]=32'ha27e5767;
 rom[2539]=32'ha2a0578b;
 rom[2540]=32'ha2c257b0;
 rom[2541]=32'ha2e557d5;
 rom[2542]=32'ha30757f9;
 rom[2543]=32'ha32a581e;
 rom[2544]=32'ha34d5842;
 rom[2545]=32'ha36f5867;
 rom[2546]=32'ha392588b;
 rom[2547]=32'ha3b558af;
 rom[2548]=32'ha3d858d3;
 rom[2549]=32'ha3fb58f8;
 rom[2550]=32'ha41e591c;
 rom[2551]=32'ha4415940;
 rom[2552]=32'ha4645964;
 rom[2553]=32'ha4875988;
 rom[2554]=32'ha4aa59ac;
 rom[2555]=32'ha4cd59cf;
 rom[2556]=32'ha4f159f3;
 rom[2557]=32'ha5145a17;
 rom[2558]=32'ha5375a3b;
 rom[2559]=32'ha55b5a5e;
 rom[2560]=32'ha57e5a82;
 rom[2561]=32'ha5a25aa5;
 rom[2562]=32'ha5c55ac9;
 rom[2563]=32'ha5e95aec;
 rom[2564]=32'ha60d5b0f;
 rom[2565]=32'ha6315b33;
 rom[2566]=32'ha6545b56;
 rom[2567]=32'ha6785b79;
 rom[2568]=32'ha69c5b9c;
 rom[2569]=32'ha6c05bbf;
 rom[2570]=32'ha6e45be2;
 rom[2571]=32'ha7085c05;
 rom[2572]=32'ha72d5c28;
 rom[2573]=32'ha7515c4b;
 rom[2574]=32'ha7755c6e;
 rom[2575]=32'ha7995c91;
 rom[2576]=32'ha7be5cb3;
 rom[2577]=32'ha7e25cd6;
 rom[2578]=32'ha8075cf9;
 rom[2579]=32'ha82b5d1b;
 rom[2580]=32'ha8505d3e;
 rom[2581]=32'ha8755d60;
 rom[2582]=32'ha8995d82;
 rom[2583]=32'ha8be5da5;
 rom[2584]=32'ha8e35dc7;
 rom[2585]=32'ha9085de9;
 rom[2586]=32'ha92d5e0b;
 rom[2587]=32'ha9515e2d;
 rom[2588]=32'ha9765e4f;
 rom[2589]=32'ha99c5e71;
 rom[2590]=32'ha9c15e93;
 rom[2591]=32'ha9e65eb5;
 rom[2592]=32'haa0b5ed7;
 rom[2593]=32'haa305ef8;
 rom[2594]=32'haa565f1a;
 rom[2595]=32'haa7b5f3c;
 rom[2596]=32'haaa05f5d;
 rom[2597]=32'haac65f7f;
 rom[2598]=32'haaeb5fa0;
 rom[2599]=32'hab115fc2;
 rom[2600]=32'hab375fe3;
 rom[2601]=32'hab5c6004;
 rom[2602]=32'hab826025;
 rom[2603]=32'haba86047;
 rom[2604]=32'habce6068;
 rom[2605]=32'habf46089;
 rom[2606]=32'hac1960aa;
 rom[2607]=32'hac3f60cb;
 rom[2608]=32'hac6560eb;
 rom[2609]=32'hac8c610c;
 rom[2610]=32'hacb2612d;
 rom[2611]=32'hacd8614e;
 rom[2612]=32'hacfe616e;
 rom[2613]=32'had24618f;
 rom[2614]=32'had4b61af;
 rom[2615]=32'had7161d0;
 rom[2616]=32'had9861f0;
 rom[2617]=32'hadbe6211;
 rom[2618]=32'hade56231;
 rom[2619]=32'hae0b6251;
 rom[2620]=32'hae326271;
 rom[2621]=32'hae586291;
 rom[2622]=32'hae7f62b1;
 rom[2623]=32'haea662d1;
 rom[2624]=32'haecd62f1;
 rom[2625]=32'haef46311;
 rom[2626]=32'haf1b6331;
 rom[2627]=32'haf426351;
 rom[2628]=32'haf696370;
 rom[2629]=32'haf906390;
 rom[2630]=32'hafb763af;
 rom[2631]=32'hafde63cf;
 rom[2632]=32'hb00563ee;
 rom[2633]=32'hb02c640e;
 rom[2634]=32'hb054642d;
 rom[2635]=32'hb07b644c;
 rom[2636]=32'hb0a3646c;
 rom[2637]=32'hb0ca648b;
 rom[2638]=32'hb0f264aa;
 rom[2639]=32'hb11964c9;
 rom[2640]=32'hb14164e8;
 rom[2641]=32'hb1686507;
 rom[2642]=32'hb1906525;
 rom[2643]=32'hb1b86544;
 rom[2644]=32'hb1e06563;
 rom[2645]=32'hb2076582;
 rom[2646]=32'hb22f65a0;
 rom[2647]=32'hb25765bf;
 rom[2648]=32'hb27f65dd;
 rom[2649]=32'hb2a765fc;
 rom[2650]=32'hb2cf661a;
 rom[2651]=32'hb2f76638;
 rom[2652]=32'hb3206656;
 rom[2653]=32'hb3486675;
 rom[2654]=32'hb3706693;
 rom[2655]=32'hb39866b1;
 rom[2656]=32'hb3c166cf;
 rom[2657]=32'hb3e966ed;
 rom[2658]=32'hb412670a;
 rom[2659]=32'hb43a6728;
 rom[2660]=32'hb4636746;
 rom[2661]=32'hb48b6764;
 rom[2662]=32'hb4b46781;
 rom[2663]=32'hb4dc679f;
 rom[2664]=32'hb50567bc;
 rom[2665]=32'hb52e67da;
 rom[2666]=32'hb55767f7;
 rom[2667]=32'hb5806814;
 rom[2668]=32'hb5a86832;
 rom[2669]=32'hb5d1684f;
 rom[2670]=32'hb5fa686c;
 rom[2671]=32'hb6236889;
 rom[2672]=32'hb64c68a6;
 rom[2673]=32'hb67668c3;
 rom[2674]=32'hb69f68e0;
 rom[2675]=32'hb6c868fc;
 rom[2676]=32'hb6f16919;
 rom[2677]=32'hb71b6936;
 rom[2678]=32'hb7446952;
 rom[2679]=32'hb76d696f;
 rom[2680]=32'hb797698b;
 rom[2681]=32'hb7c069a8;
 rom[2682]=32'hb7ea69c4;
 rom[2683]=32'hb81369e0;
 rom[2684]=32'hb83d69fd;
 rom[2685]=32'hb8666a19;
 rom[2686]=32'hb8906a35;
 rom[2687]=32'hb8ba6a51;
 rom[2688]=32'hb8e46a6d;
 rom[2689]=32'hb90d6a89;
 rom[2690]=32'hb9376aa4;
 rom[2691]=32'hb9616ac0;
 rom[2692]=32'hb98b6adc;
 rom[2693]=32'hb9b56af8;
 rom[2694]=32'hb9df6b13;
 rom[2695]=32'hba096b2f;
 rom[2696]=32'hba336b4a;
 rom[2697]=32'hba5d6b65;
 rom[2698]=32'hba886b81;
 rom[2699]=32'hbab26b9c;
 rom[2700]=32'hbadc6bb7;
 rom[2701]=32'hbb076bd2;
 rom[2702]=32'hbb316bed;
 rom[2703]=32'hbb5b6c08;
 rom[2704]=32'hbb866c23;
 rom[2705]=32'hbbb06c3e;
 rom[2706]=32'hbbdb6c59;
 rom[2707]=32'hbc056c74;
 rom[2708]=32'hbc306c8e;
 rom[2709]=32'hbc5b6ca9;
 rom[2710]=32'hbc856cc3;
 rom[2711]=32'hbcb06cde;
 rom[2712]=32'hbcdb6cf8;
 rom[2713]=32'hbd066d13;
 rom[2714]=32'hbd306d2d;
 rom[2715]=32'hbd5b6d47;
 rom[2716]=32'hbd866d61;
 rom[2717]=32'hbdb16d7b;
 rom[2718]=32'hbddc6d95;
 rom[2719]=32'hbe076daf;
 rom[2720]=32'hbe326dc9;
 rom[2721]=32'hbe5e6de3;
 rom[2722]=32'hbe896dfd;
 rom[2723]=32'hbeb46e16;
 rom[2724]=32'hbedf6e30;
 rom[2725]=32'hbf0a6e4a;
 rom[2726]=32'hbf366e63;
 rom[2727]=32'hbf616e7c;
 rom[2728]=32'hbf8d6e96;
 rom[2729]=32'hbfb86eaf;
 rom[2730]=32'hbfe36ec8;
 rom[2731]=32'hc00f6ee1;
 rom[2732]=32'hc03b6efb;
 rom[2733]=32'hc0666f14;
 rom[2734]=32'hc0926f2c;
 rom[2735]=32'hc0bd6f45;
 rom[2736]=32'hc0e96f5e;
 rom[2737]=32'hc1156f77;
 rom[2738]=32'hc1416f90;
 rom[2739]=32'hc16d6fa8;
 rom[2740]=32'hc1986fc1;
 rom[2741]=32'hc1c46fd9;
 rom[2742]=32'hc1f06ff2;
 rom[2743]=32'hc21c700a;
 rom[2744]=32'hc2487022;
 rom[2745]=32'hc274703a;
 rom[2746]=32'hc2a07053;
 rom[2747]=32'hc2cd706b;
 rom[2748]=32'hc2f97083;
 rom[2749]=32'hc325709b;
 rom[2750]=32'hc35170b2;
 rom[2751]=32'hc37d70ca;
 rom[2752]=32'hc3aa70e2;
 rom[2753]=32'hc3d670fa;
 rom[2754]=32'hc4027111;
 rom[2755]=32'hc42f7129;
 rom[2756]=32'hc45b7140;
 rom[2757]=32'hc4887158;
 rom[2758]=32'hc4b4716f;
 rom[2759]=32'hc4e17186;
 rom[2760]=32'hc50e719d;
 rom[2761]=32'hc53a71b4;
 rom[2762]=32'hc56771cb;
 rom[2763]=32'hc59471e2;
 rom[2764]=32'hc5c071f9;
 rom[2765]=32'hc5ed7210;
 rom[2766]=32'hc61a7227;
 rom[2767]=32'hc647723e;
 rom[2768]=32'hc6747254;
 rom[2769]=32'hc6a0726b;
 rom[2770]=32'hc6cd7281;
 rom[2771]=32'hc6fa7298;
 rom[2772]=32'hc72772ae;
 rom[2773]=32'hc75572c4;
 rom[2774]=32'hc78272db;
 rom[2775]=32'hc7af72f1;
 rom[2776]=32'hc7dc7307;
 rom[2777]=32'hc809731d;
 rom[2778]=32'hc8367333;
 rom[2779]=32'hc8647349;
 rom[2780]=32'hc891735e;
 rom[2781]=32'hc8be7374;
 rom[2782]=32'hc8eb738a;
 rom[2783]=32'hc919739f;
 rom[2784]=32'hc94673b5;
 rom[2785]=32'hc97473ca;
 rom[2786]=32'hc9a173e0;
 rom[2787]=32'hc9cf73f5;
 rom[2788]=32'hc9fc740a;
 rom[2789]=32'hca2a7420;
 rom[2790]=32'hca587435;
 rom[2791]=32'hca85744a;
 rom[2792]=32'hcab3745f;
 rom[2793]=32'hcae17474;
 rom[2794]=32'hcb0e7488;
 rom[2795]=32'hcb3c749d;
 rom[2796]=32'hcb6a74b2;
 rom[2797]=32'hcb9874c6;
 rom[2798]=32'hcbc674db;
 rom[2799]=32'hcbf474f0;
 rom[2800]=32'hcc217504;
 rom[2801]=32'hcc4f7518;
 rom[2802]=32'hcc7d752d;
 rom[2803]=32'hccab7541;
 rom[2804]=32'hccda7555;
 rom[2805]=32'hcd087569;
 rom[2806]=32'hcd36757d;
 rom[2807]=32'hcd647591;
 rom[2808]=32'hcd9275a5;
 rom[2809]=32'hcdc075b8;
 rom[2810]=32'hcdef75cc;
 rom[2811]=32'hce1d75e0;
 rom[2812]=32'hce4b75f3;
 rom[2813]=32'hce797607;
 rom[2814]=32'hcea8761a;
 rom[2815]=32'hced6762d;
 rom[2816]=32'hcf057641;
 rom[2817]=32'hcf337654;
 rom[2818]=32'hcf627667;
 rom[2819]=32'hcf90767a;
 rom[2820]=32'hcfbf768d;
 rom[2821]=32'hcfed76a0;
 rom[2822]=32'hd01c76b3;
 rom[2823]=32'hd04a76c6;
 rom[2824]=32'hd07976d8;
 rom[2825]=32'hd0a876eb;
 rom[2826]=32'hd0d676fe;
 rom[2827]=32'hd1057710;
 rom[2828]=32'hd1347722;
 rom[2829]=32'hd1637735;
 rom[2830]=32'hd1927747;
 rom[2831]=32'hd1c07759;
 rom[2832]=32'hd1ef776b;
 rom[2833]=32'hd21e777d;
 rom[2834]=32'hd24d778f;
 rom[2835]=32'hd27c77a1;
 rom[2836]=32'hd2ab77b3;
 rom[2837]=32'hd2da77c5;
 rom[2838]=32'hd30977d7;
 rom[2839]=32'hd33877e8;
 rom[2840]=32'hd36777fa;
 rom[2841]=32'hd396780b;
 rom[2842]=32'hd3c6781d;
 rom[2843]=32'hd3f5782e;
 rom[2844]=32'hd424783f;
 rom[2845]=32'hd4537850;
 rom[2846]=32'hd4837862;
 rom[2847]=32'hd4b27873;
 rom[2848]=32'hd4e17884;
 rom[2849]=32'hd5107894;
 rom[2850]=32'hd54078a5;
 rom[2851]=32'hd56f78b6;
 rom[2852]=32'hd59f78c7;
 rom[2853]=32'hd5ce78d7;
 rom[2854]=32'hd5fe78e8;
 rom[2855]=32'hd62d78f8;
 rom[2856]=32'hd65d7909;
 rom[2857]=32'hd68c7919;
 rom[2858]=32'hd6bc7929;
 rom[2859]=32'hd6eb7939;
 rom[2860]=32'hd71b794a;
 rom[2861]=32'hd74b795a;
 rom[2862]=32'hd77a796a;
 rom[2863]=32'hd7aa7979;
 rom[2864]=32'hd7da7989;
 rom[2865]=32'hd8097999;
 rom[2866]=32'hd83979a9;
 rom[2867]=32'hd86979b8;
 rom[2868]=32'hd89979c8;
 rom[2869]=32'hd8c979d7;
 rom[2870]=32'hd8f879e6;
 rom[2871]=32'hd92879f6;
 rom[2872]=32'hd9587a05;
 rom[2873]=32'hd9887a14;
 rom[2874]=32'hd9b87a23;
 rom[2875]=32'hd9e87a32;
 rom[2876]=32'hda187a41;
 rom[2877]=32'hda487a50;
 rom[2878]=32'hda787a5f;
 rom[2879]=32'hdaa87a6d;
 rom[2880]=32'hdad87a7c;
 rom[2881]=32'hdb087a8b;
 rom[2882]=32'hdb387a99;
 rom[2883]=32'hdb697aa8;
 rom[2884]=32'hdb997ab6;
 rom[2885]=32'hdbc97ac4;
 rom[2886]=32'hdbf97ad2;
 rom[2887]=32'hdc297ae0;
 rom[2888]=32'hdc5a7aee;
 rom[2889]=32'hdc8a7afc;
 rom[2890]=32'hdcba7b0a;
 rom[2891]=32'hdceb7b18;
 rom[2892]=32'hdd1b7b26;
 rom[2893]=32'hdd4b7b33;
 rom[2894]=32'hdd7c7b41;
 rom[2895]=32'hddac7b4f;
 rom[2896]=32'hdddd7b5c;
 rom[2897]=32'hde0d7b69;
 rom[2898]=32'hde3e7b77;
 rom[2899]=32'hde6e7b84;
 rom[2900]=32'hde9f7b91;
 rom[2901]=32'hdecf7b9e;
 rom[2902]=32'hdf007bab;
 rom[2903]=32'hdf307bb8;
 rom[2904]=32'hdf617bc5;
 rom[2905]=32'hdf917bd2;
 rom[2906]=32'hdfc27bde;
 rom[2907]=32'hdff37beb;
 rom[2908]=32'he0237bf8;
 rom[2909]=32'he0547c04;
 rom[2910]=32'he0857c10;
 rom[2911]=32'he0b67c1d;
 rom[2912]=32'he0e67c29;
 rom[2913]=32'he1177c35;
 rom[2914]=32'he1487c41;
 rom[2915]=32'he1797c4d;
 rom[2916]=32'he1a97c59;
 rom[2917]=32'he1da7c65;
 rom[2918]=32'he20b7c71;
 rom[2919]=32'he23c7c7d;
 rom[2920]=32'he26d7c88;
 rom[2921]=32'he29e7c94;
 rom[2922]=32'he2cf7c9f;
 rom[2923]=32'he3007cab;
 rom[2924]=32'he3317cb6;
 rom[2925]=32'he3627cc1;
 rom[2926]=32'he3937ccd;
 rom[2927]=32'he3c47cd8;
 rom[2928]=32'he3f57ce3;
 rom[2929]=32'he4267cee;
 rom[2930]=32'he4577cf9;
 rom[2931]=32'he4887d04;
 rom[2932]=32'he4b97d0e;
 rom[2933]=32'he4ea7d19;
 rom[2934]=32'he51b7d24;
 rom[2935]=32'he54c7d2e;
 rom[2936]=32'he57e7d39;
 rom[2937]=32'he5af7d43;
 rom[2938]=32'he5e07d4d;
 rom[2939]=32'he6117d57;
 rom[2940]=32'he6427d62;
 rom[2941]=32'he6747d6c;
 rom[2942]=32'he6a57d76;
 rom[2943]=32'he6d67d80;
 rom[2944]=32'he7077d89;
 rom[2945]=32'he7397d93;
 rom[2946]=32'he76a7d9d;
 rom[2947]=32'he79b7da6;
 rom[2948]=32'he7cd7db0;
 rom[2949]=32'he7fe7db9;
 rom[2950]=32'he8307dc3;
 rom[2951]=32'he8617dcc;
 rom[2952]=32'he8927dd5;
 rom[2953]=32'he8c47ddf;
 rom[2954]=32'he8f57de8;
 rom[2955]=32'he9277df1;
 rom[2956]=32'he9587dfa;
 rom[2957]=32'he98a7e02;
 rom[2958]=32'he9bb7e0b;
 rom[2959]=32'he9ed7e14;
 rom[2960]=32'hea1e7e1d;
 rom[2961]=32'hea507e25;
 rom[2962]=32'hea817e2e;
 rom[2963]=32'heab37e36;
 rom[2964]=32'heae47e3e;
 rom[2965]=32'heb167e47;
 rom[2966]=32'heb477e4f;
 rom[2967]=32'heb797e57;
 rom[2968]=32'hebab7e5f;
 rom[2969]=32'hebdc7e67;
 rom[2970]=32'hec0e7e6f;
 rom[2971]=32'hec407e77;
 rom[2972]=32'hec717e7e;
 rom[2973]=32'heca37e86;
 rom[2974]=32'hecd57e8d;
 rom[2975]=32'hed067e95;
 rom[2976]=32'hed387e9c;
 rom[2977]=32'hed6a7ea4;
 rom[2978]=32'hed9c7eab;
 rom[2979]=32'hedcd7eb2;
 rom[2980]=32'hedff7eb9;
 rom[2981]=32'hee317ec0;
 rom[2982]=32'hee637ec7;
 rom[2983]=32'hee947ece;
 rom[2984]=32'heec67ed5;
 rom[2985]=32'heef87edc;
 rom[2986]=32'hef2a7ee2;
 rom[2987]=32'hef5c7ee9;
 rom[2988]=32'hef8e7eef;
 rom[2989]=32'hefbf7ef6;
 rom[2990]=32'heff17efc;
 rom[2991]=32'hf0237f02;
 rom[2992]=32'hf0557f09;
 rom[2993]=32'hf0877f0f;
 rom[2994]=32'hf0b97f15;
 rom[2995]=32'hf0eb7f1b;
 rom[2996]=32'hf11d7f21;
 rom[2997]=32'hf14f7f26;
 rom[2998]=32'hf1807f2c;
 rom[2999]=32'hf1b27f32;
 rom[3000]=32'hf1e47f37;
 rom[3001]=32'hf2167f3d;
 rom[3002]=32'hf2487f42;
 rom[3003]=32'hf27a7f48;
 rom[3004]=32'hf2ac7f4d;
 rom[3005]=32'hf2de7f52;
 rom[3006]=32'hf3107f57;
 rom[3007]=32'hf3427f5c;
 rom[3008]=32'hf3747f61;
 rom[3009]=32'hf3a67f66;
 rom[3010]=32'hf3d87f6b;
 rom[3011]=32'hf40a7f70;
 rom[3012]=32'hf43c7f74;
 rom[3013]=32'hf46e7f79;
 rom[3014]=32'hf4a17f7d;
 rom[3015]=32'hf4d37f82;
 rom[3016]=32'hf5057f86;
 rom[3017]=32'hf5377f8a;
 rom[3018]=32'hf5697f8f;
 rom[3019]=32'hf59b7f93;
 rom[3020]=32'hf5cd7f97;
 rom[3021]=32'hf5ff7f9b;
 rom[3022]=32'hf6317f9f;
 rom[3023]=32'hf6637fa2;
 rom[3024]=32'hf6967fa6;
 rom[3025]=32'hf6c87faa;
 rom[3026]=32'hf6fa7fad;
 rom[3027]=32'hf72c7fb1;
 rom[3028]=32'hf75e7fb4;
 rom[3029]=32'hf7907fb8;
 rom[3030]=32'hf7c27fbb;
 rom[3031]=32'hf7f57fbe;
 rom[3032]=32'hf8277fc1;
 rom[3033]=32'hf8597fc4;
 rom[3034]=32'hf88b7fc7;
 rom[3035]=32'hf8bd7fca;
 rom[3036]=32'hf8ef7fcd;
 rom[3037]=32'hf9227fd0;
 rom[3038]=32'hf9547fd2;
 rom[3039]=32'hf9867fd5;
 rom[3040]=32'hf9b87fd8;
 rom[3041]=32'hf9ea7fda;
 rom[3042]=32'hfa1d7fdc;
 rom[3043]=32'hfa4f7fdf;
 rom[3044]=32'hfa817fe1;
 rom[3045]=32'hfab37fe3;
 rom[3046]=32'hfae57fe5;
 rom[3047]=32'hfb187fe7;
 rom[3048]=32'hfb4a7fe9;
 rom[3049]=32'hfb7c7feb;
 rom[3050]=32'hfbae7fec;
 rom[3051]=32'hfbe17fee;
 rom[3052]=32'hfc137ff0;
 rom[3053]=32'hfc457ff1;
 rom[3054]=32'hfc777ff3;
 rom[3055]=32'hfcaa7ff4;
 rom[3056]=32'hfcdc7ff5;
 rom[3057]=32'hfd0e7ff6;
 rom[3058]=32'hfd407ff7;
 rom[3059]=32'hfd737ff8;
 rom[3060]=32'hfda57ff9;
 rom[3061]=32'hfdd77ffa;
 rom[3062]=32'hfe097ffb;
 rom[3063]=32'hfe3c7ffc;
 rom[3064]=32'hfe6e7ffd;
 rom[3065]=32'hfea07ffd;
 rom[3066]=32'hfed27ffe;
 rom[3067]=32'hff057ffe;
 rom[3068]=32'hff377ffe;
 rom[3069]=32'hff697fff;
 rom[3070]=32'hff9b7fff;
 rom[3071]=32'hffce7fff;
 rom[3072]=32'h00007fff;
 rom[3073]=32'h00327fff;
 rom[3074]=32'h00657fff;
 rom[3075]=32'h00977fff;
 rom[3076]=32'h00c97ffe;
 rom[3077]=32'h00fb7ffe;
 rom[3078]=32'h012e7ffe;
 rom[3079]=32'h01607ffd;
 rom[3080]=32'h01927ffd;
 rom[3081]=32'h01c47ffc;
 rom[3082]=32'h01f77ffb;
 rom[3083]=32'h02297ffa;
 rom[3084]=32'h025b7ff9;
 rom[3085]=32'h028d7ff8;
 rom[3086]=32'h02c07ff7;
 rom[3087]=32'h02f27ff6;
 rom[3088]=32'h03247ff5;
 rom[3089]=32'h03567ff4;
 rom[3090]=32'h03897ff3;
 rom[3091]=32'h03bb7ff1;
 rom[3092]=32'h03ed7ff0;
 rom[3093]=32'h041f7fee;
 rom[3094]=32'h04527fec;
 rom[3095]=32'h04847feb;
 rom[3096]=32'h04b67fe9;
 rom[3097]=32'h04e87fe7;
 rom[3098]=32'h051b7fe5;
 rom[3099]=32'h054d7fe3;
 rom[3100]=32'h057f7fe1;
 rom[3101]=32'h05b17fdf;
 rom[3102]=32'h05e37fdc;
 rom[3103]=32'h06167fda;
 rom[3104]=32'h06487fd8;
 rom[3105]=32'h067a7fd5;
 rom[3106]=32'h06ac7fd2;
 rom[3107]=32'h06de7fd0;
 rom[3108]=32'h07117fcd;
 rom[3109]=32'h07437fca;
 rom[3110]=32'h07757fc7;
 rom[3111]=32'h07a77fc4;
 rom[3112]=32'h07d97fc1;
 rom[3113]=32'h080b7fbe;
 rom[3114]=32'h083e7fbb;
 rom[3115]=32'h08707fb8;
 rom[3116]=32'h08a27fb4;
 rom[3117]=32'h08d47fb1;
 rom[3118]=32'h09067fad;
 rom[3119]=32'h09387faa;
 rom[3120]=32'h096a7fa6;
 rom[3121]=32'h099d7fa2;
 rom[3122]=32'h09cf7f9f;
 rom[3123]=32'h0a017f9b;
 rom[3124]=32'h0a337f97;
 rom[3125]=32'h0a657f93;
 rom[3126]=32'h0a977f8f;
 rom[3127]=32'h0ac97f8a;
 rom[3128]=32'h0afb7f86;
 rom[3129]=32'h0b2d7f82;
 rom[3130]=32'h0b5f7f7d;
 rom[3131]=32'h0b927f79;
 rom[3132]=32'h0bc47f74;
 rom[3133]=32'h0bf67f70;
 rom[3134]=32'h0c287f6b;
 rom[3135]=32'h0c5a7f66;
 rom[3136]=32'h0c8c7f61;
 rom[3137]=32'h0cbe7f5c;
 rom[3138]=32'h0cf07f57;
 rom[3139]=32'h0d227f52;
 rom[3140]=32'h0d547f4d;
 rom[3141]=32'h0d867f48;
 rom[3142]=32'h0db87f42;
 rom[3143]=32'h0dea7f3d;
 rom[3144]=32'h0e1c7f37;
 rom[3145]=32'h0e4e7f32;
 rom[3146]=32'h0e807f2c;
 rom[3147]=32'h0eb17f26;
 rom[3148]=32'h0ee37f21;
 rom[3149]=32'h0f157f1b;
 rom[3150]=32'h0f477f15;
 rom[3151]=32'h0f797f0f;
 rom[3152]=32'h0fab7f09;
 rom[3153]=32'h0fdd7f02;
 rom[3154]=32'h100f7efc;
 rom[3155]=32'h10417ef6;
 rom[3156]=32'h10727eef;
 rom[3157]=32'h10a47ee9;
 rom[3158]=32'h10d67ee2;
 rom[3159]=32'h11087edc;
 rom[3160]=32'h113a7ed5;
 rom[3161]=32'h116c7ece;
 rom[3162]=32'h119d7ec7;
 rom[3163]=32'h11cf7ec0;
 rom[3164]=32'h12017eb9;
 rom[3165]=32'h12337eb2;
 rom[3166]=32'h12647eab;
 rom[3167]=32'h12967ea4;
 rom[3168]=32'h12c87e9c;
 rom[3169]=32'h12fa7e95;
 rom[3170]=32'h132b7e8d;
 rom[3171]=32'h135d7e86;
 rom[3172]=32'h138f7e7e;
 rom[3173]=32'h13c07e77;
 rom[3174]=32'h13f27e6f;
 rom[3175]=32'h14247e67;
 rom[3176]=32'h14557e5f;
 rom[3177]=32'h14877e57;
 rom[3178]=32'h14b97e4f;
 rom[3179]=32'h14ea7e47;
 rom[3180]=32'h151c7e3e;
 rom[3181]=32'h154d7e36;
 rom[3182]=32'h157f7e2e;
 rom[3183]=32'h15b07e25;
 rom[3184]=32'h15e27e1d;
 rom[3185]=32'h16137e14;
 rom[3186]=32'h16457e0b;
 rom[3187]=32'h16767e02;
 rom[3188]=32'h16a87dfa;
 rom[3189]=32'h16d97df1;
 rom[3190]=32'h170b7de8;
 rom[3191]=32'h173c7ddf;
 rom[3192]=32'h176e7dd5;
 rom[3193]=32'h179f7dcc;
 rom[3194]=32'h17d07dc3;
 rom[3195]=32'h18027db9;
 rom[3196]=32'h18337db0;
 rom[3197]=32'h18657da6;
 rom[3198]=32'h18967d9d;
 rom[3199]=32'h18c77d93;
 rom[3200]=32'h18f97d89;
 rom[3201]=32'h192a7d80;
 rom[3202]=32'h195b7d76;
 rom[3203]=32'h198c7d6c;
 rom[3204]=32'h19be7d62;
 rom[3205]=32'h19ef7d57;
 rom[3206]=32'h1a207d4d;
 rom[3207]=32'h1a517d43;
 rom[3208]=32'h1a827d39;
 rom[3209]=32'h1ab47d2e;
 rom[3210]=32'h1ae57d24;
 rom[3211]=32'h1b167d19;
 rom[3212]=32'h1b477d0e;
 rom[3213]=32'h1b787d04;
 rom[3214]=32'h1ba97cf9;
 rom[3215]=32'h1bda7cee;
 rom[3216]=32'h1c0b7ce3;
 rom[3217]=32'h1c3c7cd8;
 rom[3218]=32'h1c6d7ccd;
 rom[3219]=32'h1c9e7cc1;
 rom[3220]=32'h1ccf7cb6;
 rom[3221]=32'h1d007cab;
 rom[3222]=32'h1d317c9f;
 rom[3223]=32'h1d627c94;
 rom[3224]=32'h1d937c88;
 rom[3225]=32'h1dc47c7d;
 rom[3226]=32'h1df57c71;
 rom[3227]=32'h1e267c65;
 rom[3228]=32'h1e577c59;
 rom[3229]=32'h1e877c4d;
 rom[3230]=32'h1eb87c41;
 rom[3231]=32'h1ee97c35;
 rom[3232]=32'h1f1a7c29;
 rom[3233]=32'h1f4a7c1d;
 rom[3234]=32'h1f7b7c10;
 rom[3235]=32'h1fac7c04;
 rom[3236]=32'h1fdd7bf8;
 rom[3237]=32'h200d7beb;
 rom[3238]=32'h203e7bde;
 rom[3239]=32'h206f7bd2;
 rom[3240]=32'h209f7bc5;
 rom[3241]=32'h20d07bb8;
 rom[3242]=32'h21007bab;
 rom[3243]=32'h21317b9e;
 rom[3244]=32'h21617b91;
 rom[3245]=32'h21927b84;
 rom[3246]=32'h21c27b77;
 rom[3247]=32'h21f37b69;
 rom[3248]=32'h22237b5c;
 rom[3249]=32'h22547b4f;
 rom[3250]=32'h22847b41;
 rom[3251]=32'h22b57b33;
 rom[3252]=32'h22e57b26;
 rom[3253]=32'h23157b18;
 rom[3254]=32'h23467b0a;
 rom[3255]=32'h23767afc;
 rom[3256]=32'h23a67aee;
 rom[3257]=32'h23d77ae0;
 rom[3258]=32'h24077ad2;
 rom[3259]=32'h24377ac4;
 rom[3260]=32'h24677ab6;
 rom[3261]=32'h24977aa8;
 rom[3262]=32'h24c87a99;
 rom[3263]=32'h24f87a8b;
 rom[3264]=32'h25287a7c;
 rom[3265]=32'h25587a6d;
 rom[3266]=32'h25887a5f;
 rom[3267]=32'h25b87a50;
 rom[3268]=32'h25e87a41;
 rom[3269]=32'h26187a32;
 rom[3270]=32'h26487a23;
 rom[3271]=32'h26787a14;
 rom[3272]=32'h26a87a05;
 rom[3273]=32'h26d879f6;
 rom[3274]=32'h270879e6;
 rom[3275]=32'h273779d7;
 rom[3276]=32'h276779c8;
 rom[3277]=32'h279779b8;
 rom[3278]=32'h27c779a9;
 rom[3279]=32'h27f77999;
 rom[3280]=32'h28267989;
 rom[3281]=32'h28567979;
 rom[3282]=32'h2886796a;
 rom[3283]=32'h28b5795a;
 rom[3284]=32'h28e5794a;
 rom[3285]=32'h29157939;
 rom[3286]=32'h29447929;
 rom[3287]=32'h29747919;
 rom[3288]=32'h29a37909;
 rom[3289]=32'h29d378f8;
 rom[3290]=32'h2a0278e8;
 rom[3291]=32'h2a3278d7;
 rom[3292]=32'h2a6178c7;
 rom[3293]=32'h2a9178b6;
 rom[3294]=32'h2ac078a5;
 rom[3295]=32'h2af07894;
 rom[3296]=32'h2b1f7884;
 rom[3297]=32'h2b4e7873;
 rom[3298]=32'h2b7d7862;
 rom[3299]=32'h2bad7850;
 rom[3300]=32'h2bdc783f;
 rom[3301]=32'h2c0b782e;
 rom[3302]=32'h2c3a781d;
 rom[3303]=32'h2c6a780b;
 rom[3304]=32'h2c9977fa;
 rom[3305]=32'h2cc877e8;
 rom[3306]=32'h2cf777d7;
 rom[3307]=32'h2d2677c5;
 rom[3308]=32'h2d5577b3;
 rom[3309]=32'h2d8477a1;
 rom[3310]=32'h2db3778f;
 rom[3311]=32'h2de2777d;
 rom[3312]=32'h2e11776b;
 rom[3313]=32'h2e407759;
 rom[3314]=32'h2e6e7747;
 rom[3315]=32'h2e9d7735;
 rom[3316]=32'h2ecc7722;
 rom[3317]=32'h2efb7710;
 rom[3318]=32'h2f2a76fe;
 rom[3319]=32'h2f5876eb;
 rom[3320]=32'h2f8776d8;
 rom[3321]=32'h2fb676c6;
 rom[3322]=32'h2fe476b3;
 rom[3323]=32'h301376a0;
 rom[3324]=32'h3041768d;
 rom[3325]=32'h3070767a;
 rom[3326]=32'h309e7667;
 rom[3327]=32'h30cd7654;
 rom[3328]=32'h30fb7641;
 rom[3329]=32'h312a762d;
 rom[3330]=32'h3158761a;
 rom[3331]=32'h31877607;
 rom[3332]=32'h31b575f3;
 rom[3333]=32'h31e375e0;
 rom[3334]=32'h321175cc;
 rom[3335]=32'h324075b8;
 rom[3336]=32'h326e75a5;
 rom[3337]=32'h329c7591;
 rom[3338]=32'h32ca757d;
 rom[3339]=32'h32f87569;
 rom[3340]=32'h33267555;
 rom[3341]=32'h33557541;
 rom[3342]=32'h3383752d;
 rom[3343]=32'h33b17518;
 rom[3344]=32'h33df7504;
 rom[3345]=32'h340c74f0;
 rom[3346]=32'h343a74db;
 rom[3347]=32'h346874c6;
 rom[3348]=32'h349674b2;
 rom[3349]=32'h34c4749d;
 rom[3350]=32'h34f27488;
 rom[3351]=32'h351f7474;
 rom[3352]=32'h354d745f;
 rom[3353]=32'h357b744a;
 rom[3354]=32'h35a87435;
 rom[3355]=32'h35d67420;
 rom[3356]=32'h3604740a;
 rom[3357]=32'h363173f5;
 rom[3358]=32'h365f73e0;
 rom[3359]=32'h368c73ca;
 rom[3360]=32'h36ba73b5;
 rom[3361]=32'h36e7739f;
 rom[3362]=32'h3715738a;
 rom[3363]=32'h37427374;
 rom[3364]=32'h376f735e;
 rom[3365]=32'h379c7349;
 rom[3366]=32'h37ca7333;
 rom[3367]=32'h37f7731d;
 rom[3368]=32'h38247307;
 rom[3369]=32'h385172f1;
 rom[3370]=32'h387e72db;
 rom[3371]=32'h38ab72c4;
 rom[3372]=32'h38d972ae;
 rom[3373]=32'h39067298;
 rom[3374]=32'h39337281;
 rom[3375]=32'h3960726b;
 rom[3376]=32'h398c7254;
 rom[3377]=32'h39b9723e;
 rom[3378]=32'h39e67227;
 rom[3379]=32'h3a137210;
 rom[3380]=32'h3a4071f9;
 rom[3381]=32'h3a6c71e2;
 rom[3382]=32'h3a9971cb;
 rom[3383]=32'h3ac671b4;
 rom[3384]=32'h3af2719d;
 rom[3385]=32'h3b1f7186;
 rom[3386]=32'h3b4c716f;
 rom[3387]=32'h3b787158;
 rom[3388]=32'h3ba57140;
 rom[3389]=32'h3bd17129;
 rom[3390]=32'h3bfe7111;
 rom[3391]=32'h3c2a70fa;
 rom[3392]=32'h3c5670e2;
 rom[3393]=32'h3c8370ca;
 rom[3394]=32'h3caf70b2;
 rom[3395]=32'h3cdb709b;
 rom[3396]=32'h3d077083;
 rom[3397]=32'h3d33706b;
 rom[3398]=32'h3d607053;
 rom[3399]=32'h3d8c703a;
 rom[3400]=32'h3db87022;
 rom[3401]=32'h3de4700a;
 rom[3402]=32'h3e106ff2;
 rom[3403]=32'h3e3c6fd9;
 rom[3404]=32'h3e686fc1;
 rom[3405]=32'h3e936fa8;
 rom[3406]=32'h3ebf6f90;
 rom[3407]=32'h3eeb6f77;
 rom[3408]=32'h3f176f5e;
 rom[3409]=32'h3f436f45;
 rom[3410]=32'h3f6e6f2c;
 rom[3411]=32'h3f9a6f14;
 rom[3412]=32'h3fc56efb;
 rom[3413]=32'h3ff16ee1;
 rom[3414]=32'h401d6ec8;
 rom[3415]=32'h40486eaf;
 rom[3416]=32'h40736e96;
 rom[3417]=32'h409f6e7c;
 rom[3418]=32'h40ca6e63;
 rom[3419]=32'h40f66e4a;
 rom[3420]=32'h41216e30;
 rom[3421]=32'h414c6e16;
 rom[3422]=32'h41776dfd;
 rom[3423]=32'h41a26de3;
 rom[3424]=32'h41ce6dc9;
 rom[3425]=32'h41f96daf;
 rom[3426]=32'h42246d95;
 rom[3427]=32'h424f6d7b;
 rom[3428]=32'h427a6d61;
 rom[3429]=32'h42a56d47;
 rom[3430]=32'h42d06d2d;
 rom[3431]=32'h42fa6d13;
 rom[3432]=32'h43256cf8;
 rom[3433]=32'h43506cde;
 rom[3434]=32'h437b6cc3;
 rom[3435]=32'h43a56ca9;
 rom[3436]=32'h43d06c8e;
 rom[3437]=32'h43fb6c74;
 rom[3438]=32'h44256c59;
 rom[3439]=32'h44506c3e;
 rom[3440]=32'h447a6c23;
 rom[3441]=32'h44a56c08;
 rom[3442]=32'h44cf6bed;
 rom[3443]=32'h44f96bd2;
 rom[3444]=32'h45246bb7;
 rom[3445]=32'h454e6b9c;
 rom[3446]=32'h45786b81;
 rom[3447]=32'h45a36b65;
 rom[3448]=32'h45cd6b4a;
 rom[3449]=32'h45f76b2f;
 rom[3450]=32'h46216b13;
 rom[3451]=32'h464b6af8;
 rom[3452]=32'h46756adc;
 rom[3453]=32'h469f6ac0;
 rom[3454]=32'h46c96aa4;
 rom[3455]=32'h46f36a89;
 rom[3456]=32'h471c6a6d;
 rom[3457]=32'h47466a51;
 rom[3458]=32'h47706a35;
 rom[3459]=32'h479a6a19;
 rom[3460]=32'h47c369fd;
 rom[3461]=32'h47ed69e0;
 rom[3462]=32'h481669c4;
 rom[3463]=32'h484069a8;
 rom[3464]=32'h4869698b;
 rom[3465]=32'h4893696f;
 rom[3466]=32'h48bc6952;
 rom[3467]=32'h48e56936;
 rom[3468]=32'h490f6919;
 rom[3469]=32'h493868fc;
 rom[3470]=32'h496168e0;
 rom[3471]=32'h498a68c3;
 rom[3472]=32'h49b468a6;
 rom[3473]=32'h49dd6889;
 rom[3474]=32'h4a06686c;
 rom[3475]=32'h4a2f684f;
 rom[3476]=32'h4a586832;
 rom[3477]=32'h4a806814;
 rom[3478]=32'h4aa967f7;
 rom[3479]=32'h4ad267da;
 rom[3480]=32'h4afb67bc;
 rom[3481]=32'h4b24679f;
 rom[3482]=32'h4b4c6781;
 rom[3483]=32'h4b756764;
 rom[3484]=32'h4b9d6746;
 rom[3485]=32'h4bc66728;
 rom[3486]=32'h4bee670a;
 rom[3487]=32'h4c1766ed;
 rom[3488]=32'h4c3f66cf;
 rom[3489]=32'h4c6866b1;
 rom[3490]=32'h4c906693;
 rom[3491]=32'h4cb86675;
 rom[3492]=32'h4ce06656;
 rom[3493]=32'h4d096638;
 rom[3494]=32'h4d31661a;
 rom[3495]=32'h4d5965fc;
 rom[3496]=32'h4d8165dd;
 rom[3497]=32'h4da965bf;
 rom[3498]=32'h4dd165a0;
 rom[3499]=32'h4df96582;
 rom[3500]=32'h4e206563;
 rom[3501]=32'h4e486544;
 rom[3502]=32'h4e706525;
 rom[3503]=32'h4e986507;
 rom[3504]=32'h4ebf64e8;
 rom[3505]=32'h4ee764c9;
 rom[3506]=32'h4f0e64aa;
 rom[3507]=32'h4f36648b;
 rom[3508]=32'h4f5d646c;
 rom[3509]=32'h4f85644c;
 rom[3510]=32'h4fac642d;
 rom[3511]=32'h4fd4640e;
 rom[3512]=32'h4ffb63ee;
 rom[3513]=32'h502263cf;
 rom[3514]=32'h504963af;
 rom[3515]=32'h50706390;
 rom[3516]=32'h50976370;
 rom[3517]=32'h50be6351;
 rom[3518]=32'h50e56331;
 rom[3519]=32'h510c6311;
 rom[3520]=32'h513362f1;
 rom[3521]=32'h515a62d1;
 rom[3522]=32'h518162b1;
 rom[3523]=32'h51a86291;
 rom[3524]=32'h51ce6271;
 rom[3525]=32'h51f56251;
 rom[3526]=32'h521b6231;
 rom[3527]=32'h52426211;
 rom[3528]=32'h526861f0;
 rom[3529]=32'h528f61d0;
 rom[3530]=32'h52b561af;
 rom[3531]=32'h52dc618f;
 rom[3532]=32'h5302616e;
 rom[3533]=32'h5328614e;
 rom[3534]=32'h534e612d;
 rom[3535]=32'h5374610c;
 rom[3536]=32'h539b60eb;
 rom[3537]=32'h53c160cb;
 rom[3538]=32'h53e760aa;
 rom[3539]=32'h540c6089;
 rom[3540]=32'h54326068;
 rom[3541]=32'h54586047;
 rom[3542]=32'h547e6025;
 rom[3543]=32'h54a46004;
 rom[3544]=32'h54c95fe3;
 rom[3545]=32'h54ef5fc2;
 rom[3546]=32'h55155fa0;
 rom[3547]=32'h553a5f7f;
 rom[3548]=32'h55605f5d;
 rom[3549]=32'h55855f3c;
 rom[3550]=32'h55aa5f1a;
 rom[3551]=32'h55d05ef8;
 rom[3552]=32'h55f55ed7;
 rom[3553]=32'h561a5eb5;
 rom[3554]=32'h563f5e93;
 rom[3555]=32'h56645e71;
 rom[3556]=32'h568a5e4f;
 rom[3557]=32'h56af5e2d;
 rom[3558]=32'h56d35e0b;
 rom[3559]=32'h56f85de9;
 rom[3560]=32'h571d5dc7;
 rom[3561]=32'h57425da5;
 rom[3562]=32'h57675d82;
 rom[3563]=32'h578b5d60;
 rom[3564]=32'h57b05d3e;
 rom[3565]=32'h57d55d1b;
 rom[3566]=32'h57f95cf9;
 rom[3567]=32'h581e5cd6;
 rom[3568]=32'h58425cb3;
 rom[3569]=32'h58675c91;
 rom[3570]=32'h588b5c6e;
 rom[3571]=32'h58af5c4b;
 rom[3572]=32'h58d35c28;
 rom[3573]=32'h58f85c05;
 rom[3574]=32'h591c5be2;
 rom[3575]=32'h59405bbf;
 rom[3576]=32'h59645b9c;
 rom[3577]=32'h59885b79;
 rom[3578]=32'h59ac5b56;
 rom[3579]=32'h59cf5b33;
 rom[3580]=32'h59f35b0f;
 rom[3581]=32'h5a175aec;
 rom[3582]=32'h5a3b5ac9;
 rom[3583]=32'h5a5e5aa5;
 rom[3584]=32'h5a825a82;
 rom[3585]=32'h5aa55a5e;
 rom[3586]=32'h5ac95a3b;
 rom[3587]=32'h5aec5a17;
 rom[3588]=32'h5b0f59f3;
 rom[3589]=32'h5b3359cf;
 rom[3590]=32'h5b5659ac;
 rom[3591]=32'h5b795988;
 rom[3592]=32'h5b9c5964;
 rom[3593]=32'h5bbf5940;
 rom[3594]=32'h5be2591c;
 rom[3595]=32'h5c0558f8;
 rom[3596]=32'h5c2858d3;
 rom[3597]=32'h5c4b58af;
 rom[3598]=32'h5c6e588b;
 rom[3599]=32'h5c915867;
 rom[3600]=32'h5cb35842;
 rom[3601]=32'h5cd6581e;
 rom[3602]=32'h5cf957f9;
 rom[3603]=32'h5d1b57d5;
 rom[3604]=32'h5d3e57b0;
 rom[3605]=32'h5d60578b;
 rom[3606]=32'h5d825767;
 rom[3607]=32'h5da55742;
 rom[3608]=32'h5dc7571d;
 rom[3609]=32'h5de956f8;
 rom[3610]=32'h5e0b56d3;
 rom[3611]=32'h5e2d56af;
 rom[3612]=32'h5e4f568a;
 rom[3613]=32'h5e715664;
 rom[3614]=32'h5e93563f;
 rom[3615]=32'h5eb5561a;
 rom[3616]=32'h5ed755f5;
 rom[3617]=32'h5ef855d0;
 rom[3618]=32'h5f1a55aa;
 rom[3619]=32'h5f3c5585;
 rom[3620]=32'h5f5d5560;
 rom[3621]=32'h5f7f553a;
 rom[3622]=32'h5fa05515;
 rom[3623]=32'h5fc254ef;
 rom[3624]=32'h5fe354c9;
 rom[3625]=32'h600454a4;
 rom[3626]=32'h6025547e;
 rom[3627]=32'h60475458;
 rom[3628]=32'h60685432;
 rom[3629]=32'h6089540c;
 rom[3630]=32'h60aa53e7;
 rom[3631]=32'h60cb53c1;
 rom[3632]=32'h60eb539b;
 rom[3633]=32'h610c5374;
 rom[3634]=32'h612d534e;
 rom[3635]=32'h614e5328;
 rom[3636]=32'h616e5302;
 rom[3637]=32'h618f52dc;
 rom[3638]=32'h61af52b5;
 rom[3639]=32'h61d0528f;
 rom[3640]=32'h61f05268;
 rom[3641]=32'h62115242;
 rom[3642]=32'h6231521b;
 rom[3643]=32'h625151f5;
 rom[3644]=32'h627151ce;
 rom[3645]=32'h629151a8;
 rom[3646]=32'h62b15181;
 rom[3647]=32'h62d1515a;
 rom[3648]=32'h62f15133;
 rom[3649]=32'h6311510c;
 rom[3650]=32'h633150e5;
 rom[3651]=32'h635150be;
 rom[3652]=32'h63705097;
 rom[3653]=32'h63905070;
 rom[3654]=32'h63af5049;
 rom[3655]=32'h63cf5022;
 rom[3656]=32'h63ee4ffb;
 rom[3657]=32'h640e4fd4;
 rom[3658]=32'h642d4fac;
 rom[3659]=32'h644c4f85;
 rom[3660]=32'h646c4f5d;
 rom[3661]=32'h648b4f36;
 rom[3662]=32'h64aa4f0e;
 rom[3663]=32'h64c94ee7;
 rom[3664]=32'h64e84ebf;
 rom[3665]=32'h65074e98;
 rom[3666]=32'h65254e70;
 rom[3667]=32'h65444e48;
 rom[3668]=32'h65634e20;
 rom[3669]=32'h65824df9;
 rom[3670]=32'h65a04dd1;
 rom[3671]=32'h65bf4da9;
 rom[3672]=32'h65dd4d81;
 rom[3673]=32'h65fc4d59;
 rom[3674]=32'h661a4d31;
 rom[3675]=32'h66384d09;
 rom[3676]=32'h66564ce0;
 rom[3677]=32'h66754cb8;
 rom[3678]=32'h66934c90;
 rom[3679]=32'h66b14c68;
 rom[3680]=32'h66cf4c3f;
 rom[3681]=32'h66ed4c17;
 rom[3682]=32'h670a4bee;
 rom[3683]=32'h67284bc6;
 rom[3684]=32'h67464b9d;
 rom[3685]=32'h67644b75;
 rom[3686]=32'h67814b4c;
 rom[3687]=32'h679f4b24;
 rom[3688]=32'h67bc4afb;
 rom[3689]=32'h67da4ad2;
 rom[3690]=32'h67f74aa9;
 rom[3691]=32'h68144a80;
 rom[3692]=32'h68324a58;
 rom[3693]=32'h684f4a2f;
 rom[3694]=32'h686c4a06;
 rom[3695]=32'h688949dd;
 rom[3696]=32'h68a649b4;
 rom[3697]=32'h68c3498a;
 rom[3698]=32'h68e04961;
 rom[3699]=32'h68fc4938;
 rom[3700]=32'h6919490f;
 rom[3701]=32'h693648e5;
 rom[3702]=32'h695248bc;
 rom[3703]=32'h696f4893;
 rom[3704]=32'h698b4869;
 rom[3705]=32'h69a84840;
 rom[3706]=32'h69c44816;
 rom[3707]=32'h69e047ed;
 rom[3708]=32'h69fd47c3;
 rom[3709]=32'h6a19479a;
 rom[3710]=32'h6a354770;
 rom[3711]=32'h6a514746;
 rom[3712]=32'h6a6d471c;
 rom[3713]=32'h6a8946f3;
 rom[3714]=32'h6aa446c9;
 rom[3715]=32'h6ac0469f;
 rom[3716]=32'h6adc4675;
 rom[3717]=32'h6af8464b;
 rom[3718]=32'h6b134621;
 rom[3719]=32'h6b2f45f7;
 rom[3720]=32'h6b4a45cd;
 rom[3721]=32'h6b6545a3;
 rom[3722]=32'h6b814578;
 rom[3723]=32'h6b9c454e;
 rom[3724]=32'h6bb74524;
 rom[3725]=32'h6bd244f9;
 rom[3726]=32'h6bed44cf;
 rom[3727]=32'h6c0844a5;
 rom[3728]=32'h6c23447a;
 rom[3729]=32'h6c3e4450;
 rom[3730]=32'h6c594425;
 rom[3731]=32'h6c7443fb;
 rom[3732]=32'h6c8e43d0;
 rom[3733]=32'h6ca943a5;
 rom[3734]=32'h6cc3437b;
 rom[3735]=32'h6cde4350;
 rom[3736]=32'h6cf84325;
 rom[3737]=32'h6d1342fa;
 rom[3738]=32'h6d2d42d0;
 rom[3739]=32'h6d4742a5;
 rom[3740]=32'h6d61427a;
 rom[3741]=32'h6d7b424f;
 rom[3742]=32'h6d954224;
 rom[3743]=32'h6daf41f9;
 rom[3744]=32'h6dc941ce;
 rom[3745]=32'h6de341a2;
 rom[3746]=32'h6dfd4177;
 rom[3747]=32'h6e16414c;
 rom[3748]=32'h6e304121;
 rom[3749]=32'h6e4a40f6;
 rom[3750]=32'h6e6340ca;
 rom[3751]=32'h6e7c409f;
 rom[3752]=32'h6e964073;
 rom[3753]=32'h6eaf4048;
 rom[3754]=32'h6ec8401d;
 rom[3755]=32'h6ee13ff1;
 rom[3756]=32'h6efb3fc5;
 rom[3757]=32'h6f143f9a;
 rom[3758]=32'h6f2c3f6e;
 rom[3759]=32'h6f453f43;
 rom[3760]=32'h6f5e3f17;
 rom[3761]=32'h6f773eeb;
 rom[3762]=32'h6f903ebf;
 rom[3763]=32'h6fa83e93;
 rom[3764]=32'h6fc13e68;
 rom[3765]=32'h6fd93e3c;
 rom[3766]=32'h6ff23e10;
 rom[3767]=32'h700a3de4;
 rom[3768]=32'h70223db8;
 rom[3769]=32'h703a3d8c;
 rom[3770]=32'h70533d60;
 rom[3771]=32'h706b3d33;
 rom[3772]=32'h70833d07;
 rom[3773]=32'h709b3cdb;
 rom[3774]=32'h70b23caf;
 rom[3775]=32'h70ca3c83;
 rom[3776]=32'h70e23c56;
 rom[3777]=32'h70fa3c2a;
 rom[3778]=32'h71113bfe;
 rom[3779]=32'h71293bd1;
 rom[3780]=32'h71403ba5;
 rom[3781]=32'h71583b78;
 rom[3782]=32'h716f3b4c;
 rom[3783]=32'h71863b1f;
 rom[3784]=32'h719d3af2;
 rom[3785]=32'h71b43ac6;
 rom[3786]=32'h71cb3a99;
 rom[3787]=32'h71e23a6c;
 rom[3788]=32'h71f93a40;
 rom[3789]=32'h72103a13;
 rom[3790]=32'h722739e6;
 rom[3791]=32'h723e39b9;
 rom[3792]=32'h7254398c;
 rom[3793]=32'h726b3960;
 rom[3794]=32'h72813933;
 rom[3795]=32'h72983906;
 rom[3796]=32'h72ae38d9;
 rom[3797]=32'h72c438ab;
 rom[3798]=32'h72db387e;
 rom[3799]=32'h72f13851;
 rom[3800]=32'h73073824;
 rom[3801]=32'h731d37f7;
 rom[3802]=32'h733337ca;
 rom[3803]=32'h7349379c;
 rom[3804]=32'h735e376f;
 rom[3805]=32'h73743742;
 rom[3806]=32'h738a3715;
 rom[3807]=32'h739f36e7;
 rom[3808]=32'h73b536ba;
 rom[3809]=32'h73ca368c;
 rom[3810]=32'h73e0365f;
 rom[3811]=32'h73f53631;
 rom[3812]=32'h740a3604;
 rom[3813]=32'h742035d6;
 rom[3814]=32'h743535a8;
 rom[3815]=32'h744a357b;
 rom[3816]=32'h745f354d;
 rom[3817]=32'h7474351f;
 rom[3818]=32'h748834f2;
 rom[3819]=32'h749d34c4;
 rom[3820]=32'h74b23496;
 rom[3821]=32'h74c63468;
 rom[3822]=32'h74db343a;
 rom[3823]=32'h74f0340c;
 rom[3824]=32'h750433df;
 rom[3825]=32'h751833b1;
 rom[3826]=32'h752d3383;
 rom[3827]=32'h75413355;
 rom[3828]=32'h75553326;
 rom[3829]=32'h756932f8;
 rom[3830]=32'h757d32ca;
 rom[3831]=32'h7591329c;
 rom[3832]=32'h75a5326e;
 rom[3833]=32'h75b83240;
 rom[3834]=32'h75cc3211;
 rom[3835]=32'h75e031e3;
 rom[3836]=32'h75f331b5;
 rom[3837]=32'h76073187;
 rom[3838]=32'h761a3158;
 rom[3839]=32'h762d312a;
 rom[3840]=32'h764130fb;
 rom[3841]=32'h765430cd;
 rom[3842]=32'h7667309e;
 rom[3843]=32'h767a3070;
 rom[3844]=32'h768d3041;
 rom[3845]=32'h76a03013;
 rom[3846]=32'h76b32fe4;
 rom[3847]=32'h76c62fb6;
 rom[3848]=32'h76d82f87;
 rom[3849]=32'h76eb2f58;
 rom[3850]=32'h76fe2f2a;
 rom[3851]=32'h77102efb;
 rom[3852]=32'h77222ecc;
 rom[3853]=32'h77352e9d;
 rom[3854]=32'h77472e6e;
 rom[3855]=32'h77592e40;
 rom[3856]=32'h776b2e11;
 rom[3857]=32'h777d2de2;
 rom[3858]=32'h778f2db3;
 rom[3859]=32'h77a12d84;
 rom[3860]=32'h77b32d55;
 rom[3861]=32'h77c52d26;
 rom[3862]=32'h77d72cf7;
 rom[3863]=32'h77e82cc8;
 rom[3864]=32'h77fa2c99;
 rom[3865]=32'h780b2c6a;
 rom[3866]=32'h781d2c3a;
 rom[3867]=32'h782e2c0b;
 rom[3868]=32'h783f2bdc;
 rom[3869]=32'h78502bad;
 rom[3870]=32'h78622b7d;
 rom[3871]=32'h78732b4e;
 rom[3872]=32'h78842b1f;
 rom[3873]=32'h78942af0;
 rom[3874]=32'h78a52ac0;
 rom[3875]=32'h78b62a91;
 rom[3876]=32'h78c72a61;
 rom[3877]=32'h78d72a32;
 rom[3878]=32'h78e82a02;
 rom[3879]=32'h78f829d3;
 rom[3880]=32'h790929a3;
 rom[3881]=32'h79192974;
 rom[3882]=32'h79292944;
 rom[3883]=32'h79392915;
 rom[3884]=32'h794a28e5;
 rom[3885]=32'h795a28b5;
 rom[3886]=32'h796a2886;
 rom[3887]=32'h79792856;
 rom[3888]=32'h79892826;
 rom[3889]=32'h799927f7;
 rom[3890]=32'h79a927c7;
 rom[3891]=32'h79b82797;
 rom[3892]=32'h79c82767;
 rom[3893]=32'h79d72737;
 rom[3894]=32'h79e62708;
 rom[3895]=32'h79f626d8;
 rom[3896]=32'h7a0526a8;
 rom[3897]=32'h7a142678;
 rom[3898]=32'h7a232648;
 rom[3899]=32'h7a322618;
 rom[3900]=32'h7a4125e8;
 rom[3901]=32'h7a5025b8;
 rom[3902]=32'h7a5f2588;
 rom[3903]=32'h7a6d2558;
 rom[3904]=32'h7a7c2528;
 rom[3905]=32'h7a8b24f8;
 rom[3906]=32'h7a9924c8;
 rom[3907]=32'h7aa82497;
 rom[3908]=32'h7ab62467;
 rom[3909]=32'h7ac42437;
 rom[3910]=32'h7ad22407;
 rom[3911]=32'h7ae023d7;
 rom[3912]=32'h7aee23a6;
 rom[3913]=32'h7afc2376;
 rom[3914]=32'h7b0a2346;
 rom[3915]=32'h7b182315;
 rom[3916]=32'h7b2622e5;
 rom[3917]=32'h7b3322b5;
 rom[3918]=32'h7b412284;
 rom[3919]=32'h7b4f2254;
 rom[3920]=32'h7b5c2223;
 rom[3921]=32'h7b6921f3;
 rom[3922]=32'h7b7721c2;
 rom[3923]=32'h7b842192;
 rom[3924]=32'h7b912161;
 rom[3925]=32'h7b9e2131;
 rom[3926]=32'h7bab2100;
 rom[3927]=32'h7bb820d0;
 rom[3928]=32'h7bc5209f;
 rom[3929]=32'h7bd2206f;
 rom[3930]=32'h7bde203e;
 rom[3931]=32'h7beb200d;
 rom[3932]=32'h7bf81fdd;
 rom[3933]=32'h7c041fac;
 rom[3934]=32'h7c101f7b;
 rom[3935]=32'h7c1d1f4a;
 rom[3936]=32'h7c291f1a;
 rom[3937]=32'h7c351ee9;
 rom[3938]=32'h7c411eb8;
 rom[3939]=32'h7c4d1e87;
 rom[3940]=32'h7c591e57;
 rom[3941]=32'h7c651e26;
 rom[3942]=32'h7c711df5;
 rom[3943]=32'h7c7d1dc4;
 rom[3944]=32'h7c881d93;
 rom[3945]=32'h7c941d62;
 rom[3946]=32'h7c9f1d31;
 rom[3947]=32'h7cab1d00;
 rom[3948]=32'h7cb61ccf;
 rom[3949]=32'h7cc11c9e;
 rom[3950]=32'h7ccd1c6d;
 rom[3951]=32'h7cd81c3c;
 rom[3952]=32'h7ce31c0b;
 rom[3953]=32'h7cee1bda;
 rom[3954]=32'h7cf91ba9;
 rom[3955]=32'h7d041b78;
 rom[3956]=32'h7d0e1b47;
 rom[3957]=32'h7d191b16;
 rom[3958]=32'h7d241ae5;
 rom[3959]=32'h7d2e1ab4;
 rom[3960]=32'h7d391a82;
 rom[3961]=32'h7d431a51;
 rom[3962]=32'h7d4d1a20;
 rom[3963]=32'h7d5719ef;
 rom[3964]=32'h7d6219be;
 rom[3965]=32'h7d6c198c;
 rom[3966]=32'h7d76195b;
 rom[3967]=32'h7d80192a;
 rom[3968]=32'h7d8918f9;
 rom[3969]=32'h7d9318c7;
 rom[3970]=32'h7d9d1896;
 rom[3971]=32'h7da61865;
 rom[3972]=32'h7db01833;
 rom[3973]=32'h7db91802;
 rom[3974]=32'h7dc317d0;
 rom[3975]=32'h7dcc179f;
 rom[3976]=32'h7dd5176e;
 rom[3977]=32'h7ddf173c;
 rom[3978]=32'h7de8170b;
 rom[3979]=32'h7df116d9;
 rom[3980]=32'h7dfa16a8;
 rom[3981]=32'h7e021676;
 rom[3982]=32'h7e0b1645;
 rom[3983]=32'h7e141613;
 rom[3984]=32'h7e1d15e2;
 rom[3985]=32'h7e2515b0;
 rom[3986]=32'h7e2e157f;
 rom[3987]=32'h7e36154d;
 rom[3988]=32'h7e3e151c;
 rom[3989]=32'h7e4714ea;
 rom[3990]=32'h7e4f14b9;
 rom[3991]=32'h7e571487;
 rom[3992]=32'h7e5f1455;
 rom[3993]=32'h7e671424;
 rom[3994]=32'h7e6f13f2;
 rom[3995]=32'h7e7713c0;
 rom[3996]=32'h7e7e138f;
 rom[3997]=32'h7e86135d;
 rom[3998]=32'h7e8d132b;
 rom[3999]=32'h7e9512fa;
 rom[4000]=32'h7e9c12c8;
 rom[4001]=32'h7ea41296;
 rom[4002]=32'h7eab1264;
 rom[4003]=32'h7eb21233;
 rom[4004]=32'h7eb91201;
 rom[4005]=32'h7ec011cf;
 rom[4006]=32'h7ec7119d;
 rom[4007]=32'h7ece116c;
 rom[4008]=32'h7ed5113a;
 rom[4009]=32'h7edc1108;
 rom[4010]=32'h7ee210d6;
 rom[4011]=32'h7ee910a4;
 rom[4012]=32'h7eef1072;
 rom[4013]=32'h7ef61041;
 rom[4014]=32'h7efc100f;
 rom[4015]=32'h7f020fdd;
 rom[4016]=32'h7f090fab;
 rom[4017]=32'h7f0f0f79;
 rom[4018]=32'h7f150f47;
 rom[4019]=32'h7f1b0f15;
 rom[4020]=32'h7f210ee3;
 rom[4021]=32'h7f260eb1;
 rom[4022]=32'h7f2c0e80;
 rom[4023]=32'h7f320e4e;
 rom[4024]=32'h7f370e1c;
 rom[4025]=32'h7f3d0dea;
 rom[4026]=32'h7f420db8;
 rom[4027]=32'h7f480d86;
 rom[4028]=32'h7f4d0d54;
 rom[4029]=32'h7f520d22;
 rom[4030]=32'h7f570cf0;
 rom[4031]=32'h7f5c0cbe;
 rom[4032]=32'h7f610c8c;
 rom[4033]=32'h7f660c5a;
 rom[4034]=32'h7f6b0c28;
 rom[4035]=32'h7f700bf6;
 rom[4036]=32'h7f740bc4;
 rom[4037]=32'h7f790b92;
 rom[4038]=32'h7f7d0b5f;
 rom[4039]=32'h7f820b2d;
 rom[4040]=32'h7f860afb;
 rom[4041]=32'h7f8a0ac9;
 rom[4042]=32'h7f8f0a97;
 rom[4043]=32'h7f930a65;
 rom[4044]=32'h7f970a33;
 rom[4045]=32'h7f9b0a01;
 rom[4046]=32'h7f9f09cf;
 rom[4047]=32'h7fa2099d;
 rom[4048]=32'h7fa6096a;
 rom[4049]=32'h7faa0938;
 rom[4050]=32'h7fad0906;
 rom[4051]=32'h7fb108d4;
 rom[4052]=32'h7fb408a2;
 rom[4053]=32'h7fb80870;
 rom[4054]=32'h7fbb083e;
 rom[4055]=32'h7fbe080b;
 rom[4056]=32'h7fc107d9;
 rom[4057]=32'h7fc407a7;
 rom[4058]=32'h7fc70775;
 rom[4059]=32'h7fca0743;
 rom[4060]=32'h7fcd0711;
 rom[4061]=32'h7fd006de;
 rom[4062]=32'h7fd206ac;
 rom[4063]=32'h7fd5067a;
 rom[4064]=32'h7fd80648;
 rom[4065]=32'h7fda0616;
 rom[4066]=32'h7fdc05e3;
 rom[4067]=32'h7fdf05b1;
 rom[4068]=32'h7fe1057f;
 rom[4069]=32'h7fe3054d;
 rom[4070]=32'h7fe5051b;
 rom[4071]=32'h7fe704e8;
 rom[4072]=32'h7fe904b6;
 rom[4073]=32'h7feb0484;
 rom[4074]=32'h7fec0452;
 rom[4075]=32'h7fee041f;
 rom[4076]=32'h7ff003ed;
 rom[4077]=32'h7ff103bb;
 rom[4078]=32'h7ff30389;
 rom[4079]=32'h7ff40356;
 rom[4080]=32'h7ff50324;
 rom[4081]=32'h7ff602f2;
 rom[4082]=32'h7ff702c0;
 rom[4083]=32'h7ff8028d;
 rom[4084]=32'h7ff9025b;
 rom[4085]=32'h7ffa0229;
 rom[4086]=32'h7ffb01f7;
 rom[4087]=32'h7ffc01c4;
 rom[4088]=32'h7ffd0192;
 rom[4089]=32'h7ffd0160;
 rom[4090]=32'h7ffe012e;
 rom[4091]=32'h7ffe00fb;
 rom[4092]=32'h7ffe00c9;
 rom[4093]=32'h7fff0097;
 rom[4094]=32'h7fff0065;
 rom[4095]=32'h7fff0032;
end
always @(posedge clk) {c,s}<=rom[addr];
endmodule
`default_nettype wire
