kehanzuishuai/fpga/src/display/visual_background.sv

`default_nettype none
// Six registered sampling stages, four parity banks per plane. Each bank has
// one synchronous read port, with no framebuffer and no fourfold ROM copies.
module visual_background(input wire clk,input wire [11:0] x,y,
 output wire [23:0] sharp_rgb,frost_rgb);
 visual_texture_plane #(.SHIFT(3),.BW(121),.BH(68),
  .FILE0("assets/bg_fine_0_packed18.hex"),.FILE1("assets/bg_fine_1_packed18.hex"),
  .FILE2("assets/bg_fine_2_packed18.hex"),.FILE3("assets/bg_fine_3_packed18.hex")) sharp(clk,x,y,sharp_rgb);
 visual_texture_plane #(.SHIFT(6),.BW(16),.BH(9),
  .FILE0("assets/bg_frost_0_packed18.hex"),.FILE1("assets/bg_frost_1_packed18.hex"),
  .FILE2("assets/bg_frost_2_packed18.hex"),.FILE3("assets/bg_frost_3_packed18.hex")) frost(clk,x,y,frost_rgb);
endmodule
/* verilator lint_off DECLFILENAME */
module visual_texture_plane #(parameter SHIFT=3,BW=121,BH=68,
 parameter FILE0="",FILE1="",FILE2="",FILE3="")(
 input wire clk,input wire [11:0] x,y,output reg [23:0] rgb);
 localparam WORDS=BW*BH;
 wire [23:0] q0,q1,q2,q3;reg [1:0] corner;
 localparam WEIGHT_W=2*SHIFT+1,ACC_W=2*SHIFT+9;
 (* syn_srlstyle="registers",syn_preserve=1,syn_keep=1 *) reg [WEIGHT_W-1:0] wa,wb,wc,wd;
 (* syn_srlstyle="registers",syn_preserve=1,syn_keep=1 *) reg [WEIGHT_W-1:0] wa_addr,wb_addr,wc_addr,wd_addr,wa_addr2,wb_addr2,wc_addr2,wd_addr2;
 (* syn_srlstyle="registers",syn_preserve=1,syn_keep=1 *) reg [1:0] corner_addr,corner_addr2;
 wire [11:0] cx=x<1920?x:12'd1919,cy=y<1080?y:12'd1079;
 wire [8:0] gx=9'(cx>>SHIFT);wire [7:0] gy=8'(cy>>SHIFT);
 wire [31:0] address00,address01,address10,address11;
 visual_texture_address #(.BW(BW),.WORDS(WORDS)) addresses(
  clk,gx,gy,address00,address01,address10,address11);
 visual_texture_rom24_packed #(.WORDS(WORDS),.FILE(FILE0),.REGISTER_ADDR(2)) rom0(clk,address00,q0);
 visual_texture_rom24_packed #(.WORDS(WORDS),.FILE(FILE1),.REGISTER_ADDR(2)) rom1(clk,address01,q1);
 visual_texture_rom24_packed #(.WORDS(WORDS),.FILE(FILE2),.REGISTER_ADDR(2)) rom2(clk,address10,q2);
 visual_texture_rom24_packed #(.WORDS(WORDS),.FILE(FILE3),.REGISTER_ADDR(2)) rom3(clk,address11,q3);
 function automatic [23:0] select_q(input [1:0] index,input [23:0] v0,v1,v2,v3);
  begin case(index)0:select_q=v0;1:select_q=v1;2:select_q=v2;default:select_q=v3;endcase end
 endfunction
 // Bank k always feeds the same multiplier; the weight follows the corner
 // (bank k holds bilinear role k^corner). Same four products, same sum, but
 // no texel multiplexer between the ROM outputs and the multipliers.
 function automatic [WEIGHT_W-1:0] select_w(input [1:0] role,input [WEIGHT_W-1:0] w0,w1,w2,w3);
  begin case(role)0:select_w=w0;1:select_w=w1;2:select_w=w2;default:select_w=w3;endcase end
 endfunction
 reg [ACC_W-1:0] pa[0:2],pb[0:2],pc[0:2],pd[0:2];
 reg [23:0] sample_a,sample_b,sample_c,sample_d;
 reg [WEIGHT_W-1:0] weight_a,weight_b,weight_c,weight_d;
 integer channel;
 always @(posedge clk)begin
  corner<={gy[0],gx[0]};
  wa<=WEIGHT_W'((1<<SHIFT)-{1'b0,cx[SHIFT-1:0]})*WEIGHT_W'((1<<SHIFT)-{1'b0,cy[SHIFT-1:0]});
  wb<=WEIGHT_W'(cx[SHIFT-1:0])*WEIGHT_W'((1<<SHIFT)-{1'b0,cy[SHIFT-1:0]});
  wc<=WEIGHT_W'((1<<SHIFT)-{1'b0,cx[SHIFT-1:0]})*WEIGHT_W'(cy[SHIFT-1:0]);
  wd<=WEIGHT_W'(cx[SHIFT-1:0])*WEIGHT_W'(cy[SHIFT-1:0]);
  corner_addr<=corner;wa_addr<=wa;wb_addr<=wb;wc_addr<=wc;wd_addr<=wd;
  corner_addr2<=corner_addr;wa_addr2<=wa_addr;wb_addr2<=wb_addr;wc_addr2<=wc_addr;wd_addr2<=wd_addr;
  sample_a<=q0;sample_b<=q1;sample_c<=q2;sample_d<=q3;
  weight_a<=select_w(corner_addr2,wa_addr2,wb_addr2,wc_addr2,wd_addr2);
  weight_b<=select_w(corner_addr2^2'd1,wa_addr2,wb_addr2,wc_addr2,wd_addr2);
  weight_c<=select_w(corner_addr2^2'd2,wa_addr2,wb_addr2,wc_addr2,wd_addr2);
  weight_d<=select_w(corner_addr2^2'd3,wa_addr2,wb_addr2,wc_addr2,wd_addr2);
  for(channel=0;channel<3;channel=channel+1)begin
   pa[channel]<=ACC_W'(sample_a[channel*8+:8])*weight_a;pb[channel]<=ACC_W'(sample_b[channel*8+:8])*weight_b;
   pc[channel]<=ACC_W'(sample_c[channel*8+:8])*weight_c;pd[channel]<=ACC_W'(sample_d[channel*8+:8])*weight_d;
   rgb[channel*8+:8]<=8'(((pa[channel]+pb[channel])+(pc[channel]+pd[channel])+(1<<(SHIFT*2-1)))>>(SHIFT*2));
  end
 end
endmodule
// Two reads from one native 18-bit ROM reconstruct each exact 24-bit texel.
// No quantization, decompression state, extra sampling delay or image change.
module visual_texture_rom24_packed #(parameter WORDS=1,FILE="",parameter REGISTER_ADDR=0)(
 input wire clk,input wire [31:0] addr,output wire [23:0] rgb);
 localparam AW=$clog2(WORDS)>0?$clog2(WORDS):1;
 localparam PW=(WORDS*24+17)/18+1;
 localparam BLOCKS=(PW+1023)/1024;
 localparam SW=$clog2(BLOCKS)>0?$clog2(BLOCKS):1;
 localparam PLANE=FILE=="assets/bg_fine_0_packed18.hex"?0:FILE=="assets/bg_fine_1_packed18.hex"?1:FILE=="assets/bg_fine_2_packed18.hex"?2:FILE=="assets/bg_fine_3_packed18.hex"?3:FILE=="assets/bg_frost_0_packed18.hex"?4:FILE=="assets/bg_frost_1_packed18.hex"?5:FILE=="assets/bg_frost_2_packed18.hex"?6:FILE=="assets/bg_frost_3_packed18.hex"?7:-1;
 function automatic [18431:0] packed_init(input integer plane,block);
  begin case({8'(plane),8'(block)})
   16'h0000:packed_init=18432'h5d74865c72855b71845b70835b71845b71845b72845b7186587085556d82536c81546a7f526b80536d82546d83526b82526c81536c81536c83536c83546c83536b81546c81556b81546c83566c82566c80556b81576c82586d83586f845a70845a70865a70865c7287587085597288576f85587187566f86556e85556d85a9947cb4997dd1b38defdcbafdeac3fbdfb3f9daacf0cc9ee9c395dfbb94d5b593d1b291d4b795dec3a0f6dfbbfbe2bff8debaf5dbb8f3d8b5f2d7b3f5dab4fbdfb8fadeb6f7dab5eccfade7ccabe0c6a9d5bfa7d0bca6ccb9a5cab7a4cab7a3c8b6a3c8b6a2c8b6a2c6b4a0c3b1a0beaf9fb9ab9db4a89caea59aaca49ba8a19aa4a09aa19d989e9b989c9b989999989495969193949093958d9194898f92868d91848a8f81888f7e878e7a858d78838c76828c75818b717f8b6d7c886c7c896a7a896a7b89687a886578876376856175856074856075855f74865f75865f74855b72835a7083586e81576e81566e81556d80556c80566c80546c7f536a7f50697e50697e4e677c4f687d4e687d4f687e4e677e4d677d4d667b4c657a4b657b4b657c4c657c4b657b4d677d4d677d50677e51697e536a81546b81556c81556b81536a7f52697e52697f53697f52697e50677d50677e50677d50677e4e677e4f687e4f677d4d657d50677ef1dcb8feeccafee8c5fee8c3fee7c1fde9c5fee8c3fde8c4fde6c2fde5c1fce4c0fbe1bef8dfbbf7ddbaf5dbb8f3d8b6f2d7b5f5dab7fce7c0fde7c1fadfb8f3d6b1e8cbabe0c6a9dcc3a7d0bba4cdbaa4cbb9a5c7b6a4c6b4a3c1b2a2beb0a1bbaea0bcae9fbbad9fb6aa9eb4a89daea69caaa29aa59f98a29d979f9b969c99969897959796959394949093958d9194888e91868b90848a907f888e7d878e7c858c78838b76818b737f88707e88707d886c7b876a7a876777856576846476846375846174835f71835d72835c71825b71825a6f80576e80566d80556c7f536b7f516a7e50697d50687c50687c50687c50687c4f687c50687d4e677b4e667b4b657a4963784a63784963794861774862784762784863784761784761784761784660774660774661774660774761774a62784a62794a637a4c647a4d657b50667c4f667b50667c4e657b4e657c4c647b4b62794a6177475f764960774d647c4d657c4c647a496279476077fde6c1fde5c0fce2bffbe1bdfae2bdfae0bcfbe3bffae1bdf9dfbcf7debbf6ddbbf4dab9f3d9b7f3d8b6f6dcb9fbe8c6fef0cdfdebc5fbe2bcefd3b2e3c9acdbc3a8d6bfa6d3bea6d2bca5cebba5cab8a4c6b5a2c2b3a1bfb0a1bcafa1b8ac9fb4a89db2a79cafa69daca39ca9a29ba4a09b9f9a979d9a979897959796949494949091928d8f928a8e91888d91858b9182898e7e868d7a828b77828b76818a747f89707c876d7a866c7a866a79866777856475836172816172825f70805d70805c6f805a6f7f586d7e556b7d556b7e556a7d52697c52697b50687b4e667a4d64794d657a4b64784b64794a63784a63784a62774a62774a63784a6278486277466076455e75455e74455e75445d73435d73445e75445e75425c74425d74435c73425c73425c74425c73435b73425c73435d73455d74465e74465d73475e75486076486077485f764b63794a6179496178486078475f76465e76486078455c74475e75465d74486077496177f9e1befae0bcf9dfbcf9debafadfbbfae2bef9dfbcf6ddb9f5dbb8f4dab7f4dab8f4dab8f8e0bcfeedcafdf1d1feedc9f9deb9eed3b1e6ccaee0c7abddc4aad6c0a8d3bfa7d1bda7cfbca7cbbaa7c7b6a4c3b3a2bfafa0bbaea0b7aba0b2a89dafa59caea49ba7a19ba49f9ba09c999b9a979896959696949494959192948d9093898c90868b8f84898e81888d7d868d79838b77818a747f88727d886e7b886b79866a78856776836474836273826072815d6f7e5c6e7e5a6d7c586a7b576b7c576a7b55697a53687b51677a4e65784d64784d64784c63784a63774a6276476075476075475f74465f74455f73465e74455e73465e74455e73455d73445d73425c73425c72425b71425b71405a713f59703f59703e59703f58703d576e3d566d3f59703f59703f586f3e576e3f597040597040597040586f405970425a71435a70435b71435b71435b71455c73445b73435c73445b73425b73425971425a71435a71445b73445c73445c74f8debbf8debcf8dfbdfae0bdfbe2bef9dfbdf8ddbaf5dbb9f6dbb8f9e3c0fdf1d2fdf0ccfef0ccfdeac7f6dcbaf0d5b4e8ceafe4cbaddfc7acdac5abd8c2abd3bfa9d0bda8cdbba6cab8a5c6b6a5c3b4a3beb0a2bcafa0b7aba0b1a89fada59caba39aa8a09a9f9d999d9a979797969494939292938f91928e90918b8f92868b8f83878c80878c7c848b788189747f87747e88707b866c7a866b788568778466758264738161717f5e6f7d5e6f7e5b6e7d586b7c576a7a55687a5368795267795165774f64764e64774d63764a62764a6176476074476074475f73465e74445e72445d72435c72435c71405a6f415a70415a70415a6f415a70415a70415a703e59703f5a6f3e586e3d576d3c566c3c576e3c576d3c576d3c566c3b556c3a546a3b556c3c556d3c566c3c556b3c556c3c556b3b546a3d556c3d566c3f586e40586f40586e3f587040586e3e566d3e576e40586f4059703f58703e566d3f586f3f576f40586f3f586f405870fadfbdf9e0bdfce2befce3bffde4c0fbe1bff9dfbdfdedcefefae2fef5d6fdf3d4fdedc8f9dcb6f5dab7f0d7b6ebd1b3e3ccaedfc8aedbc6add8c2acd4c1a9d0bea9cdbba8c9b9a7c5b5a4c3b4a2c0b1a2bcb0a2b8ad9fb4aa9faca69da9a29ba59f98a19c969d9a969998969595949090918d8f918c8f91888b8e87898d83898d7e858a7b8289788086727b82707c866f7b856b788368768366748164748061717f6171805f6e7d5b6b7a5a6c7b596a7a5569785366785064754f63764f64754e62734c61744a6072485f73455c71465d72455d71445b70445c70435c71425b6f40596e415a6e3f596e3e586d3d576d3f596d3e576c3e586d3d576d3d586e3c586e3d576c3c566b3b546a3a556939536939546b3c566b38536938536a3651673850663952683b546a39536839536a3b546a3952683a53673b53683c556b3f586d3f576d3e556b3e566b3c536a3b53693d566b3e566c3e566d3d566c3e556c3b54693d556b3c546b3c536a;
   16'h0001:packed_init=18432'heed1aef0d5b1dbbfa1ceb398c6ae97b8a796b8a695c9b19acbb299b9a592b0a091ab9d90a69a90a69e9798938f928f8e8f8f90898b8e898c8f888c91868c91868d948b8f94a19e9da6a29fa2a0a098999a8e8d8e82888f7b858f7c86917c88947a879478869374828f75818d7981896675836474846072816375885e71835c70825a6e81576c7e576d80586d81596e825b71855c718661778b64788c6074885e7286607488667a8f61768a62768a6e7e8e6676865f7081586b7c5c6f806074876171805163734e657a4a62793e53673f556b3f566c3e54693d52663f53663e526540566b435a6e445a6e4960764c6379495f7257697a5e656b52616c5d6160595c5d5c5e605b5f6162696e5c60635b5f60666e7563696d64686b696e72636566696a696f6e6d7a7773887f75a89682cab093baa48eab9a8a9b908490898088848084827e85848187868487837f8d867f9e9184dfc1a1dabd9ed8bc9fd3b699d1b497e9d4b2fde9c3fde8c0fee6bdfde3bcfbe1bafbe0bbe3c8a7f0d6b3efd3aed3b89db2a191ae9d8ea3968b9f948b9b938d948f8c8d8d8e8a8c8f86898e84888e85898f868c90a09c98bbaea1cdb9a7c2b3a4bdb1a5bbafa5bdb2a7beb2a8aca39c7d858f73808d73818f72818e7181908e969c85919b808d998c959d8b8d916676856174855f72835b6e80607488596d7f586c7e586c81556a7e576d83576d80596f83596f835f758962788c5d70826072835e7185596d81596d805c718561768a616e7b5a6976526575526679596e825a6e81546575455a6d3f536643596e3d506243586b465c70465c71465d71455b6e43586b4f687f4c63785667777d848b586c81556e855c5e5d5a5c5d60646664696e6365666162616a6d70686a6a72777b747576716e6a79726a857b70958675ae987fd0b597bfa891b09e8ba697879f94888c83798d88818d8984938f899991889f9489ac9b89eedebcf5ddb6f1d9b5e3c8a6d2b79adec5a6fbe3bcfbe1bbf8e0bbf5dab4f2d7b2f1d4aff0d3aff5d7b2f7d9b3f4d5b1efd2b0eccfafe9cfb1e2c9acc9b19a9e948b98928c8d8c8d86898c83878c81878e84898dc8b5a3c6b5a4c1b2a4bcaea1b4a9a0b0a89fada79faea8a2b2aba3b2aaa4b0aaa4aba8a59d9fa1a0a1a193979ba5a4a2a4a3a0a2a3a29ea0a2999ea2979da2949ba286919a9099a09aa1a6929ba37584915e7081607385556b7f546a7d5d73867c8c9a99a3ab99a3ab96a1aa9ca5ad9fa8b0a0a2a47a838c6c7785717b88596f845c72895d768c687a8b606f7c5466764d6276556b80586c805a6b7a4c5c6b4c5d6d4a59684456654b5e7052677b5e6f7f697581646e785a6d8052697e4e647a51677c53667a5c5e5d616565676b6d6868666a69676e6e6e7574747877747e756c85796c988a7cb39d84d5ba97d7bb9bc8ae94b8a28cab9a89a09283988c7f93897f948b81998f84a6988cb8a591dfccaefaeac8feecc7feeac3fce4bdf4d9b5eed3b0f0d5b3f0d5b4edd1b0f5dcb8fbe4bffde6c0fadfb9f5dab5f3d7b3eccfade8cdacead1b0e6ccade3c9ace0c7abdec7acdac4abd7c2aba2999191919092909080868dafa69ebbaea2b7aba0b5aba0b2aaa1afa8a1aea8a1afa8a1aea8a0aaa6a09f9f9f9b9e9f9a9d9f9b9fa1989da1969c9f94999d8e959c88929a88929a89939c86929c89939d8c969f9099a189959e85939c82919c8594a08796a28695a27b8c9b7d8f9e7d909f7c8f9f798c9c798b9b748797718697748798798c9d7e91a27f90a07084975f74875b738875899d7f92a48496a78899a98b99a5858c93747a806a747e868687918d8ab6a692c2af95ac9f918785848183866b75805a6b7d495f7450667b586d835d72876b82976665626a6a67716f6d74716e7875727e7a7681786f8c7f719b8671cfb38de7caa2d6b899ccaf92bfa58db09c89a190809b8c7d96897c998d81a09488ab9a8addcaaefdf3d3fef2d1fff2d0fef0d0feeecbfeecc8fdecc7feedc9feecc9fdebc7fce6c0f9e0bbf3d7b3efd2aeeacfade8ccace5caabe5caacdbc1a5d9c0a5d6bfa6d6bfa6d3bea7cebaa6cab8a6c7b7a5c3b3a4beb1a3b9aea1b7ada2b2aaa2afa79faca59da8a39ca5a19da29f9b9e9c999c9c9a9a9b9b98999a95999b949a9c93999c91989c90969a8e969b8c969c8d969d8c959c8a959b8c949b8b949b89939b85909a818e987c8a967989967687957183926e81906c80906b7e8f677d8f657b8e657a8d647b8d667b8e647b8e647b8e637a8d62798c63798e667d90647c90637b90637a9062798f5f778c60778c61788d62788d657b906c81936e82946c7f916b7e90687d90697d90697e92667d91687e926c82977186997b8b98919aa29da4ac9ca3ad8a97a57d90a4746f677c766f817b748c857d8d8074938372a38d75d3b58de6c69ed7b794d3b596c7aa8dc1a993af9b89a2907d9d8b7aa19387a59689b9a591efdcbdfce6c2fbe1bdf9dfbbf6ddbaf3dab7f1d8b6f1d7b4f3d8b6f3d8b6eed3b3eaceafe6cbade4caace3c8aae0c6a8e0c6a7e0c6a8dcc3a7d9c0a6d3bda5cfbaa4c9b6a2c6b5a2c6b4a2c3b3a2beafa1b8aca0b5aa9eb1a89fada69daaa59ca8a39da5a19ca19e9a9e9d999c9c999999989597979195978e93968c9195888f93868e94838d94828c94818c937e8a937e8a937f8b95808c95808c957f8c957f8c967e8c967b8a957988947485927083916c80906e81916c80906d80906a7e8f687c8e677b8c63788b5e75895c74885c73885b74885b7387586f84577085587186586f85576f85597187597187577086587187577086566f85576e855a71875b71855b70855b71855e73875e748962778c64798e657b90647a8f667b90687d906a7e936a7f94677d925f768d61798f637a908b7f728f8375a19284a7927cae9578dcbd91eac89ee0bc93d5b490d0b190c4a788bca38cb19a83af9983ac9781af9c89d1ba9cf9e1bffce4c1f9dfbcf7ddbaf3d9b6f3d8b5f5dab6f6d9b5f5d8b3eed3b0e6ccaedfc7abddc4aad8c1a8d7c0a8d5c0a7d5bea6d5bfa6d4bea5d2baa4cdb8a1c8b5a1c4b3a1bfb0a0bbad9fb7ac9fb4a99db1a79daea59caaa39ca5a19ba29e999e9c989c9b989999989495959394949293958f93958b9194868e92848d93828a917f89907c879079868f77858f75838e74828e72818e70808d6f7f8d6d7d8a6f808d6e808e6d808d6f818f6c7e8d6a7d8c6379895f75875e7385;
   16'h0002:packed_init=18432'h42566845596b475c6e4f6476526779b9a7929e92808d8577837e737e7b7274736d6c6e6a686c6d60656860686d585f63575f63545d6355606855626b56636e566470525f69515f6954626d54626c56646f57646f5a66725a6773616e7a63707b66738067717c68737d6d77807a7f86868b8e8c8d8f918f8d9a9590a0978fab9e93a79c92ab9f93b1a296aa9d92ac9d91d0b79fe2c4a3e8cdafe2c8ace7cbade0c7ade8ccafddc2a6ceb8a2b8a899b8a898d6bea6bcab9aada095a59b93b3a598afa296a29991c8b29fc3b09daea1969c958faa9f96a69e97b2a69d9e9b9983898e868c92808a92828c96848e997c88947583917483927282927484937888977c899889868655667757687952657650647550637554697d52677a52626e4455614458684c62724658633f505c4e5c66374e5f344b5e33495c33495b33495b2d41512e425331485a3044562e435332455632475934495c3248593147582f44552f4353314555324657334758364a5a364b5b394d5e40556844586a978e7f8a84787d7a7075746d71726e686a686166675d6366585e62575f63545e65545d64535d6554616c54616d505b65515d6751606c525f6a525e67535f695865705b666f5e6973606b76646f7a636e78656f78727b847c81848788898b89869c948da0978ea1968caf9f91a6988b9c91889089839a9087a09489cfbaa2e5cdb3e0cab1dac4adcfbba8cbb8a6c4b2a2c7b7a6cbbaaac2b09eac9f91bda997a4998f958f898c8a87878787808184838485898888908e8d7e81848d8b8a98938f777d827a80847d838777808791929582899178838e6b7a886777876777866978886c7c8c6a7b8b6d7d8d6f7f907886957b89977f8c9b8b8d905565754e62734d61724b60724b5e704b60734c61744b6072475c6e4960724e637652687c566a7d54657241525e374a5a354a5a394f5f3d5161374a58364a59384d5f374d5e384d5f364a5c364b5d3045562e43532f44542e41523145572e40502c40502f435330445430445432475830455784807679766f72726c6d6e6b64676663686a5b6064565d61576066555d61535c6357646f55606b525f69505b64505c6554616b546069545f68555f6757626b5b646c616b74646f78646d756870776c727787888894918e93908b938f8a958e8783807e7b7b7a83807d7c7b7a807e7c918981d5bea3d6bea5d8c0a7cfb9a4ceb9a4bfb0a1b1a499a89f97a59c95a59d96a39c96a8a29daba49daba39cb8aca1b1a499a79a8c8b8782828282818285787c80757a7f70777e6d767e70777e727a80767c8168747d66737f66737e64717d61707f5e6f7f5d6f7f596c7d5a6e7f596d7f596e805b6f826074875f718462758760738565788a66788b6b7e9167747f5366774d60724b5e70495d6f465a6c465c6e465b6e44596d465c704b61754b61754b61764d6579496074475d72486076485f744a627850677d596c7d54636e59646c415463374c5d364c5f364c602f43543145552d41512f415134495b2f42512e41512c3f4e2a3e4e2a405174756e6e6f6a696a686568696166685e6467565c60586066586167525b5f525d65525c65535f69505b63535f68515d66555e6757626a575f655b63685f676e646d76686d726e727676787b8f8a858785828081807b7d80797c7f707477717579797c807e7f7f86817eb0a08ed6bda3d2baa1c8b19ccbb59fc3b09dbdab9ab1a396a89c91a79d94a29991a098929f99949e9994a79e97b4a79bbeae9fc5b3a3c4b3a2baac9fb1a69cb1a2948382827a7d7f757a7f70777f6a737c65717b67737e64727d616f7b5d6d7a5c6c7a5a6b7a57697a566979556979566a7b55697b556b7e556a7d566b7d576b7d596d805b6f8264768765778967798b6b7d8f7082937686977283946473825968775565744a5d6f455a6d44596b44596c465c70425769455b6f40566942596e445b7041576b42586c42586d43596f485e734e667c4f677e50667a4d5f6e415462485b6a3c505f314454324657314555354a5c3348592b3d4c2d3f4e293a49283a496d6f6d6669686063646065675f65695b6165596167545a5f535a5f525a6057626c535c64515a61505a615560685660695962695d636862686d676c706a6d706e71737e7c7b8c857f8f8a858c8985828181797b7d71757872767a73777a7d7f8285817db2a18dcfb69ecab29bc3ad97beaa97b8a696b9a796c8b19dbba998bdac9bb7a596ada094aba095b6a99cc0afa1c8b4a0cdb7a2cfb8a2c3b19fb2a599aaa098aaa29ba29d989d9a97989796989898a39b93868685747a8168737c66727b69727c626e785e6c785a6a78586a7953657554687953667853687955697a576c7d5a6e7f6879896f7f906d7e8f6a7b8c6a7b8c6a7b8c6d80926f81937386976f8092687a8c6a7d8f6d80936c7e92697b8d6374825d6c7a5063754a5f7243586944596d44596d415669405567475f74465e7342586d40576b465f75455c71465d72455c714960754a607550677c576d83627a8f6d7d8852626c4958623f515f3244553144552e4050293b496b6e6d6166675d61635b61635a60645c656b59606753585c57606559626a565e66565e6658626b555c615b62695c6366666b706d71756c6d6d7a7a7a8980779f91819a90878f8a8486837f80807f797b7c76797d787b7e777a7c7d7c7b8f877fdec2a5dcc1a5dac0a5d4ba9fc7b19abda894c8af97c2ac97bfaa96bfab98bdab9bbaaa9bb8a899beac9cc8b29dcab39ccab39dbeab9ab2a496aba096a29a939d989499989698979791919292939692959892969993989c8f92959090919292928a8e918a8d8f87898c7e818466737e5a6a79586a795d6d7c697785717e8c74818e6b7a8a6a7b8b6375856476876273855f718361748760748860748763768965788c6b7f9266798c61758966798d6a7e926a7e926e81957586976d7d8d7a8692828c9677838f6d7d8b5b6e7f4e63774d6378475e73445b703c52653e54683d5367435a70455d7441566a485f75496075465c6f465b6e4e657a51677b55687a656b6c3949563447573649596063635d62635b5f615c6063595e615d646b575b5f5b62686069715b61665f65685f666c5d63675d6264676a6d6d6e7072716f807973998b7db59f89a99a8a9d9387908a8284817d8181807b7c7c7b7d7f7e80847e7d7b847f7ab6a491dcc0a3dfc2a4e0c4a6dfc3a5dbbea1e6caa8;
   16'h0003:packed_init=18432'h6c74796970736b717352606b4c5d6b495c6b485c6b475b6a4458684459694054654054653e54663b51613d54643c53663b5365395061384e5f394e5f3a4f603d54663a50613d54664158693f5667485f734960724d63764f6679546c7e586e825c71845b72865f768b63798e485c5e5b73816177824c616a4a5851303f412233391a28301e2d381a29331d2e3876736c80796f8a7f71a69178bba082c2a482d2b28ad7b48be2bd90f1d1a1f3dab0d8bb98bea88caf9e8aa39787968e838c8881908c858987828383817d7f7f7b7d7f7c7f817d80827b7e817a7e8270767b6f767a666f766c767e636e765f6c75606d78616e79606e7a5c6a765968745766725969765a6a766272805a6a765a69765d6d7b4f5e6b54657251626f50616f4f5f6d51616f5163715464725a6b795d6f7d5f717e5f717f5e6f7c60717f6777846b798674828d878f96969b9e959a9c979b9e989b9e9ea0a2a1a2a39c9fa1a1a2a2ada9a5b4aea8afaba7afada9aca69e80817e5f6970697073686d6e56626b485b694155643f53633e53633c50603c505f394e5f394e5f394f5f384e5f385062374e60364c5c364b5b354b5b364d5e354b5b384e5e3a51613c53663e556742586941586b445b6d4d63774e63764f6579536a7e576e825b72855f768b5d7387637a916b8298687f9155666540514e354747202f3420303b253841887f729c8b76c9ab88debc92d8b68ce4bf90e7c393f3d4a5e0c29ac7ad8db3a0879f9381928a7d878279807d777b7c7a77797a7075766b70746a717570777d6a737a656e76656e75687278616b745e69715f6a7459666f55626d505f6a505e6a4f5f6a4f5e6b51616d50606d4e5d6a53626f5867745767745564705a69765f6f7e5664705a6a775968755f6e7a616f7a56636d616f7c64738063707c6773806c79836b778267737d67747f717d878f9498aaa8a5b2aca7afaaa5ada9a5a6a4a09d9e9e969a9c95989b91959a93979b909599878e94848e95868f9688919a8d969e89939c89929b7c8181636c705460694b5b67495a664154633c505f3a4d5d3a4e5e384e5f364b5c354b5c35495a354b5c385062354b5c354b5d354b5c31475734495a34495b374d5d384c5c3950623b52633a51633e5466435b6d445a6d465c6e495f724f6679536a7e5970845a71845c738860778c667c916a8093495c5e5167784053592d404323333bae997fcdae87d8b68ccdae89f6daacecd0a5d1b590baa489ab9a849c907e91887b8581787b7a75767774727576697073656d7160696e5f686f5e68705b656c5b656e58636b59656f55616a54606a55626c52606a505e6a4c5b674a59644c5b684958654c5c6951606f536371556471566572576672596874596671606c75646e766c747a74787a687178616c76626e7864707b69757e6d778086898b928f8c999592959595a19e9ca2a19fa8a4a0b4aba3c3b5a9c6b7aac2b6a9beb3a8bdb4acbcb3acb3ada7a3a1a09597998f9396878e94808a9276828c6d7b876c7a886c7b896c7c8b6f7f8d7484937685937c899572797d73716a5f65684455623c505e384d5c364b5b354b5b344a5b334959304454354c5e354b5c354d603146572f4454304555314756314657334757354a5b344b5c395063394f61374d5d3b51623e5265405667455a6d495f724e647753697c586f8359708460768a63798e55666a4c5e655e7586495f6b3f5150e2bf90ebcc9ff9e4bee8cba4ceb594b6a186a89881998d7b8f86798681777a78727374716b7070656c6e626a6e5e676e5c666d5b666f5c687258646d56626b55616a5360694f5b644f5b654f5c674b59644d5b664b59644958634958654c5c694b5a684e5d6a505f6b52606c55636e606c766c7780848e978c949c858e968189918990968e92957f838585888b888a8c9d9996b6a99ec7b5a4c0b0a2bcaea2bcafa4bcaea2b9ada2bfb0a2c2b2a3bdafa2b7aca0b2a8a0aba49db1a8a1afa8a2aea9a4aca8a4a8a6a4a6a4a5a2a2a38b90947d878f79838d76818b6f7d896c7b88687887647686657585657787677a8a697b8c6b7c8e6f7b845d6567545d5e45545e3a4c5932465533485932465731455534495b34495b33485a33485a3046573045562e435331475731465630465630465732485a304656334959364c5e3a5061374c5d3e5366435a6d475d704c61754a61734f667952687c5b718560768a60758b657b9055696e5d717dfef1d7f1d7b2d2ba9bb6a38aa59680988d7b8981738481777c7b7570716d6a6e6d656b6d60686c5c656a59636a58636b58646e54606955626c55626d58677456657254616c56646f54626d4e5a644b59634c5a654c5a664d5b694d5c694f5e6a515f6a54606c5965706d7780838b93858d948189917f868e7c848b80868d8c8f939596989393959190919a9692b0a498bbaa9bb3a69aafa499b2a69ab9ab9ebcac9ed4bda7ddc4aae0c5abdbc2a9cfbaa5c3b2a2c1b1a2c2b2a2c0b2a5c1b2a6c0b1a5b7ada5b5aca4b3aca6b4aca6afaaa6aaa7a5a3a3a4a0a2a49fa0a3909397707e8a6a79886474846877866172815e71816073845f72836074856c757b41505b525b6042505a354858314453314556364c5f364b5d3046563044542f44542d42522e44552d42522e425230485b2f445531455630455530445533495a334758384d5f394f613e546740586c40586b3e5365405668465a6d485c6e4d637553687b596e825e738763788eddc4a4c4b095a39580998c7b8e8678847f747d7a737475716b6f6f666b6c61686b5e66695b6469576167556169536069515f6956667157667354626e54626d53616d5867755765725765725c6b785a69775c6a775b6873515c665765706774806f7b867a838c898e92898d9183888c7e83868083878385898e8e8f96959294928e94928f9b958fb4a495beab98b3a494ac9f93ac9f94b8a696d9c0a7f0d4b4f1d5b5ebceb0d7bca3d3bba3cdb8a2ccb7a3e4c9aedcc2a9d9c0a8cdb7a5c6b3a3d0bba9d0bcaabaada3b8ada4aaa39f9f9e9d9f9e9ea6a3a2969a9e9399a08a939d88939d848f9b7784916777866675836c76805c6e7f5b6e7e586c7d566a7c586c7e5d6c77515c623e4e593346553145543347573347582f44543146572d43532e4455344a5d32485b3145572e435432485a2f43532f44563145582f4355344a5e34495a344a5c374d60374d60354a5b364c5d374d5e394f613e5365;
   16'h0004:packed_init=18432'hbfa58bcbac8da79583a29284a79687b5a393aea196aea69da29f9b99999996979991959990969a91979b90979c8e959c858e957b879076838e71808c6b7b896878866073825a6d7c5468775367775267775267774e63724f64744f657551687951697a52697b556c7d556c7d586e7f5b6f80687c8d6f8394778a9b788b9b798b9b7a8c9c7c8e9e7d8f9d7d8e9d7c8d9c7a8b9a7d8d9c7b8c9b7d8d9b828f9c808e9c818f9b86939e8f99a38e9aa38b98a38696a38292a08292a18394a28597a58192a15869744759664a5e6d3e52604156663d51614155644256643548562f404d2c3e4a3549552e404a2f414d30424d354954364952384c59596e806074873f51572b3b442738421e2c35c4a98ba5937f867d7273716b696b6a62656763686a63696c61666961676a60676a61676b5f666a60686d5a626858606757616956606959646e5a646e59646e5d6870616970696e7276767685807ca39383c6ac90c4a88cc9ae92cfb192d3b491e6c69fedcca6dfc4a8c8b4a0baab9caca39b9f9c989c9a999b9b9a989a9b9296998d93988a9199838c94828c96858f9887919a87919b86919c828e997584906b7b886577855f7180586a7954687754677655697954697a5167785066775168794f6576526778566c7d6478896d8191738797778a9a788a9a788a99788a99788b9b7b8c9b7a8b997e8e9c82929e8594a18594a082929f8a96a28a96a18b969f8c969e89939c86919c7e8d997787957788977588977284947284946c7f8f6d8191738798778b9d657988596c7b495d6b3f5362384c5c3043523c51623346543448563c516128394524343e3549542f424e25343f26374234465231444f435a67586e7f596d7c32434624343a978876827b7176726c6c6d6a666868646868666a6b65696a686b6d696c6d686a6c6b6d6e676a6c65696b63696d60666b5f666b60666b61676b686d716d7173787877878380968c83978d828d857e837f7a87817ba99683af9a84d5ba9dd2b99ecbb49ebbaa9ab8a899b4a79aa59f98a49e99a19d9a9998989194978f9397878f967c86907b868f7b879173808b71808c71808e70808e72818f7584927686947687957789987285956c80906d81926f83956a7e8d677988596e7d546a7a576c7c607686687d8d6c80906c80906a7e8d667b8b657989677a89677b8b6a7d8d70808f7383907887947a88937d89947584927282907988967686947786936e7e8c73828e6d7d8b738491758693677a8a667a8a697c8d677a8b667a8b677c8d64798a657a8b657b8d697f916c8294667b8d6c8194415461435462384b5a2f4250374a5a3244523a4d5c2b3c4825343f2b3d442838402c3d47293a45293a452f434c364a584a5f725e72855f6c6481796e74726d696a69666868676a6b6e6f6e70706d72716d79757174726d7c79727c797277746f7674706f6f6d6f70707273737a777386817a8d857c978b809c8f818a847e7b7a777c7b7a817c76ac9a88dac0a2cfb69dc6b19bbfac99b6a697b3a597aea399a89f96a49d96a09b979795949394948e929582898e7e878f737e8873808b6b798668778565748263727f6374826172815f707f6073826274836376875e72825e72825d73835f768762778864788a6a7d906b80927487987587967587957385946f81906d8090677a896376856173826072816375846a7a866f7d8875818b717e876a79856979866576846374826072805f7180617483607383586b7b576b7a566b7c516676556a7b53687954697a52677953687a52687a576e7f596e81566c7e5c718460758863798d657b8f667d916880944e637233465335495631435035485131424f25343e27364123323926363e26353e2837412d3e4c22323d344857405561596e8273716a6a6a67686968676968696b696d6d6876746e847e749387799e8c799588789c8d7b9789798b81759086789b8e7faa9885b29d87a09080958a7f837e787876727c78719e9081d5bb9ecfb69dc8b29dbfad9ab7a696bcab99bdac9bb9a999b4a79baba198ada2999e999494949490919382878c798189747f876f7a846d7a8662717e5e6d7b5f6f7e5a6a795a6b78586978586978546674556878546777546878526776536878586c7c596c7d5e72836478896e829472869673879772869674869573869572839173828e717f8a6f7d89687783707e88707b847e858a717b82707a816c788263727e596b7a586b79586b7a566a7a5468785266775165754e64744b61724b6173475c6d455b6e445a6a455b6d465c6e485e70465d6e485e724b63764e657851687b556c7f586e815971845c748761778b596f80576d7d586f803e525d36474f3e505533454b2b3c473143452e3f4327373d2a3b4123333b22333d2639452739463448586868646869666b6b686e6d6873706a837d72887e729c8d7c9c8d7aae9981bfa689cbaf90d1b391e0bf95e8caa0eacba3d7b996c5ab8dd1b694cbb396d8bd9edac0a3ceb69ebcaa97a89c9099928a968f88a3998fa29990ada196a0989095908c96928e89898a909090898c8d898d9081888e7781896d78816b778164717c616f7d5d6d7c576776546574586a7b5162705264724e606f4e606f4c5f6f4e62724f62715265745568785a6e7e627687667b8b657a8a667b8b697c8d687a8a6a7c8c6e808e798895808e99838f9a88939b8b8f929191909b958e8d8c897a818480817e626d755765705767735365745164734f63724d61724b5f6f495f70475c6d465b6d44596a4257694157683e55663f56683f54673e55663e53643f576a41586b41596b455c6f475e704b62754d647651697c566d815870845c748760768962798f667c9162798d5a707f3e515436494d2c3d443849493444462e41441f2e381a273020333c1e2e382535416969646d6c6777736c7e776c8c7f719a8977ae977db29a7fc9ac8acbad8ae1c198e5c399f2d6abf2d4a9e1c5a1ceb69bc0ad97b2a393b1a292ab9d909f968c9d948a9f978e9c958d94908a8383827b7d7f7b7e7e85858370757974797e777d817a8085777f8568727a69747d6e78826f7a846d798565727d62707c61707d55647051606d5a6c7b51617050616f5567764d5e6d4e606f4f62724c5e6e4f606f5162715667765d6f7f5f72815f72815f71816274836477866779886a7b88768591828d96858f9793999ea0a1a3a8a7a5aeaba6b6aea9b6aea598938b6e7578;
   16'h0005:packed_init=18432'h3a48533b4a543e4c57414f5a49555f5b6b744d5a624e5c6553616b57646e3c4144424749464c4f4d5051575957616159746b5ea08b6cb79a71c7aa89a08e78a8947ba29585958c838f898388847f7f7e7e7a7b7d7377796d72776a7278676f7765707966717a65707a63707a64717b65717b65717d67737e6874806a76826f7a85707c8676808977808a757f8877808a7b838c82899082888e858a8f858a8f8a8e92939293a19b979294968c9095899098818c967a87937b889578879472818f74839076838d78838c878d929a9b9c94999d90989d8b949c87929b87939d86939d83919e82919e8493a081919f7b8c9c788a986d7f8e6a7c8d65798a657a8b6075865b7081596f81576c7e5166784d6375495e70475c6e465c6e475b6d4960724b60744b63764e63764c63764d61734f6577536c7f556d81536877556c7b4256603e515c3b4d5b3c505d3446513c4f5d364754394b583b4d5934465333445131414b3445502d3b453545513e505f2d3a4531404b3b4b583b49533c4b553e4d583e4b5543505a43515c3c434642494b494c4e55585562625a7c7366938067b39872bfa37ea68e6a958a7e87827d83817d7e7d7b797a797275776c7176686f75636b73606a725f69735e68725d69735e69745d6a765e6b795f6c795e6c785d6a765e6b785f6c79636f7d64717e6874806b77816c78836d7780717a82737a837880868085898a8b8d938f8e96928f898b8d7e858c78838b727e88727f8c72818f6f7d8a72808d778490808b948f959b979a9c9b9d9f979b9f94999e91989e8b949c86929b86919b7e8d987687957385937183936f82916e8292718596708495748899728698718597667b8c63788a627688627688586d7f566c7d53697d4b61734b60724a5e70495e714e63774f65785066784f66794f65784d63754e647651667952697c536b7e556e825870845971835066724256643c4f5b4559623a4e5d30424f35475535475430414a2e3e473545492f3f4b2e3e4a304250374b592f3e4a2c3b462b384237495332404a31414b31414a2d3b44414649494e4e62645d64625c7d7265ccad83c9ab86bca3839a8d80817c777a79777778787375777073766a6f73656c72636b725f68705d68715b66705a67715965705965705b68755866735968755a67755b68765a68755c69755e6a77606d7964717b69737d68727c6d757d70777e73787e797d808e8a88a59a90a299929291907f8389767e866e79836d79856c7a876e7d8974828e7a8691868e958f94998d939991969b90979b8890977b879275838e73838f71828f71818e6f808f7284926e8090697c8c667a8b64798a63788a62788962788a687d8f6d82946d83966e849772889b74899c73889b697e915e73855b7082566b7d5165775065775367795266795367795a70825a7082586e7f576d8054697c536a7c556d81546b80536d82566f835b73865e768961788b5a72854f647342546330414d2b3a463b4e59374b552f40462d3d44384a4a28363f2836403144522d3e4b26343d2a39432c3b462c3a433142492d3b452f3e48474c4c6161577570678a7c66c8aa7fc3aa8da6958291877b7a78737474736f71746d70736a6f72656b716269715f68705d67705a656f5a66705865705764705865725866735663715664725563725865725a67735d69755f6b76626d776770796c737b71767b75787c7e7d7e908881ac9b89b5a29298908a8586887a8086737a83707b84707b846a747d6e7a837b858d848a908b9197889097858e95808a937d88927985907684916e7f8c6a7c8a65778662758462758462758561768662788863798863788a6177885f768860768860768863788b657b8f687e916980926a7f926c81936c82956b81966e849770879b70869a6c82936d8191687c8c687a8b6378885e71825d70806175866377896175866175885f7589596f825b7386536a7d53697c576e81566e81586f825b71844f626d4f63703a4d55566c8240515b3c4e58475553303f423647472e3d4128373d26343c29394332434e2e3e4a2735402939452d3e4a2a394527353f716b5a766f62a99370d5b691c6ab8e9b8e7d857e747372706d6f6f6a6e71676c70656b70636a7060676f5e676f5a656d59656e57636e5865715663705664705864705664705765725765725864705a67735f6973646d76676e7570727678797b7e7b798b827bab9683c5ab91b09d8b9b90868985837e7f80747a8070777e6f777d6e767c7b7f84878a8c8d9194888e93808a917b858e77838d74818c6e7b876a79866777866475836073825d71805a6e7e586c7b566b7b556b7c576d7e586d7e586f805a70825d74865f75885f758861788b647b8e62798b62788b61778a657a8c677d906a80946e8396708598758a9b7c8fa08092a38697a8889aa98a9ba98292a08191a0637483697b8b687a8a5b6e7d5c70806276875e7283596e7e5569794c6170495e6e4c62744f64765065774f64775167784c6070435768384a523d4f5c4558624a5d664252543241453c4a4a4958563847452d3d412735413345521f2d372738431f2e39273a48796f5cbaa17bd7b792c8ad8f9789797e7a726d6d6b6a6c6e62666964696d62696f61686e5f686f5c666d5a656d57646e57636d57636f56626f53606c54606b55626e5764705a67725a66705c67715f6872676d73727375807a768e8177a18f7fb19b86b09b86ae9a85a091848d857e81807e7e7e7f7a7c7f75797d878687a8a19baaa5a098999c909497868d93808a917c868f77838d73808b707f8b6a78866677866071805d707f5b6e7d576a7a566b7a536877516776506676526878516778526878556c7e556b7b566d7f586f815b71835e748762798b657b8c6a809273889874899a75899b778a9c788b9c7b8e9e7b8d9e798d9d7b8e9e8091a08191a17f909e8292a08695a28b99a68998a47786928794a07888956e808e7283926175845a6e7f4c6171485c6c4a6070495e6e465b6a4a60703e5261394d5c3a4e5d37495530424e30434f384a5541545c495d6b425356586b7863767e44545329383e2f3f432638442535421b2932c4a98ad0b38fb69f868a817475726c6d6f6f62666761676a62676a60686d5e646a5f666c5e676e5b636a5a656d5b656d57626b545f6855616a55616b57646f55626c56626c5a636c5f676e656b72717275847c77a08d7cc1a689c6a98bbca289;
   16'h0006:packed_init=18432'h8192a28294a48496a58999a88f9eac93a2af93a1af94a2af8f9ca88c98a48b98a28996a18895a083919c77858f72808a6e7b8676828c808a938d979f7d8993788590808c97808a94828d977f8992808a92858e96838c93848e96869098878d939497989c9b9c939699848d957a869176838f707d896a7884606d785e6a765e6b78606e7b626f7c606e7a61707e62717f64728063728063717f657583a48a70b69778bf9d7cc7a37fcfaa84dcb58af0cd9cf5d6aaf9e4bffce8c2fae4bef8dfb8f5d8aff8d9affadbaefce2b4fde4b6fde5b8fde4b9fce2b7fde8c2fdebc6fae4bcf4d9b2e8c9a4e1c19ddabd9ec9b097bca895afa094a499909b948e97918c92908d8d8d8d898b8d84888d82888e7f868e7a828b747e88737e886c788469778466758361707f6272806273826072815f71816173836577886073846174855e71816274855a6e7f5a6f805d73855d73835b7081596f815a6f825b72845c73855d738663788b637889687c8e6a7e916b7f91708395728698768a9c778b9c8193a38496a58294a48597a6899aa882919d7182906c7d896c7d8a6978846c7b87737d83737e85707c8675808a6e7b8566758062707a65737b647077646f756a777d6c797d6b767c69737a6c767e6d777f6e777e707a80717a817a81868183848a88858081827c818583888e91959b8a919985929e808f9d7886946e7b876c79856b78856e7d8b707f8d7e70638d7b6a95806c9e876fad9277bc9d7ebb9c7db89a7ac2a07fc9a683ceac87dab68ee9c498f3cfa0fbdbacfee7bafee7bbfddfb1f5d1a3f0cda1eac69cddbc97d2b391c9ad92c7ae96bfa995b7a493ac9e92a399909e979098949092918e8d8d8f8386897c8287798188757e8675808977828b717d876f7c8769778362717f62717f5f707f5d6e7d5a6b7a586b7b586a7a576a7a5a6c7d5c6e7f5c6f805e72835a70815a6f7f576c7d566a7c546a7b556a7b566b7c566c7d586f815a6f81586e81596f815f748663798b667c8e6a7f916a7f926a80936e8294708496738799738899748899778a9b788b9b798c9d778a9c74899b6a7c8a61738060727f5f707c61707b64727c67757d616e775a687156667057677154646f55666f53646f52616a55636c59666e59666c58666d58656d5b676f5f6c7565707967737b717b8370797f757c82797d7f8d8a84b4a595cdb9a4dcc6b1cfc1b3b3afaca3a6a9949da58d97a188929c79879467625c6c655c8173668d7e6f8f7f6f8c7b6b8f7d6c988370978370a08973a88f76b99b7ccfab84e5c195e8c396ebc697e7c193dfba90d5b38dc5a78ac4a88cc5aa90c1a993b4a291a99b8ea1968d9b948d98938f97949094929089898c8285877e83887f858b7d848b737c856a747e69758069758068768162707c5f6e7c61718060707f5769775a6b7a5768785568785668785769795869795a6c7d5a6d7e5a6d7e586d7e5d71835e72835c70805b70815b70815c71825f74856074845f7485637788697d8e6a7d8f6c7f906b7e8f6d81926e82936f82936f83947285957085967084966f82946c81936b81926b8092697f916b82936d83956c81936a7e8f61748361727e5b6d7a5466715163724e606c4b5c674b5c684c5e694d5c66485762495a664757624c5b6449596344545e4b5b644c5a644f5d6653616b53606958656e5e6a7469747d707a837881897e848a8387888f8f8ea39d95cabaaae6d5c1f2e4d3e6daced5cfc9c0c1c155555563615e6f6b6568645d6b655e746d65756c627b706586796c968471ab957daf9579d0af89d7b48ad6b48dc9aa88bea285ba9f84b19981af9a85b8a593b0a092aa9c90a49a8f9a948d93908c8f8e8e888a8c86898c81858981868b7d848b747c846f777f767f88717c86707b8568757f65727d626e7b647380606f7d5b6a785c6b7a5f70805c6c7c5b6b7b5767755b6b7b596b7a5b6c7c596b7b5d6f805f71815c6e7f5b6d7e596b7b5d708066798a6a7c8c6f81917484937787957989967787947787957585937081916f80907083927285947083936f82936e81916a7d8e667c8d667a8c63798a6074855c71835b6f81586d7f586e805970825a71845a72855b72855a6e7e596b7b4c5f6c4b5f6e485c6a445763465a6844566241525f42556042545e3f4f5b45576040515b3c4c563f505943525c43515d4958634958624a5761505d685865715a666f65727c67737d747e8779838c82888d8b8e91969a9ba3a8a9a9abacb4b6b6595c5e595a5b5556575757555c5c585f5d5964615b6f69617f766b92806da58f77c4a685caac8ac2a788a3907b9d8b799b8a78bfa88fb09f8fa89b8e9d938b96908a8c89868b8a898a8a8b898b8e888c8f83878b7d838a788088747f87707a84707b85737d87737d86717b856a757e6d77826b768166737e626f7a606f7c61707e5d6b79616f7c63728065748168768468778561717e6373805d6c7a61718061717f617180647585627382697a88728390778794828f9b8c959e969da1959ba0858f98858f997f8c967c89947886937484937283926f808f697b8c697c8c6579896377885f74855c7183576c7e5368794f65755064774f65774e64754d637650657852697c556c80586f835b7185576e7f495c69475a664255614053604657664457644557603a4d593c4e5b40535f394a55394a563e4f5b3a49533a4a553b4a553f4d5847586644515c4d5d6b4856614c5965505c665a666f6b7783656f77646e776e79816e7780747f894e5356474c504a4d4f4d515251525259595567645d70695f867868aa9478c6a987bda2859f8e7a978979ad9982a597899a90879189838e89848583817d7e80777b7e74797e757b81747b82767e85777f887079826d78816e7983747e8875808a77828c79838d7c858e7d87907e88917f8790757d85757e86727c8568737c68737d67717b67727c6d778179808881888f8088907f878f747e8775818c76828e788592707f8d6f7f8d6f7f8d6f7e8b72808c7e89928890978a929a859099808e98818e9984919b85929c828f997d8b977988957383916f808f6a7d8c687b8b6275865e73845a6f81576b7d5165764a5f704c61734a6071496071495f71475e6f4960734c62734f667751677a52697d536a7d536b7d52697a4a5d674254603e515e3e51604054623a4c593648553b4e5b3b4e5b3749543d4f5c41535d3d4f593a4b573b4d5b35444f3d4e5a3e4e5c;
   16'h0007:packed_init=18432'hd7bda2d9bfa6d9c0a7dbc2a9ddc4ace1c7aeddc5aedcc5afd1bdadd0beaec7b8abc0b4aac5b8acbbb1aabab2abb5aea9beb5adb4b0abaaaaaaa8a7a7a3a5a9a1a5a89ea4a8a0a6aba0a6aba3a7aca3a7aba5a9ada6a9acb0b0b1a4a9aea9afb49da6af96a2ad8b9aa98798a88497a88598a8869aab8599ac8398ab8399ab8297aa8297aa8298ab8397aa8498ac889caf8298ac8096a97e95a9778da17a92a77489996d84956e82945a6e7c53657256667342515d4a5b694556624c5c6747565f40515d3d4e5b3748543a4c583e505a394a564557633e4f5e3848553c4f5b3a4d5b35465433455431435234465637495832414e384a583a4c5b3747553848563b4b593f505e4252624e5f704e5f6f4c5c6b4f5f6e5464745767784b51574b525852595f4f555b4e545953575b565b5f5c5f6361646666686a6766646f6b687a746f7d756d897f748b7c6eae947ad7b389e2bd8feac799f4d5a6fadcb2f4d4aef2d2aeebceace5c7a7d5baa1ccb6a1d9c0a6d0baa4d0bba6d8c2abe4ccb2cebba8ccb9a8c9b8a9b9ada2b0a7a0a7a29ea6a4a2a2a2a19b9c9ea0a1a29ea0a19b9da1989da1969ca09a9fa39fa3a7a0a3a7a1a4a8a1a4a8a4a6a9a6a8aaaaaaaba3a6aba0a6ab9ea4aba1a8b0a0a8b19ea8b29aa6b196a3b096a4b197a5b297a7b499a8b697a7b697a8b697a8b797a8b798a8b895a6b694a5b694a6b691a4b591a3b48fa1b38b9fb1879caf849aad849aad8299ad8095a96f818e7b90a17b8d9b646f7058656f4f5d684f5e6852626a4b5e6353656e485b634e6069505f655668775e6d794657624357673f515f324250374958374a59334453384a5a3748573a4b5b37495736475543566740526246576751637451627452637350606e5969795767775c6d7e58595858595a5e60625c5c5e595a5b646363706e6b736f69726b6582776c9b8877938272a78f79b29578e7c396f2d2a4f3d4a9e6c59fdebd99d0b393c4aa8fc2a88fbba48edcbf9fb9a592b4a293ab9e92aa9e94aca0959b958eafa297c2b1a1bfafa1c1b0a0b5a99fa59f9a9b999895979898989a98999a999b9d9a9b9e999a9d999a9c999a9c9a9a9c9a9b9da0a0a1a6a4a2aca8a5b3ada8b8b0a9c0b6aec0b6afc0b6afc0b7b1c0b8b2bdb8b4b8b5b4b3b4b6b2b5b9b2b6baacb2b7a9b0b6aeb3bab2b7bcb2b8bfafb8c0b4bac1b3bbc3b1bac2b1bac3b2bac2b3bbc2afb9c2acb6c1a9b5c0a5b3c09fafbd9bacbb98aab995a8b795a7b892a5b78ea1b38a9fb0859bad8397a88094a67e92a47d92a48093a58398aa869aac8398a98498ab8499ac768a987c91a1717e874f5a633a4a564153613a4b5b32435137495a3647553b4d5c3d51624052623b4d5b3c4d5a4454634d5e6e5566775c6c7a7c8c9d7485967687987385976e8090726c67756f68766e67786f667f756c8c7f719e8a78a58e77b6997ccaa885ddb78fedc99bdebe99ccae8fc0a58abaa088b29a85ab9885a39383a09183a194879e9187968d84968d86928c868e8a87918d8a918d8a94908bb1a498b0a499a19b959d99959c99949a97939b99959d9996a09d9aa29e9aa39f9aa5a09baaa39eb1a79ebcada1c2b1a3c8b5a3d0baa4d4bfaae3ccb2e8d0b3d9c4afc5b6a8b6aea8b0ada9aaaaaaa6a9ada8acb0a7acb0adb1b5afb2b7b0b4b7babbbdbebdbdc5c2bfccc7c4cdc8c5c4c3c3c3c2c2c0c1c2bdbfc2b6bbc1b2b8bfacb4bcafb6bdaeb6beb1b9c0b3b9c1b3bac1b3bbc2b1b9c0b2bbc3b2bac3b2bac2b4bbc2b3bac1adb6bfa8b3bc9caab68e9eae8ea0b08c9dae8a9dae899dae899dae889aac879aab889cae879cae889caf899db08599aa899bac6f80905767745466715366765062703c4c574757635465736d7f908094a87b8e9f8597a87f90a08696a78292a37f90a18192a38393a57e8ea0b89d82b0967db3987db0957bb79a7dc3a383cfad87e0bc93e5c099d5b594c1a58ab49b83aa9581a5917fa89482a592829e8e7fa39383a29283a495879d9186998e85988e85968d85978e87958d86988f87a0948baa9d92a99d92a097909d96909d96919d9690a09790a1978fa5998fad9f94b2a296b8a797c1ab98cab29dccb59ec5b2a1b6aa9db2a79ca9a19a9d9a9897989893969990959b91969b8f969e89939d86929c87939e8c98a28f9aa696a0aa96a0aa9ba3aaa3a9aeb5b4b5a5aaaea0a7ada2a9afa2abb1a3abb3a3acb4a3acb5a8b0b7aab2baadb3baafb4bbabb2b9a7afb7a9b0b6a9b1b8a0aab3a2acb4aab1b7a8afb5a8aeb4acb1b6aaafb5aeb3b8a7afb5a1aab29ba7b197a5b09ba8b39da9b59daab69ca9b69daab59ba8b494a3b18b9cab8597a78193a37b8ea07d8fa07b8c9d798b9c76889a7487987587986f80906f80906e8090718393748698738697748697738495748494788a9b7f90a08393a48495a68091a1f0cea6f1cfa6f6d6abf4d2a7efcca1dcb992d3b28fc9aa8abea185b79c83b49a82baa088bda289c0a68bc0a48bc4a88cc7ab8fc6ab8ec2a68cbba38db6a18db49f8db7a28eb5a08ebba592c6ac95d6b89cccb29aceb39ac1ab97bca896bea996c8b099d3b79bd9bda0d9bd9fd1b79ebeaa99a99d949e979296928f90908f8e8f928b8e928a8f94888e93878e94838d96818c97828d98828e99818e9a808d9a838f9c84919e8795a28d9aa5919ca6909ca6939ea898a1aa98a2aa939ea88e9ba68c9aa78d9caa919fac94a1ad96a3af9aa6b19ba6b29ca8b39ea9b49ba7b39aa6b297a4af919eaa909da98b98a58a97a38f9ba58c98a286929c8e98a1959ea699a1a7a3a9aea3a9aea1aab19da7af9ca6ae9aa4ad9aa5ae9aa4ad9ba5ae9aa3aca0a7aea9acb0a1a7ae959fa88d99a58898a68a99a78898a67f90a07687976e7e8e6878876474816878876171805b6a785f6f7d5f6f7e6172826374846778876c7d8d6d7e8e6a7b8b708191f5d6abf8d7a6fde1b0fee9befce8c1fae1b8f2d3a8e8c59ce0be99e2c19de2c29edfbd99dfbc99e3c19be5c29ae7c39be8c69de5c39be1bf99e2c19ce7c5a0e9c8a3f1d0a8f4d5adf8dbb0fadfb7fce7c0fbe5bdf4d6b0e5c6a4d9bea1c9b39cbca996ab9d90a499909f97909893909290908b8c8e84888d82888d7c848b7a848d77828b747f8a75818c717f8b74828f74828f7081907383927383917081907585947788977686957586947082907485946e80906e80906f8191758897798c9b758999788b9b778a9a7c8e9e7c8e9e;
   16'h0008:packed_init=18432'h7180907987958794a198a2afabb0bbc0bdc3dfd5d4f0e2def3e2deeadbd9dacbcfd0c5ccc4bdc7b5b4c1a8aabad2b69cc7ae96b8a38fad9b8ba595889d9187948b838e878288848082807f8180817b7d7f74777b71757a6f757b697178646d76636d76606c77636f7a64717d65717e636e7a626f7b616e7b63717e6472806674826977856a77866a78866c79866f7b88707c876e7a886c79876a79886979886b7a8b6b7b8b6b7b8b6c7d8e6d7e8f6b7d8f6c7f906d80926d81946e82956f8397708497718497708397728698758899788a9b7a8c9c7c8e9e7c8d9b7a8a967b8b9970808c6b79856a788467768269798563717d5d6a7459666e55616b4d5b65505f694c5b6547575f47566148596341515b41515b3f4f593c4b563c4c573f4e5840515f3a4a553948533949562e3d48313f4a2f3e4a2d3b462f3f4a35465233424d374752394a553d4f5a3949543c4d583b4b563b4a55404e594e5f6c5565745d6d7c5869775a6b795a6a7a6676857181917787977a8a9b818e9e8994a2969fadacafbbc9c2c7e4d5d5f9ebe4fef7f0fdf2edf0e1e2dfd3db978c819289818d857d87817b807c797c7a7a7a7a7b76787a7073776e72776a7075656c7261676f5e676f5d666e5b646d5a656e5c66715e68755f6b765f6b775d68745e69755e69745e69765f6c7865707c6a74806a75806b7581707b85788089778089747e89707b876e7a87707c8a707d8a727f8c74808f73829074839276849475859475859675869775879876879a76899b788a9c778a9c76899b798b9b7c8d9e7f90a08091a18393a28494a38897a58999a78a9aa78b99a584919d76828b6f7b8477828b79858f7b868e7e878a6d798056636a505f6953626e4f5f6c46566049596443525d44555e44525b3a49543b4b573b4b543c4c5439494f303f49303f4a2d3a4530404c30404b2e3e4c2e3e4931424f31414b2c3b462e3d482e3e49303f4b35444f3c4b563f4e5b3f4e5a45576441525f3d4d593b4a5741505d4e5e6d5262715666766374836a7a8a728292828f9f8d98a7959daba5a8b5bfbac2d2c6cddfd1d5e1d4d9ebe1e47a797879797a7274766d7073686b70676c71686e74656b7261686e5e656d5a626a555e6655606857616a56616a556069555f6959636d5b65705c66705b656f59636d5a646e5c656e5d6670636c756a727c6b737c6d757d777c8285868a82858a7d838a7a828b7b828b7c838c7b848e7d87927f8993828c97828c97808c98818d9a818e9b808e9c7f8e9d808e9e8291a08493a18493a28594a28595a38595a38896a48c9aa88e9ca9919eaa95a1ab98a3ad99a4ad9ca5aea2a9b1a5acb2a2a8afa7adb3a7acb0a0a3a681878c747e86788087737e8458666e606e7954636b54646d54636e4d5f69495a6441515c4252603d4d5941536042525c3b49543a4a5133424d2f3e4933434f3344512f404e2e404c30414d2a3a452937422c3b4630414c32424e394a573d4e5c3c4d593b4c5836475332414d3444503849553848543a49553c4c5946556242515d4d5d6d5a6b7a6272826c7c8c7d8b9c8692a3919bab9ca4b3a8abbaabafbeaeb0bf5c62665960665a6269575e6359626a5f69735c677059636d535c645058614e575f505962505a63535e6856606a58616b5a636c5a626b5b636b5d636a5e636a5d636a5f646b62686f676c736f7278717377737578828080948f8c8f8d8c88898b87888d898c908a8c908a8e938b8f958f929793959995999e9499a0949ba2949ba39199a28f97a18e98a39099a4929da7949ea8969fa897a0aa96a0aa96a0ab97a1ac94a0ab97a1ac98a2ac9aa4ad99a3ad99a3ad9ba4ad9fa7afa7adb4aeb3b9b0b6bbacb4bbaab3bc8c9598838d9379838a6c798267747f5c6b7555646f52616e4c5d6a4b5d6a5465724c5b66596a7642525f3f4f5b3e4d5a42525d46555c4050583e4e5634434f32424f36485736475631414e2d3d492a39442e3d483648563848563b4d5c3a4c5a34445035455133435133435033424e303f4b33414e3748543c4e5c475969475766495a694c5c6b5465755f71826475856474846b7a8a7483947a88998594a592a0b1525b61525c64555f684f5860525c66525c654e57604c545c4c545d4a535c4b545b4c545c525b645860685b62695d646d5f666d60666d66696e66676968696b696a6b706f70747474787573847d78827b76998d84a99c909e958e99938f9b96929d9894a09b989f9b989f9c9ba29e9ca4a19fa7a4a1a7a5a3a9a8a7a7a7a7a3a4a79fa2a7a0a4a8a3a7aba7a9adabadafabadb0acaeb1a9acb0a5aab0a1a8af9ca4ad99a3ab96a1aa959faa97a2ac97a1aa929ea98f9ca9929fab97a3ae93a0ac8e9dab8e9fae93a3b290a1b18d9eae8ea0b08898a48d9ead6877805f6f7954657050606d5668755162704b5c6a5263705769774d5f6d475866404e5a42525e495a664a5b674d5e6c3d4e5c324351354655384b5a344552334452354653374854374855394b5935455231404c2e3d493343502e3d4a334451344553324351374856394a593e4e5c3f4f5d4859674d5e6d4e5f704d5e6f4d5c6b4e5e6c5564735565755f6e7d6573846e7c8c4b535b4d575f4f58624f59634a535a4951594b535b4d565e4950584c535a50575e545a62575e65585d635f6267696a6e70717374706c78706a84796f83786e867b72928477968678b8a087af9881bfa891bca794b5a595b4a496baaa9cb8a99cb9aa9ebaaca0b8aca1b9ada3bcb0a6bcb1a8bbb1a9bbb2abbbb2acbeb4aebab2acb3aeabb1aeacb0aeadb1afadb5b3b0b4b3b2b0b0b2adafb2aaadb0abadb0abadb1acaeb1abacb0a8acb0a3a9af9fa7af9fa7b09da7b198a4af92a0ad8a9aa88395a77c92a57a91a57d91a57f94a78296a98196a98399ac8297aa8497a87d91a26c7f8e6074836e8394697c8a5a6c785466745c6e7d5466744e5f6e435460404f5c4556634655604a59644958643a4b59354754374957394b58394b573647533748553545523949563e4e592f3e492c3c492f3f4c384a5a374a5a394b5c384a5a37495740536243576843576742546343546440505e404f5d40505e4655634a5a694f5e6c5463725c6b7c4e555c4e575f4f575f4c545c4e565e4c535a4e555c51585e50555b545a5e575b605d60656163666664646e6b687c766f84796f897b6d9e8b78ac937ab1967bc8a883d7b286ecc99de5c5a2e0c2a4ddc1a4;
   16'h0009:packed_init=18432'haca7a2b5aca1c0b2a4cfbba7dfc5abedd1aff9e0bcf9e5c5eed8bddcc7b0d1c0aec4b7a9bdb2a6b7aea5aca9a4a2a4a49fa4a99ca4aa99a3ab9aa4ae929fab8b9ba9899aaa8596a87f92a47c91a47c8fa37a8ea1788d9f768a9c7284956e8090687a8b6071805f707f5a6a785c6c7b5f70805868775363715363714b5a684f5f6e50606f5263734f6172495b6a4c5f70485b6b485b6c485a6a4f62734a5d6d4a5d6e4f62735264754c5e6e5e676d646d746b747b6f787f747b81777d828085888486878d8a88938d889a91889f9388a9998cb7a28fc7ae97d7ba9ee3c3a2f1d0a9f6d8b4f8ddb9f3d5b4e0c6accab6a4c7b4a4c0afa2c3b3a6beb0a5b6ada6aca7a4a2a1a293969a868b917f868e8890999199a18c96a0838d9887919c818b968690998c949c8f959c979ba0969a9f91969d8b929a8991998c939a89919a889099879098858f98858e98858e98848f99838e98848e9885909987919a8c949b8f959a95989b9e9d9cafa79fc2b1a0ddc4a8f5debbfbe8c7efd7b7d9c3abc9b9a8c2b6a9b7afa6acaaa4a1a3a39ba0a3949ba08e979e85909a7f8b977c8b997c8c997d8d9c8191a08595a48c9cab8b9baa8293a2798a9b788a9a7c8e9e7e90a07c8e9e7b8d9d7d8d9e7d8e9f798a9b7789997485957182916f81926a7b8b677889687a8a6475856071835f71816072836173835a6c7d5668795062724d5e6e4e607150637354677856697b5b6e8161758956697b56697a71797e7b848b80888f82898f888d918e8e8f95928e98918ba1978ea5988cad9c8dbaa491cbb199dcbd9fe8caa8eed1aee5c9aad8bea3cbb39cc0ac9abbab9db5a79ca89f979e9995a29c9996969896989c9093988c93998b939b8e969e8a939c88929c89949e88939d8a949e89929d8b949d8f979f8d969f9199a18f979f879099858f987f8b967f8c97808c977f8b967e89957f8a977e8a967e8a977d8a967988947987947b87947d8a95818c97858f988c9398979899a9a39ec6b6a6d7c4acdac4add1bea8cbbaa7c1b4a5b7aea3aca8a2a3a3a1999e9f979da1939ca18f9aa38996a184939e7f8f9c7b8c9a7a8b99788a9a7587977285957285967588987487977c8e9d7d8f9e788a997789977788987687967787967c8c9b7f8e9d808f9e82919f82909e7f8d9b8392a18292a27f8f9f7e8e9e7a8a9b798a9b788a9b76889a7486987082947285976f82956d7e915b6b7a5a6b7c56667653637255667656687955667658697b5466767f878c878d918d91959496989b9a98aba5a0bdad9fdbc3a9e8cbaaf2d2acf9ddb6f6ddb9e3c4a3ceb298bfaa96b5a495ad9f93a4998f9c948d98928d908e8c8e8d8e8a8d90868a8f84898f82899180889179838d76828e7886937d8b98818d99838f9a85929d86909a8d959e8c969f85909a838e99838e997b88947a879475849273839072819070808f6f7f8f6f80906f7f907081907483927786947a87957a88957c89957f8b95848e978a91989397999b9b9b9a9a9b9295959697979a9b989b9b99999c9c989c9d9a9fa1989ea1969da0919b9f89949b7f8c9679879375838f72808c7585927586947485946e81906c7e8e6d8192677c8d637687607383627685677b8b6b7e8e6678896072816173825b6b795f6f7d697a896e7d8c758492818e9b8995a18e98a4919ba6949da897a2ad98a4b09ba6b294a1ae8b9aa98a9aaa8c9bab8696a78091a47f90a27f91a37f91a58293a58291a3748495687889606e7e5f6d7d5c6c7c5564738f8f8f999795a7a19cbdb0a4d2bda8e6c9adf8e0befdebcbf4d8b3debe9ccbaf94bda590b09f8fa6988d9d938c9b958f95918d918f8e9090918f91938f90938c9094878c92858c94818a94838c967d88927c87947f8b96808b97838e9a848e99828d98858e997e8a94818c96808a967a86927582907281907282917081906e7f8e6f8090687a8a677a8a68798a687b8b697b8c697b8c6c7d8d6e7f8f7182927484937886937b88947d89947c89937c88927a86907b868f7b858c7c868d7a858c77828979858e77838c717d856f7a8373808875828b717f89697782606e795b6b775a6a775f707d6173805d6f7e5d6f7d586978596b7b5567755062714d5e6d4d5f6c4f606e586a795d70806174845d707f5e6f7e5e6e7d617180637381637280667683707e8b788591828e9a909aa69ba3ada1a8b3aaafb8aeb2bcadb3bdadb3bea8b0bba0abb9a2aebca4afbe99a5b693a0b28e9bac8b97a98994a58692a48592a48895a87c8a9c748295dcc0a3e6c8a7efcfaafae0bafef0d2f8e0bde8c7a3d5b798c6ac94b4a08ea7988b9f9389948c868d89848a888687878883858881848880848980858c7b81887c838b7c848c7e868f7c858f79838e79848f7a8590818a957d879377838f6e7c8a76838f788490707e8b6e7c8b6c7b8a6d7c8c6c7d8c6a7b8b687b8a67798a67788a66788a66798c66798b677a8d697d8f6a7e916e81937184957284957283937485947383917383927483916e7d8a6f7e8a6e7d89707d886e7d896b7a8565737e63707b65737e616e785a677159676f58667057646e5867725867725564704d5d684b5a654d5b674b5b674e5f6c4758634656624b5c69485a674658654556634355633f505c3b4b5739485340515c4555624a5b684b5c6854657261717f6a7b8a6d7e8d71818f7382907382917b8a987e8c9a86929f8a97a38e9aa68e9aa69ba3aeadb1babfbec4c6c2c8c2c3cbc4c4ccc1c1cbb8bac5afb1beaaadbaadafbca9acbba7aaba949daf8994a6f9dab3fde7c2f7dfbce7c7a6d6b89cc8ae96baa491ac9b8ca3958a9b9088958d87908b868b88868685857f8184787c80757a7f7178806d757e69727b69747e6c77816d77816d78836b77836c7885707c896a7785717e8b6876846876856a79886d7a876b78876b79876b79896978886979886979896a7a8968798a67798a65788a66798c677a8d677c8e687b8f6b7e926c80936e82967083957184957487987688997485946a7a886d7d8a6f7e8c6e7d8a6e7e8a6c7c896b7b88697a8867778460707c58677359677254636e4f5d67515f694d5b664a58624b5a654a596348586347566244535e44546046566244546140515e3d4d594051603f505d3c4d59394a5537485432424d32414d32424e3444503949553d4d584454604d5d695364725a6b7a51616e52626f5969765f6f7e6d7c8a7485957b8b9a768796738392;
   16'h000a:packed_init=18432'h0000000000000000000000000000000000000000000000000000000000000000000000000000000000000000000000000000000000000000000000000000000000000000000000000000000000000000000000000000000000000000000000000000000000000000000000000000000000000000000000000000000000000000000000000000000000000000000000000000000000000000000000000000000000000000000000000000000000000000000000000000000000000000000000000000000000000000000000000000000000000000000000000000000000000000000000000000000000000000000000000000000000000000000000000000000000000000000000000000000000000000000000000000000000000000000000000000000000000000000000000000000000000000000000000000000000000000000000000000000000000000000000000000000000000000000000000000000000000000000000000000000000000000000000000000000000000000000000000000000000000000000000000000000000000000000000000000000000000000000000000000000000000000000000000000000000000000000000000000000000000000000000000000000000000000000000000000000000000000000000000000000000000000000000000000000000000000000000000000000000000000000000000000000000000000000000000000000000000000000000000000000000000000000000000000000000000000000000000000000000000000000000000000000000000000000000000000000000000000000000000000000000000000000000000000000000000000000000000000000000000000000000000000000000000000000000000000000000000000000000007476787a7b7c83817f88837f8d8782968d859a8f85a19487ac9a8cb7a28fbaa491b9a38ecfb194dfbd9aefcba1e1bf99d6b595bda58eaa9a8c968d868d89868787887e8186777f86707b8469768268768263717e5f6d795a6a785c6d7b5b6c7b5b6d7b5a6d7c596a7a56687755687957697a576a7b586b7d596d805a6f81596f83596f845b71855d73876075895f74875d72855f748861778a61768962768962768863788a657a8c65788a687a8c697b8c6d7e8e70808f7483907784917885917a86927c8994818c9685909a88929b899198898e938d9193919291999693a9a199b6a99dc6b3a1d4bca4e1c6aae7cbace8ccace5c8a9e2c6a8dec3a9e9d0b4f7e3c8f4e1caecd9c6e4d2c1e4d2c1dbccbecec0b5c0b7b1a8aaac99a2aa919ca78594a18393a37e909f7d8f9f788b9c75879871839471869971879a6f83966f839670869873889c708699667c8f617789657b8e687e916176876276876073845f73835d70825a6e7f586d7e636a6e6a6f7272767a797b7e7676757e7c798d867f958b839f9285ac9a8ab9a28dc5aa8fd6b591efca9ffee0b2fde4b9efcda2dfbd98cbae93ae9d8e9a928a8e8c897d8285777f86717b84717c876d7b8764738060707d5d6d7b576774556674566775576877516271546676566978556778556878586b7d596d805a6f825b71855d72865f748862778a63778b5f728560768963788b65798c677a8d687a8d697c8e6c7f906c7e8e6e7f906f81917283927785937c89967e8a957f8a93838c94868f97878e95858c918f9296919396969798a09e9ca7a19aaba197b7a899c7b39fd2baa2e2c7a9f1d4b2f6dbb9fbe1bdfee8c2fee8c4fdeac9fbe6c6f0d7bce9d3bcead6c0dbccbfbebcbaacb1b69ea8b0909da98a9aa68b9ba98e9eac8799a97d90a176899a728696768a9b778b9d738696677a8b6378896478896c8093677a8c5f7181667a8c677b8c647889677e90697f915f7486596c7c576a7a4b5c6a4b5c6a516373475867435563565f665b636a626a70646b707174767a7b7b81807d89837d9d9288a59587b9a38dcdb093e7c59eefcda3fee7bcfce3b8eecda4d8b998bda691a1958b928d898a89898889897e8286787f86727a826f78826a757f626f7a5c697562717f61717f5e6e7d5768765667765869785b6c7c5b6d7d5b6d7e5c6f815c70825e72845f748761758861748662738463758564768668798b687a8b6d7f8f6d7f8f7181917282927484947988967989977a89977f8c97858f9989929b8b939b92989d979b9f9c9ea0a1a09fa5a29fa8a29dafa59db7aa9ec1b0a0c8b6a3d0bdaadbc4aeedd3b4f8debbfde8c4fceecefdf4dafef7defdecccf6ddbce8d0b6dac7b5c1b9b1a8aaad9ea7ae97a3ae8e9eab8ea1b08a9eae8599aa7a8e9e7183936d80906a7d8d6779896b7e8f627584596a7a5e71805b6d7d5c6e7f5d6f7f5b6e7e5f7385586b7b546575586b7c5567784f6171506373495c6b4b5f6f4e61714555634657643d4e5a44566645576641536250575e545c645760665e666b60666b676b6f7074767e7d7c8884808f878094897ead9a89c7ab92d4b798d4b696caaf94b8a28da8998b9a9087948d87928e8b8c8b8b8284878083888386898e9092878b917c858e6b77817a86927583906f7e8c6c7b896474835f6e7c6171806474846878886576876274856072826678896678896576866879886c7d8c6f7c8b71808e7483917684937a88967d89967f8b97838e9a88919c89929c8c959f8f97a091979e989ca1999da19d9fa2a2a1a3a4a4a2aea9a4b6aea6bbb0a6baafa5baaea2c2b5a7d0beabdec6adefd5b5fbe6c4fef0d1fcedd1f8e4c6f3dbbce8d1b8d7c7b6c7bbb0c2bab3b8b6b4a7abae9ba4ac8f9ca78899a68496a78599ac7e93a57a91a47b91a4788fa37387986f83956f8394687c8e63758555667450616f50606d4d5e6b4d5e6c4c5d6c47576549596750617057697a5162724c5d6d4a5c6c4a5c6c4d60724d62734659684658684354634759694558683c4c593e4e5b515960555f675e676e60696f656d736970756c70737577797c7b7a87837f999087aa9b8db5a393b7a290c5ac95b6a190b9a795beab99b8a798b7a698afa297afa299b7aaa0afa49bb0a6a0a9a19b9493949294969a9da192979e939ba38a949e7b8893717f8b727e89707e8b77838f707d8a6e7b886a78866b7a88707e8a73818f808c98818c97848e988a939c88909a87909988919a8a919b8e959d8e949d8d949c91979f93989f959aa0959ba0969ba194999e979b9e9a9ea09c9d9ea4a2a0;
   16'h0100:packed_init=18432'h5d73855e74865d72855b71835b71835b72845a72855b72855a7185576f84536c82536b80536b81536c82556e84536c82526b82526b81536b82536c83546d83536b83536b81556b81556c82556c82566c81566c81556b80576d82586e835970855a6f845b70875a70865a7186587086587186586f85576f86566f86556d84a9947cae967dbea07fe1c69efbedcbfce4bbf8d8aaf3d2a3eeca9ce3be94d9b791d3b493d0b08fd6ba99ecd3b1fbe3c0f9e0bcf6dcb9f5dab7f2d7b3f4d8b3fadeb7fbdeb6f9dcb5f2d6b1e8cbabe6cbabd9c1a8d2bda6cebba5cbb8a4cbb7a3c9b6a3c8b5a2c8b6a2c7b4a1c5b2a0c0b09fbcad9db6a99cb1a79bada49baaa39ba7a09aa39f99a09d989c9b979b9a999797979194959093948f92948b9092888e91858b9082898e7f888f7c868d79848c77838c75828b73808b6f7d896c7c896a7b896b7b89697a886779886477866275846075856075865f75865e74856076865c72835b7183586f81586e81566d81556d81546c80546c80546c80546c8052697e50697e50687d4e677d4e687d4e687d4f687e4e677d4d667c4d657b4b647a4b667c4d657b4c667c4b657c4e667d4e677d50677e52697f526a81556c81546b81556b80526a7f53697f52697e536a8050687d50667c51687e50677d4f677e4e677e4f677e4e667d4e667df1dcb8fae7c4feeac6fee8c4fee7c2fee7c2fde8c3feeac6fde7c3fde5c1fce4c1fbe3bff9e0bdf8debbf6dcb9f4dab7f3d8b5f2d7b4f9e1bdfde8c3fde4bcf7dbb5efd1aee2c7a9dfc5a9d6bfa6cebaa4cbb9a5c8b7a4c7b6a4c3b4a3c0b1a1bdafa1bbaea0bcada0baac9eb5a99eb1a79dada49ba7a099a59e98a09c979d9a969b99979797969696959294958e92948a9092878d90858a9082898f7e878e7d868d7a848b77828b74808a717e88707d886e7c876b7a866878866676846576846375846275846173835d71835c71825c71825a7081597081566d7f556d7f546b7f536b7e4f697d51697c50687c50687c4f677c50687d4f687c4f687b4e677c4d667b4b63794a63784a63794962784862784862784862794862794861784761784761774660774660764761774761774961774a62794a63794b63794d657b4e667b4f667b50667b4f667c4e657c4c657c4c63794a61784960764860774b62794c657c4c647b4a637a486178fde6c1fde6c1fce4bffbe2befbe1bdfae1bcfbe1bdfbe3bffae0bdf8debbf7ddbbf5dcbaf4dab8f3d9b7f4d9b6f8e1befdefcdfeeecafde7c0f6dbb6e8cdaedec5a9d8c0a7d4bea6d2bca5d0bca5cdb9a4c9b7a4c4b4a2c1b2a2beafa1baada0b5aa9eb3a89cb1a69daea59caba39ba7a19aa19d999d9a969a98969896949695949292938f90928b8e91888e92868c91838a8f80878e7c848c79828b76818b75808a717d886e7b866c7a876b7a876778856676836273826172826071815d70805c6f7f5b6f7f5a6d7f586c7e556a7d556b7d53697c52697b50687b4f687b4d65794d65784c65794c64794b63794a63784a62774962774b6277496278496177476176465f74445e74455e75445e74445d73445e74445e76425d74435c73415c73425d73425d74425c73435c73435c73435c72445e74455d74465e74465e74475f76485f76485f764961774b6379486178486078486078475e75475f76475f76465d74475f76485f76496078f9e1bef9e1bdfadfbcf9dfbbf9debafbe1bdfae0bdf7debaf6dcb9f4dab7f4d9b7f5dbb9f6ddbafae4c1fef1d0fef0cffde6c0f3d7b4eacfafe2c9acdfc6abd9c2a9d4bea7d3bea6d1bda7cebba6cab8a5c5b5a3c0b1a1bdafa0baada0b3a99eb1a69caea59baba39ba6a09ca29e9a9e9b979a98969796959595959393948e91938a8e91888c91858a8e82898e7f878f7c848c78828b758089737e886f7d886d7a866a78856776836676846373826172815f71805c6e7d5c6e7d596c7c586b7c576b7c566a7a54697953687a5066794d65794d64784d63784b64784a6377486176486075476074465f74455f73465e73445e73455e72465e74455d73455e73425c72415c72435c72435b72415a723f59703e59703f59703f58703e596e3c576d3e586e3f59703f596f3f586f3f586f4159704058703f596f3f596f3f5970425a71435a71435a71435b71445c72445c74425b74445c73435b73425a7242597141596f445b72445b73445c74f8debbf7debcf7debdf9dfbcfbe2bdfae1bef8debbf6dcb9f5dab8f7debafceacafef3d2feefcbfeeeccfae3c0f3d9b7ebd1b0e5ccaee1c9addcc5abd9c3abd5c0aad1bda8cebca8ccbaa5c8b7a5c5b5a4c0b2a2bdafa2baad9fb5aaa0aea69daca39baaa29aa49e999d9c999a99979695949393939091928f90928d8f92898d9183898d81878c7e858b7b8289768089747e88717d876e7a856d79866978836676836575826272805f707e5e6f7f5d6f7e5a6c7d586a7b5669795367785267785266785065764f64764c63764b62754a6176496075475f74475f74475f73455e74445d71445d71435c71415a70415a70415a70415a70415b70415a70415a704059714059703f586e3d586d3c566d3c566d3c576d3d576e3b566c3b566c3a546b3b546b3b556c3c566c3d566d3c556c3c556c3b556a3c556b3d566c3d576d40586f40586f3f586e3e586f40576e3e566d3f586e3f586f3f586f3e576d3d576e3f586f40586f40576f3f5870fadfbdfae0bdfbe1bdfbe2bffde5c0fce3c0f8dfbdfae2c0fef7ddfef7dcfef5d6fef2cffae1bbf7dcb8f3d9b7eed5b6e8ceb0e1caafddc6add8c4acd6c2abd2bfaacebca9ccbaa8c6b6a5c5b6a5c2b3a3beb0a2b9ada0b7ab9fb0a79eaaa49da8a199a39d989f9a969b99969797969292918e8f908e90918a8d90888a8e84898c80878b7d848a7a8188757d84707b846f7c856d7a846a778366758265748163738062717f60707e5b6c7b5a6b7a596b7a5769785467785266774e63744f63744f64764b60724c6073485f72465e72455d72485f73435b70435b70445c70435d7140596d415b6f3f5a6e3f596e3d576d3f586d3f586c3f576d3d586d3e586e3d586d3d586d3e566b3b546a3a54693b536838536b3b556b39546a3852693753693750663750673b546b3b546a3953693b546a3a53693952683a51663a53683d566d3e576d3e576c3f566a3c546a3c54693c53693e576d3d566d3f576d3d556c3d53693c546a3c546c3c546b;
   16'h0101:packed_init=18432'heed1aeefd2afe6cba9d6b99bccb197baa897b6a695c1ac97cdb49bbfa893b5a392ad9e90a99c90a39a919f989395928e908f908c8e908a8c8f888c90868b91878d94868d93969899aca59fa2a19f9e9d9d96949283898e7e868f7c86917c87927b88947a879475839174818e7c838c6c78856675846273826073836275875e71845b6f81596d80596e82586d80586d80586d825d72885e738761768a63788c5f73865f738762758863798e61778b64788b6f7d8b6071835e6f7e596d7e5d7083687685606f7b4a5f73536c8443586e3f54693f566c40566b3c51663f54683d51643f556942586d445a6d445a6d4d657b4b61764e6377626d76555f685d61605c60605d60615b5e5f5e65695f64675c5f6161686e63686c63676a666a6e676b6f6566666c6b6a777675807a7294877ac1a88cc0a991b29f8ca39587958c828d888284807c84817e8785848886838a8680938a80c5ae95dec1a0dabd9fd5b89bd2b598d7bd9ff7e3befde9c2fee6bdfde5bcfce1bafbe1bcf7dcb6dcc3a6f6dbb7e6c9a7bca894ae9e8faa998ba1958b9c928a98928d908d8c8c8c8e888b9084888d83888d858a909495959b9997cebba7c8b6a5bfb1a4bbb0a5bcb0a5bdb2a8b5aba39d979476828d72808c74829070808f7987948b959d828e9984909b929599777e876173836275875c6f815e72855e7285566a7c596e81546a7e566c81566b7f586d81586e825c728661778b6176885e70806274865c7083586c7f5c70845e74896576865666755b6a794f6376566a7d5c7085596b7d4b5f7140566944596d40556a3e5264465b6f44596d475f74455b6f4357694b62794d657a4d6277767e876777875269805c5e5d5b5d5d60636461656863676a6162616567676e72776a6c6d74777a71716f746f6983796e9183759d8b77ccb091c7ad93b8a48fab9a89a5978a948a808c847b8d8882908c889690889d948ba39587cab9a0fae6c0f0d8b5eacfacdabe9fd4ba9defd8b3fce3bbf9e0baf6dcb7f4d9b3f1d4b0f1d3aff1d3aff7d9b4f6d7b2f2d4b0edd0b0ebcfb1e4caade0c6aba1968ba69a90918e8c89898c85888b82878c80868da59e98cbb7a5c2b1a2bfb0a3b8ab9fb1a9a0aea79fada7a1b0a9a3b3aba3b0aaa4ada9a4a4a4a3999da095989ba0a0a0a3a2a1a2a2a1a0a2a49a9fa2979da2969da39199a0838f9a919ba1979fa5818e9a667788647584586e82546b7e556c816f8193929da69da6ac97a2ab99a3ab9fa7afa0a7ad818a937a828b6d7a885e72855970865c738a61788d6b78855a697850637651677b586e82596d7f53616f4f5e6b4c5d6d495867445666516478586b7d606e7c6c757e5f6d7953687d4d627751677e4f63775c5e5d5f6162656869686b6c6a6a686f7070777a7b7675737976717f74689083769b8b7cc9ae8edcc09fceb396c0a88fb3a08ca494849d908293887c958c83968c829f948aac9d8eccb89ff1e1c1feecc9feeac5fdeac3f8deb9f1d5b1ecd2b1f0d5b3f0d4b2f0d4b1f9e2bdfde5c0fde4bdf7dcb7f5dab5f0d3b1e9ccace9cfafe9cfafe4caace1c8ace0c7acdcc5acd9c3acc2b09d8d8d8c9d989581868b909294bbafa2b8ada1b6aba0b4aaa1b1a9a1afa8a0ada7a1afa8a1aea8a1a5a3a09d9e9f9a9e9f999ea09a9ea0989da0959b9e90989c8a939a87929a88929b87939c85929c88949c8f98a08e98a086939c84929c82919d8595a08696a38493a0788b9b7d909f7d90a07a8d9d788b9b778999738797718697788b9c7b8e9f8193a3728698718191586f85667d927c90a18094a68798aa8a99a88a959e7d83886c757d7d81858a8888a0978dc4b198b7a69099928c7c7d817b80865e6d7d5064784c6277556b81566b80667c926665626766626e6d6c72706c7a78777b78757d756e8a8279928070ac9578e0c39be0c2a0d0b194c8ad93b8a08ba694829e8f80998b7d97897d9e9288a29488bca894f5e8c9fef3d2fff2d1fdf0d0feeecdfdecc8fdeac5feecc7feedcafeebc8feeac5fce3bef6ddb8f0d4b1ecd0ade9cdade6cbabe6cbace0c5a8d8bfa4d8c0a5d6bea6d6bfa7d0bca6ccb9a5c9b7a5c4b5a4c0b2a3bcafa2b8aea3b5aca2b0a8a0ada69daaa49da7a29da3a09ca09e9b9d9c999b9c9b999a9a95989b959a9c949a9c92989c92989b90969a8d969c8c959c8e969c8a949b8d959b8c949b8a939b87929a8390997e8c977a89967888967284936f82916d808f6c8090697e8f677c8e657b8d657a8d647b8e647a8d657b8f647a8e62788b62798d647b8e667c90637b90637a90637a8f60788d5f768b62788d61778d647a8f687d926d81946e80926b7e906b7e906a7e91697e92687e92667c906a80956e849875889883909b9aa0a898a1aca2a5ac7f91a4746f677570697e78708781798b80768f81739d8a75ae9478e6c79bddbc97d5b696ceb092c5aa90b8a490aa97859d8b789f8f80a39588ac9c8bd5c2a8fae5c1fce3bffae0bcf8debaf4dab8f2d9b7f1d7b5f2d7b5f4d9b7f1d5b5ecd0b1e7ccade4caade3c9ace1c6a9e0c6a8e0c6a8dfc5a8dac1a6d6bea5d1bca5cbb7a3c6b5a2c6b5a3c6b4a2c1b1a1bbada1b6ab9fb3a99eb0a89eaba59ca8a49da7a29ca29f9b9f9e9a9d9c999b9b999898989396989093978d92968a9094878e94858e94828c94808c947f8c947d8a947e8b937f8c95808c957f8c957e8c95808c977d8b967b89947787947385936d80906d80906d81906c80906c8090697d8e667b8c657a8c61778a5d75885d74885b74895b73885a7286576f85587085587086576f85587187597187587086587086587086577087566f84586f855b70875b70855b70855c72865e73875f768a64798d647a8f657a8f657b90687d90697e926b7f936b809561778f60788e6179908b7f728c8072988c7ea49281ab947ac4a67fe9c89de8c49ad8b58ed0b08dcaac8cc0a58ab8a089ae9781af9983ac9884bba690edd6b4fce5c2fbe2bef8dfbbf5dbb8f3d8b5f4d9b6f6dab6f6d9b3f3d6b3eacfafe3caadddc4a9dbc3a9d7c1a8d6c0a7d4bfa6d5bfa6d5bea5d2bca4d0baa2cab6a1c7b4a1c1b2a1bdae9fb8ac9fb6aa9eb2a89dafa69caca49da7a29ba4a09b9f9c999d9b989b9a989798979294949294959194958d9295888f92858c92838c928089917d88907a868f79868f76848e74838f73828e71808d707f8d6e7e8c6e7e8c6f808e6c7f8d70818f6c7e8d6b7e8d657a8a6176885e7486;
   16'h0102:packed_init=18432'h41556744586b4357694b6072506577b9a792aa9d889288788982757e7a7079776f70716d6b6e6d63686a60666a5e666a575f63555d62545d64545f6857636e57657056636f505c6654616c53616c55626d57657058646f5a67735d6b77606d7865737e67747f66707a6a757f727a8181868b888b8e908f8e94918e9c958fa69b91a69b91aa9e93ada094b2a397a89b90b9a797ddc0a3e4c6a8e6ccaee9d0b2d9bfa6e6caade2c8abd6bea5c1ae9db3a496cfb9a3cbb6a1aea295afa196aa9f95b3a599a49a90b0a397cbb4a0baaa9ba69d94a29a949a9590b6a89ea8a19b91929482898f8189917f8a93848e98828d997784917483917382927484937786957988988288906b727956687853667752667850637553677a53687b5567764e5e694155654055614a5f6d41525d4b59613e5364344a5b344b5f324859354b5e2f44552d405030465731495c30455630445431455633485b33485a3145573045572f435430455631475832475735495a374b5c374b5b3d5163425769978e7f91897c817c717a776f74746f6d6e6b6569685f64655c6367575d62555d64535c63535d65535e6755636f525e67505c6552606d525f6a525e68535d6754616a5965705d68725e6a75616d7865707a626c756c768072787e848689888887918d89a399909b938bb3a293a4978cac9c8e948c84988e85998f86b3a394e3cbafe1cab1ddc6afd6c1abc5b4a3c4b3a2c8b6a5c5b5a6cdbaa7b5a799b4a292b5a49595908a908b878b8a88848485818384838485908e8c8788888183859a958f838587787f847a80857e8489888c8f868b91818890727f8b6877866878876b7a896778886a7b8b6e7e8f6a7c8c7584947c89977c8a9987929d69737d4f62724f63754c5f704b5f714a5e704a5f734c6073485d6f485e704b617451677a536a7f586977535f64384c5b354a59354a593c51603b4e5c3b4e5b34495a384e60354a5a394f62364c5e344a5c2f43532e42532e41522e43543044552c3e4d2f42533044532f43533145563246588480767d7a7176756e6f706c67696763666761666a5a6063565f65555c61535b6056616c55626c535f68525e68505b64535f6954606a545f68545e6658626b5861695d656d646d77646d75666e756b7178777a7e8f8e8d95928d938f8b97908a8c87827f7e7c84807e7d7b7b7d7c7a817e7bb5a593d6bca1dbc2a9d3bca4cdb8a3cab6a3b4a69aaea399a59d94a49c95a49c96a59f99a9a39daba39bb1a79eb8ab9fb5a4928b87838684828685857c7f83757a7e73787e6e777f6e777e73797f737a806b757d68747e67747f64717d606f7c61707f5f71805c6f7f5a6d7e596d7e5a6e81596d805c71836074875e728362748661748765778a687b8e707f8d5869794f62734c6071495d6f475b6c45596c475d70465c6f44596c485c704b6176495f734d64794b6277465c70475e73475e744960764d647a52697f5465745a656c4b5b683a4e5e364b5c354c5f364c602e41512e40502f425233485a2f42522e404f2c3e4d2b3f4f2c405174756e72736d6b6b68676968636769606669595f62565d6159626b586066515a60535d65545f68515d64525d65515d66545e675560685760675a63685c6369626b72666d746a6f7374787a7979788e8a868281807e7f817c7e8173777a6e717574787b7c7e80817f7e938a82d3bca3d8bfa4ccb49ec9b39ec9b39fbeab9ab9a899ab9f93a89d93a39992a097909f9993a19b96a09993afa49ab9ab9ec2b1a2c6b3a3bfb0a1b6aa9eb5a79b948d877e80817a7d7f73797e6d757e69737c65717b67747f616e7a5f6e7b5c6c7a5b6b79596b7b57697a56697955687b566b7d566b7d566b7f566b7d566a7d586c7f5a6e815f7284657788647688697b8d6e8092738495758697717f8c606e7a526474506374465a6c455a6b43586a475c6f455a6d455c6f44596d40576a435a7042596e41576b42576b445b7044596d4b627750687f4e667c536776475b6b415564455967344756334656324657334859354a5a2e41512b3d4a2c3f4e273a486d6f6d6c6f6e6265656166685f64675c6266585f63575f6552585c565e64535c6457626c525b62535d65535d645560695760685c646b5e656a666c71696c706b6e71747678817e7b918b848e8a858785837f7f80727477707478757a7f787c80808080938a81cdb69dcbb49cc7b099c1ab97baa896b7a595bba998c4af9cbba998c1ad9bb1a396aa9d92b0a399bbac9fc5b2a1cab5a1cfb8a3cbb6a1b9a99aaca297a89f98a79f999f9b979998969897989a9896928e8b7f81826d767e67727c65707a67717a616f795b6a775a6a78546575536676536778536778546779566a7b5a6e7f5e71826c7c8d6c7d8e6b7d8e6b7c8d687a8b6c7e8f6d80927385967183956c7d8f687a8c6c7f926f8295697c8f66798a60707f5566774d6174465a6b44596b43586c445a6e42586b42576a475e73445c7142596e435c7247607642596d465d73475e744a5f744e647a53697f5c738a667c905a6b78515e643d4f5d354756334657314556293b4a6b6e6d686c6c5e62645b61625d62655960645b6269545b6053595d5b656d58626a555c63566068575f655961685d646962676b6c71766b6e70737474807c789b8c7da29486958d858b868184827f7b7b7a777a7e767b7f797c807a7b7c84817ebda994dec2a6dcc1a5d8bda2d0b79ebfab95c1ab95c5ae97c2ab96c4ae99c0ac99bbab9bb8a899bbab9cc2af9dcbb39cccb59ec4b09db6a696afa296a69d94a09a949b98949a989693939392939592949792969992979b92969a8e90919291928c8e918b8d908c8e917f838770797f5f6e7c596b7a586a796674816c7a88727f8d6f7d8c6b7b8a66788862738564768961738461748660748761758862768964778b687c906b7d9161758964778a687c90697d916c7f93738699707f8f72818f868e987b869272808e67788754687b4c62764b6176475e7440566b3d52653e546840576c455c7341566a44596e4a6178485d71455a6c4960754f667b546a7d5c6872535b5f33445335495a6063636064645b5f615c6163595d605e656a595f64575c5f5a60656169715c62665f656a60676e5b5f636266696b6e707071727b7873898076ac9983b09e8ba6998a978f8488847f82807d7f7f7f7b7c7e7c7f827d7e7f817e7c928a82dec2a4dabfa1e1c4a5e0c4a7ddc0a2ddc1a2;
   16'h0103:packed_init=18432'h6871767075776a717357646e515f6a495c6a495c6b475c6a465b6a4459694156673f55643f55673c51623d52633c53633d54683a5162374d5e384e5e3a4f613b50613c52643c52643f566742586a425a6c4a61744a61734e657751687b566d805a70845a71845d758a62788d586c734b606b657c8b50656a3f525746534d28383d23333a22313c1d2c361d2d3776736c79756d867d70958673b29a7ec3a685caab86d8b78ed8b48aebc795f4d8abe9cda5c8b090b6a28aaa9b899c91858f89828d89838f8b858685828181807b7e7f7b7e807d80837c7e807c808373797d70777c6a71776a737b69747d616c755f6c76606d785e6c7761707c59687457657259687659687560707e60717e58687560707e54647150606d5364714d5d6b51637150627050606e5263715768775b6c7b5f707e60717f5f717e5f707e637482697885707e8a78848e8f959a969a9d969b9d979a9e9a9d9fa2a3a39b9ea1a2a3a2a9a7a4b2ada7b1aca7aeaba8a5a29ea29c92646d74626b6f656c715c666c485a674558684055643f54643c51613c5161394e5f384d5d394f5f394f60384f61364d5e364c5e374c5d354a5b364c5d354a5a374c5d3a50613c54663c53663f566842596b42596b475e7050677a4d627651687c556c805a71845d75895e758960788d687e956a82975e71794c5d5c37494d28383b1e2c35243641887f728e8273b49c80d9b890ddbb90d9b68ae5bf90eccb9ceecfa2d2b590bda78aa79883988e7f8e877c827f787e7d79797b7a777a7c6c7173696f7370767b6c757b687178616a72666f76626c755f6972606b755b667059656f525f6a515f6a505f6a505f6b4f5f6b51616f4d5d69505f6b55647158677554636f576571627280596874566672596a78566673616e7a5c69745c697463727f63717e63717d6976816e7a8367737d67737e697682828a919d9ea0b0aca8b1aba6aea9a5aba7a3a2a1a0999b9c969a9d92979a91969a94989b8b9195878f95848e958891988d969e8b959d89929b8890986d757959646b5360694b5b664a5a673e51613b4f5e394e5d394e5f364c5c364c5d34495a354b5c374d5f364c5d354b5d364b5d344a5b324858344a5a354b5b374b5b384e5e3a52643b50623b526342596c42596c445b6c485e714c617551687c566d815a71845b71865e748a637a8f6a80955e727a45585e4356603f5358243538ae997fbba181dcb98dceae89e1c298f6dcb1dec098c6ad8cb19e85a49581968b7c8b8479817f787878747375746d7174686f73636b7060686f5e676e5c656c5c666f58636b56626b58646e535f6954616b54626c525f6a4e5c684b59654b5a664a5a674c5b684e5e6c5262705463715464705766735967745866715c6973636d7667717970767b6d7479646f78626e77636f7968737e69747e767e8493908d928f8ca19c99a4a09ca19f9da3a19faea8a2bbb1a6c5b6aac6b7aac2b5aabcb2aabcb4abb8b1ababa7a49c9c9c9395988c9095838c937b868f707d896c7b886c7b886a7b896e7e8c71818f7584927987957d87906f716f616668515e663d505e3a4e5d374c5c334859354a5b344a5b314555314656344a5c354c5e344b5d2e43533044543045552f4454324758354a5b354a5c354d5f394f62374c5d384e5f3d53653e536542576a465c6f4b62744f6578566d815770845c738763788d6074834d5d5c5c74865970824e6163e2bf90e9c797f3dcb6f4dab2d9bf9cc2aa8bae9c83a1937e948a7a8b8478807c747675706f7271686e6f646b6e60686d5b656b5c67705c68725c687156616955616a55616b535f684e5a64505d684b58624d5b664d5b654957624958644958644d5c694d5c6a4f5e6a51606c55636f56636e66717b7a848e868f988a929a818a91848c938e94988b8e9186888c818487979594aaa29bc1b1a2c6b4a3bdaea1bbafa3bbaea3bbaea3bbaea2c2b1a3c1b1a2bbada1b5aaa0ada49cada5a0aea7a1afa8a3ada8a4a9a7a4a8a5a4a5a4a4989a9c828a9179848e7a848e737f8a6e7c886b7a88667685657686657686677889697b8c697c8d6d7d8c686e6d565e5f46545c3e4f5b324655334859324657314555304556344a5c34485a3247593146572f44552f4252304555334858314758314758334a5d314656324757354b5c364c5d394f603c5063405568455b6f4960734c61744c637651677a576d815f75885f758a62798e647a8c5a6e77fef1d7fbeacbe0c6a2c4af94ab9a83a0927e918878868074807e767575716d6f6c686c6d646a6d5f676b59626857636a59656e56626b525e6756656f5665715a697654636e56646f5665714f5c664d5a644a57624c5a654e5c684c5b684d5b68515e6b525f6b56636f5e6972838c94868d95828a928188907d848c7c848b858a90929496959697919192949291a39b94b9a99bb8a89ab1a59aafa49ab5a79bb6a89cc9b5a1d8bfa7e0c6acdcc3a9d8bfa7c6b4a3c1b1a2c2b2a3c1b1a3c0b2a5c2b3a6bdb0a6b3aba4b2aba5b5ada7b1aca6ada9a5a5a5a5a2a3a49d9fa29c9d9f7f868e6c7b886575846576856877855e70815e71835f738360748562758558626643525b4f585e384b59334655304453344a5b364b5e33495a3146562f44542d42512e44542d42522f44533046582f46572f435430455630455631455633485934495a394e603b50633f566940596d4056683d536543586a45596b4c6073506577566a7e5b71855f758addc4a4d3bc9eb1a0889b8e7b94897a898376817d747877726e6f6d6a6e6e63696b5f666a5c6569576166566168545f68515e6752616b58677455636f53616c53606c5563705968765665705a68765c6b795b6a785b697554606a535f69606d786c7884737e88838a908a8e91878b8e8084897f828680838788898b93929295928f94928f97938fa69b91bfab98b9a796aea093ab9e92b1a295c8b29ee2c8adf3d6b6efd3b3e0c4a6cfb8a1d8bfa6c7b3a1dbc2aae3c8add6bea6d5bda6cab6a4cfbaa8d2bcaac6b5a7b9aea3b1a9a2a4a29f97989aa9a5a29f9fa1959a9f8d959d8b949e86919d808b976e7c8b6272826f79855f6f7e5d6e7f576a7a566a7b576b7d586c7d576369535c6136495733465532465534495a3044543146572f44552c425232485a3146573147592f43533046583045562e425331485a304455314557354b5f324758334859395064354a5b354a5c364b5c374d5d3c5164;
   16'h0104:packed_init=18432'hb8a088cbad8ebca288a49484a19184ae9d8eb4a495b2a79da8a39c9c9b9997989a93959890959990969b91989c90979d8a939a818b9379848e73808c6f7d8b6b7b896475835c6f7d586c7b5468785367775166765266764e63734e637350667751697a51697a536a7b556d7e566c7d586d7e5f75866e8293748899798b9b788b9b798b9c7a8d9d7d8f9d7e8e9d7c8d9c7d8d9c7a8c9b7c8c9c7c8c9b808f9c808f9b818f9c828f9b8b97a1909aa38d99a38997a38494a181929f8292a17f909f7e8e9d6f808f4a5b674a5d6b4155643f53613f54653d5061485d6c3b4f5d3143502a3b472e414d32445030414c31444f2f424c3c515a2e414e485c6c60768755697834444623333d21313ac4a98bbca3889387787b766e70706c656868626668656b6e61676a60676961676a60666a60676c5f676c5d656c58606758636a58616957616a5b667057616a5c67705f6870656b716e71747d7b7993887fb49e89c9ad8fc3a98ed4b595c8ab8cdcbc97e9c8a1eacba9d2bba4c2af9fb4a79ba69f999c9a979a9a999c9c9c95989b8f93978d9399868e96838d95838e9787919a87919a86919b86919c7a87926f7e8a6677856173815b6e7d566977556877556878546879526878506677526779506677506777556a7a5b71816a7d8d718595768a99768a9a788b9b768897798b9a798b9b7a8c9a7c8c9a7f8f9c8594a08694a08493a08695a18b97a28b97a18e979f89929c89949d84909b7a89977687967789987386957385956f82926b7e8d70849575899a6c7f8e7084964a5d6a475b6b3a4f5e364b5a3245533b50603042503c526131445224343f2c3e48324651293a4525353f2e404c2f414d374b56495f6d5f74864a5a5b25353a9788768e827479756d70706c696b6a656868666a6b63686a676a6b696d6d676a6b6a6d6e6a6c6e666b6c666a6c5f646961686d5f656a62676d646a6f6a6e727274767e7d7c8f8882998e8391898086807b86817c8e857db89f86bca78fd8bda0d0b89fc2af9bb7a798b9a99baba198a69f99a39e999f9c9a9496988e93978b9196828b937a858e7c8791798691707e8a71818e6f7e8c72828f7282907685937485927788967486966d81926b7f8f6c80906d83966b7d8c5f7280556b7b556a7a5a6f80677b8b6d81916c80906a7e8e697d8c657989677b8b66798a697c8c6d7f8e71818f7786937887937b89937b899474849075859276869478879470808f72818e70808c6d7e8c7686936d808f657888687c8b687c8c657a89687c8c667b8c647889657a8c677d8e6b8193697f906f85994e626e3b4e5b465868384c5c304251344857384c5b3245522635412b3d462c3e4326353f2c3d4722313c33484e2d3f4c465a6b4e62745b6d7a81796e7d776d6c6d6a6769696668686a6d6c6f6f6d70706d74726e76736e77756f7e7a747a777177746f73736f6e6f6d717373727170827d788a847c91877e9c8e81968b7f817e7a7878777b7976a29381beaa94d8bea1cbb49dc2ae9abba998b2a396b1a499aca298a59d95a29c979a9795959594939496898e92828a9179838c727e896f7c886977856776846272806373806576856071805e707f6274846375856074845e72825c71825e7484607787637889677b8d6a7e917184957487977587967386937082906f82916c7f8e6477866375855e71806577866878856d7c8874808a717e886e7c866a79856778856475836172815f71806172816174845d6f7f566a7a586b7a53687953697a556a7a53687952687953697a53697a546b7c586e81576c805a70825e738761778a637a8d657b8f6a80955e7585394c5933485432455335484e384c5b2a3a4523323c25333d24353b23323c2839412735422738452c3f4e405466475c6c73716a6f6e69666867686a69686a696c6c6a72716c7a776f8b8277988979a28f7a9b8c7b9185789085788d8276988b7da39383b29e88aa9784998c7f8e867d7c7974797671898075c2ad94d0b79ccdb59dc5b09cbba998b7a797bbaa9abdab9bb5a699aea399ada399a59d97959391919292898c8f7c838a7881896e79826e7b86697784606f7c5d6d7b5d6d7b5b6b795869785a6b7a566876556878556778556879546878536877566a7a586b7b5b6e7f6378886b7f906f849573879772869674879673869572839074849174828d707e8a6d7c876b7984717e87798288777e84707a816d78816775815e6f7c586a79596c7b576a7a5569795367785267775066764c62734a60724a5e71465c6d445a6b455b6c465b6c475d6f475c6e485e704a61744c64764f667953697c576c805870835c72855f768960778b5267775d7588485c673d50593647503e51522f424e2f42492b3b3f2e3f412b3b4127383f22333e20313b293b48293d4c6868646869656869666d6c686f6e687b766e877f739084759c8d7ca18f7cbaa288c5aa8ccdb191d4b691e4c49aecd0a8e1c29ccaae8ecbb191bea88fcfb698dabfa1d5bba1c5b09ab1a2939d958c9890899e958c9d968daa9e94a99f95a199918d8c8a8d8d8b8a8b8c8b8d8e8b8d8f848a8e7c848c747e876c788267737e616f7a5e6e7c5c6c7a5262705567775466755162705263724f61704e61704d6070506373506372536777576b7a5d7081667a8b667b8a657a8a687c8c687b8b6a7c8c6c7e8c7283917e8c97828f9a85929c8a92989294949b9792918f8a818587797f826f76795866715a68725868755265744f63724d61714b60714a5f70485d6e465b6d475c6e4356684156683f56683e54663f55673f55673d53643e556740576a42586a435a6d465d70475f714c63754f6679536b7e566d815b72855e748761788c647b90637a8d61798d46585e3a4d5035484d2a3b423e4e4a31424621313a1f2d3720303a25384420313c6969646c6c67726f697a756c83796d948675a6917aad967dc2a686c7aa88d6b690e4c399eaca9ef6daafebcca6d8be9dc7b29ab9a895aea090b0a193a69b8e9e958b9e958da0978e97918b8b88857d7f7f7d7f808585847c7e7e6f7479787d81767d827f8589717a816670796a757f727c866c788367748065727d62707e5b697652606c5666755768774f5f6d5364735062714c5d6c5266774c5e6d4e61704f6170536674596c7b5d70806073825f7281607281647785657887687a886f7f8c7e8b95838d968a939a9da0a2a5a4a4a9a7a5b4aea8b6afa8aaa2997a7e7d;
   16'h0105:packed_init=18432'h3a49553b4a543d4b563f4d5845525b4f5c6654636a4c5961505e6757646e3c41443e434644494c484d4e55595b5a5b5766625a877a669a876dccac84b49c829b8974ad9a85988e83938c848b868182807e7a7b7c787a7c6f73786d7378697179666f7766717a657079646f79646f7a64717c64717c65727d67737e6975806d78836f7a86727d8776818a77808977808a78818a80878f82888f83898f858a90868b918c8f929e99959b97948f9295888e95868f987b87927b889479889475849170808d78869278838e828a8f919497979a9d92989d8e979e87929b87939c86939d84929d82919e83929f82929f7f919f7b8c9c7183916b7d8d677a8a647a8b6377895d71825a6e80586e8053677951687a4a5f71475c6d475c6e465b6d475d6f4a60744b62754c62754d63764c61744e637652697c546d80566e81566c7e50667241545e3a4c593e515f364954394c59384b583748533c4d5a37495533445131414c2e3d4734434d2d3b453e5160354450303f4937485540505c39474f4657653b4952404d5742505a3c43463d4447474b4e4e51505e5f5967645c9c886e8c7a61c9aa86b399759a8a768e867e84817d81807d7c7b7a7677786f73766a7177666d74626b73606a725f69735d68735c68735d69755e6b775f6c795f6c795d6a765e6b765e6c78616e7b64717e67737f6875806e79846d77826f7880727a82757d847c818883888c8e8c8d9793908f8e8d84888d79828a758089707d8972818e71808d6e7d8a75838f7b8692868f9792969b9a9b9e9b9da0959a9e93999d8f979d87929a86929b818f9a7a8a977486937384936f82916e82917084957084957286977387987285986a7e8f677d906176886277895e7385576b7c556c7f4e63754b6173495d6f485d6f4c61744f64775065785065795066794e63754e647750657950677a53697e546b7f587083597184566e7e4b616c3b4e5a41555f40546035475532435135475433444d2e3d473c4d4f2e3d482c3a452f404d374a582f3f4b2e3d492b394334455034434b31404b32414c32404b41464943494b52575567665d6c675ea08d71cead86c0a78aac9a828b827a7d7a76797a787576777275786e7275676c71636b72616a725d68705c67715a66715966715865705966725a67745867745967755a67755b69755c68755d69765f6b77626f7a67727d68737c6b747c6e767d73798074797d8181849d948ca298909d9792878a8e7a8087737d866d79846b79846d7b88707e8b7885907e88928c92988d93988e949a92979b8d949a808b9576849072828f7283907282906f808f7384927183926b7e8e677c8c657a8b63798a62788a617789667b8e6a80926c82956f849671869973899c758a9d6e83955f74855d7283596d7f54697a50647551657752677953687a566a7d5a70835a6f82586d7f556a7d53687b556c7f546c80546c80546e825a72855d758760788c5d758752687540525f3c4e5c2c3b473243503b4e5834464f2a39403c4e4e2f404626333d2c3b473144522b3b4627353e2b3a442e3d48303e452f3f482c3a43474c4c505451766f5e797267a18d70d4b690b29d869c8e7f837e767776747071726e72746b7073676d72636a7060686f5e68705b67705a657059657057646f5865715866735664715663705663725665725966725b68735e6b76606c76636d776b727a6e747b72767b797b7d83817e9e9186b8a38fa79a8f8f8b88818588767d84727b83707b846c77806b757f78838c7b838a8a90968a9198868f96838c947f8a937a869077859072818e6d7f8c68798864778562758462758462768562788863788863798a6177896078895e75885f768861788a63788d677d90697f92697f916d81946b81936b81946c82966f869a70879b6e8496718698667a896b7e8f6478896074855d71815f71836275876174866175875f75885c72855a7183576f8252697c546a7c576e81566d805a70835a6f805266754d63734255614b606f3647514859593a48492f3e4132414429383c25333a2b3c462f414c32445125333d2b3c4827353f2d3f4c25343d716b5a6f6b5e877c6ac7ab7ed6b794ae9b8490867a7a77706f706e6d7072686c70666c70646a7062696f5e686f5c666e5a656e59646e58657056647056637157657157636f5764715765725764705965715d6874616a74666e766b70757376787a797a837e7a97897ebea48cbfa791a59688928a83828284787b7f70777e6f777f6f767c72787d8285888e8f928a8f94868d937c868f78838c76838d717e896b7a866877856676846273835e71805b6e7d596d7c586c7b556a7a566c7c576c7d596e80586f805b72845e74875e748660798b627a8d637b8d62788b61778b63788a677d8f687e916c81936f8698728799798d9e7e91a28294a58799a8899ba98797a68394a36e7f8d687a896d7e8d5f71815a6d7d5f7384607586596e7e596e7e5065744a5f6f4a5f704e64754f64765167794f6577516677465a693f536137484f40535e4659644f5f6133414633414442535542514e3140422a394133455326364022313b21313b283a47796f5c938266c9ac85d9ba98a99681847d7274736e6c6d6d64676a64696c636a6f61676e60686f5e666e5a646c58646d58636c57636e58647154616d53606c54606c56626f5865715a66725c67725c6771646b746c7074787676867d76978779ac9784b19c87b09b86ac9987968b8285817d7f7f7e7d7f80777a7d797c7f989592afa7a0a1a0a094979a8b9195838b927e88907a858f75818c717f8b6d7c896776846575845e707f5b6e7e576a79576b7b546878526776516676516777516879516777546a7a556b7d556b7d566d7e5b72845b728361778963798c697e8f6f839573889a74899b778a9b778a9c7a8d9e7c8e9f788c9c798d9d7e8e9e8292a17f8f9e82919f8393a18897a58a98a58694a07e8d98788793768794798b996678865c707f5367784b6070475c6c4a6070475b6a4b61714357674054643447553b4e5c31434f344753324450415257435663506061495d69687b884e5d5a39484e2a3a412b3d4823323e1d2c36c4a98accaf8fc8ad8b9c8d7b7b766d73737066686a60646763686c62696d5e656b5e666b5f676e5c656c5a636b5a646d59636c55606855606a545f6956626e56626e57626c58626b5b646d6168706b6f74787675908378b19983caad8dc2a689;
   16'h0106:packed_init=18432'h7b8e9d8193a38495a58697a68c9caa92a0ae92a2af93a2af94a1ae8b98a48c98a28b98a38b98a385949f818e9873808b707e88707d8877838d8b949c87919b7b89937e8c967f8b95808b96848e967e878f848e96858e96828b92848f96858e958c9194999a9b98989a8b92987d899376838f75828e6e7c8865717d5e6b765f6c775d6a78626f7d616e7b62707d616e7c65748362717e637280637280a48a70ac8f74b9997ac5a27ecba782d4af87eac394f2d0a2f7deb6fce8c2fbe6bff8e0baf7dbb2f7d9b0f8d9aefbdeb0fde4b8fde4b7fde5b9fde3b8fce5bbfeeac6fde9c2f8e1b8eed1a9e4c4a0debe9cd3b79bc1aa95b7a594a99d939f958e98928d95918d8e8e8c8c8d8e878a8d82878d80868d7e858d768088747e886e7a856a788469788663728061717e6273826273825f70816073836275856476876072836174845e71825f7283576c7d5b70815d73855c71825970825a70815c72845c73845d738560768964788a657a8b6a7e90697e906f839470849576899b76899b7c8fa08394a48294a58395a58798a68998a67787936e7e8a6a7b886c7b886978846c7983767f84737e8676818a737f8869788264727d64727a6572796470776470766d797e6d777b6a747b6a747b6e78806d767e707980707981767e847e82848585848684847d80827f84888a8f958e939887919b8592a07e8c9a73808d6c78836d7b886b79866d7c897e7063827365947e6b9a836ea48b72bb9d7ebb9d7eba9a7bba9a7ac5a380caa783d5b18be1bd92eec99cf8d6a6fde1b2fee8bbfde5b7fbd9a9f1cda0eecba0e4c19ad7b793cbae90c9af96c4ac95bba793b1a293a89c91a198909b95909593908f8f8e898a8d7e82877b8189767f87757e8876818a748089707c876d7a86667582606f7d6171805f707f5c6c7c596c7b586b7b576a7a586a7b5c6f7f5c6e7f5d71825c71815b7182586d7d576b7d566a7b556a7b566b7d546b7c576d7f596f81596f81586e805b72835f7587657a8d687d8f6a7e916980926c82946e829572869873889974879976889b778a9b7a8c9d788b9d76899a6e808f687a895f727f5e707d62727d64737d66737d66727b5d6b7457667059687255656f54646e53646f55656d55626b57656d57656c56636a58656e5b666e5d6972647078646f786b777f737b8371797f767c80818281a2998dc4b29ed5c0aadac7b3bfb7b0aeacab9aa0a68d99a290989f7f8d9967625c69645d756b60887a6b8e7e6e8d7c6c8f7e6d95816f9783709b8672a38c74b19479c6a582d9b58be8c396ecc798e9c394e5bf92dbb78ec9aa89c4a78bc5a98ec6ad94baa693ae9e90a5998e9d948d98928d9794909694918f8f8e85878a81848880868a7f858a79828a6e788169747f6a768168748067747f5f6d7b61707e6272815c6d7c576776586979556777566878566878576a7a596b7b596b7c5b6e7f596d7d5b70815e71845d71815c70815b70815b70805f74846074855e738361758565798a697d8e6b7e8f6b7f8f6b7f8f6e82936e81936f82947185967184957084967083956d82936d81936b8193697f916a80916d82946d83956c829565798a5d707e5a6c785b6b765164705264724a5c684c5d69495b674d5d684b59624a5a664858634957614a5a6444535d4757604c5b644d5c66515f6853606a5966705a677165707a6f7a83747e877e868d818689898a8a969491b7ab9eddc9b5efdfccede0d2dcd4cbcbc8c555555557575675716a68655f69645d6f6961756c63776d627f7367897b6c9c8975ab9379bea07fdcb98fd7b58cceae8ac8aa89b89e82b79d83ab957fb9a490b4a292ae9f90a89c909e968e97928c918f8d8b8b8d888a8c82868a8085897f868c788088727a81737c85757f88727d866a758068768164707c626f7c6371805c6b795c6b7a5d6d7d5f6f7f5b6b7b5869785767765b6c7c5a6b7a596a7a5b6d7d5f71815d70805b6e7f5768785d6f7f6275856678886b7e8d7485937686957989967988967686947787947484937081907181917284937284946f82936e82926d8091687d8e677b8d657a8c6277885d72835c7182596e80586d7f586f815a70835a71855a72865b6f7e5b7183546571495b6a4c606e465967475966465a6743546044566140525e43556140515b44555d3e4f593d4d5741515b42505a4655604a59624a57614d5a65515f6a5966725f6b7564707a6f7a8477818a808990868b8d9195979ea1a2a6aaabafb2b3595c5e5d60625456565555555c5c595f5f5b615f5a69645d736c62867a6ba89178b39a7ecaab89c3a787b49c82a08d7a9e8c79ae9983b9a592aa9c8ea4998d99918a918c888c8a878a898a8b8c8e888b8e878b8f7f858b798188768088737d866f7983717c87767f896f7a846e77816c76806d788368747f64727d616f7b63717e5e6e7c5e6c7965748164738066758268768465748263727f606f7e5d6d7b63738160707f6373826476856879886e7e8d7484927b8b9888939c939ba1949ba18d949c828e98818d977e8b967a87937686937283917182916b7e8f687a8b667b8a6478896174865d7284596f81556a7b5167784f65765065774f64774e63764e6577506679546b7e566e815a70835a71834d606d4b5f6b435662415360405260465866495a643e505c3c4e5b3c4e5b3e505b3747523f515d3a4a543847523d4d583f4e5842525f45535e45545f4c5c684c5a654a576158646e626d7669747e646d756a747c727d866e78814e5356494e51494d4f4b4e5050535557575562615b6661597e73659b8a72b79c7ec1a487ab957e998a79a1907cad9c89a09489948c848f8a848b87828180807b7d80767a7e73797f747c82747b84788088757e876f78826c7680717b85757f8977818a79828d7a838d7d868f7e88917f88917d868e767f87727c856d778067727c6a757f646f7a6b76806f798281878d82898f80878f7b838c747f89727e897d8a9573818d70808e6f7f8c6f7f8d71808c76838d858e968e949a88929a828e98808d9982909a86929c84909a808d987b8a967786937282916d7f8f6a7d8c65798a5f73835d7283586c7e5266784e63744a5f714b61734a5f70495f71495e70485f704b62734c617350677951677b546a7d536a7d516776556b7c4a5d693e505d3c4f5c3c505e4155623749563b4e5c384b573b4e5a37475141546041535c384a553a4c593a4b5836444f415160;
   16'h0107:packed_init=18432'hdbbfa3d8bea4dac0a7dcc2a9dcc3aae1c8afddc5aedbc5aed7c1aed1bfaecbbaacc4b7abbfb3a9c3b7acbbb1aab5afa9bbb3abb8b1acafacaaa7a8a8a4a6a8a4a7a99fa4a89ea3a9a0a5aba3a7aca3a8aca4a8aba4a9acacadaeadafb1a9adb2a2aab196a2ac8f9caa8999a78697a78598a88799aa869aac8499ac8298ab8397ab8297aa8297ab8398ac8297aa869aae879caf7f95a98096a8778fa27a90a5758c9d708697708596677b8b5365725567754a596441505d4859664a5a674b5a5f4656613e4f5d3b4c59394a573d515a394a573f515d475a683948553b4c593a4d5a394c5b3344523042503346563547563343513544523a4b5a3a4b5b3646523a4a573c4c5b425362495a6a4f61724a5a694d5d6c5263725465744b51574c53594f565a52595f50575c4f5458565b60595c6060646765676964646469666378726e7b746e83796f8a7d71988472c0a280dcb78ce8c394f0cfa0f8daadf6d7b0f4d4aef1d2afe7c8a8dfc2a5cfb8a1d3bba4d6bea5cdb8a4d1bba7e1c9b0dcc4accab8a6ccbaa9c3b5a8b4aaa1a8a39eaba6a1a7a4a29c9d9e9d9d9fa1a1a39b9da09a9ea2969ca0989da19ca1a5a0a4a8a0a3a7a0a3a8a3a6a9a5a7aaabaaaaa6a8aba1a6ab9ea4aba0a6ada2a9b1a0a8b19ca7b197a4b196a4b097a5b195a4b298a8b599a7b697a6b697a7b697a8b797a7b797a7b794a5b595a6b693a5b690a3b490a2b48da0b2899eb0859bad849aad849aad8299ad758896768b9b7d91a2707f88616e78525f694e5c67505f6a5364694b5e654d60684a5c654e5f6551636f5969775d6b753b4c583f516035455231414e384a5a344554354756374958384958384a583647543b4d5c4356684456684c5d6d53657750617150606e5464735768775869795859585757585b5c5d5e61635a5b5b5f5f5f686766726f6b736d687971679082759c8876958371b0957ad4af85eac99df4d7aaeccba1e1c29dd5b695caaf92c8ad92b7a18bd2b69ad2b69ba99b8eb7a595a99e93b2a497a29a92a39991bcac9ec0b0a1c4b2a2bbada1ada59d9e9c9897979897979898999a999a9c9a9b9e999b9d999a9d98999b9a9b9d9a9a9c9d9d9ea4a2a1a9a6a4b0aaa7b5aea8bcb3abc3b8afc0b5aebfb7b0c0b7b1bfb9b3bab6b3b6b5b6b2b4b7b2b5bab1b5baaab1b7abb2b8afb4bbb4b9beb0b8bfb1b9c0b3bac1b2bac3b1bac3b1bac3b4bcc3b1b9c2aeb8c1aab5c0a7b4c1a3b2bf9cadbc99abbb96a8b895a7b794a7b790a4b58ca0b1889daf8599aa8194a68194a67c91a37f93a68195a78699ab869aac8497a98499ac8095a87f94a4798c9d5b656a3f4d5a3c4c5a435464354654314350394c5c394b5b3d4f5f4156673b4c5b3c4d5c40515e4b5c6b50617156677671829276889a7687987486986f8294726c67726c66777169766d667b716882776c988776a38d77ae947ac2a282d1ad88e7c295e9c79cd4b593c4a78cbaa087b39b85b19b85a59383a493849d8f83a3968a998e85978e86928c86918b86908c88928e8b928e8b9f9890afa297aea3999c98949c99959b98949a98949c99959e9b97a19e9aa39e9aa49f9aa7a19caea59fb7aaa0c0b0a2c4b2a3ccb8a4d1bba6ddc8afe8d0b4e3cbb2cebdabbdb2a9b2aca8aeaba9a8a9aba6aaaea7abb0a8adb2afb1b6adb1b5b6b8babababcc1c0bfc8c4c2cdc8c4c7c5c3c3c3c3c1c1c2bec0c3b9bec2b3b9bfaeb6bdafb6bdaeb5bdb0b7beb2b9c0b3bac0b3bac1b2bac1b0b9c1b2bbc4b3bac3b3bac2b4bbc2b0b9c1aab4bea4afb992a2b18e9fae8c9eaf8a9cad8a9daf8a9dae899cad879aab889cae879bad889caf899db0899db0899bab8093a461717f4d5e64596b7b5367774757643f4e5a4c5c69596b797a8da07c8fa28596a88293a48193a38595a68191a37f90a28494a57f90a1b89d82b3997fb2987eb1967cb3977cbc9e80c9a785dab68ee4c096debb96ccad8eba9f87ae9781a8937fa6927fa996839f8f7fa08f81a49384a29384a193879b8f85998f86978d86958c85958d86968c85999088a4988dab9f93a599909d96909c96909d96909f9790a19790a3988ea99c91afa095b6a597bba897c7b09acbb39dcbb5a0bdae9fb3a69bb0a59ca39d9999989895979892969a8f959c93989e8c959e87929c86929d8a96a18c98a395a0aa95a0aa99a2aa9ca4aba9adb0afb1b2a6abafa0a7aea0a9afa3abb2a1aab3a2abb4a6afb7a8b1b9abb3baadb4bbadb3b9a8b0b8a8afb7a6aeb6a7afb7a0a9b2a6afb6a9b0b6a7aeb5adb2b7a8afb4adb2b8abb0b6a4adb49ea9b198a5b098a6b29eaab59eaab69daab69eaab69da9b599a6b38f9ead889aa98496a67d90a07d8fa17b8c9e7a8c9c788a9b7487997587987384947081906d7f8f7083947284957385977284957384957485957586967d8ea08090a18595a68192a4f0cea6f1cfa6f5d4abf5d4a9f3d0a5e6c29ad5b48fd2b18ec4a587b89e83b49b82b79d85bba188bfa48ac2a68cc0a48ac7a98ec6aa8ec5a88dbea48cb8a18db4a08eb5a08eb6a18fb7a290bfa893cfb399d1b49acdb39ac9b199bca895bba795c3ac97ceb49bd7ba9edabda0d7bb9fc8b29cb3a395a39a929a959093908e8f8f918c8f928b8f93888e94868c93878f97828d96818d97828e99828f9a818d9a808d9a83919e8492a08b98a4909ba6909ba6929da796a0aa99a2ab96a1aa8f9ca68d9ba78d9ba98f9dab93a0ac94a2ae97a4b09ba7b29ba6b29ea9b39da8b39aa6b29ba7b2929fab909eaa8f9ba88997a38b98a38d99a38a959f8b96a0909aa297a0a79ea5aaa5aaafa3aaaf9ea8af9da7b09ca6ae9aa4ad9aa4ad9aa4ad99a4ad9ea6aea4aaafa5a9af9ba4ac909ba68a98a68797a58b9aa78495a5798a9a7081906b7c8a6675836878866576855d6d7b5c6c7a5f6f7d6171806171816576866a7a8a6e7f8f6b7c8c6c7d8df5d6abf6d5a8fbdbaafee6b9fde8c0fbe6bef7d9aeedcba3e3c09ae1bf9ae3c39edfbf9bdebc98e2bf9ae4c19ae5c299e7c49be5c39be3c199e1c09ae4c39ee7c6a2edcca6f3d3abf5d7adf9ddb3fbe3bbfde7c0fadfb8edcea9dfc1a2d2b99fc3ae99b3a393a69a90a298909b95919492908e8e8f878a8e84888d80868c7b838b79828c75808a75818c72808b73818e75838f71818f7182907484937282907182917686957788967586957586957283927284926e80906e81906e8191798b9b76899a788b9b7a8c9d798a9c7c8e9e;
   16'h0108:packed_init=18432'h7181907382917f8c9b8e9aa8a2aab6b5b7c0d0c9cbebdfdbf2e2def0e0dde2d3d4d4c8cecac1cabbb8c4aeaebdd2b69ccdb298bea892b29f8da89889a19387988e859189828b868284817f807f7f7d7d7f797b7e72767a70757b6e747b656e77636d76616c76616d7964707b65727e636f7b626e7b616e7b626f7d6472816573816876846977856b78866b78866f7b87707b88707b886c79876a78876a79886a79896a7a8a6b7b8b6b7c8c6d7e8e6b7d8e6c7e906d7f916c80936e80946e82966f839870849670839671849773869976899a798b9a7a8c9d7d8f9e7685927e8d9b7485916e7d896a7984677682687783667581616e7959666f5b68714f5c674d5b65505f6c4e5e674756614c5c67445560404f5a42525c3f4e593747513f505a4354623747533c4c5836455134444f31404b303f4b2f3e492f3e4a30414c34444f35454f3949543b4c583a4b55394a553c4d583c4a553c4b564757625364715c6c7b5a6a795767755b6b7a5f6f7e6d7c8b7686967989997d8b9b84919f8e98a6a0a6b3bbb8c1d7cbcef1e1dcfdf3ebfdf6f0f8ebe8e6d9de978c81958a818e877f89827c837f7a7e7b797b7a7a797a7b7374787073776c7075696e7461686f5f676f5e666f5d666e5a646e5b66705c68735e6a765f6a765d68745d68735d69755e69755f6b78626c7868727e6a76816a75806d7782767e88798189768089717d886e7a876f7b89707d8b717d8b73808e74819073829175849276859475859575869776879875879976889b778a9b788a9c78899c788a9b7a8c9d7d8e9e8091a18192a28493a28694a48897a58a99a88a99a6818e9984919d6d7982737e8778848d7d88927a848a737c826570735361694f5d68505f6b49596546566244555f41505b42515b45545d3848533c4b543c4d543a4a5034434d303e492e3c472f3d4832434f2f3f4b2c3c492f3f4b32424e2d3b462d3c472f3f4a2e3e4a32414c3c4b563c4b57404f5b4556634455623f505d3949553d4d594656635465745162705f70816575846f7f8f7988998794a4909aa89ca2afb3b1bbcac1c9d8cbd1e3d5d9e5dade7a79787878787576776f71746b6e72666a6f676d73676d7362686f61686f5a626a565e67555e6757616a576169545f6955606958626c5a646f5c66715c66705a646d59636d5b656e5c646d60697369727c69717a6b727b70767f84858883868b7f848a7b838a7b828b7c838c7b838d7c86907e8892808a94818c97818b97808c98818e9c818e9c808e9c7f8e9d81909f8391a18493a18593a28594a38594a38695a38a99a68d9ba98f9ca9939fab97a2ac98a3ac9ba5ae9fa7b0a4abb2a4abb2a1a8aea5aaafa2a6aa979c9e767f877680887b868e636f75606e7957667052626b5968704f5f6a4a5b6443545e42536140505d3e4f5c41515e3d4c563c4b5336454e2f3d4931414c31414e3545532d3e4b31424e2d3d482a39442b3a442d3d4731424d3546513c4d5a40525f3c4c593b4c5935445032414e3747533849553a4a563a4a573f4f5b42515d4757645363735c6d7c667585758494818fa08c98a8969fafa2a7b6aaaebdaaaebd5c62665a60665a6167586066575f665d666f5f69725a646e5661695159614f575f4f5860505961525c66555f6958626b58616a59626c5b636c5c646b5d63695e646b5e646a61676e656a716b717772757972737777797b8e8a87928e8c8b8a8c86878b888a8e898b908a8e928b8e948d919691939895979d959a9f9399a0949ba2939aa38f97a18f98a28f98a3919ba5939da8959fa896a0a997a1aa95a0aa96a0aa97a2ac95a0ab96a1ab9ba4ad98a2ac98a3ac9aa4ae9ea6aea3aab1abb1b6b0b5baafb5bbacb4bca6aeb77b848879848a78848b67747f65737c58667054636f52626e4859665365734d5d6954656e4f606d3f4f5b3f4f5b3f4e5a44535c43535b3f4f5637455133424e33445134465535475630404d2b3a462d3c4731414e3747553748563b4d5b35445036455136475532424f33434f313f4c31404c3544503b4b594152624758674758664a5b6a4e5f6f596b7c637485647485657483728191738192818fa18a99aa525b6150595f555f69525b644e575f515b64505a644c555e4b535c4a525b4b545d4d545d505861545c645a636b5c636a5d646c60666d62666c65666967686a69686a6b6c6d737272777676807a77837c76877f79a89a8ea69b919a938e9994909d97949f9996a09b989e9b99a09c9ba29f9ea5a2a0a7a4a3a8a6a5a7a7a8a5a5a8a0a3a79fa3a8a1a6aaa4a8aba9aaaea9acafadaeb1aaadb0a7abb0a2a8ae9ea6ad9aa3ac97a1aa95a0aa95a0ab9aa5ae949faa919da9909eaa92a0ab97a3ae91a0ac8c9dac90a1b092a4b28d9faf8d9faf90a1b08394a171808768778257677153636e52637055677450626f4b5c6a5365715668774b5e6d42525e41515d4657634b5c684d5e6b455563364755344553374857344654324351334453394a57384855384956394a5831404c30404c3648552e3d4a30404d35455332424f3849583748573b4c5a3e4e5d4355644c5d6c4e60704f60714c5d6c4e5d6c50606f5362725c6c7c6170806776874b535b4b545c4e58614e58624e58614a51594a535b4b545c4b535b4951584d555d535a61555c63585e645a5e6364676c6d6f72727171766f697b736b877b718379708d8075938478a18e7cbba186b8a088bfa994b8a594b4a395b7a698baaa9cb8a99dbbac9fb6aa9fbbaea3bbaea5bdb1a9bab0a8b9b1a9bcb3adbdb3adbcb3aeb5afabb1adabafaeacb0aeadb4b1afb4b3b1b1b1b2aeafb1acaeb1acaeb2aaacb1acadb0abadb0a9acafa8abb0a1a7af9fa7af9ea7b09ca6b196a3af8d9caa8596a77f94a67b91a57b90a57e93a68296a98196a98297aa8298ac8498a97c90a08398aa5d6f7b6b819367798761737f5567735b6d7c5769775264734758664656633f4f5c4455624e5c654d5d69445462344654374856374a58384a56374855384956384a583546533c4c5835444f2c3a472c3c48344553384a5a384b5b394b5a3749583b4d5c40546443566744576744556640515f40505e3f4e5c43526047566449586651606e5968784e555c4d555c4e575f4d555d4c555c4d545c4e555b4e555c50575d545a6053585c5a5e635f62676262646a686675726d83787081766b908071a8917ab1957abb9d80d8b48ae2bd8eeac9a2e0c2a1dfc2a4;
   16'h0109:packed_init=18432'ha9a5a1b0a9a0baaea3c8b7a6d6bfa8e7cbadf5dab6fbe4c1f4e0c2e5cfb6d5c3afcbbbabc0b4a8b8aea4b5ada5a5a5a2a0a4a69da3a89ba4ab98a3ac97a3ad8d9ba98b9baa8698a88295a77d92a37d90a37a8fa2798da1788c9f7386977082936c7f8f6576856071805b6a7a5c6c7b5e6e7d5d6e7d5363715668764d5d6a4b5c6a5262705061715264744b5e6e4c5e6e4d60714659694658674c5e6f4c5f6f475a6a4b5d6e5163755062735e676d626b726871786d757c71787e767c827b8185838689898888918d89968e879d9288a4978baf9d8dbfa893cfb49adebfa0ebcaa5f3d4aff8debaf7dab7ebcfb1d5bda8c7b4a3c4b2a2bdaea3c4b3a6bdb1a8aea8a3aaa6a49a9b9e898e9482888f828a938c949d9098a187909b848f9a848e99848e9889929b8c939a94999f999da194999e8d939b8991998b929a8b929a889199879099858e98848e97858f99848e98848f99848e99848f998690998c959d8d949a91969a989a9aa6a29eb8aca0cfb9a3eacfaffae7c5f9e3c1e3cbafcebca9c7b8a8bdb3a8b2ada5a6a5a29ea2a3989da191999f8a949b838f997d8b977c8b997c8d9a7e8e9d8292a18999a88d9dac8798a87d8e9e7889997a8b9c7e90a07d8e9e7d8f9f7d8e9e7d8e9e7a8c9d788a9a7788997283937082926e7f90677888697a8a6475846273845e6f7f6072836275855f7283596b7c5263734e60704c5e6e4f62735466785568795a6d7f5c708460748853667771797e757d84808a91818a90848b8f8b8e91908f8e96918c9d958da5998ea8998bb2a090c3ab95d3b69ce4c5a5edcface9cdacdfc4a7d1b89fc5ae9abaa99abaaa9dada299a29b979d9896a29e9b91939693969b8c92988c949b8c949c8c959d8a939d87929c89939d8a949e87929d8c959e8c949d9199a28f97a09299a18c949c868f99818c96808b96808c977f8a967f8b967e89967f8a967e8b977d8a967b89957886937a88957a8794808b96838e98889198909499a09e9cb8aca1d1beaadac6add5c0aacebba7c8b8a7bcb1a3b2aba3a8a6a29da09f999ea0949ca1919ba28c98a287949f81909d7c8d9a7b8b9a788b9a7689997385967386967386977487987a8d9c7e909f7c8d9c798a9a7586957a8b9a7786957a89997e8d9b808f9e808f9d8492a0808e9c818f9e8493a38090a17e8e9e7c8c9c79899a798a9c788a9b7587997284967081937083966e80936576865c6e7f56667655657453637255677853657457687957697b7f878c81888d8c9295919497989999a4a19eb3a89fcab6a2e7cdadebcba8f7d9b1f9dfbbefd2afd9bb9dc6ac95baa696b1a195aa9d919f958d9b948e94908d8e8c8d8c8d8f898c90868a9082898f838a937c858e76818c7683907987957e8b98818f9b85919d828f9a89939d8e969f8b949e808c9786909b7e8a967c89957784927482907483927181906f808f6e808f6e7f906f80907282907785947887947a88957b88957e8a95818c968790978d939896999a9b9c9b9698999093949899989b9b99989b99999c9c999d9e9ba1a2979ea0949b9f8f999e828e977d8a9475848f73818e7383907788957586947284936d7f8f6c7f8f6b7f90657a8a627586617484647888687b8b6a7d8e6274846476855b6b795c6c796475826f7f8d6e7e8b7b8a9785929f8c97a38f9aa5919ca796a0ab98a2ae9ca7b398a3b0909eac8898a88c9aab8999a98293a58191a38091a27e90a38192a68393a57d8c9e6c7c8d637282606e7f5d6b7c5968788f8f8f929292a09d9ab1a89fc9b6a7ddc4abefd2b2fceac9fbe4c1eacaa5d3b597c4aa92b7a290ac9c8fa1958c9c948e98938e93908d91908f9090928f90938e90938a8e93878d94838b94838b95828b957d88937d8995808b97828d99848f9a818c9687909a808c96808b96818b967d899576839073819071808f7182916f7f8f6f80906b7d8d67798a687a8a687a8a687a8c687a8c6b7c8d6d7e8e6f808f7383927685947988957c89957d8a947e89937b87917a868f7b878f7b858c7a858c7882897a858d7a868e737f876e7a826f7c8678848e717e88717f8965737e5c6b775868745d6d7b61727f6172805d6f7d5c6e7d5768775769775567764f61704c5e6c4d5e6c5365735b6d7c6275855e70805c6e7d5d6e7d60717f60707e6372806372806e7c8973818e7b879487939f98a1ab9da5aea6acb6acb1b9aeb3bcaeb3beaab2bda3adbaa2adbba3aebca0acbc95a2b3909dae8c98aa8b96a78792a48692a48693a58491a479879adcc0a3e0c4a5eacaa7f5d7b1fceac7fdebccf0d2addfbf9ecdb095bda692ac9b8ca4978b999088908a858b87848988878585878284877f838781858b7e848a7b82887d848c7d858e7e87907a838e79848e7b86917c8792818b95778390717f8d6f7d8b7b859174818e717e8c6c7c8a6c7b8b6e7e8d6b7b8c6a7c8c69798a67788966798a66798b66798c667a8b687b8f6a7d916d80926f829472849571829374849373839172829074849371818e6e7e8a6f7d896f7c87707e896c7a8668778263717c62707a63707b5d6b7558656f55636d57646f55636d5b6b7656656f51606c4d5c674c5c674a59644e5e6a4b5b694454604959664a5c6a4758654557644456634253613d4e5a3948543d4e5a4253604557634a5b6750606d5b6b7a6677866c7d8c6f7f8e7382907282907987957c8b9a818e9b8894a18d99a68d99a5939ea9a3abb5b7b8bfc4c1c7c5c3c9c3c3ccc4c3ccbdbec9b4b7c2abaebcabadbaabadbca9adbc9da3b48e98aaf9dab3fbe0b9fbe7c4f0d3b0ddbe9fd0b49ac0a892b3a08fa8988b9e9389978e87918b878d8a878988878483847a7d81777a7f72787f6f777f6b737d69737d6b757f6f79836a75806e7985697581707c886c7a876e7b886d7b896776846978876b79886b79866c7a876a79876a798869798869798a69798968798a687a8b66788a65788b667a8d667b8e677b8f6a7c906c7f926d82956f82967083957385977587997688996d7d8b6c7c8b6d7e8b6f7e8b6d7c896e7d8a6979866b7a886a7a896474805c6b785766715b6974505e684f5e68505e684a58624a58634b5a6449586446556044535e44545f44546048596542525e3c4c5940515f425260394a553a4a5639495434455032414d31404c32424e38485439495443535f47576451626f5768775566734f606d536471596a7865758470808f798a99788897748494;
   16'h010a:packed_init=18432'h0000000000000000000000000000000000000000000000000000000000000000000000000000000000000000000000000000000000000000000000000000000000000000000000000000000000000000000000000000000000000000000000000000000000000000000000000000000000000000000000000000000000000000000000000000000000000000000000000000000000000000000000000000000000000000000000000000000000000000000000000000000000000000000000000000000000000000000000000000000000000000000000000000000000000000000000000000000000000000000000000000000000000000000000000000000000000000000000000000000000000000000000000000000000000000000000000000000000000000000000000000000000000000000000000000000000000000000000000000000000000000000000000000000000000000000000000000000000000000000000000000000000000000000000000000000000000000000000000000000000000000000000000000000000000000000000000000000000000000000000000000000000000000000000000000000000000000000000000000000000000000000000000000000000000000000000000000000000000000000000000000000000000000000000000000000000000000000000000000000000000000000000000000000000000000000000000000000000000000000000000000000000000000000000000000000000000000000000000000000000000000000000000000000000000000000000000000000000000000000000000000000000000000000000000000000000000000000000000000000000000000000000000000000000000000000000000000000000000000000000007476787578797f7e7d85827e8a8581908a839a8f859b8f84a59689b09d8db9a390bba38fc0a78fd6b696eac89feac69edcbb98caae92b39f8d9e9288918b858a88878183867a7f85737c856c7984687581677581606e7b5c6b795a6a795c6c7b5a6b7a5b6d7c5a6d7c54667556687756697a566979566a7b596d80596e805a6f83586f835a70855d72865f74885f74885e72855e738760758961768a62768a62768863778964798b64788b677a8c687b8c6b7d8e6e7e8d73828f7583907785907985917b88937e8a94838f9987929b889198888f948b90938e90929595929f9a94b0a69cbcad9eccb7a2dac2a8e3c7aae9ccade6caaae6c9abddc2a6e3c8adf2dcc0f7e3caefddc8e7d5c3e2d1c1e3d1c1d4c5b9cabdb3b2b0af9fa6ab949ea88b98a48694a38091a07e8f9f7a8d9e76889973869671849572889c7084976f849770869a71859972889c6d839664798c63788b667c906377886176876073846074845d71825d7081586d7e636a6e666c706f747775797c77787979787686827d9189819a8e84a49587b29d8bbea68fcdae90e1be97f9d6a9fee7bbfbdbade9c69dd7b796baa48fa0958b96908a8486877a8086757d85707b85727e8a6875816473815f6f7d5a6a78566674566876566776566776526473566878576a7a53667656697a596d7f596e825b70845c72865d728761768a62778a6276895f748562778a64788c66798c687b8d687b8d6b7d8f6c7e8f6d7e8f6e80907082917484937a88947d8a967f8a95808a93858e95878f97858c938a8f939093969497999c9b9ba4a09ba9a29ab2a498beae9dcdb6a0dac0a5eccfaef4d8b6f9debafde6c0fde7c2feebc8fdeac9f6ddbfebd4bce9d4beebd7c3cdc4bdb2b4b7a6adb396a2ad8c9ba78899a68d9ead8c9cab8093a37c8fa0738798748899768a9c7589996e819165788964798a697c8e6a7e9162748562748666798b66798b63788a6a8194647a8d596c7c5a6d7e5163714b5d6a5264734b5d6c465766565f665962695e676f62696f696e717678797e7e7c86827d9189819d9085ae9b89c5ac92dbbb99eecba3f8d8acfdeac2fadcb1e1c09ccdb195ab9b8d9b928b8c89878c8b8b858689797f85767e85727a836a747d68737e5f6c785d6b786372805f6f7d5a6b795666755869785868785b6c7c5a6c7c5d6f805c70815c70835e7385617589617487627486627384627384697b8b68798a6b7d8e6f7f8f6f80907182927283927786957988967a89977c8a96818d9887919a8a929b8d959c959a9e999c9f9d9e9ea2a09fa6a29eaaa29bb4a89ebcaea0c5b3a2cbb8a5d5c0ace4cbb0f4dab8fbe3bffdeac7fef2d4fef6ddfef1d5fbe6c4eed5b8e2cbb6cec1b3b3b0aea4a9ae9ba5ae93a2ae8d9fae8da0b0889cad8094a47486977081926d80906679886b7e8f6678895e7080596b7b5d6f7f596b7b5f7283586a7a5f73845c7081536574586a7b596b7c4f61715062724a5c6c4b5e6f4d6172495b6946566441515f3d4e5c46576742546250575e515960565f665b63695f666c63676b6d707377787a83817f8b868090867d9e9082baa38dd0b396d5b797d0b496bea68eb29f8da19489978f87948e898f8c8b8788898083878184878a8c8f8b8e92818890727d87717d887a889471808d6f7e8b6878865f6f7e61717f62728166768666778764758660728263758668798a6476876577866b7c8c6d7c8b6f7e8c7281907583917987947c88957d8996818d9886909b88919b8a939d8f97a08f969e93999e989ca19b9da29fa1a2a3a3a3a9a7a3b1aba5b9b0a7bbb1a7baaea3bdb1a4c9b9a8d7c1ace5ccb0f6debdfdebc9fdf1d5fae8cbf6dfc0efd7bbe0cbb6cfc1b4c3b9b0bfb9b4afb0b1a0a7ad939fa98c9aa78596a58498a98196a97c91a47a91a47a91a5758b9e7185977084966a7f9067798a5b6d7d50616e5161704e5e6b4d5f6c4e5e6c4a5b694757654d5e6c5466755567774d5f6f4c5d6d4759694a5c6d4e62744a5d6e455868455867465766485b6b3e4f5d3e4d5a515960535b6259636b5f687060686f676e736c7176707275787878807e7c918b85a09589b2a192b3a08fc0aa94bba692b6a391bda997baa898b6a698b2a497ada096b5a79eb5a99faea39baca49e9f9b988f90929b9c9f969a9f9298a08f98a2808b9575838f727f8b6f7c8775818e74818e6e7a886c7a876a78866f7b89707e8b7a8693828d98818b9688929b89929b87909a87909a87909a8b939c8f959d8d949d8d949c9499a094999f949aa0969ba194999e959a9e999da09b9d9f9ea09f;
   16'h0200:packed_init=18432'h677b8c64798b63798a63788a62778963778a5f75885d72865a7185577084576f84566e83556d82556d83556e83556f85546e84556d83566f84566e84566f84566e85556d83556d83576e84576d83576e82586d83596e835a6f855d72885d74895f768b5f758a61788d62788d62788d5e758a5d758b5a748b5a738a5972899a8a78a28f7cac947bbe9f7ee3c69afadcacecc99dddb88dd7b38cd1b08fc8ab8ec0a58bb69d83b8a087c2aa90e4cdacfbe2bef8dfbbf7dcb9f3dab7f4d8b5f7dcb7f9ddb7f7dbb5f6d9b4efd2aee8ccade2c9add8c1a8d2bda7d1bca6d0bba6cfbba5cfbaa4cebaa4ceb8a2cab6a1c5b3a0c0af9fbcad9eb6aa9eb2a79daea69caba49ca8a19aa6a09aa19f9b9f9d9a9b9a989898979798989395968f91948b8f928b8f92888e92838c908088907e888f7c868e79848e77838d73818c72808c6f7f8c6f7f8c6d7e8b6b7c8a687a89677988667888667a89667a8a667989677b8a657a8a5e75865b71845a70835a7184596f82586f82586e81586e81576d81556d80546d80546b80536b81526a80516b80526a81536b81506a7f4f697f50697e4f687e4f687e50687f5169804f697f536a80546a80546b81566c82556c81556b81566c81546c80566b81556b80576c81556c82566c82546b81546c82536b82536a8151698051697f50667ebca083e1c8a3fceccafeefcdfdedcafdecc7feeecafdedcafce6bef9e2baf6deb8f8e1bafbe5befbe3bff9e0bdf7dcb9f4dab7f2d7b5f5d9b6fbe0bafde3bbfbdfb8f6d9b3eacdacdcc3a7d5bea4d2bda5cdbaa5cbb9a5c8b6a4c6b5a4c4b3a2c2b2a2c2b1a0c1b1a1beae9fbaad9fb5aa9eb1a79caca39aa8a19aa49f99a29e989e9c989c9a979998969697979295968d91938a8f918a8f92868c90838a9080898f7e868e7a848d78828b758189727f88717e88707d896c7b87697a876879876678866677866376866075856073835e72835d72835c71825a71825a7182586f81556d7e546b7f536b7f536b7f526b7e536b7e526a7f536a7e52697e51687e4d677c4d667b4b657a4b657a4b647b4b647b4b647b4a647a4a637a4a63794a637a49627a4862784862794a637a4b647a4b647a4d667b4f677d51687e536a80546a8052697e51677d4f667c50687d4e677d4d647b4c637a4b627a4d657c4d667d4c647b4d657c4a637a4c647bfee9c6fde7c4fde6c2fde5c0fce4befce4c0fde3befce4c0fce2befae0bdf9e0bdf7debbf5dbb9f3d9b8f4d9b7f2d8b6f9e1bdfeeac3fee8c1fbe1baf3d7b4e7ccaddbc2a7d6bfa6d3bca5cfbaa5ccb9a4c8b6a3c5b4a3c2b2a2bfb0a2baada0b7ab9fb7ab9eb5aa9eb2a79cada59ca9a39ba49e97a09c979c9a969b98959896949394949292938e91928b9093888f92858b9181898e7e878c7b848c79848c78828b747f89717e896f7d876c7b876d7b876978856676846374836273826173836072825e70815b6f80596e7f596e81586e7f576c7f546b7e536a7d52697c50687c4f687c4e677b4d667a4d65794c65794d657a4d657a4d657a4d657a4b6479496278476176486076476177465f75466077476077466077445e75455f75445f75445f75455f75455e75445f75465f75465f764760774860774960764a61774b62794b63794c647a4d647b4a637a4a62794a6178485f76475f764960774860774a6178496178496279496178fde3befbe2befae0bcfae0bbfadfbbfae0bdfae1bdf9dfbbf7ddbaf5dcb9f4dbb9f3dab8f3d9b6f7ddb9fdebc8fef1cffeecc7f9e0baecd2b2e3c9acddc4a9d8c1a8d5bfa7d3bda7d0bca6cdbaa6cab7a4c5b4a2c0b1a1bdafa1baada0b5a99eb3a79db0a69daca49ca8a29ba5a09aa09d989b98959a98969696959494949192948b8f91898d90868c8f858b9081888e7f868d7b848b778189747f89727e896f7c876c7a856977846777846676846474836172805e707f5d707f5b6e7e5a6d7e586d7d586c7d566b7c53697b51687b51677a4f66794e66784d657a4b63774a63774b6277486277486176476176486076476076476076486075476075465f74455d74435d73435d73435d73425c72415c72425c73405a71415a723f5b723f5a71415a72405b72405b72415a71415a71415b71425b71435b71435a70435b72445c73455d74465d74485f77486077475e76455e76465e76445d74435c73435b72445c73455d74465e75475e75f8debcf8dfbcf8dfbcf9debbfae1bdfae1bdf8debbf6dbb8f5dab7f5dab6f7debbfce7c4fef1d0fef0cffdebc8f8debaeed3b1ead0b0e2c9adddc5aadac3abd4bfa8d2bea7d0bca6cdbaa6c9b8a6c6b6a3c2b2a3beafa0b9ada0b4a99fafa69cada49baca39aa39e9aa09d9a9c9a969897959594949393949193948e9093898d91858a8e83898e80868c7d858c79838b768089747f88707c876f7c876b79856877856775836473816172815f71805d707f5b6d7e5a6c7d586b7a556a7a53697b5468795267785166794e65784c63774b63764a6276496176496175476075465f74455e73445e72445d73425c71425c72425c71435d72435c72435c72425c71405b71405b70405a703f596f3d576e3f586f3d586f3d586f3d586f3c576d3c556b3d576f3d576e3d576e3c566d3e576e3d576d3d566c3d566e3f576e3f596f41586f40596f415a71415970415970415971415a72425a7240597040586f41597142586f415971425a71425b73fadfbdf7debcfae0bdfbe2befbe2bef9dfbcf6dcbaf6dcbbfbe8c7fef5d9fef4d5fef1cefce6c1f7dbb8f1d7b7edd2b3e5ccaee0c8addcc6acd8c2aad5c0aad2bea9cebca8cbb9a6c7b6a5c4b5a4c1b2a2bcafa2baada0b5aa9fafa69eaaa39ca8a19aa49e999d9a979a99969695949292929091928d90918b8e90888b8f84888e80868b7d848a798188747d85727d87707c866d79856a78856776826675826473806372815f707d5c6d7c5c6d7d5a6c7b576a795568795166765165785165774f63754d63754c6174496074486074485f73465e72445d72455d71445e72435c71425a6f435b70405a703f596e3f586f40596e40586e3f596e40596e3f596f3d586f3f586e3c566c3c556c3b556b3a556b3b566d3c556b3a546b3a546b3852683952693b546a3c546b3b54693a536a3b546b3a52693c53683c54693e576c40586f3f576d3f576e3f566c3d556c3d546b3f566d3d566d3e576f3d566c3e566e3e556b3e566d3e566d3e566d;
   16'h0201:packed_init=18432'hdbc0a4d1b59ac1aa93c1ab97c2ac96baa999b6a697b9a797c7b09bc7af99bfaa97bba998b0a194aaa096a199939894909594929191928f90928d91948d90958a90958b8f948e949892969a9d9b9aa0999384888e838a90828b93838c947f899375828e75818d7a848d79828c717d8a6a78876878886475856275855e71826073865d70835b6f825c70855c71855e72855d728663778c667b8f63768a63788b63778a657a8d6a7e916e82956b7e90717e8b6e7e8d6e7e8d6a7b8c6375875b7083556a7e4b60744b6379435a6f3d53663b51653c52673c53693c5166485f763f53663e5264475e74485e73495e734e657a5c70836a6d6a3648563a4e5f5c5f5e5b60615c61635c60625e64685b6064595d6061676e636b715f636661666a61666a6264666a6d6f6d6d6d7b7a79817a73a79581baa389b19f8da49587968d838b868085837f82818081818181818182807f8b8682a99988dfc2a2dfc1a2ddc1a3d9bd9fd9bda0e7cfadfce3bcfadfb8fde5bdfce1bbf6d9b3c9af96bfab98d3b79bcab198c0a993af9e8ea7998da4988ea0958d9b9590918f8d8e8e90898b8e86898e868a8f858a90848a91898f95b9ada1cbb9a8c5b5a7a7a29faea9a4b3a8a08b8b8d7a848f7985907784917483907483917786957a8a987e8a956c7a866574836374846275885c70815d71845a6e81576b7d566b7d586d81566b7f586f84596d825d72855f748962778c6074865a6e815a6e825c70835f738762778c64788a61707e5b6a7852657654687b5d7183647484506578496076475d723c51653b506441566b3f54673c506141576c435a6f465b7043586c455b6f485f744b617553657585888c61727f595b5a595c5d5c5f6160666b61666a5c5e5f616465696f75676a6d696c6d6d71726a696673706c7c77708b8075aa957fccb294bda892ae9c89a2948592897f8c87818985818a87838c8984928e88968d85a79889dabd9cddbe9dd9bc9cd0b599ccb195dfc7a7fdebc5fee7c0fce2b9faddb5f8dbb3f3d6b1f1d4b0f4d6b1f4d6b1f2d5b1f0d4b3c2af9baf9f8fab9c8e9c928999928d908e8c8a8a8c86888c83888c83888d8b8d90baaea2c5b5a5cab6a4cdb8a4c7b6a5beb0a4b3aba2b1aaa3b6ada5bab0a899999977848f76838f72818f9e9e9db2aba6a7a5a59ea0a1a4a4a5a4a4a5808a936476866376866578876c7e8f5e7285596c7e596d80556b7f546a7e556b7f5a7084687b8d728595788b9c8191a17e8a97717c8864738360708264768860768c5e73886475846771784f6275506477576c815b6f825868774d607144576a485d7144596c485e71485d70435668495e714a61754d6377606e7d68778252687e4f647a536b815e61615f616264686a67696c6666666767667071726f706f797a7d7a7671847a709284769c8a76c9b090d1b597c2a990b49f8baa9a8b9f9285978c828c837a8f888098928b9f958bafa091c0ae97f1e2c3feecc6fdeac3fee8c2fbe3bef2d7b4f5dab6f3d6b2f4d6b1f4d6b0f0d4b0f5d9b4f6d9b3fae1bcfbe1bbfce3bcfbdfb8f2d5b2ebcfafe7ccaee4cbafe2c9afc5b19b9d948e8b8c8d84878b80858b84898fb1a79ec7b5a3bfb1a3b7ada2bcafa2b2aaa1a9a59fa9a5a1a9a49fa5a29fa1a1a19d9e9f9b9e9f9a9ea19a9ea09c9ea0969b9e8f969d8f979e8f989e8b969f89959e88939d909aa1939ca39ba2a69aa2a7909ba57d8c9a868e975a6f8363788b8193a28b9aa68997a48897a38a98a48d9aa58c9aa58f9da98b98a376818b6c7886556b81586f855c758c657c9272879b818c9664707c51637452657654687a5e6d7d5d6b796f7279757373666f787576786c727b5464744d647a4d63794c61754e63794d60735466776264616667676e6f6f6c6b677573727a7a7a7975718079718c7d6d958471b59e85e8cca7d4b797c9ac90bca68fab9886a09181978a7b988b7f998e849c8f83ac9d8dcfbaa1f5e5c5fef1cffef0ccfeebc7fbe4bef2d9b6f3dbb9f9e2befce8c3fde9c4fbe6c2feeac5fbe4bff8deb9ecd0afe5caabe2c6a8e1c5a6e1c6a7dfc5a9e0c6a9dcc3a9d5bfa8d1bda7cebba8cbb9a7c2b2a3bcb0a3beb1a49e9c99b7ada2b3aaa0afa69eaaa49da8a49ea5a29da4a29da2a19da1a09e9e9f9f9b9ea09ea0a09ea0a09d9fa0999ea0979da0969c9f999da1939a9f90979d939a9f8f979e8d969e8a959d85919b818f997a8a977587967e8e9b80909d7c8e9b7387976e83956d82946c81936c81926c80926a7e8f6b81946d82946f849772889a72879973889b7085986c83986e849871869a73889b788b9d7c8e9f8090a085929e91979cb3a597a69d94848c927386967286967d8c9989959f908e8e717476616e7a6b7c8d73849674899d687e916b6963706c6877746f817d7a7f7870887e748f82749e8872d8bb91e6c69fd8b999ceb194c6aa8eb7a18da4917f9d8c7b9a8c7e9f9287a29589ae9c8ae0d0b3feefcffeecc9fde8c5fbe3bff8e0bdf8debbf8dfbcf9e2bef7dfbcf6dcb9f4d9b6f1d5b3ebd0afe7cbabe7cbaae6caabe4c8aadec4a8dac1a6d4bea5cdb9a2ccb8a3cebaa4cdb9a5c7b5a3c2b2a2bdafa1b9ada0b5aba0b2a99fb0a89faba59ea8a39da6a19ba2a09b9f9e9b9c9b9a989a999697989397988f94968e93978b929889929888919887909788929988939a87929a86919888929988929b869098828f987e8c967d8b977384926d818f6c7f8e6a7e8e6a7d8e687d8e687c8d677c8d657a8c61778a60778a62778c61798d5f778c5c74885c75895c73895a72885972875b74895b73895c73885b73875b72885b72875c72875c748a5e75895f75895f748961768a63788c677d91697f946b80946b7f936c81956c80937185977488996f839670849777899a7d8d9f827a71847c7291887f9a8d809a8773ac9378d5b88febcba1d7b590cfaf8dcbae90c1a78db9a390ac9783a28f7aa1907fa9998ac2ac93f7e4c2fde4c0fae1bef8debaf6dbb8f3d9b7f1d6b5f2d7b4f4d9b5f2d6b4e8cdafe1c7abe1c7abddc5aadcc4a9dbc2a8dbc3a7dbc1a7d9c0a6d5bea5d1bba4cbb7a2c7b5a2c3b2a2bfb1a2bcae9eb9aca0b4a99fb1a89eada59ea9a39ca6a19ca29f9aa09e9a9d9c999a9a989999989698989295978c91948a9195889094858c92818a917f8a917d89927b88917a869178869076858f75849076859074849176869275869375859273849170818f6a7d8c677b8c657b8b;
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
