kehanzuishuai/fpga/src/display/visual_renderer.sv

`default_nettype none
// Native 1920x1080 coordinates. No logical-pixel upscaling.
// X/Y is square, DC-removed and normalized jointly. No changes to audio path.
(* syn_srlstyle="registers" *)
module visual_renderer #(parameter LOGN=11,SAMPLE_RATE=48000)(
 input wire clk,rst_n,input wire [11:0] x,y,input wire de,hs,vs,blank_start,
 input wire wave_pending,spec_pending,input wire [48:0] wave_data,input wire [36:0] spec_data,
 output wire [8:0] wave_addr,output wire [LOGN-2:0] spec_addr,
 output wire wave_release,output reg spec_release,
 output wire [7:0] red,green,blue,output reg out_de,out_hs,out_vs,input wire status_live,input wire [511:0] status_data
);
 // Keep the intended renderer/encoder boundary during whole-project mapping.
 (* syn_preserve=1,syn_keep=1 *) reg [7:0] rgb_red,rgb_green,rgb_blue;
 assign red=rgb_red;assign green=rgb_green;assign blue=rgb_blue;
 reg signed [15:0] wave[0:1023];reg [7:0] spectrum[0:511];
 reg wave_front,wave_back,wave_ready,wave_initialized;
 reg [2:0] state;
 localparam WAIT_BLANK=0,SPEC_COPY=4,SPEC_SCAN=5;
 reg [15:0] counter;reg primed,initialized;reg [7:0] pool_peak;
 reg [36:0] peak_power;reg [LOGN-2:0] peak_bin;reg [15:0] peak_hz;reg peak_valid;
 reg [1:0] spectrum_range,shrink_candidate;
 reg [1:0] shrink_count;
 reg [LOGN-2:0] highest_bin;
 wire [15:0] prev_count=counter-1'b1;
 wire new_peak=prev_count!=0 && spec_data>peak_power;
 // SCAN preparation clock uses the final registered peak bin.
 wire [15:0] candidate_hz=16'((64'(peak_bin)*64'(SAMPLE_RATE)+(64'd1<<(LOGN-1)))>>LOGN);
 // Second pass over the same frozen FFT: retain components within ~36dB of
 // the strongest non-DC bin. Two-bin margin, four Nyquist-quarter ranges.
 reg [24:0] significant_floor;
 // Peak stops changing before SCAN's first primed bin: one preparation clock
 // preserves the final COPY bin while removing a compare from the scan path.
 always @(posedge clk)significant_floor<=peak_power[36:12]!=0?peak_power[36:12]:25'd1;
 wire significant=prev_count!=0 && ((|spec_data[36:25]) || spec_data[24:0]>=significant_floor);
 // Factor the two-bit range selection outside the late significance mux.
 function automatic [1:0] range_for_bin(input [LOGN-2:0] bin);
 begin range_for_bin=bin<=((1<<(LOGN-3))-2)?2'd0:
  bin<=((1<<(LOGN-2))-2)?2'd1:bin<=(3*(1<<(LOGN-3))-2)?2'd2:2'd3;
 end endfunction
 wire [1:0] desired_range=significant?range_for_bin(prev_count[LOGN-2:0]):range_for_bin(highest_bin);
 function [7:0] power_height(input [36:0] p);
  integer k;begin
   // Mutually exclusive highest-one terms, combined as an OR tree. Constants
   // encode3*log2 directly, avoiding a37-way priority chain followed by*3.
   power_height=0;
   for(k=1;k<37;k=k+1)
    if(p[k] && (p>>(k+1))==0)power_height=power_height | 8'(k*3);
  end
 endfunction
 reg [7:0] spec_height;reg [15:0] pool_count;reg pool_valid;
 always @(posedge clk)begin spec_height<=power_height(spec_data);pool_count<=prev_count;end
 always @(posedge clk or negedge rst_n)
 if(!rst_n)pool_valid<=0;else pool_valid<=state==SPEC_COPY && primed;
 assign spec_addr=counter[LOGN-2:0];
 wire [8:0] bar_index=9'(pool_count>>(LOGN-10));
 localparam [15:0] POOL_MASK=16'((1<<(LOGN-10))-1);
 wire pool_first=(pool_count & POOL_MASK)==0;
 wire pool_last=(pool_count & POOL_MASK)==POOL_MASK;
 wire [7:0] pool_value=(pool_first || spec_height>pool_peak)?spec_height:pool_peak;
 reg xy_start;wire xy_busy,xy_copy,xy_ready;wire [8:0] xy_copy_index;
 wire phase_pixel,xy_signal,xy_direct,xy_mixed;wire signed [5:0] xy_shift;
 wire [7:0] phase_x=8'(x-1572),phase_y=8'(y-198);
 wire [15:0] phase_read={phase_y,phase_x};
 visual_xy_plot #(.COORD_BITS(8),.SPAN(256)) xy_plot(.clk(clk),.rst_n(rst_n),.start(xy_start),.publish(blank_start),
  .sample_addr(wave_addr),.sample_data(wave_data),.sample_release(wave_release),.busy(xy_busy),
  .ready(xy_ready),.copy_valid(xy_copy),.copy_index(xy_copy_index),.pixel_addr(phase_read),.pixel(phase_pixel),
  .signal_valid(xy_signal),.direct_mode(xy_direct),.mixed_mode(xy_mixed),.scale_shift(xy_shift));
 reg signed [15:0] wave_sample,wave_previous,wave_sample_q,wave_next_q;
 reg [9:0] wave_fraction_q;
 reg [7:0] spectrum_sample,spectrum_sample_q;
 reg [11:0] stage_x,stage_y;reg stage_de,stage_hs,stage_vs;
 wire [23:0] sharp_rgb,frost_rgb;
 visual_background scenery(clk,x,y,sharp_rgb,frost_rgb);
 reg [11:0] draw_x,draw_y;reg draw_de,draw_hs,draw_vs;
 wire [11:0] local_wave_x=x>=80?x-12'd80:12'd0;
 // Exact index/remainder for all 4096 local X values. The four zero
 // fraction bits are reconstructed after the ROM, avoiding a wide divider.
 (* syn_romstyle="block_rom" *) reg [14:0] wave_position_rom[0:4095];
 reg [14:0] wave_position_q;
 initial $readmemh("assets/display_wave_position.hex",wave_position_rom);
 always @(posedge clk)wave_position_q<=wave_position_rom[local_wave_x];
 wire [8:0] wave_index=wave_position_q[14:6];
 wire [8:0] next_index=wave_index==511?9'd511:wave_index+9'd1;
 wire [11:0] spectrum_local_x=x>=80?x-12'd80:12'd0;
 reg [15:0] spectrum_numerator;reg [32:0] spectrum_reciprocal;
 always @(posedge clk)begin
  spectrum_numerator<=16'(spectrum_local_x)*(16'(spectrum_range)+16'd1)*16'd4;
  spectrum_reciprocal<=33'(spectrum_numerator)*33'd76261;
 end
 wire [8:0] spectrum_index=9'(spectrum_reciprocal>>22);
 always @(posedge clk)begin
  wave_sample_q<=wave[{wave_front,wave_index}];
  wave_next_q<=wave[{wave_front,next_index}];
  wave_fraction_q<={wave_position_q[5:0],4'd0};
  spectrum_sample_q<=spectrum[spectrum_index];
  wave_previous<=wave_sample;spectrum_sample<=spectrum_sample_q;
  if(xy_copy)wave[{wave_back,xy_copy_index}]<=wave_data[48:33];
  if(pool_valid && pool_last)spectrum[bar_index]<=pool_value;
 end
 // Five additional clocks relative to the original waveform result:
 // index ROM + products + sum + magnitude + reciprocal + restored sign.
 reg signed [26:0] wave_product_a,wave_product_b,wave_sum;
 wire [26:0] wave_absolute_bits;wire [15:0] wave_restored_bits;
 visual_conditional_negate #(.WIDTH(27),.GROUP_BITS(6)) magnitude_prefix(wave_sum,wave_sum[26],wave_absolute_bits);
 visual_conditional_negate #(.WIDTH(16),.GROUP_BITS(4)) restore_prefix(wave_reciprocal[41:26],wave_reciprocal_negative,wave_restored_bits);
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
