kehanzuishuai/fpga/src/display/visual_scene.sv

`default_nettype none
// Native scene composition over sharp and genuinely prefiltered scenery ROMs.
module visual_scene #(parameter MATERIAL_SAMPLE=0,parameter BACKGROUND_LATENCY=0)(input wire [11:0] x,y,input wire status_live,input wire [511:0] status_data,output wire [23:0] rgb,
 input wire signed [9:0] drift_x,drift_y,input wire [95:0] key_trails,
 input wire [23:0] sharp_rgb,frost_rgb,input wire clk) /* synthesis syn_srlstyle="distributed_ram" */;

 function automatic signed [13:0] ab(input signed [13:0] v);begin ab=v<0?-v:v;end endfunction
 function automatic integer clamp(input integer v,lo,hi);begin clamp=v<lo?lo:v>hi?hi:v;end endfunction
 function automatic [6:0] circle_limit(input [5:0] radius,dx);
  begin case({radius,dx})
   12'd0:circle_limit=7'd64;
   12'd64:circle_limit=7'd65;
   12'd65:circle_limit=7'd64;
   12'd128:circle_limit=7'd66;
   12'd129:circle_limit=7'd65;
   12'd130:circle_limit=7'd64;
   12'd192:circle_limit=7'd67;
   12'd193:circle_limit=7'd66;
   12'd194:circle_limit=7'd66;
   12'd195:circle_limit=7'd64;
   12'd256:circle_limit=7'd68;
   12'd257:circle_limit=7'd67;
   12'd258:circle_limit=7'd67;
   12'd259:circle_limit=7'd66;
   12'd260:circle_limit=7'd64;
   12'd320:circle_limit=7'd69;
   12'd321:circle_limit=7'd68;
   12'd322:circle_limit=7'd68;
   12'd323:circle_limit=7'd68;
   12'd324:circle_limit=7'd67;
   12'd325:circle_limit=7'd64;
   12'd384:circle_limit=7'd70;
   12'd385:circle_limit=7'd69;
   12'd386:circle_limit=7'd69;
   12'd387:circle_limit=7'd69;
   12'd388:circle_limit=7'd68;
   12'd389:circle_limit=7'd67;
   12'd390:circle_limit=7'd64;
   12'd448:circle_limit=7'd71;
   12'd449:circle_limit=7'd70;
   12'd450:circle_limit=7'd70;
   12'd451:circle_limit=7'd70;
   12'd452:circle_limit=7'd69;
   12'd453:circle_limit=7'd68;
   12'd454:circle_limit=7'd67;
   12'd455:circle_limit=7'd64;
   12'd512:circle_limit=7'd72;
   12'd513:circle_limit=7'd71;
   12'd514:circle_limit=7'd71;
   12'd515:circle_limit=7'd71;
   12'd516:circle_limit=7'd70;
   12'd517:circle_limit=7'd70;
   12'd518:circle_limit=7'd69;
   12'd519:circle_limit=7'd67;
   12'd520:circle_limit=7'd64;
   12'd576:circle_limit=7'd73;
   12'd577:circle_limit=7'd72;
   12'd578:circle_limit=7'd72;
   12'd579:circle_limit=7'd72;
   12'd580:circle_limit=7'd72;
   12'd581:circle_limit=7'd71;
   12'd582:circle_limit=7'd70;
   12'd583:circle_limit=7'd69;
   12'd584:circle_limit=7'd68;
   12'd585:circle_limit=7'd64;
   12'd640:circle_limit=7'd74;
   12'd641:circle_limit=7'd73;
   12'd642:circle_limit=7'd73;
   12'd643:circle_limit=7'd73;
   12'd644:circle_limit=7'd73;
   12'd645:circle_limit=7'd72;
   12'd646:circle_limit=7'd72;
   12'd647:circle_limit=7'd71;
   12'd648:circle_limit=7'd70;
   12'd649:circle_limit=7'd68;
   12'd650:circle_limit=7'd64;
   12'd704:circle_limit=7'd75;
   12'd705:circle_limit=7'd74;
   12'd706:circle_limit=7'd74;
   12'd707:circle_limit=7'd74;
   12'd708:circle_limit=7'd74;
   12'd709:circle_limit=7'd73;
   12'd710:circle_limit=7'd73;
   12'd711:circle_limit=7'd72;
   12'd712:circle_limit=7'd71;
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
