kehanzuishuai/fpga/(commit log)

2026-09-16 Add board-independent FPGA synth RTL and verification
2026-09-16 Complete board-independent synth core validation
2026-10-08 Refresh project documentation for latest board audio and visualization
2026-10-09 Add verified audio visualization and dual ADC regression coverage
2026-10-09 Add verified Hall key calibration filtering and velocity detection
2026-10-21 Integrate validated 32-key piano, ESP32 WAV transport and project documentation
2026-10-24 Publish V13 piano FPGA and ESP32 BLE firmware
2026-11-02 Publish validated ESP32 glide and vibrato firmware for 2026-11-02
2026-11-03 Publish complete V21 FPGA, ESP32 and theremin project
    Update root FPGA sources to the timing-validated V21 build, include the November 3 ESP32 playback fix and the complete UNO theremin firmware, add current build and wiring documentation, archive V13 artifacts, and publish matched binaries with source hashes and regression evidence.
2026-11-03 Streamline repository and redesign the public project overview
    Remove historical builds, parallel projects, generated simulation output and obsolete internal scripts. Preserve the current FPGA, ESP32 and UNO sources, initialization data, firmware and focused regressions; remove only disabled Gowin project entries. Add a concise public README, system overview, development guidance and retained third-party notices.
